2AMLogic/gf180-trng/sim/README.md

# `sim/` — evidence records

Everything in `sim/` exists to answer one question about any number this
project ever claims: **who produced it, under what conditions, and can I
reproduce it?**

A simulation result that is not recorded here in this format is not
evidence, and must not be cited in `spec/`, in an issue, or in a summary
document.

This is a **metadata and file-layout convention, not a tool contract**. It
does not assume any particular harness or runner. If the sim harness later
adopts a conflicting convention, reconcile the two with a decision record
(see [`spec/decision-records/TEMPLATE.md`](../spec/decision-records/TEMPLATE.md))
rather than silently editing records or this document's rules.

---

## Characterization reports

One line per `sim/characterization-*.md` report: what it answers and where it
stands. These are ordinary summaries that cite evidence records; none is
evidence itself. Start with the analog summary, which is organized by the rows
of the ratified target specification. `python3 sim/tools/corpus_counts.py
--check` (part of `npm run check:spec`) fails if a report on disk is missing
from this list or a listed file does not exist.

- [`characterization-analog-summary.md`](characterization-analog-summary.md) -- Every analog-partition row of the ratified target specification, one result per row with its claim limit. Status: aggregation for #313; an ordinary summary that runs no new simulation.
- [`characterization-array-fs-sf-capture.md`](characterization-array-fs-sf-capture.md) -- Asymmetric fs/sf corners on the integrated ring-array, XOR and sampler path at the 1 Mbps clock: ring duty, XOR pulses, reset, `raw_valid` and capture, distinct from the isolated-sampler setup/hold coverage. Status: campaign defined and unit-tested; batch submits refused or rejected (retried in -04, refused again), two-unit local pilot only (2 of 18 PVT points, one phase); no coverage-complete verdict (#472).
- [`characterization-array-ring-coupling.md`](characterization-array-ring-coupling.md) -- Why one ring shows ~40x more jitter inside the array deck: ring-to-ring coupling through the XOR combiner input stage. Status: complete (#51).
- [`characterization-array-supply-ripple.md`](characterization-array-supply-ripple.md) -- Susceptibility of the buffered RO array to deterministic supply ripple. Status: campaign defined and unit-tested; simulations not yet run, so no sensitivity numbers (#414).
- [`characterization-digital-supply-ir-drop.md`](characterization-digital-supply-ir-drop.md) -- DC voltage loss from the chip pins through the digital docking path and power grid, `vddd` and `vss`. Status: complete (#464); verdict: not material at the ratified 1 MHz rate, material at the 20 MHz implementation clock (informational).
- [`characterization-digital-sta-area-power.md`](characterization-digital-sta-area-power.md) -- Digital section Fmax, area and power across the corner set (Area and Power rows, digital share). Status: complete (#145), with later amendments in-document.
- [`characterization-digital-activity-power.md`](characterization-digital-activity-power.md) -- Digital power from post-route per-net switching activity, five declared workloads against the uniform-activity baseline (Power row, digital share). Status: complete (#453); characterization only, the rollup baseline is unchanged.
- [`characterization-liveness-sampler-active-power.md`](characterization-liveness-sampler-active-power.md) -- The shipped per-ring liveness samplers (`xsr1`/`xsr2`) in the whole-block active-power ledger: instance inventory, new rate- and topology-matched measurement, like-for-like effect on the total. Status: ledger and tooling complete and unit-tested; 1 of 27 PVT points measured (local probe), the batch submit failed on a runner/client version mismatch, remaining corners are explicit gaps (#463).
- [`characterization-liveness-tap-phase-cost.md`](characterization-liveness-tap-phase-cost.md) -- Phase cost the liveness digitizer imposes on its ring. Status: complete (#76).
- [`characterization-post-layout-extracted.md`](characterization-post-layout-extracted.md) -- Entropy-source verification suite re-run on extracted post-layout netlists, device-level through full-chip inter-region. Status: complete (#17, extended by #217 and #232).
- [`characterization-raw-min-entropy-and-battery.md`](characterization-raw-min-entropy-and-battery.md) -- Raw min-entropy estimation and statistical test battery (Raw min-entropy row). Status: analysis complete (#12); reports no design min-entropy figure.
- [`characterization-ring-buffer-mitigation.md`](characterization-ring-buffer-mitigation.md) -- Whether buffering each ring output removes the combiner coupling, and its power cost. Status: complete (#75).
- [`characterization-ro-delay-cell-jitter.md`](characterization-ro-delay-cell-jitter.md) -- Ring-oscillator delay-cell jitter, thermal and flicker noise (entropy-source architecture grounding). Status: complete (#4); carries amendments in-document.
- [`characterization-sampler-bit-bias.md`](characterization-sampler-bit-bias.md) -- Whether the clock-locked liveness modulation reaches the sampled bit. Status: complete (#86).
- [`characterization-shipped-array-tap-phase.md`](characterization-shipped-array-tap-phase.md) -- Clock-locked digitizer disturbance in the array as shipped. Status: complete (#87).
- [`characterization-startup-and-power-budget.md`](characterization-startup-and-power-budget.md) -- Time-to-first-valid and whole-block Power rows. Status: complete (#14); depth-2 figures supersede depth-8 ones in-document.
- [`characterization-starved-cell-jitter-energy.md`](characterization-starved-cell-jitter-energy.md) -- Jitter-energy law on the shipped starved delay cell. Status: complete (#46); hot-corner (ss/+125 C/3.63 V) addendum (#628).
- [`characterization-supply-current-and-leakage.md`](characterization-supply-current-and-leakage.md) -- Per-ring active supply current and stopped-ring leakage (Power row inputs). Status: complete (#32).
- [`characterization-vss-trunk-ir-drop.md`](characterization-vss-trunk-ir-drop.md) -- IR drop on the shared vss return trunk, per region. Status: complete (#234); verdict: not material.
- [`characterization-worst-corner-and-mc-mismatch.md`](characterization-worst-corner-and-mc-mismatch.md) -- Entropy-binding PVT corner over the full 27-point grid, and Monte Carlo mismatch bias. Status: complete (#13).

### Plans and feasibility assessments (not measured reports)

These are forward-looking documents. They run no simulation, are not evidence
records, and are not part of the report index above.

- [`../docs/out-of-envelope-characterization-plan.md`](../docs/out-of-envelope-characterization-plan.md) -- Model-bound audit and execution plan for health-test behaviour just outside the operating envelope. Status: plan (#467); no supported simulation grid and over the CPU budget as of its writing, so the envelope row's out-of-envelope clause remains unverified.
- [`../docs/higher-rate-source-options-study.md`](../docs/higher-rate-source-options-study.md) -- Design study: what a raw rate of 100 kbps, 1 Mbps or 4 Mbps would cost on gf180, as more XOR-combined starved-cell rings (DR-0007 sizing law at the starved-cell `a`) or as the metastability-hybrid tap, priced from existing records by `sim/tools/higher_rate_options.py`. Status: study (#629); runs no simulation, proposes no row change, makes no entropy claim.

---

## The two rules

1. **Append-only.** A record is written once. Re-running a testbench —
   for any reason, including fixing a mistake — produces a **new** record.
   Records are never edited to change results and never deleted.
2. **No seed, no evidence.** Any stochastic analysis (ngspice transient
   noise, Monte Carlo) must record every seed it used. A transient-noise
   record without its seed(s) is unreproducible and therefore is not
   evidence, regardless of how good the numbers look.

`run_corners.py` checks the whole execution plan before it reserves a
record, creates a scratch directory or launches ngspice, and refuses
(exit 3, naming the repeated value) a plan that repeats a seed, repeats a
PVT point (e.g. `--temps 27 27`), or contains two distinct points whose
output id `<corner>_<temp>c_<supply>v` collides (supply is formatted to
10 mV, so e.g. 3.301 V and 3.304 V alias). A repeated seed would count one
realization twice in a record's mean and spread; a repeated id would put
two points' decks and logs in the same place. Run a repeated diagnostic as
a separate invocation instead.

For a stochastic testbench the harness alone sets the seed. It writes one
`.option seed=<n>` per run from `--seeds`. Before planning, the harness
refuses any input that sets its own seed: a seed entry in the manifest
`options`, an option line containing `seed=` in the fragment, the DUT or a
captured include, or `setseed`, `option seed=`, `set rndseed` or
`unset rndseed` in `analyses`. The error names the source and line. The forms
covered and the reasons are in
[`tool-experiments/2026-10-11-ngspice-seed-control/`](tool-experiments/2026-10-11-ngspice-seed-control/README.md).
In ngspice-46 a later competing option line is ignored, and a control-block
`setseed` overrides the seed. That experiment also found that `trnoise`
waveforms do not repeat under the same seed (#574).

### What a transient-noise seed reproduces (#574, DR-0031)

On the ngspice-46 build measured in
[`tool-experiments/2026-10-11-ngspice-trnoise-seed-replay/`](tool-experiments/2026-10-11-ngspice-trnoise-seed-replay/README.md),
the seed does **not** reproduce `trnoise` waveforms. Two processes with the
same seed shared none of 16 noise samples under the harness start-up policy.
The same held with `setseed` or `set rndseed` in an explicitly supplied
`spinit`, with `setseed` in a user `.spiceinit` (the manual's suggestion)
and with a control-block `setseed`. The noise followed the simulator's
process id instead. The same seed did reproduce the `agauss` parameter and
control-language draws. Other ngspice builds have not been measured.
[DR-0031](../spec/decision-records/DR-0031-transient-noise-reproducibility.md)
sets the contract that follows:

- **Seeds are still required** and still owned by the harness; rule 2 and
  the checks above are unchanged. For a transient-noise run the seeds fix
  the non-`trnoise` random draws and identify the runs.
- **Replay means deck and configuration, not waveform.** Re-running a
  `tran-noise` record's commands at its `repo_commit` with its snapshots
  rebuilds the same decks, PVT point and start-up configuration, but draws
  fresh `trnoise` noise. Its numbers are a new sample and will differ from
  the record's. New `tran-noise` records carry a `reproduction` block and
  say this in "How to reproduce". Deterministic and `mc` records do not:
  no limit was measured for them.
- **Distinct seeds do not make the noise distinct.** Runs get different
  noise because each is a separate ngspice process. Neither the seeds nor
  the experiment establish that runs are statistically independent.
- **Statistical repeatability is a separate claim.** Saying a re-run agrees
  with a record within its spread needs its own tolerance and evidence. It
  is not demonstrated here.

Records written before DR-0031 have no `reproduction` block and are not
edited. Read their "How to reproduce" sections under this contract.

Everything below is mechanics in service of those two rules.

---

## Layout

```
sim/
  README.md                     this document
  tb/                           testbench sources (mutable, reviewed like code)
    <testbench-slug>/           one directory per testbench
  records/                      APPEND-ONLY evidence records
    <YYYY-MM-DD>-<testbench-slug>-<nn>.md
    raw/
      <YYYY-MM-DD>-<testbench-slug>-<nn>/   raw output for records written
                                            before stored evidence (see below)
  tool-experiments/             APPEND-ONLY simulator-behaviour probes
    <YYYY-MM-DD>-<topic>/       decks, logs, SHA256SUMS and a README
```

- `sim/tb/` is ordinary source. Edit it, review it, refactor it.
- `sim/records/` is the evidence area and is append-only. Changes to
  anything already committed under `sim/records/` are a review-blocking
  defect, with one exception: adding a `superseded_by` field to an existing
  record (see [Superseding](#superseding-a-record)).
- `sim/tool-experiments/` holds small, PDK-free experiments on the
  simulator itself (for example how ngspice applies seed controls). The
  harness code relies on these results. They are not testbench records and
  have no PVT grid. Like records, they are append-only.

### Record naming

```
<YYYY-MM-DD>-<testbench-slug>-<nn>.md
```

- `<YYYY-MM-DD>` — UTC date the run **completed**.
- `<testbench-slug>` — matches the directory name under `sim/tb/`.
- `<nn>` — two-digit sequence, `01`-based, unique within that date +
  testbench pair. Never reuse a number, even if a record is superseded.

Example: `2026-08-14-ro-delay-cell-jitter-03.md`, with its raw ngspice
output under `sim/records/raw/2026-08-14-ro-delay-cell-jitter-03/`.

`sim/run_corners.py` claims each `<nn>` by *creating* that raw directory
(an atomic `mkdir`, so exactly one process can win it) before the first
simulation starts, and re-hashes every `raw.files` entry before it reports
success. Two invocations for the same date and testbench — two terminals,
a retried CI step, an agent that re-launches a long background run — are
therefore safe to overlap: they get disjoint numbers, and a run whose raw
output changed underneath it fails loudly instead of writing a record whose
checksums match nothing.

One record covers **one testbench at one corner** (one process/voltage/
temperature point). A PVT sweep produces one record per corner, not one
record with a table of corners. This keeps a corner citable by record ID
and keeps a re-run of a single corner from invalidating the rest.

---

## Record format

A record is a Markdown file with a YAML frontmatter block (machine-readable
metadata) followed by prose (the summary and any caveats). No tooling reads
the frontmatter today; it is structured so tooling *can* later without
re-parsing prose.

The shared parser (`sim/tools/_record_parsing.py`) reads two things from the
frontmatter and holds them to a strict contract: the lifecycle `status` and
the `corner:` fields `process`, `temperature` and `voltage`. The block must
open on the file's first line and be closed by a second `---` line; each of
those four keys must appear exactly once inside it, so a body line such as
`process: ff` can never supply or override metadata. `temperature` and
`voltage` are read as a complete scalar -- a finite decimal number, an
optional `C`/`V` unit and an optional parenthetical remark (for example
`3.300 V (nominal 3.3 V)`); a trailing suffix such as `125junk`, a
non-finite value or `n/a` is rejected. Failures raise the calling tool's
`RecordError` naming the record and the field. Result bullets
(`- `key`: value`) are a separate contract and are unchanged.

### Required frontmatter fields

| Field | Meaning |
|---|---|
| `record` | The record's own filename stem. Self-identifying. |
| `date` | UTC date/time the run completed, ISO 8601 (`2026-08-14T09:12:00Z`). |
| `status` | `valid`, or `superseded` (see [Superseding](#superseding-a-record)). |
| `level` | `transistor`, `behavioral`, `gate` or `gate-simulation` — what produced this. The first two are the two sides of the [DR-0009](../spec/decision-records/DR-0009-behavioral-vs-transistor-verification-split.md) boundary; `gate` is *static* analysis of a synthesized/placed netlist against the PDK's characterised libraries ([DR-0021](../spec/decision-records/DR-0021-gate-level-timing-and-power-records.md)) and `gate-simulation` is *dynamic* simulation of one with back-annotated delays ([DR-0022](../spec/decision-records/DR-0022-post-route-gate-level-simulation-records.md)), neither of which is either of the first two. Absent means `transistor` (records predating DR-0009); new records state it. |
| `testbench.path` | Repo-relative path to the testbench entry point. |
| `testbench.sha` | `git rev-parse HEAD:<path>` — blob SHA of the testbench at run time. |
| `netlist.path` | Repo-relative path to the DUT netlist/schematic-derived netlist. |
| `netlist.sha` | Blob SHA of the netlist at run time. |
| `repo_commit` | `git rev-parse HEAD` at run time; `-dirty` suffix if the tree was dirty. |
| `pdk` | PDK name and version/tag (e.g. `gf180mcuC @ <version>`). |
| `pdk.models` | The corner model file(s) actually included. |
| `tool.ngspice` | Full `ngspice -v` version string. |
| `tool.ngspice_startup` / `tool.ngspice_startup_flags` / `tool.ngspice_startup_spinit` / `tool.ngspice_startup_spinit_sha256` | *Additive; records from `run_corners.py` after #575.* The ngspice start-up-configuration policy in force (`no-user-init+pinned-spinit/1`), its command-line flag (`-n`), and the repo path and SHA-256 of the pinned `spinit` used as the system script. See [ngspice start-up configuration](#ngspice-start-up-configuration-575). Records without these lines predate the field and stay valid unchanged. |
| `tool.ngspice_startup_spinit_snapshot` | *Additive; records from `run_corners.py` after #582.* Name (`spinit`) of the byte-for-byte copy of the start-up script that ngspice actually read, kept in the record's raw directory and listed in `raw.files`. When present, `tool.ngspice_startup_spinit_sha256` is the digest of that copy and `sim/tools/verify_record_checksums.py` cross-checks the two. Records without it (including #575-format records, whose digest was read from the checkout) stay valid unchanged. |
| `tool.platform` | OS/arch the run executed on. |
| `corner.process` | `tt` / `ss` / `ff` / `sf` / `fs` (as named by the PDK). |
| `corner.voltage` | Supply(s) in volts, with the nominal noted. |
| `corner.temperature` | Degrees C. |
| `analysis.type` | `op` (default when a manifest omits `analysis_type`), `tran`, `tran-noise`, `noise`, `ac`, `dc`, `mc`. Any other value is rejected when the testbench manifest is loaded; `tran-noise` and `mc` are stochastic and require a seed. |
| `analysis.tstop` | Run length (simulated time), or the sweep range for `ac`/`dc`/`noise`. |
| `analysis.tstep` / `analysis.tmax` | Timestep controls that materially affect the result. |
| `analysis.noise_params` | For `tran-noise`: `NOISETSTEP` / `NOISEFMAX` / equivalent, verbatim. |
| `analysis.runs` | Number of independent runs aggregated into this record. |
| `seeds` | **Every** seed used, in run order. Required whenever the analysis is stochastic; write `seeds: n/a (deterministic analysis)` otherwise. |
| `reproduction.scope` / `reproduction.trnoise_waveform_replay` / `reproduction.basis` / `reproduction.decision` | *Additive; `tran-noise` records from `run_corners.py` after #574.* What the "How to reproduce" commands replay: `deck-and-configuration`, with `trnoise_waveform_replay: false`, the tool experiment that measured it and the decision record that adopts it. See [What a transient-noise seed reproduces](#what-a-transient-noise-seed-reproduces-574-dr-0031). Records of other analysis types, and records written before #574, have no such block and stay valid unchanged. |
| `raw.path` | Repo-relative path to the raw-output directory for this record. |
| `raw.files` | Raw output filenames with SHA-256 checksums. |
| `manifest.path` / `manifest.sha` / `manifest.snapshot` / `manifest.sha256` | *Additive; records from `run_corners.py` after #510.* The testbench manifest (`tb.json`) the decks were composed from: its repo path, git blob SHA, the snapshot file kept in the raw directory (`tb.manifest.json`), and that snapshot's SHA-256. The snapshot is also listed in `raw.files`. Records without this block predate the field and stay valid unchanged. |
| `inputs.testbench_snapshot` / `inputs.testbench_sha256` / `inputs.netlist_snapshot` / `inputs.netlist_sha256` / `inputs.netlist_dependencies` | *Additive; records from `run_corners.py` after #515.* The SPICE fragment and DUT netlist bytes ngspice actually consumed, as snapshot files in the raw directory (`tb.fragment.spice`, `dut.netlist.spice`; when there is no separate `design_netlist` both names refer to the fragment) with their SHA-256, plus any sibling files the DUT netlist `.include`s. All are listed in `raw.files`. Records without this block predate the field and stay valid unchanged. |
| `pdk_content.manifest_file` / `pdk_content.sha256` / `pdk_content.identity` / `pdk_content.file_count` / `pdk_content.complete` / `pdk_content.problems` | *Additive; records from `run_corners.py` after #562.* Content identity of the PDK model files the decks consumed: the manifest file kept in the raw directory (`pdk-models.json`, also listed in `raw.files`) and its SHA-256, the manifest's own `sha256:<hex>` identity, how many model files it covers, and whether every model reference could be followed (`problems` counts the ones that could not; the manifest lists them). See [PDK model-content identity](#pdk-model-content-identity-562). Records without this block predate the field and stay valid unchanged. |
| `wall_time` | Wall-clock cost of the run. Makes future coverage/cost trade-offs honest. |

If a required field genuinely does not apply, write the field with an
explicit `n/a` and a reason. Do not omit it — a missing field is
indistinguishable from a forgotten one.

### Required prose sections

- **Result** — the numbers, with units and the run-to-run spread when
  `analysis.runs > 1`. Numbers only; no entropy-rate or spec-compliance
  claims.
- **How to reproduce** — the exact command(s), runnable from the repo root,
  including the seed(s). Someone with the repo and ngspice must be able to
  copy-paste this. For a `tran-noise` record the commands replay the deck
  and configuration, not the `trnoise` waveforms, and the section says so
  (see [What a transient-noise seed reproduces](#what-a-transient-noise-seed-reproduces-574-dr-0031)).
- **Caveats** — what this run does *not* show (method limits, truncated
  accumulation time, known weak spots such as flicker-noise handling in
  transient noise). Stating a limit is not a weakness in the record; an
  unstated limit is a defect.

---

## Behavioral-level records

Blocks downstream of the [DR-0001] raw tap — the conditioner, the health
tests, the FIFO/register file, the estimator pipeline — contain no device
models, so a record of one has no process/voltage/temperature point and
never invokes ngspice. [DR-0009] fixes where that boundary sits and what
such a record may be used for. In this format that means:

- `level: behavioral`.
- `pdk`, `pdk.models`, `tool.ngspice`, `corner.process`, `corner.voltage`
  and `corner.temperature` are written as `n/a` **with the reason** — the
  same rule as any other inapplicable field. They are not omitted.
- The record **names its input source**: either *transistor-derived* (a raw
  bitstream captured from a transistor-level sampler run, cited by record
  stem) or *declared synthetic* (a source model, with its parameters and
  seed stated). A run driven by a synthetic source is evidence about the
  **block**, never about the source.
- **A behavioral record may not be cited for any claim that depends on
  process, voltage or temperature** — rate, power, jitter, metastability,
  timing closure, min-entropy. It can establish functional behaviour,
  bit-exactness, block structure and arithmetic, and nothing that moves
  with a corner.

Behavioral testbenches live under `sim/tb/<slug>/` like any other but have
**no `tb.json`**, so `sim/run_corners.py` cannot discover them and cannot
sweep them across a PVT grid they have no meaning on. Each carries a
`README.md` saying how it is run. See `sim/tb/conditioner-crc32/` for the
first one.

This is the one bounded exception to CLAUDE.md's "PVT corners on every
recorded result". The rule is unchanged for every claim that *has* a corner.

---

## Gate-level records

[DR-0021] adds a third `level:` value for a kind of evidence neither of the
other two describes: **static analysis of a synthesized or placed-and-routed
gate-level netlist against the PDK's own characterised standard-cell
libraries** — static timing analysis, liberty-table power, and geometry read
from a placed/routed database. No device model is instantiated and ngspice is
never invoked, but a liberty deck *is* a process/voltage/temperature point, so
unlike a behavioral record a gate record **has a corner and states it**. In
this format:

- `level: gate`.
- `corner.process`, `corner.voltage` and `corner.temperature` are filled in
  from the liberty deck's own operating conditions — never `n/a` — alongside
  two fields only this level has: `corner.liberty` (the deck, since P/V/T
  alone does not say which library or which characterisation) and
  `corner.interconnect` (the parasitic corner, which moves independently of
  the device corner for a routed block).
- `pdk.models` lists the liberty deck, both LEFs and the extraction rule deck,
  each content-hashed — the gate-level equivalent of a transistor record
  naming its model sections.
- `tool.ngspice` is `n/a` **with the reason**, and the tool that did produce
  the numbers is named with its version.
- A gate record may be cited for timing closure, Fmax, standard-cell area and
  liberty-model power at the corner it names — as a property of *that*
  implementation. It may **not** be cited as a measured supply current, for
  anything the library itself is the source of truth for, for any raw-tap
  claim (entropy, jitter, metastability), or as signoff. [DR-0021] §3 is the
  full rule; each record restates it in its own Caveats.

[DR-0005]'s one-record-per-corner rule is unchanged: a 5-liberty × 3-interconnect
sweep is fifteen records. Like behavioral testbenches, a gate-level testbench
carries **no `tb.json`** — `sim/run_corners.py` must not sweep it across the
analog P/V/T grid, because a liberty deck is a characterised bundle rather
than a free choice of the three axes. See `sim/tb/digital-sta-power/` for the
first one.

[DR-0001]: ../spec/decision-records/DR-0001-raw-and-conditioned-output-paths.md
[DR-0005]: ../spec/decision-records/DR-0005-sim-harness-record-granularity.md
[DR-0009]: ../spec/decision-records/DR-0009-behavioral-vs-transistor-verification-split.md
[DR-0021]: ../spec/decision-records/DR-0021-gate-level-timing-and-power-records.md

---

## Post-route gate-level *simulation* records

`level: gate-simulation` is the fourth `level:` value, added by [DR-0022] for
#147's post-layout re-run of the digital functional suite
(`sim/tb/trng-top-post-route/`). It is a **sibling of `level: gate`, not a
replacement**: both read a gate-level netlist against the PDK's characterised
libraries and neither instantiates a device model, so everything [DR-0021]
fixes about a gate record's frontmatter holds here too —

- `corner.process` / `corner.voltage` / `corner.temperature` from the liberty
  deck's own operating conditions, never `n/a`, plus `corner.liberty` naming
  the deck;
- `pdk.models` listing the decks and cell-model files actually read, and
  `tool.ngspice` written `n/a` **with the reason**, alongside the tools that
  did produce the numbers, each with its version;
- no `tb.json`, for the same reason: `sim/run_corners.py` must not sweep it
  across the analog P/V/T grid.

— and one thing differs, which is why the value is distinct rather than shared:

| | `level: gate` (DR-0021) | `level: gate-simulation` (DR-0022) |
|---|---|---|
| What runs | **static** analysis: STA, liberty-table power, placed geometry | **dynamic** simulation: stimulus in, cycle-by-cycle outputs out, delays back-annotated |
| May be cited for | timing closure, Fmax, cell area, liberty-model power at its corner | functional equivalence of the netlist to its RTL/model on the stimulus run |
| May **not** be cited for | measured supply current, raw-tap claims, signoff | **timing closure of any kind** — which annotation classes actually applied is simulator-dependent, so a run that reported no violation may not have been checking |

That last cell is the whole reason for a separate value. A reader filtering
`level: gate` is entitled to timing numbers; a dynamic simulation may have had
its timing checks silently dropped by the simulator and must not be mistaken
for one. So a `gate-simulation` record additionally **requires** a
`timing_annotation` block stating what the annotation models **and what it
omits** — cell versus interconnect delay, which annotation classes the
simulator applied, how many corners — with both the netlist and the annotation
file content-hashed. An omission stated is a coverage limit; an omission
unstated is a defect, the same rule `Caveats` already carries.

Adding this level **re-labels nothing**. The five `level: behavioral` records
the digital re-run compares against keep their level and their citation limits
exactly as before, and [DR-0021]'s `level: gate` records are untouched.

[DR-0022]: ../spec/decision-records/DR-0022-post-route-gate-level-simulation-records.md

---

## Extracted-netlist records

`level: extracted` is the fifth `level:` value, added by [DR-0024] for #17's
post-layout re-run of the analog verification suite
(`sim/tb/*-extracted/`). It is a **sibling of `level: transistor`, not a
replacement**: both are ordinary ngspice transient/noise/DC runs at a real
P/V/T point, driven through the same `tb.json`/`sim/run_corners.py`
machinery, so everything [DR-0009] fixes about a transistor record's
frontmatter holds here too — `pdk`, `pdk.models`, `tool.ngspice`,
`corner.process`/`voltage`/`temperature` filled in (never `n/a`), one P/V/T
point per record ([DR-0005]), seeds recorded for every stochastic run.

The one thing that differs, and the reason the value is distinct rather than
shared:

| | `level: transistor` (DR-0009) | `level: extracted` (DR-0024) |
|---|---|---|
| DUT provenance | `design/*.spice`, schematic-derived (`design/netlist.py`) | `layout/pex/*.extracted.spice` or equivalent — read from real drawn layout via `klt extract --parasitics` |
| May be cited for | rate, power, jitter, metastability, min-entropy-adjacent measurements, at its corner | the same, at its corner, **for the netlist and coverage its own Caveats state** |
| Requires | the standard frontmatter | the standard frontmatter, plus a Caveats statement of what the extraction does and does not capture (inter-cell/inter-region routing parasitics, in particular) |

A `level: extracted` record may not be cited as evidence about the fully
assembled, routed layout unless its Caveats affirmatively say routing
parasitics are included — the first generation of these records (#17) is
device-level only (leaf-cell parasitics, schematic-topology composition), not
a full-chip parasitic re-run, and says so in every record. See
`layout/pex/build.py`'s module docstring and
[`sim/characterization-post-layout-extracted.md`](characterization-post-layout-extracted.md)
for the full accounting of what this generation of records does and does not
show.

A second generation (issue #217, `sim/tb/*-extracted-routed/`) adds
*intra*-region routing parasitics — the assembled rings' own real
hand-routed inter-stage wiring, and (for `sampler_core.routed.
extracted.spice`'s own consumers) the fully assembled `combiner_sampler`
block's own real block-level wiring too — on top of the leaf-cell parasitics
the first generation already captured. It is still `level: extracted`, not a
new value: the DUT-provenance/citation rules above apply unchanged, and each
record's own Caveats state exactly which parts of its own DUT are
routing-level versus still leaf-level (`layout/pex/build.py`'s own
docstring, "Two composed drop-ins, different scope") — *inter*-region
routing is not captured by either generation (§0.1 of the characterization
doc above).

A third generation (issue #232, `sim/tb/*-extracted-fullchip/`) carries
*inter*-region (floorplan-level) parasitics, within the scope [DR-0025]
(issue #225) fixed for it: only the inter-region nets with a
transistor-level device at **both** ends are simulated (today `ro1`/`ro2`),
the four `digital`-facing taps are priced as a **driver-side-only** output
load, and the digital section stays at cell-instance granularity. Two things
follow for anyone reading or writing one of those records. **It is still
`level: extracted`** — no sixth value, and [DR-0024] is not amended, because
DR-0024's own Caveats requirement ("whether inter-cell/inter-region routing
parasitics are included") already covers the case; such a record answers it
"yes, for these nets" instead of "no". And its Caveats must additionally say
**(a)** that the digital section is at cell-instance granularity, not
transistor level, so no number in the record is evidence about a standard
cell's own devices, and **(b)** that `clk`/`rst_n` arrival is still driven
from an ideal source, so the record says nothing about clock arrival at the
sampler. Both are present on every record of this generation.

**The citation bar this generation clears, and the one it does not.** A
`*-extracted-fullchip` record may be cited as full-chip post-layout evidence
**only for the two inter-region nets [DR-0025] scopes**, plus the disclosed
driver-side load on the four `digital`-facing taps. Every other inter-region
net (`clk`, `rst_n`, `vss`, the supply and control stubs) is unpriced by it,
and no record in this repository may be cited as evidence about the chip's
*whole* inter-region parasitic picture. §8 of
[`sim/characterization-post-layout-extracted.md`](characterization-post-layout-extracted.md)
is the full accounting.

Each family of this generation also has a **zero-delta control** sibling
(`sim/tb/*-extracted-fullchip-control/`): the identical deck against
`layout/pex/sampler_core.routed.extracted.spice`, i.e. the same composition
with the inter-region delta absent. Its records exist so the
routed-vs-floorplan comparison subtracts two measurements of the same
composition instead of two different ones — a control record is ordinary
`level: extracted` evidence and says in its own Caveats that it carries no
inter-region parasitic at all.

[DR-0024]: ../spec/decision-records/DR-0024-extracted-netlist-record-level.md
[DR-0025]: ../spec/decision-records/DR-0025-full-chip-pex-scope.md

---

## Superseding a record

Mistaken, misconfigured, or invalidated runs are **not** deleted or edited.

1. Write a **new** record for the corrected run, with a
   `supersedes: <old-record-stem>` field and a one-line reason in its prose.
2. In the old record, make the **only** permitted post-hoc edit: change
   `status: valid` to `status: superseded` and add
   `superseded_by: <new-record-stem>`. Change nothing else — not the
   numbers, not the metadata, not the prose.
3. If a run was invalid and there is no corrected re-run yet, still write a
   short record documenting the run and why it is not usable, and set the
   old record's `status: superseded` only once a replacement exists. An
   invalid result that is never recorded is a result that gets re-derived by
   the next person.

The commit that supersedes a record should say so in its message, so
`git log -- sim/records/<stem>.md` tells the whole story.

---

## Scratch directories (`--no-write`)

`--no-write` runs produce no evidence record, but ngspice still needs
somewhere to put its deck and log. Each invocation creates its own
directory `sim/.work/<testbench>/run-XXXXXXXX/` (atomically, via
`tempfile.mkdtemp`) and puts one subdirectory per PVT point inside it, so
overlapping invocations of the same testbench, point and seed never share
or delete each other's files. The path is printed at the start of the run
and again in the summary.

Cleanup policy: the harness never deletes scratch output. The directory is
kept so the deck and log of a failing point can be inspected; it is
git-ignored and is not evidence. Remove a run's directory yourself when you
are done with it (`rm -rf sim/.work/<testbench>/run-XXXXXXXX`).

## ngspice start-up configuration (#575)

ngspice runs initialization scripts before the netlist, and they can change
simulator behaviour. Evidence-producing harness runs therefore launch
ngspice through one command/environment builder
(`runner.ngspice_command` and `harness/startup.py`), shared by the
watchdog and the no-`timeout(1)` fallback paths, with an explicit policy
measured in
[`tool-experiments/2026-10-11-ngspice-startup-config/`](tool-experiments/2026-10-11-ngspice-startup-config/README.md)
(ngspice-42) and
[`tool-experiments/2026-10-11-ngspice46-startup-lookup/`](tool-experiments/2026-10-11-ngspice46-startup-lookup/README.md)
(ngspice-46, the minimum this README requires; see each README for what was
and was not measured):

| Start-up input (batch mode) | Control |
|---|---|
| Deck-directory `.spiceinit` — searched first on ngspice-46; on ngspice-42 this slot was the working-directory file, and the deck's directory was not searched | `-n` |
| Working-directory `.spiceinit` — ngspice-46 falls back to it only when the deck's directory has none; `$HOME/.spiceinit` is the last fallback on both measured builds | `-n` |
| System `spinit` | `-n` does **not** suppress it; `SPICE_SCRIPTS` is set to `sim/harness/ngspice_scripts/`, whose `spinit` is checked in and content-pinned |
| `SPICE_LIB_DIR` | removed from the child environment (and overridden by `SPICE_SCRIPTS`) |

Only one of the three `.spiceinit` locations is read per launch (first match
wins) on both measured builds, and the suppression behaviour (`-n` scope,
`SPICE_SCRIPTS`, `SPICE_LIB_DIR`) is the same on both; the lookup-order
difference is the only measured change between the builds, and neither
measurement is generalized to other versions.

The pinned `spinit` contains no commands: no aliases and no code-model or
OSDI loading, so a testbench that needs an XSPICE code model or an OSDI
device would fail loudly rather than inherit whatever the host loads. Its
SHA-256 is recorded in every new evidence record (`tool.ngspice_startup_*`),
so changing it is visible. Timeout, process-group and `cwd` handling are
unchanged.

**Frozen once per invocation (#582).** The checked-in script is only the
source. `run_corners.py` reads it once, before the first simulator starts,
writes those bytes as `spinit` into every point's raw directory (scratch
directory under `--no-write`) and points `SPICE_SCRIPTS` at that directory.
All points and seeds, serial or `-j`, with or without the `timeout(1)`
watchdog, therefore read the same captured bytes, and the recorded digest is
computed from them rather than from the working tree at publication time. An
edit to `sim/harness/ngspice_scripts/spinit` while a sweep runs does not
affect that sweep. The copy appears in `raw.files`, so
`sim/tools/verify_record_checksums.py` detects a missing or altered snapshot and a
`ngspice_startup_spinit_sha256` that disagrees with it.

To reproduce a run, including one made from a dirty tree, in a scratch
worktree: check out the record's `repo_commit`, then copy the record's
`<raw.path>spinit` over `sim/harness/ngspice_scripts/spinit` before running
(a plain `diff` shows whether the checkout differed), or run ngspice with
`SPICE_SCRIPTS` set to a directory containing that file and `-n -b`.

Remaining ambient inputs, not controlled: other environment variables the
simulator reads, the ngspice build itself (recorded as `tool.ngspice`), and
behaviour on builds other than the one measured. `sim/tools/` scripts that
launch ngspice on their own (for example `run_array_liveness_tap_phase.py`)
do not go through this launcher and are outside this policy. Records minted
before #575 did not state a policy; they are unchanged and make no claim
either way.

## Hung and timed-out runs

Every corner `run_corners.py` simulates is bounded by `--timeout` (default
`runner.DEFAULT_TIMEOUT_S`, currently 300s). The bound is enforced two ways
at once, precisely because a hung ngspice once outlived the harness process
that launched it and burned a worker offline for hours undetected (issue
#83):

- An OS-level watchdog — coreutils `timeout(1)` (`gtimeout` on macOS via
  Homebrew's `coreutils`; `--check-env` reports which, if either, is on
  `PATH`) — wraps the ngspice invocation directly. It runs as ngspice's
  parent, independent of `run_corners.py` staying alive, so it still fires
  and kills the whole process group even if the harness itself is killed
  mid-run.
- An in-process `Popen.communicate(timeout=...)` guard is a secondary
  backstop for the common case (harness alive for the whole run), and the
  sole enforcement when no watchdog binary is available on `PATH` (a
  degraded mode `--check-env` warns about, since it cannot survive the
  harness process itself dying).

A killed corner reports `FAILED-TIMEOUT` in the printed summary (not a
plain `FAIL`, and never silently missing), and — same as any other
completed point — still gets a normal written record under
`sim/records/`, whose "Run failures" line and raw log name the deck and
the elapsed/bound time, so a reviewing Judge sees the hang instead of an
absent result. A record built this way is evidence that the run hung, not
evidence about the device; `sim/README.md`'s "no claim beyond what this
run measured" rule applies as usual.

### Failed runs in the "Result" section

Records minted after issue #506 summarize only status-`ok` runs in the
per-measurement lines. A failed run (nonzero exit, simulator or analysis
error, fatal diagnostic, missing measurements, or timeout) still retains any
measurements it parsed, but they appear only under a separate "Failed-run
diagnostics" heading with the failure reason, never in a mean or spread.
Since issue #527 a requested measurement must also be a finite number: a
value that overflows to infinity (e.g. `1e999`) or a literal `inf`/`nan`
fails the run with `non-finite measurements: <name> (<name> = <raw>)`,
reported separately from absent ones. The non-finite value is never kept as
a diagnostic number; the raw log retains it exactly as ngspice printed it. A
`Runs: N of M successful` line reports attempted vs. successful counts; a
measurement with no successful run reads `no successful-run data (N of M
runs succeeded)` (this replaces the older "no data (all runs failed to
converge)" wording, which was too narrow). The `- `name`: ...` and
`mean X over N seeds` line formats are unchanged, so readers that parse them
keep working; the only new lines are the `Runs:` line and the failure and
diagnostic blocks. Existing records are append-only and keep their original
wording and semantics.

---

## Pre-commit checklist

Mechanical; run through it before committing any record.

- [ ] Filename matches `<YYYY-MM-DD>-<testbench-slug>-<nn>.md` and `<nn>` is unused.
- [ ] Every required frontmatter field is present (`n/a` + reason where inapplicable).
- [ ] Seeds recorded for every stochastic run, in run order.
- [ ] `testbench.sha`, `netlist.sha`, and `repo_commit` captured from the tree that actually ran.
- [ ] `tool.ngspice` is the verbatim version string, not "latest".
- [ ] Corner is a single P/V/T point, and it is stated explicitly — or the
      record is `level: behavioral` and every device-model field carries
      `n/a` plus a reason, and the input source is named. A `level: gate`
      record states its corner like a transistor one, and additionally names
      its liberty deck and its interconnect corner (DR-0021); a
      `level: gate-simulation` record does the same and adds a
      `timing_annotation` block naming what the annotation models and omits
      (DR-0022).
- [ ] Raw output committed under `sim/records/raw/<stem>/` with checksums listed
      (legacy records), **or** stored in the artifact store with its manifest committed
      under `manifests/artifacts/` and a `stored_evidence` table in the record (records
      from `run_corners.py` after #686) —
      `python3 sim/tools/verify_record_checksums.py --changed` and
      `npm run check:artifact-manifests` exit 0 (see below).
- [ ] "How to reproduce" is copy-pasteable from the repo root.
- [ ] No claim in the record goes beyond what this run measured.
- [ ] No existing record was modified, except a permitted `status`/`superseded_by` edit —
      `python3 sim/tools/verify_evidence_history.py --base origin/main` exits 0 (see below).

### Checking the raw-output checksums

The checksum item is the one item on this list a human cannot do by eye, so it
is a command:

```sh
python3 sim/tools/verify_record_checksums.py --changed   # records this branch adds
python3 sim/tools/verify_record_checksums.py             # every record in the repo
python3 sim/tools/verify_record_checksums.py <record.md>...
```

It re-hashes every file listed in `raw.files` and fails on a digest that no
longer matches, a listed file that is missing, a file sitting in the raw
directory that the record never listed, or raw output that was never `git
add`ed (`--no-git` drops that last check). Exit 0 means the item is satisfied.
If git itself cannot answer (not run from a checkout, git not installed), it
exits 2 naming git as the cause rather than reporting every file uncommitted.
CI runs it over every record on every pull request, and `sim/selftest.sh`
runs it as stage 2.

Only the default invocation (no record arguments, no `--changed`, no
`--no-git`) validates the whole evidence inventory. It also runs the reverse
check: every file `git` tracks (or has staged) under `sim/records/raw/` must be
named in some record's validated `raw.files`, otherwise the run fails and lists
the orphan paths, including when no records exist at all. This catches an
abandoned run staged without a record. Untracked local directories are ignored,
so unfinished work does not break the check. The fix is to add the record that
cites the output or unstage it (`git rm --cached`); the tool never deletes or
invents evidence. Record-scoped runs (named records, `--changed`) and `--no-git`
check only what they select and make no claim about the rest of the inventory.

### Manifest snapshot and reproducing a historical run

`testbench.sha` pins the SPICE fragment only. The manifest (`tb.json`) also
defines measurement expressions, options, params, analyses and caveats, so
`run_corners.py` copies the exact bytes it loaded (read once, before decks are
composed; loading fails if the file changes during the load) to
`raw/<stem>/tb.manifest.json` and records its digest in the `manifest:` block
and in `raw.files`. `verify_record_checksums.py` flags a changed snapshot, and
a `manifest.sha256` that disagrees with the `raw.files` entry.

The "How to reproduce" commands read the *current* `tb.json`, not the
snapshot. To reproduce a historical run, check out its `repo_commit`, and if
the tree was `-dirty` or `tb.json` has since changed, compare
`diff sim/records/raw/<stem>/tb.manifest.json sim/tb/<slug>/tb.json` and put
the snapshot's content in place (in a scratch worktree, never in committed
evidence) before running. Legacy records have no snapshot: use `repo_commit`
alone, and treat a `-dirty` one as not exactly reproducible.

### SPICE input snapshots (#515)

`run_corners.py` reads the testbench fragment, the DUT netlist
(`design_netlist`) and any sibling files that netlist `.include`s exactly once,
when the manifest is loaded. Each corner's directory (`raw/<stem>/`, or the
scratch directory for `--no-write`) receives byte-for-byte copies, and the
composed deck `.include`s *those copies* rather than the working-tree files.
Editing the originals while a sweep is running therefore cannot change what
later corners simulate, and `testbench.sha`/`netlist.sha` are the git blob
hashes of the captured bytes (identical to `git rev-parse HEAD:<path>` when the
tree was clean, and still correct for dirty-tree bring-up). The copies are
listed in `raw.files` and covered by `verify_record_checksums.py`; an `inputs:`
digest that disagrees with its `raw.files` entry is also flagged. A snapshot
found modified while the record is being built aborts the record rather than
hashing bytes ngspice did not read.

Include policy:

- The testbench fragment may not contain `.include`/`.inc`/`.lib` (unchanged;
  `.inc` is now rejected too).
- The DUT netlist may `.include`/`.inc` only a **bare file name** next to the
  including file (as the extracted-parasitics netlists do). Those files are
  captured transitively and copied beside the DUT snapshot under the same
  name, so ngspice resolves them exactly as before but from frozen copies.
  Absolute paths, sub-directories, `..`, missing files and include cycles fail
  before any simulation, naming the file and line. `.lib` and the other
  harness-owned directives stay forbidden.
- An included file may not share a name with a file the harness writes into
  the same raw directory: `tb.manifest.json`, `pdk-models.json`,
  `pdk-models.after-run.json`, the fragment/DUT snapshots, or any planned
  `<corner_id>.spice`/`.log` (`<corner_id>-run<N>.spice`/`.log` for seeded
  runs). Such a plan is refused before any record or scratch directory is
  allocated; the diagnostic names the include and suggests a rename.
- External PDK models are not snapshotted; they keep the live-PDK policy,
  with their content identity recorded as described next.

To reproduce a historical run from snapshots, restore `tb.fragment.spice`,
`dut.netlist.spice` and any listed dependencies over the originals named by
`testbench.path`/`netlist.path` (in a scratch worktree, never in committed
evidence), together with the manifest snapshot above. A hand-built `Testbench`
(not produced by `testbench.load`) has no captured bytes and keeps using the
live files. Legacy records have no snapshots.

### PDK model-content identity (#562)

`pdk:` records the variant and the version label read from the installation's
`SOURCES` file. That label cannot tell apart two installations whose model
bytes differ (a locally patched model card, a partial update). Each record from
`run_corners.py` therefore also carries a `pdk_content:` block and a
`pdk-models.json` manifest in its raw directory.

**What the identity covers, exactly.** The manifest starts from the two model
entry points every composed deck names:

- `libs.tech/ngspice/design.ngspice`, loaded whole by `.include`;
- `libs.tech/ngspice/sm141064.ngspice`, loaded by `.lib <file> <section>` once
  per selected section -- the corner's sections, or the testbench's
  `extra_lib_sections` when it sets them. The sections are recorded in order.

From the loaded content it follows every `.include`/`.inc <file>` and
`.lib <file> <section>` reference, transitively. For a `.lib` reference only the
named section (`.lib <name>` ... `.endl`) of the target file is followed. For an
`.include` the whole file is followed except section definitions, which it
defines but does not load. Each file reached is hashed in full (SHA-256) and
listed by its path relative to the PDK variant directory. No host path is
stored, so an identical set of files gives the same identity wherever the PDK is
installed. The identity is the SHA-256 of the canonical JSON of the entry
points, sections, file list and problem list. Files that only unselected
sections reach are not covered. Nothing else in the installation is covered:
other model files, `SOURCES` itself, the xschem and klayout trees, ngspice's
own `spinit`/code models.

**Incomplete identities.** These references make the manifest list a
*problem*. The record then says `complete: false` with the problem count, and
its Caveats list the problems:

- a missing file, or a missing or unterminated section;
- a parameterized or environment-dependent path (`{...}`, `$`, `~`);
- an `.include` or `.lib` with an unexpected number of arguments;
- a path that leaves the PDK variant directory (absolute paths are not echoed);
- a nested section definition;
- another file-loading directive (`.osdi`, `.hdl`, `.incl`, `.includex`,
  `.libx`, `.load`), or a `.control`-block `source`/`osdi`/`pre_osdi`/
  `codemodel`/`load` command.

The scanner assumes a relative path resolves against the including file's
directory, where ngspice looks first. ngspice's fallbacks (working directory,
`sourcepath`) are not modelled.

**Capture and re-check.** The manifest is computed for each distinct section
set *before* any simulator starts, and printed as `models :` in the run header (unless `--quiet`).
It is recomputed for each PVT point before that point's record is written. If
the identity differs, that point's record is **not** written. Its raw
directory keeps the decks, logs, the pre-run `pdk-models.json` and the
re-check's `pdk-models.after-run.json`. The differing files are printed, and the
run ends `status : FAIL (PDK model files changed during the run)` with exit 5.
That raw directory is diagnostics, not evidence: do not commit it. Points
re-checked before the change keep their records. `--no-write` runs perform the
same check.

**Limit.** This is provenance, not a frozen installation. The models are still
read live by ngspice. An edit made and reverted entirely between the pre-run
capture and the re-check is not detected, and neither is a change that ngspice
picks up through a path the scanner does not follow (listed as a problem when
it is visible in the files).

**Verification.** `pdk-models.json` is in `raw.files`, so
`verify_record_checksums.py` flags any change to it. It also flags a
`pdk_content.sha256` that disagrees with the `raw.files` entry, and an
`identity`, `file_count` or `complete` value that disagrees with the
recomputation from the manifest. Legacy records have no `pdk_content:` block
and are not affected.

### Stored evidence for new `run_corners.py` runs (#686, DR-0032)

*Additive; records from `run_corners.py` after #686.* A recorded run no longer
commits its raw output. It stages each point's decks, logs and input snapshots
in the git-ignored `sim/.work/.stage/<stem>/`, stores them with
`klt artifact put`, and commits only:

- `manifests/artifacts/<stem>.manifest.json`, one entry per object (name, size,
  sha256, `uri` starting `artifact:`). It names no bucket, account or broker URL;
- the record `sim/records/<stem>.md`, whose frontmatter has a `stored_evidence`
  block (`manifest:` and a `files:` table of `- <name>  size:<bytes>
  sha256:<hex>`) in place of the `raw:` block. No `sim/records/raw/<stem>/` is
  created. The `manifest:`, `inputs:` and `pdk_content:` digests are
  cross-checked against that table exactly as they are against `raw.files`.

The writer fails closed. With `$KLT_ARTIFACT_BROKER` unset, a `klt` that lacks
`artifact put`, or an unreachable broker, the run exits nonzero (3 before any
simulation for the first two; 6 if a put fails after the grid) and writes
nothing under `manifests/` or `sim/records/`; the staged bytes are kept. There
is no flag that commits bytes instead; `--no-write` is the only run that
records nothing. Other record writers (the behavioral and gate-level
`sim/tb/*/run_*.py` callbacks, `signoff/`) are unchanged and keep committing
their raw output. The store takes 1 byte to 5 GiB per object, so a point with
an empty staged file is refused before any put rather than half-stored.

Checks: `verify_record_checksums.py` compares the table with the manifest and
fails on a mismatch, a raw directory beside a stored record, or (corpus run) a
manifest whose record is missing. `npm run check:artifact-manifests` validates
schema, `artifact:` URIs and the absence of storage names, and fails if a stored
object's bytes are committed. Entries named for a harness input snapshot
(`spinit`, `tb.fragment.spice`, `dut.netlist.spice`, `tb.manifest.json`) are
exempt from that last check: they are byte copies of tracked inputs by
construction. Run output (`.log`, `.raw`, decks) stays guarded. Both run in CI. The stored bytes themselves are
re-hashed by `klt artifact verify manifests/artifacts/<stem>.manifest.json`,
which needs the broker and so runs on a fleet worker, not in CI.

### Checking that evidence stays append-only

The checksum command only proves the *current tree* is self-consistent. A record
edited in place, raw output rewritten together with its recorded hashes, or a
record deleted together with its raw directory would all still pass it. The
history check compares `sim/records/` at HEAD with a base revision:

```sh
python3 sim/tools/verify_evidence_history.py                 # vs origin/main
python3 sim/tools/verify_evidence_history.py --base <rev>    # vs another base
npm run check:evidence-history                               # same, via npm
```

Added files (new records, new raw output) pass. Any modification, deletion,
rename or type change of a previously committed file under `sim/records/` fails,
with one exception: the supersession edit described under "Superseding a
record". For a modified record the tool undoes exactly that edit (`status:
superseded` back to `status: valid`, removing the one `superseded_by:` line)
and requires the result to equal the base bytes, so any extra change to
numbers, metadata or prose fails. It also requires the `superseded_by` target
to exist at HEAD and to declare `supersedes: <old stem>`.

The comparison is between the merge-base of the base and HEAD, and HEAD. The
base must be loadable: an unknown revision, a shallow clone lacking it, or no
shared history exits 2 rather than checking an empty diff. Fetch the base first
(`git fetch origin main`) if `origin/main` is missing locally. CI checks out
full history and uses the pull request's base SHA for `pull_request` events and
the pre-push SHA for `push` events; the all-zero "before" SHA of a first push
therefore fails loudly instead of passing.

`manifests/artifacts/*.manifest.json` are held to the same rule: a new manifest
passes, any change to or removal of a committed one fails.

---

## Worked example (ILLUSTRATIVE ONLY — not evidence)

> **The block below is a format illustration. Every number, SHA, seed, and
> path in it is fabricated.** It is deliberately kept inline in this README
> and is *not* committed as a file under `sim/records/`, so it can never be
> mistaken for real evidence. Copy its shape, never its contents.

````markdown
---
record: 2026-08-14-ro-delay-cell-jitter-03
date: 2026-08-14T09:12:00Z
status: valid
supersedes: 2026-08-13-ro-delay-cell-jitter-01   # optional; omit if none

testbench:
  path: sim/tb/ro-delay-cell-jitter/tb_jitter.sp
  sha: 0000000000000000000000000000000000000000    # illustrative
netlist:
  path: design/ro/ro_core_9stage.spice
  sha: 1111111111111111111111111111111111111111    # illustrative
repo_commit: 2222222222222222222222222222222222222222

pdk: gf180mcuC @ <pdk-version-tag>
pdk.models:
  - <pdk-root>/models/ngspice/design.ngspice (section: <corner-section>)

tool:
  ngspice: "ngspice-<version> : Circuit level simulation program"   # verbatim `ngspice -v`
  platform: macOS 15.x arm64

corner:
  process: ff
  voltage: 3.63 V (nominal 3.3 V, +10%)
  temperature: -40

analysis:
  type: tran-noise
  tstop: 200u
  tstep: 1p
  noise_params: "NOISETSTEP=1p NOISEFMAX=100G"    # verbatim from the deck
  runs: 5
seeds: [1001, 1002, 1003, 1004, 1005]

raw:
  path: sim/records/raw/2026-08-14-ro-delay-cell-jitter-03/
  files:
    - run-1001.raw  sha256:aaaa…    # illustrative
    - run-1002.raw  sha256:bbbb…
    - ngspice.log   sha256:cccc…
wall_time: 41m
---

## Result

Illustrative placeholders — do not cite:

| Quantity | Mean over 5 seeds | Run-to-run spread (min–max) |
|---|---|---|
| Period jitter, 1σ (per stage) | `<value> ps` | `<min>–<max> ps` |
| Accumulated jitter @ 1 µs | `<value> ns` | `<min>–<max> ns` |
| Accumulated jitter @ 4 µs | `<value> ns` | `<min>–<max> ns` |

Numbers only. No entropy-rate claim is made or implied by this record.

## How to reproduce

```sh
# from repo root, one invocation per seed
ngspice -b -r sim/records/raw/2026-08-14-ro-delay-cell-jitter-03/run-1001.raw \
  -D seed=1001 sim/tb/ro-delay-cell-jitter/tb_jitter.sp
```

## Caveats

- Single corner (`ff` / +10% / −40 °C). Says nothing about any other corner.
- 200 µs accumulation bounds the √t check over one decade only; longer-time
  behavior is not covered.
- Transient-noise flicker handling is a known method limit — low-frequency
  jitter accumulation from this run should not be extrapolated past the
  simulated window.
````

---

## What does *not* belong here

- Summary/characterization documents that aggregate many records. Those are
  ordinary documents; they **cite** record stems rather than restating
  metadata, and they live outside `sim/records/`.
- Decisions. A choice that changes the design or the spec goes in
  `spec/decision-records/` (see
  [`spec/decision-records/TEMPLATE.md`](../spec/decision-records/TEMPLATE.md)),
  citing the records that informed it.
- Claims the run did not measure — entropy rates, spec pass/fail,
  architecture recommendations.
