2AMLogic/gf180-trng/layout/floorplan/README.md

# Entropy-source isolation: the floorplan and why it is shaped like this

This is the written isolation rationale for the RO-array entropy source
(issue #16), plus the floorplan abstract that carries it and the area rollup
that prices it.

**The premise, from the issue that asked for it:** deterministic coupling can
masquerade as entropy. A bitstream that is correlated with a neighbour's clock
or with a supply tone can pass every statistical battery and still be a
security failure, because a battery measures whether the stream *looks*
random, not whether an adversary can *predict* it. So the floorplan is
derived from a threat model rather than from a placement convenience, and
every mitigation below names the specific mechanism it addresses — and, more
importantly, the mechanisms it does **not** address.

There are three distinct coupling mechanisms in this block. Two of them are
what the layout literature means by "isolate the oscillator", and the
floorplan addresses them. **The third one is not a layout problem at all**, is
measured at 28.6× in this repository, and survives every mitigation the first
two get. Getting that distinction wrong is how an array that is correlated by
construction ends up documented as independent.

The circuit-level mitigation for that third mechanism — one buffer per ring
ahead of the combiner — has been **measured** ([#75]) and **adopted**
([#78]): it removes 92.8 % of the coupling and *returns* power rather than
costing it, and a 2.87× residual survives.

---

## The one command

```sh
python3 layout/floorplan/floorplan.py            # build, check, print the rollup
python3 layout/floorplan/floorplan.py --write    # ... and refresh the artefacts
python3 layout/floorplan/floorplan.py --list     # print the region table
```

It expands the *committed* netlists into a per-region cell inventory, prices
each region against the PDK's own standard-cell LEF and against measured
device footprints, generates a guard ring per region, composes them into one
stream with a declared isolation channel between neighbours, runs DRC on the
result, and compares everything against the committed artefacts under
[`reports/`](reports/). It prints `PASS` and exits 0 only if the composed
abstract is DRC-clean **and** the committed artefacts still match.

Like `layout/verify.py` it **skips with exit 0** when `klt` or the PDK is
absent, and `--require-tools` turns that skip into a failure. A skip is not a
pass.

Every number quoted below is produced by that script and lands in
[`reports/area.json`](reports/area.json); nothing here is a figure somebody
typed in.

---

## What is being isolated, and from what

The shipped block, per [`design/README.md`](../../design/README.md):

| | |
|---|---|
| Entropy source | `ro_array_core` — two eleven-stage current-starved rings (`ro_ring11`, `wstv` = 0.220 / 0.240 µm) on their own supply pins `vddr1` / `vddr2`, combined by one `xor2` |
| Sampler | `sampler_core` — four `sampler_dff`: `xsb` (raw bit), `xsv` (`raw_valid`), `xsr1`/`xsr2` (the DR-0016 per-ring liveness digitizers), all on the DR-0012-clock **fixed external** sample clock |
| Digital | conditioner (#8), health tests (#11), interface (#26) — 1655 standard cells, 658 flip-flops, all synchronous to that same external clock |

Two facts about that list drive the whole floorplan.

**The rings are the only thing in the block that is supposed to be
unpredictable.** Everything else — the sample clock, the conditioner's LFSR,
the health-test counters, the FIFO pointers — is deterministic by design and
switches in patterns an observer can predict or, in the clock's case,
*choose*.

**The sample clock is an external pin** ([DR-0012-clock]). It is not derived from a
ring and it is not generated on die, which is the right decision for
independence — and it also means the block's largest, most regular switching
aggressor is under the control of whoever drives that pin. A disturbance
injected into a ring at the sample clock's own rate is the worst possible
disturbance, because it is *coherent with the sampling instant*: it does not
average away over many samples the way an incommensurate ring-to-ring beat
does. Keeping `clk` away from the ring nodes is therefore not general good
practice here; it is the specific consequence of DR-0012-clock's choice.

---

## The regions

Four guarded regions, in this order, with a **20 µm isolation channel**
between neighbours. The three analog regions are one left-to-right strip;
since [#803] the `digital` region is stacked **above** the strip, one 20 µm
channel over the tallest analog region, rather than at the strip's east end
(see [the stacked arrangement](#the-stacked-arrangement-and-the-digital-supply-tie--issue-803)):

| region | contents | own supply | role |
|---|---|---|---|
| `ring1` | `ro_ring11` (1 × `ro_nand2` + 10 × `ro_stage`), `wstv` = 0.220 µm | `vddr1` | entropy |
| `ring2` | `ro_ring11`, `wstv` = 0.240 µm | `vddr2` | entropy |
| `combiner_sampler` | `xor2` + 2 × `ro_buf` ([DR-0018][DR-0018]) + 4 × `sampler_dff` | `vdd` | boundary — carries `clk` |
| `digital` | conditioner + health tests + interface | `vddd` | deterministic aggressor |

The ordering is the argument: the **only** region that touches both the
entropy nodes and the sample clock is `combiner_sampler`, and it sits between
the rings and the digital section rather than beside them. In the strip it
is the eastmost region, and the stacked `digital` region's east edge is
derived to sit east of it, so `clk` still reaches the samplers from the
digital side without crossing either ring's guarded area or isolation channel.
Part of `digital` now lies above the rings (a 20 µm vertical channel apart,
the same width as every other channel); no digital conductor enters a
`ring1 | ring2` channel (see the isolation argument below).

Each region is enclosed by a p-substrate tap guard ring, 1.0 µm thick with tap
contacts every 2 µm, tied to that region's own `vss` return. The rings are
generated by `klt gen guard_ring` and are real geometry, not a drawing: they
are in the composed stream and they are what DRC checks.

The 20 µm channel is a **routing-derived floor, not a coupling-derived one**.
It is what each supply domain needs to reach its own region without sharing a
channel with another domain's straps, and it keeps neighbouring tap rings 20 µm
apart. **No substrate-coupling attenuation is claimed for it** — see
[What this floorplan does not establish](#what-this-floorplan-does-not-establish).

---

## Mechanism 1 — mutual injection locking between the rings

**What it is.** Two nominally identical oscillators that share a substrate, a
supply or a magnetic neighbourhood pull each other toward a rational frequency
ratio. When they lock, [DR-0007] §2's sum over independent rings collapses: the
array degenerates toward one ring's worth of jitter while the bitstream still
looks plausible. This is the failure mode [DR-0007] §6 names, and the one the
architecture survey's §A.4 injection-locking argument is about.

**What addresses it here.**

1. **Deliberately non-integer frequency ratios**, already in the schematic:
   the two rings differ only in starve-device width (0.220 vs 0.240 µm) and
   measure a frequency ratio of **1.057** at `ff`/−40 °C/3.63 V and **1.062**
   at `ss`/−40 °C/3.63 V (`sim/records/2026-08-01-ro-array-core-power-*.md`),
   holding at **1.060** with the sampler's load attached
   (`…-sampler-array-digitize-03/04.md`). No small-integer factorisation, at
   any measured corner. This is [DR-0007] §1's requirement, and it is a
   *schematic* property the layout must not undo.
2. **Per-ring supply routing**, also already in the schematic: `vddr1` and
   `vddr2` are separate pins on `ro_array_core`, so the two rings have no
   shared series supply impedance inside the block. The floorplan's job is to
   keep them separate all the way to the star point (below), rather than
   merging them at the first convenient strap.
3. **Physical separation and per-ring guard rings**: each ring sits inside its
   own tap ring, with a 20 µm channel between them.

**The layout decision that is easy to get backwards.** Standard analog layout
practice for a matched pair is common-centroid interdigitation with dummies —
`klt gen`'s own `diff_pair` and `mos_array` generators default to
`topology: "common_centroid"` for exactly that reason. **That practice is
actively wrong here.** The two rings are not a matched pair; they are
deliberately *mismatched*, and the mismatch is load-bearing — it is the entire
mechanism producing the non-integer frequency ratio above. Interdigitating
them would (a) pull their frequencies together, shrinking the very ratio that
mitigation 1 depends on, and (b) put each ring's devices immediately adjacent
to the other's, which is the arrangement injection locking wants. So:

> **The two rings are laid out as two separate, unmatched, individually
> guarded blocks. No common-centroid pairing, no interdigitation, no shared
> dummy row, no shared well.** Any future generator-driven layout of these
> cells must be given `topology: "array"`, not the default.

**Evidence that locking is not already happening at the schematic level.** The
four-ring sanity vehicle holds four distinct periods (3.305 / 3.105 / 2.876 /
2.678 ns) reproduced to within 0.0 % of the mean across three independent noise
seeds (`sim/records/2026-08-01-ro-array-sanity-jitter-01.md`), and in the
two-ring coupling study ring 2 free-runs at an unrelated frequency with ring 1's
mean period moving 0.16 %
([`sim/characterization-array-ring-coupling.md`](../../sim/characterization-array-ring-coupling.md)).
Those are pre-layout, ideal-supply results: they show the *schematic* does not
lock, and they are silent about a built array. Extraction adds coupling paths;
it removes none.

---

## Mechanism 2 — supply and substrate coupling

**What it is.** Every switching gate dumps a current transient into the supply
network and a displacement current into the substrate. Shared series impedance
turns those into voltage steps on a neighbour's rail; substrate injection turns
them into body-bias modulation. A ring's frequency is a direct function of both,
so a deterministic switching pattern anywhere in the block becomes a
deterministic phase modulation on every ring that shares a rail or a substrate
neighbourhood with it. The digital section is the loud one: 658 flops all
clocked by the same external `clk`.

**What addresses it here.**

1. **Star routing from a single point.** Four supply domains — `vddr1`,
   `vddr2`, `vdd` (combiner + samplers), `vddd` (digital) — each a separate
   branch from one star point at the block's supply pad, with **no shared
   series impedance between the entropy branches and the digital branch**. The
   schematic already provides the separate pins for the first three; the
   floorplan's contribution is the requirement that they stay separate to the
   pad, and that the digital domain never shares a strap segment with an
   entropy domain.

   As of [#171](https://github.com/2AMLogic/gf180-trng/issues/171) the
   digital section has a real PDN of its own
   ([`layout/digital/README.md`](../digital/README.md#power)), and it is
   built to this requirement rather than merely alongside it: its grid is on
   nets `vddd`/`vss`, it terminates at the block's own `vddd`/`vss` pins, and
   `layout/digital/build.py`'s `_power_isolation_check` reads the routed
   DEF's own `SPECIALNETS` section on every run and fails if it carries
   anything other than those two — in particular if it carries `vddr1`,
   `vddr2` or `vdd`. That is the layout-side half of this requirement,
   checked and committed (`checks.power_isolation` in
   `layout/digital/reports/place_and_route.json`). The other half — that the
   four branches stay separate *to the pad* — is still this floorplan's, and
   still unbuilt: as of
   [#209](https://github.com/2AMLogic/gf180-trng/issues/209)/
   [#210](https://github.com/2AMLogic/gf180-trng/issues/210) the `digital`
   region below holds the real, placed `layout/digital/trng_top.gds` rather
   than an empty guard ring, but nothing in this repository yet draws the
   star point those four branches would converge on.
2. **Per-domain guard rings**, tied to each region's own `vss` return. In a
   p-substrate process a p+ tap ring is a majority-carrier collector: it is the
   standard structure for keeping injected substrate current from reaching a
   sensitive device, and it is what the abstract draws (`add_well: false` — an
   n-well tie is a different structure for a different job).
3. **The digital section is not adjacent to a ring.** Its boundary is with
   `combiner_sampler`, across a 20 µm channel and two tap rings.
4. **Supply filtering is named as required and not yet designed.** On-die
   decoupling for the entropy domains is the obvious next structure. This
   floorplan reserves the channel it would sit in but does **not** size it —
   sizing needs a supply-network impedance target, and there is no measurement
   in this repository that sets one (see below).

**What is claimed, precisely.** That the *topology* removes shared series
supply impedance between the deterministic and entropy domains, and that each
region has a majority-carrier guard structure. **Not** that substrate coupling
is attenuated by any particular factor, and **not** that 20 µm is sufficient
separation — those are quantitative claims and this repository has no substrate
network model, no extracted parasitics and no supply-network testbench to
support them. The coupling study's own caveat says the same thing from the
other side: every deck in it supplies the rings from an **ideal** `vsup` with
no impedance for one ring's current to develop a voltage across, so its
measured coupling factor is a **lower bound** on a built array's, not an upper
one.

---

## Mechanism 3 — coupling through the XOR combiner, which is not a layout problem

This is the one that matters most, and the one the original acceptance
criteria did not cover.

**What was measured.** At `tt`/27 °C/3.30 V, over a 512-period window opened
256 periods after start-up, four variants that differ from a standalone-ring
control in exactly one thing each
([`sim/characterization-array-ring-coupling.md`](../../sim/characterization-array-ring-coupling.md),
issue #51 / PR #67):

| variant | differs by | `σ₁` | vs control |
|---|---|---|---|
| `ro-array-coupling-xor-static` | `xa1` present, second input on a rail | 0.676 ps | 1.06× |
| `ro-array-coupling-xor-driven` | `xa1` driven by ring 2 | 18.32 ps | **28.6×** |
| `ro-array-coupling-rings-only` | two rings, electrically unconnected | 0.642 ps | 1.00× |

The static combiner load is innocent. Two rings solved on the same adaptive
timestep with no wire between them are innocent to three digits. **Electrical
attachment through the combiner is the mechanism**, and its signature is a
deterministic beat at `|f₁ − f₂|`: `σ_acc` *collapses* 8.6× at the lag that
equals the beat period, which no accumulating jitter process can do.

**Why it is a different mechanism from injection locking, and why every
mitigation above misses it.**

- **The rings are not frequency-locked.** Ring 1's mean period moves 0.16 %
  between the switching-neighbour and quiet-neighbour cases; ring 2 free-runs
  at an unrelated frequency. Nothing is pulled to a rational ratio.
- **It survives arbitrary frequency separation.** The disturbance is a beat at
  `|f₁ − f₂|`, so the beat rate *is* the frequency separation. Skewing the
  rings further apart moves the tone; it does not remove it. Mitigation 1 does
  not apply.
- **It survives arbitrary physical separation.** The coupling path is charge
  injected into node `ro1` through the gate-drain / gate-source capacitance of
  `xa1`'s input stage — a **shared electrical node by construction**, not a
  layout adjacency. Put the two rings on opposite corners of the die and the
  wire from each to the combiner still exists, because the combiner is what
  the architecture is. Mitigations 2 and 3 do not apply.
- **The error is in the unsafe direction.** [DR-0007] §2 sums
  `σ²_acc,i / T₀,i²`. Locking makes that sum *collapse*; this makes it *inflate*
  — by the square of the coupling factor, ~820× at this corner — while every
  recorded number still says the array passes. And the excess carries no
  entropy: it is a fixed function of ring 2's phase, which the XOR already
  carries into the output. Counting it inside ring 1's `σ_acc` double-counts a
  quantity that is, from ring 1's point of view, not random at all.

**Therefore, stated once, plainly:**

> XOR-combiner coupling is a **distinct mechanism** from injection locking. It
> is **not mitigated by floorplan separation, by guard rings, by per-ring
> supply routing, or by frequency-ratio skew** — the combiner input stage is a
> shared electrical node by construction. An independence argument that cites
> only the [DR-0007] §6 mitigations is incomplete, and incomplete in the
> direction that overstates the array.

### The same topology exists a second time — and it was measured ([#76])

The measurement above indicts a specific arrangement: *a ring node driving the
input gate of a cell whose internal nodes something else is driving*. The block
contained that arrangement twice more, and the floorplan work is where it
surfaced:

- `xsr1` / `xsr2`, the DR-0016 per-ring liveness digitizers (#71), put each
  ring node `ro1` / `ro2` on a `sampler_dff` input — a transmission gate whose
  other terminal is the master latch node, and whose gate is driven by **`clk`**.
- `xsb` does the same on `xo` with the same clock.

This section previously said that nothing measured what those digitizers cost
the rings in **phase**, and filed it as [#76]. [#76] measured it, in
[`sim/characterization-liveness-tap-phase-cost.md`](../../sim/characterization-liveness-tap-phase-cost.md),
at `tt`/27 °C/3.30 V through #51's own window geometry. **The concern stated
here was correct, and the effect is larger than the one this document was
written about:**

| | `σ₁` against its own static reference | ring-period swing across the run |
|---|---|---|
| digitizer's `d` on the **ring node**, `clk` running (what shipped up to [#82]) | **541×** | **23.11 %** |
| digitizer's `d` on the **buffer output**, `clk` running (what ships now) | **19.9×** | **0.96 %** |

The mechanism is not the one the coupling section describes, and it is
simpler: the `sampler_dff` master transmission gate conducts while `clk` is
low, so the ring node drives the master latch's input inverter through a full
transition every ring cycle in one clock phase and sees only junction and
overlap capacitance in the other. The ring therefore runs at **two different
frequencies, 25.6 % apart** (2.7472 ns and 3.4507 ns on the 5-stage reference
ring), and a running `clk` switches it between them — block for block, at
exactly those two periods, with a repeat period equal to the clk period. Across
four independent noise seeds the resulting `σ₁` reproduces to 0.01 % where a
genuine estimate scatters 2.69 %, and it accumulates as `L^0.95` rather than a
random walk's `L^0.5`. It is deterministic, and unlike a ring-to-ring beat it is
coherent with the sampling instant by construction.

**The buffer this document proposed and [#78]/[DR-0018] adopted removes 96.5 %
of it** — a fraction close to the 92.8 % it removes on the combiner path, from
decks that share nothing with those but the cell. So the mitigation adopted for
one mechanism turns out to address the other as well. It does not remove it:
19.9× is far outside the 1.00×–1.08× band a quiet ring occupies, and the
residual is as deterministic as the thing it is a residual of. What reaches the
ring through a buffer is the `clk`-dependent load on the buffer's *output*,
changing the buffer's output slew, fed back through the buffer's own gate-drain
capacitance to its input.

**What this adds to the isolation rationale**, stated once and plainly:

> A `clk`-driven cell tapping a ring node is a **third** coupling mechanism,
> distinct from injection locking and from XOR-combiner coupling. Like combiner
> coupling it is **not mitigated by floorplan separation, guard rings, per-ring
> supply routing, or frequency-ratio skew** — the digitizer's input stage is a
> shared electrical node by construction. Unlike combiner coupling, its
> aggressor is an **external pin** ([DR-0012-clock]), so its rate is not a design
> constant, and its disturbance is phase-locked to the sampling instant rather
> than incommensurate with it. The per-ring buffer attenuates it by ~30×; no
> floorplan measure attenuates it at all.

Nothing here proposes a further design change: what should be done about the
remaining 19.9×, if anything, is not decided by that document or this one.

### Adopted mitigation: one buffer per ring, ahead of everything

**The mitigation, adopted ([#78]).** One minimum-width inverter on each ring
output, between the ring node and *every* consumer — the combiner input and
that ring's liveness digitizer both drive off the buffer's output, not off
the ring node. [`DR-0018`](../../spec/decision-records/DR-0018-adopt-per-ring-output-buffer.md)
records the decision; `design/xschem/ro_array_core.sch` and the new
`design/xschem/ro_buf.sch`/`.sym` are where it lands.

Inverting one or both XOR inputs does not change the entropy at the combined
node (`a ⊕ b` and `¬a ⊕ b` differ by a constant inversion), so a single
inverter is sufficient; no non-inverting pair is needed.

**Why it should help, structurally.** The coupling path is charge injected
*backwards* through the consumer's input-stage capacitance into whatever node
drives it. With a buffer, that node is the buffer's output — a low-impedance,
actively-driven node — instead of the ring's own high-impedance oscillating
node. What reaches the ring is then attenuated by the buffer's reverse
isolation rather than landing on the ring directly.

A second, purely structural effect is visible in the netlist and needs no
simulation to state: `xa1`'s `a` input presents **1.98 µm of total gate width**
to `ro1` (`XMpiA` 0.44 + `XMniA` 0.22 + `XMp1` 0.88 + `XMn1` 0.44), while an
inverter buffer's input presents **0.66 µm**. Buffering therefore takes load
*off* the ring node as well as isolating it.

**What it costs — MEASURED, [#75].** This section previously carried an
estimate and a refusal to adopt on the grounds that nothing measured it.
[#75] measured it, in
[`sim/characterization-ring-buffer-mitigation.md`](../../sim/characterization-ring-buffer-mitigation.md).
The estimate is kept below because being wrong in an interesting way is worth
recording, not because it is still the number:

| | What was **estimated** here | What was **measured** ([#75]) |
|---|---|---|
| Area | 2 × `inv_1` = **17.6 µm²** cell, ~29 µm² placed at 60 % — **0.06 % of the < 0.05 mm² row** | not re-measured; this is a LEF area, not a simulation |
| Buffer power | **≈ 24.4 µW** at `ff`/−40 °C/3.63 V, from `P = C_eff · V² · f` with `c_eff_node_r1` = 3.865 fF | **61.8 µW** — 2.5× the estimate. `c_eff_node_r1` averages a ring stage driving the *next* ring stage's 0.66 µm; the buffer drives `xa1`'s full 1.98 µm |
| Ring power | offset from the 3× load reduction deliberately **not** priced | per-cycle energy −5.0 %, average power **+1.4 %** — the ring spends the saving on running 6.7 % faster |
| Combiner power | not considered | **−85.6 µW (−58.8 %)**. The buffer's un-starved output gives `xa1` fast edges where the starved ring gave it slow ones |
| **Block active rollup** | 454.2 µW (90.8 %) → **≈ 478.6 µW, 95.7 %** of the `< 500 µW` row | 454.2 µW (90.8 %) → **435.1 µW, 87.0 %** |

The estimate had the **sign** wrong, not just the magnitude: the mitigation
does not spend half the remaining headroom, it *returns* 19.1 µW of it. The
term the estimate omitted — what happens inside the combiner once it is driven
by fast edges — is larger than the two terms it included.

**What it buys, measured at `tt`/27 °C/3.30 V.** With a matched
quiet-neighbour control at the *same* buffered operating point
(`sim/tb/ro-array-coupling-xor-static-buffered/`, so the comparison spans one
change and not two), the coupling factor falls from **27.10× to 2.87×** —
**92.8 % of the excess removed**. It is **not** removed entirely, and the
residual is still deterministic (1.1 % seed spread against the ~2.7 % a real
jitter estimate scatters, accumulation exponent 0.141 against the control's
0.421, and a still-non-monotonic `σ_acc`). Squared, 2.87× is an **8.24×**
over-statement of one ring's contribution to `Q_array`, still in the unsafe
direction.

**The decision this document now records:**

> **The measurement rule below is unchanged and remains adopted** — an 8.24×
> residual is not a licence to measure per-ring `σ_acc,i` with the neighbours
> switching, and the buffer does not relax it. **The buffer is adopted**
> ([#78], [`DR-0018`](../../spec/decision-records/DR-0018-adopt-per-ring-output-buffer.md)):
> it removes 92.8 % of the coupling, costs 0.06 % of the area row, and
> *returns* headroom to the power row. Adoption was not a floorplan edit — it
> edited `design/xschem/ro_array_core.sch`, added `design/xschem/ro_buf.sch`,
> and obsoleted every shipped-array record's operating point (+6.7 %
> frequency, −4.9 % power), so it went through a decision record and a re-run
> of the `ro-array-core-power`, `ro-array-core-pvt-q` and
> `ro-array-core-startup` families. Against those re-run records the block's
> active rollup at the binding corner (`ff`/−40 °C/3.63 V) is **433.2 µW,
> 86.6 % of the `< 500 µW` row**, down from the pre-adoption 454.2 µW
> (90.8 %) — close to, and slightly better than, the 435.1 µW the
> testbench-only measurement projected.

The edge case the issue asks about is worth stating explicitly: **the buffers
must be per-ring, never shared.** A single buffer stage feeding both combiner
inputs would create exactly the shared node the mitigation exists to remove.

---

## The measurement rule (adopted)

> **Per-ring `σ_acc,i` offered as evidence for [DR-0007] §2 must be measured
> with that ring's combiner neighbours quiet** — the `ro-array-coupling-xor-static`
> arrangement, gate load present and neighbour held on a rail — **or with the
> deterministic component separated out and reported alongside.** A per-ring
> `σ` taken from a deck in which the neighbours switch is not admissible for
> §2.

**`sim/records/2026-08-01-ro-array-sanity-jitter-01.md`'s `σ_r1_*` figures do
not meet this bar.** They were taken with the combiner neighbours switching,
they are 28.6× inflated by a deterministic beat at the corner where that factor
is measured, and they must not be cited for independence or for sizing. That
record keeps `status: valid` and gets no `superseded_by` — per
[`sim/README.md`](../../sim/README.md), superseding it means re-running the
testbench, which is #46's work and not this issue's. This is a statement about
**admissibility**, not about the record's honesty.

**Nothing in the repository's current §2 path violates the rule**, and that is
checkable rather than asserted: `sim/tools/array_sizing.py` evaluates
`Q_array` from the *deterministic* per-ring period and supply-current records
(`ro-array-core-power`, `ro-array-core-pvt-q`) through the jitter-energy law,
and prints the sanity-jitter record's `κ²` only as a **reported, not enforced**
comparison. The rule therefore binds future evidence, and #12 inherits it: the
empirical independence check DR-0007 §6 assigns to #12 must target this path
specifically — cross-correlation of per-ring crossing residuals against the
neighbour's phase, not a frequency-ratio or locking check, which this mechanism
passes.

---

## Area against the `< 0.05 mm²` row

From `python3 layout/floorplan/floorplan.py` — full breakdown in
[`reports/area.json`](reports/area.json):

| region | cells | cell area | placed @ 60 % | guarded footprint |
|---|---:|---:|---:|---:|
| Entropy ring 1 | 11 | 225.1 µm² | 375.1 µm² | 546.1 µm² |
| Entropy ring 2 | 11 | 225.1 µm² | 375.1 µm² | 546.1 µm² |
| XOR combiner + 2 buffers + 4 samplers | 7 | 342.4 µm² | 570.8 µm² | 5 434.1 µm² |
| Conditioner + health tests + interface | 863 | 33 654.6 µm² | 56 091.0 µm² | 160 744.9 µm² |
| **total** | | **34 447.2 µm²** | **57 412.0 µm²** | **167 271.3 µm²** |

> **Regenerated for issue [#256] (2026-10-10).** The **guarded** column, the
> composed `compose.json`/`floorplan.drc.json`/`ring_fit.json`/`interregion.json`
> reports and `trng_floorplan.gds` were re-run under the klayout-tools `0.6.0`
> release [DR-0026] makes normative, against the depth-2 place-and-route
> ([#255]) as repaired by [#315]. The `digital` guarded footprint is now
> **400.93 × 400.93 µm = 160 744.9 µm²** (was 550.825 µm, 303 408.2 µm²), the
> guarded total **167 271.3 µm²**, the floorplan total (with channels)
> **175 789.9 µm²** = **351.6 %** of the `< 0.05 mm²` row (was 642.9 %), and
> the composed row bbox **934.4 × 416.7 µm**. The estimate columns (863 cells /
> 33 654.6 µm²) are unchanged. The paragraphs below that describe the
> depth-8 guarded column are kept as the history of why it was stale.
>
> **The digital row halved in issue [#254], and the guarded column did not
> (until #256, above).**
> [DR-0020]'s `FIFO_DEPTH = 2` is now the shipped RTL/regmap value, so this
> estimate's own inventory (`design/digital_power_estimate.py`, which this
> script reads) prices **863 cells / 33 654.6 µm²** where it used to price
> 1655 / 74 485.3 — the interface alone drops from 63 098.8 µm² to
> 22 268.1 µm², i.e. **40 830.7 µm²**: 40 356.6 µm² of FIFO storage, read mux
> and per-word clock gates (leaving 11 625.8 µm², exactly the 11 626 µm²
> [DR-0019] projected for this depth) plus 474.2 µm² of pointer flops and
> increment logic that narrow with it (`PTR_W` 3 → 1 bits). The **guarded**
> column is
> unmoved on purpose: since issues [#209]/[#210] the `digital` region is sized
> from the composed `layout/digital/trng_top.gds`, which is still the depth-8
> place-and-route, and re-running synthesis and P&R at the new depth is
> explicitly outside #254's scope. So every *composed* figure below —
> including `reports/area.json`'s own `share_of_budget_pct` — is still a
> depth-8 number, while every *estimate* figure is now a depth-2 one. The two
> bases are separated explicitly in the next table rather than averaged.
>
> The one **guarded** figure that did move is not a depth effect either: the
> `digital` region's measured bbox reads 548.825 µm on the `klt 0.5.0` build
> this regeneration ran against, against the 548.815 µm the committed report
> carried, so its guarded area moves by 11.0 µm² (0.004 %) and the channel
> beside it by 0.2 µm². That is the same class of tool-version drift this
> document already records for the starve devices above, not a design change —
> the GDS it is measured from is byte-identical.

> Two of these columns moved for reasons that have nothing to do with the
> inter-region routing this document's [own section](#inter-region-routing--issue-222)
> adds, and both are worth naming rather than leaving as an unexplained
> diff. The **guarded** column had been stale since #135/#209/#210 grew
> `combiner_sampler`'s and `digital`'s guarded footprints (it was last
> transcribed before those landed; `reports/area.json` has been right all
> along). The two rings' **cell area** moved because the starve devices
> under them are priced at a *generated* footprint measured by `klt gen
> mos_array` at run time, and the `klt` build this regeneration ran against
> draws that device differently from the one the previous numbers came from
> (2.39/3.58 µm² then, 5.04/6.44 µm² now, at the same drawn W/L). That is a
> tool-version-dependent *estimate*, not a measurement of drawn geometry:
> every **guarded** figure, and therefore every share-of-row figure below,
> is read from the committed assembled GDS and is unaffected by it.

The two [`DR-0018`][DR-0018] output buffers (`xb1`/`xb2`) joined this table in
issue [#144]. They are inventoried in `combiner_sampler` rather than in the
ring each one buffers, because DR-0018 runs both off the block supply `vdd` —
deliberately, so that neither ring's own `vddr1`/`vddr2` branch carries the
buffer's switching current. Priced at one `inv_1` each they add **17.6 µm²** of
cell area (**29.3 µm²** placed at 60 %, i.e. **0.06 %** of the `< 0.05 mm²`
row — the figure DR-0018 itself projected). No **guarded footprint** moves:
`combiner_sampler`'s is measured from the assembled row's own bbox, not from
this estimate, so every share-of-row figure below is unchanged. That is also
the caveat: the assembled row does not contain the buffers, so this region is
budgeted for them and not yet drawn with them ([#151]) — `reports/area.json`
records it per region under
`footprint_source.inventoried_but_not_in_assembly`.

`ring1`/`ring2`/`combiner_sampler`'s own `cell area`/`placed @ 60 %` columns
above are still the area/utilisation estimate (unchanged in method by this
section); only their **guarded footprint** is sized differently, and only for
those three rows (`ring1`/`ring2` since issue #119, `combiner_sampler` since
issue #135) — see [What the area model is](#what-the-area-model-is) below.

Isolation channels (20 µm × the taller neighbour): 135.0 + 352.8 + 7 086.8 =
**7 574.6 µm²** — the `ring2`|`combiner_sampler` channel *shrank* from
505.4 to 352.8 µm² even though `combiner_sampler`'s own region grew hugely,
because the channel is charged at 20 µm × the taller neighbour's height and
the real assembled row (15.64 µm tall, 17.64 µm guarded) is *shorter* than
the area-estimate square it replaced (23.27 µm tall, 25.27 µm guarded) —
`combiner_sampler`'s footprint got much wider and somewhat shorter, not
uniformly bigger.

| | area | share of the `< 0.05 mm²` row |
|---|---:|---:|
| **Entropy source + samplers + all isolation structures** | **6 535.2 µm²** | **13.07 %** |
| Digital section | 125 556.8 µm² | 251.1 % |
| **Floorplan total** | **139 178.8 µm²** = 0.13918 mm² | **278.4 %** |

> **Update — re-derived at [DR-0020]'s `FIFO_DEPTH = 2` (issue [#254]):
> 278.4 % → 137.7 %.** The table above is the depth-8 estimate and is left as
> written, for the same reason the [synthesis
> comparison](#the-digital-region-has-since-been-synthesized-placed-and-measured)
> below is: it is what this script produced when the number was quoted into
> [DR-0019]. On the **same basis** — every region sized by the
> area/utilisation estimate, which is how this table's 278.4 % was produced —
> the depth-2 re-run gives:
>
> | | area | share of the `< 0.05 mm²` row |
> |---|---:|---:|
> | Entropy source + samplers + every isolation structure but the one to `digital` | 7 026.4 µm² | 14.05 % |
> | Digital section, guard ring included | 57 044.6 µm² | 114.09 % |
> | `combiner_sampler` \| `digital` isolation channel | 4 776.8 µm² | 9.55 % |
> | **Floorplan total** | **68 847.8 µm²** = 0.06885 mm² | **137.7 %** |
>
> Every input is in [`reports/area.json`](reports/area.json) and the
> arithmetic is [DR-0019]'s own stated method (cell area / utilisation,
> squared up, plus a 1 µm guard ring per side, plus the isolation channels):
> the digital region's estimate square is `sqrt(33 654.61 / 0.6) = 236.84 µm`
> (the report states it, under `footprint_source.note`), its guard ring adds
> 1 µm per side → `238.84² = 57 044.6 µm²`, and the channel to it is
> `20 µm × 238.84 µm`. The first row is the three analog regions' committed
> guarded footprints plus the two channels between them — no depth change
> touches it, and the script prints it directly (`entropy source + isolation:
> 7 026.4 µm² = 14.05 %`).
>
> **Recomputed the same way today, the depth-8 row is 279.3 %, not 278.4 %** —
> and the 0.9-point gap is not a depth effect. The identical arithmetic on the
> committed depth-8 cell area reproduces this table's **Digital section row
> exactly** (125 556.8 µm², 251.1 %) and its channel exactly (7 086.8 µm²);
> what it does not reproduce is the first row, which the table still carries
> at 6 535.2 µm² — transcribed before #135/[#209]/[#210] grew
> `combiner_sampler`'s guarded footprint, where `reports/area.json` now gives
> 7 026.4 µm². So like-for-like the re-run is **279.3 % → 137.7 %** (×2.03);
> against the published 278.4 % it is 137.7 % (×2.02). Neither framing changes
> the verdict.
>
> **137.7 %, not [DR-0019]'s 129.4 %.** That record's depth-2 row was computed
> against the older 269.4 % baseline, before issues #119/#135 resized the
> analog regions; re-derived against the 278.4 % baseline above it lands
> higher. It is also computed against a marginally *smaller* digital cell area
> than DR-0019 projected (33 654.6 µm² vs 34 129 µm²), because this run also
> narrows the FIFO pointers (`PTR_W` 3 → 1 bits) that DR-0019 deliberately
> held at their depth-8 widths — worth 474.2 µm², which is the whole of that
> difference. **The row is still missed, now by 1.4× rather than 2.8×.**
>
> **What did *not* move: the composed total.** `reports/area.json`'s own
> `share_of_budget_pct` stayed at **642.9 %** at #254 time (now **351.6 %**, see the #256 note above), because since [#209]/[#210] the
> `digital` region's guarded footprint is measured from the composed
> `layout/digital/trng_top.gds` — the depth-8 place-and-route — and #254 does
> not re-synthesize it. The 137.7 % above is therefore a re-derivation of
> *this estimate*, not a claim about the composed floorplan; closing that gap
> needs a depth-2 synthesis and P&R, which is separate work.

Two findings, and they point in opposite directions.

**Isolation is cheap, but no longer negligible.** The entire isolated entropy
source — both rings, the combiner, all four samplers, four guard rings and
every isolation channel between them — is **13.1 % of the area row**. The
guard rings and channels cost ≈**5 445.7 µm²** of that, i.e. **≈10.9 % of the
row for the whole isolation structure** — both figures are up sharply from
the pre-#135 estimate (4.74 %, 2.56 %) because `combiner_sampler`'s guarded
footprint is now sized from its real assembled row (278.90 × 15.64 µm)
instead of the compact area/utilisation-estimate square it previously used
(23.27 × 23.27 µm), the same kind of resize issue #119 already did for
`ring1`/`ring2` — see [What the area model is](#what-the-area-model-is) and
issue #135. Nothing in `combiner_sampler`'s own cell content changed; only
how its region is sized did. This is a much bigger proportional jump than
issue #119's own ring resize (~+1 percentage point) because
`combiner_sampler`'s row is long and thin (278.9 µm) rather than a shorter
elongated ring geometry. In absolute terms it remains small next to the
budget miss below: the digital section alone is already 125 556.8 µm²
(251.1 % of the row, tracked separately by DR-0019), and this resize's own
+4 163.9 µm² floorplan-total increase is only ~5.5 % of the digital
section's own overage (125 556.8 − 50 000 µm² = 75 556.8 µm² over the
row). Nothing in this document's mitigations is
area-constrained, and the buffer mitigation this document proposed and
[DR-0018][DR-0018] adopted costs the 0.06 % it was projected to — now
counted in the table above rather than pending (issue [#144]).
*The isolation argument does not have to trade against the area budget, and
it should not be allowed to — but it is no longer a rounding error either.*

**The digital section misses the area row on standard-cell area alone** —
74 485 µm², i.e. **1.49× the whole row before any placement at all**, and
2.5× once placed at 60 % utilisation. (Real synthesis and placement have since
put that figure at **113 088 µm², 2.26× the row on cell area alone** — see
[The digital region has since been synthesized, placed and
measured](#the-digital-region-has-since-been-synthesized-placed-and-measured)
below. The estimate is left as written; the miss is larger, not smaller.) The two 8 × 32-bit output FIFOs are
**69.8 %** of it (512 `dffrnq_1` + 448 `mux2_1` + 16 `icgtp_1` =
51 982 µm²). This is the
same structure, in the same block, that [DR-0017] identifies as the reason the
`< 1 µA` idle row misses by 4.5× — one design decision showing up on two
different rows. **No row is edited here, and no design change is made here**:
this issue owns the entropy source's isolation, not the interface's FIFO depth.
The number is recorded so the conflict is visible rather than discovered later,
exactly as [DR-0010] §Consequences recorded the power collision.

The miss itself is now routed by **[DR-0019]** (`Accepted` 2026-09-07, via the
two-key ratification mechanism, `2AMLogic/2am#372`/#213; originally `Proposed`
from #96), the way
the idle-current miss is routed by [DR-0017]: it states the row's status against
this estimate, prices the available responses (reduce the FIFO depth, raise the
row, hold the row, or split it), and carries the depth sensitivity — 269.4 % at
depth 8, 129.4 % at depth 2, 105.8 % at depth 1 and 88.5 % with both FIFOs gone,
all at this floorplan's own 60 % utilisation *as it stood when DR-0019 was
written*, before issue #119's and issue #135's own region resizes above (the
floorplan total is now **278.4 %**, not 269.4 %, entirely from `ring1`/
`ring2`'s (#119) and `combiner_sampler`'s (#135) guarded-footprint changes —
the digital section DR-0019's own table turns on is untouched by either).
Re-deriving DR-0019's depth-sensitivity table against the new total is
that record's own follow-up, not repeated here. Its finding on the shared root
cause is that the same lever reaches the two rows very differently: [DR-0017]
rejected a depth reduction because it never gets the idle current under 1 µA at
any depth, whereas on area it is most of an answer. **[DR-0019]'s ratified
Decision (option C) holds the `< 0.05 mm²` row as written rather than editing
it**, and the joint `FIFO_DEPTH` decision it deferred to is itself now ratified
as [DR-0020] (`Accepted` 2026-09-07, same mechanism): `FIFO_DEPTH = 2`.

That follow-up has since landed: issue [#254] set `FIFO_DEPTH = 2` in the
regmap, the RTL parameter default and both inventory estimates, and re-ran this
script. **The re-derived depth-2 figure is 137.7 %, not DR-0019's 129.4 %** —
see the update block under the summary table above for the derivation, for why
the two differ, and for the one figure the re-run does *not* move (the composed
642.9 %, which is measured from the still-depth-8 `layout/digital/trng_top.gds`).
The row is still missed — by 1.4× where it was 2.8× — so DR-0019's held-row
Decision is unaffected; what the re-run supplies is the number a successor
record needs.

### The digital region has since been synthesized, placed and measured

**The `digital` row above is superseded as a prediction, and kept as one.**
Issues [#143] and [#111] synthesized and placed-and-routed that region for
real, and [#145] measured what came out (`sim/characterization-digital-sta-area-power.md`,
records `sim/records/2026-08-17-digital-sta-power-*`):

| | cell area | cells | library |
|---|---:|---:|---|
| This table's estimate | 74 485.3 µm² | 1655 inventoried | `mcu7t5v0` (7-track) |
| Measured, placed ([#111]) | **113 087.9 µm²** | 2499 placed instances | `mcu9t5v0` (9-track) |
| | **×1.518** | ×1.510 | |

Pricing the *same as-built netlist* against the 7-track library separates the
two axes that moved at once: **×1.209 from cell count and mix** (real
synthesis needs 51 % more instances, averaging 36.04 µm² rather than the
inventory's assumed 45.01 µm²) and **×1.256 from 9-track rather than 7-track
rows**. The inventory got the block's shape right and its cell count wrong,
which is the error a bottom-up count from RTL `reg` declarations is structurally
exposed to.

Nothing in this document is edited to match. The numbers here remain what this
script produces and what [DR-0019] was written against; the measured figure is
larger, is recorded where it was measured, and is what any future re-derivation
of DR-0019's depth-sensitivity table should use. This section exists so that a
reader of the table above cannot mistake a pre-synthesis estimate for the
current state of knowledge.

> **Update — re-measured at [DR-0020]'s `FIFO_DEPTH = 2` (issue [#255]).**
> The table above is the `FIFO_DEPTH = 8` measurement ([#111], `sim/records/
> 2026-08-17-digital-sta-power-*`) and is left as written, for the same
> reason [DR-0019]'s own estimate table above is. Issue [#255]
> re-synthesized and re-placed-and-routed the digital section at the new,
> ratified depth — `design/trng_top/trng_top.synth.v`,
> `layout/digital/trng_top.gds`/`.def`/`.pnr.v`/`.sdf` are now all
> `FIFO_DEPTH = 2` artefacts, LVS-matched against their own as-built
> netlist (`layout/digital/reports/lvs.json`: `status: match`,
> `mismatch_count: 0`) — and re-ran the fifteen-corner sweep this table's
> figure is drawn from (`sim/records/2026-09-19-digital-sta-power-*`,
> `sim/characterization-digital-sta-area-power.md` §0):
>
> | | cell area | cells | library |
> |---|---:|---:|---|
> | This table's estimate, now at `FIFO_DEPTH = 2` (`reports/area.json`, region `digital`) | 33 654.6 µm² | 863 inventoried | `mcu7t5v0` (7-track) |
> | Measured, placed ([#255]) | **59 465.1 µm²** | 1458 logical + 2978 tapcell/endcap/filler = 4436 DEF `COMPONENTS` | `mcu9t5v0` (9-track) |
> | | **×1.767** | — | |
>
> **This replaces the *measurement* side of the comparison, not the
> `digital` region's own guarded footprint in `reports/area.json`.** Since
> issues [#209]/[#210] that footprint is sized from `layout/digital/
> trng_top.gds`'s own real bbox via `klt stats` — and this issue committed a
> new, smaller `trng_top.gds` without re-running that composition step,
> which is the sibling issue [#256]'s job (additionally gated on
> [DR-0026]'s klt-build question). Before [#256] landed (it has since: 400.93 µm guarded, 351.6 %, 934.4 × 416.7 µm row), every *composed*
> figure elsewhere in this document — the 548.815 µm guarded-footprint
> figure, the 642.9 % `share_of_budget_pct`, the 1070.4 × 550.8 µm composed
> row bbox — still describes the depth-8 `trng_top.gds` that
> `reports/area.json` was actually measured from, now stale relative to
> the depth-2 GDS this update names. The 59 465.1 µm² cell-area figure above
> is real and current; the composed floorplan figures that depend on the
> GDS's own bounding box are not, until [#256] re-runs `klt stats` against
> it.
>
> *Later correction:* the 59 465.1 µm² figure in that table is no longer
> current either. Two later rebuilds of the digital section moved it. #264
> re-tuned `max_transition_ns` and rebuilt, giving 61 692.0 µm² (×1.833).
> #293 re-ran place-and-route on #292's re-baselined netlist, giving
> **62 081.5 µm² (×1.845)** from `sim/records/2026-10-07-digital-sta-power-*`.
> See `sim/characterization-digital-sta-area-power.md` §0a/§0b. The die moved
> too, from 398.895 µm to 398.93 µm square. That is another
> `trng_top.gds` bbox change that [#256]'s composition re-run will pick up.

The other three regions are unaffected: they are analog cells with no
synthesis path, drawn by hand, and `ring1`/`ring2`/`combiner_sampler` already
take their guarded footprints from committed assembled geometry rather than
from this estimate.

### What the area model is

A **bottom-up inventory estimate with a stated method**, not a synthesis result
and not a layout. No synthesiser, placer or router has been run on **the analog
cells** in this block, and none of them has been drawn from this model; the
digital region *has* been synthesized and placed since this model was written
(see the section above), and this model's own digital row is retained as the
pre-synthesis prediction it was.

- Gate-shaped cells (`ro_stage`'s core inverter, `ro_nand2`, `xor2`,
  `sampler_dff`) are priced at their nearest `gf180mcu_fd_sc_mcu7t5v0`
  equivalent's LEF area — the same method, and the same library, that
  [DR-0008]'s conditioner figure uses. That library is 7-track and uses wider
  devices than these hand-drawn minimum-width cells, so it **over-estimates**
  the analog side: the conservative direction.
- The series starve devices (`L` = 2 µm) have no standard-cell analogue and are
  priced at a real generated footprint from `klt gen mos_array`, DRC-checked in
  the same run (2.386 µm² n, 3.580 µm² p — up from 1.193/2.261 µm² in an
  earlier run of this script against an older `klt` build; this generator's
  own output is not pinned to a `klt` version, see
  [klayout-tools#623][kt623]). They are generated at `W` = 0.42 µm rather than
  their drawn 0.220 / 0.240 µm because the generator will not go narrower (see
  [Tool friction](#tool-friction)), which over-estimates them too.
- The digital side reuses the cell inventories
  `design/digital_power_estimate.py` already maintains — one copy of that list
  in the repository, already guarded by `sim/tests/test_power_rollups.py`.
- Placement utilisation is reported at both 60 % and 80 %, per [DR-0008]'s
  convention; the floorplan geometry is built at 60 %.
- **`ring1`/`ring2`/`combiner_sampler`'s guarded footprint is not from this
  model.** Every other region's guarded footprint is sized from this
  section's own sqrt(cell_area / utilisation) square, same as always —
  `ring1`/`ring2` (issue #119) and `combiner_sampler` (issue #135) are the
  exceptions: once each had committed, DRC-clean, LVS-matching assembled
  geometry, its real bounding box (read from the committed GDS via
  `klt stats`) replaced the square estimate for that region only.
    - `ring1`/`ring2`: `layout/rings/ro_ring11/` (#110/#120) and
      `layout/rings/ro_ring11_ring2/` (#118), real bbox **78.9 × 4.75 µm**
      each — the estimate would have given 19.37 × 19.37 µm each, a
      footprint the real row does not remotely fit inside.
    - `combiner_sampler`: `layout/blocks/combiner_sampler/` (#134), real
      bbox **278.90 × 15.64 µm** — the estimate would have given
      23.89 × 23.89 µm, roughly 11× narrower than the real assembled row.
    - `digital`: `layout/digital/trng_top.gds` (#170/#171, placed and
      composed into this floorplan by #209/#210), real bbox
      **548.815 × 548.815 µm** — the estimate would have given
      352.34 × 352.34 µm, the largest size delta of the four (roughly the
      same order of magnitude #119 found for `ring1`/`ring2`, just larger,
      as #209 anticipated).

  (See `region.footprint_source` in [`reports/area.json`](reports/area.json)
  for the exact numbers and which regions use which method.) Each region's
  *guarded* (outer) footprint is still sized from that same real bbox
  (**80.9 × 6.75 µm** guarded for each ring, **280.9 × 17.64 µm** guarded for
  `combiner_sampler`, `GUARD_RING_WIDTH_UM` = 1.0 µm in on every side) —
  issue #110's own placement clearance (below), extended to `combiner_sampler`
  by issue #135, only changes how that 1.0 µm is split between guard-ring
  material and clear silicon, not the region's own outer size, so
  `region.inner_w_um`/`inner_h_um` in `reports/area.json` now read
  **79.71 × 5.55 µm** (each ring) / **279.70 × 16.44 µm**
  (`combiner_sampler`) — real bbox **+ 2 ×** `RING_PLACEMENT_CLEARANCE_UM` —
  while `guarded_w_um`/`guarded_h_um` are unchanged by that split. `digital`
  is sized the same way as of #209/#210: from `layout/digital/
  trng_top.gds`'s own real bbox. As regenerated in #256 (depth-2 P&R,
  klt 0.6.0): inner cavity **399.73 × 399.73 µm**, guarded
  **400.93 × 400.93 µm** (it was 549.615 / 550.815 µm at depth 8).
- `layout/floorplan/floorplan.py` also checks that the real assembled
  geometry actually *fits* inside the region it now sizes: it composes each
  such region's guard ring with the real assembled GDS and runs `klt drc`
  **and** `klt lvs` over the pair, comparing the DRC result against that
  GDS's own standalone DRC so a violation introduced by the fit is
  distinguishable from one already present in the assembled geometry on its
  own. All four regions (`ring1`, `ring2`, `combiner_sampler`, `digital`)
  fit DRC-clean-relative-to-baseline and LVS-match today — see
  [`reports/ring_fit.json`](reports/ring_fit.json),
  [Placement](#placement--issue-110) below for why this is no longer a
  *zero*-clearance fit and what changed,
  [Placement — issue #135](#placement--issue-135-combiner_sampler) for
  `combiner_sampler`'s own placement, and #209/#210 for `digital`'s own
  placement (its LVS step compares an abstracted, cell-instance-
  granularity extraction against `layout/digital/trng_top.lvs_reference.
  spice`, not a flat transistor-level one -- see `layout/floorplan/
  floorplan.py`'s own `RING_LVS_ABSTRACT_CELLS` docstring for why `digital`
  needs that and the other three do not). (This regeneration's own
  standalone DRC for `ring1`/`ring2`/`combiner_sampler` is clean — 0
  violations — not the 49-per-ring pre-existing count issue #110 recorded:
  see [Tool friction](#tool-friction) for why that count is gone.)
- The composed abstract's row bounding box is **934.4 × 416.7 µm** as of #256 (it was 1070.4 × 550.8 µm at depth 8; up
  from 857.1 × 354.3 µm before #209/#210 placed `digital`'s own real,
  much larger row into the composition — both the width, from the new
  `combiner_sampler` | `digital` channel and `digital`'s own 549 µm-wide
  row, and the height, from `digital`'s own 549 µm-tall row exceeding
  every other region's). That is the
  tool's one-dimensional arrangement, not a packing proposal — the composer
  supports row placement only. The area figures above are region footprints
  plus channels, which do not depend on that arrangement.

One term is deliberately **excluded**: the DR-0016 ring-liveness monitor
(85 cells, 2 849.4 µm²) is shipped RTL as of #71, but
`design/digital_power_estimate.BLOCKS` still carries it as `shipped=False`. The
script reports exactly what that inventory declares and prices the monitor
separately rather than silently including or dropping it. Reconciling the flag
belongs with whoever owns that inventory.

## Floorplan levers toward the `< 0.05 mm²` row — issue #710

Child of #700, whose operator ruling keeps the Area row. This section records
what the floorplan's own levers reach at `FIFO_DEPTH = 2`. **No committed
geometry or report was changed**; everything below was measured on scratch
copies (see "How this was run").

### Re-baseline: which utilisation applies

- The `digital` region is **not** sized by the `60 %` / `80 %` estimate any
  more. Its guarded footprint is the routed P&R die from
  `layout/digital/trng_top.gds` plus the 2 µm guard (400.93 µm square), and
  that die is a *consequence* of `FLOORPLAN["utilization_pct"]` in
  `layout/digital/build.py` (40 % requested, 43.4 % achieved). The `60 %` /
  `80 %` rows in `reports/area.json` (`placed_area_um2`) and in DR-0019 are
  the older estimate and no longer size anything.
- A fresh `floorplan.py` run on `main` @ `18d24d1` reports
  `floorplan_area_um2 = 176 223.3 µm²` (352.4 % of the row) against the
  committed `175 789.86 µm²` (351.6 %). The committed `area.json`,
  `compose.json`, `floorplan.drc.json`, `ring_fit.json`, `interregion.json`
  and `trng_floorplan.gds` all fail `floorplan.py`'s regeneration check on
  this host. That drift (0.25 %) is not investigated or fixed here.

### Utilisation sweep (P&R request → composed floorplan)

Area is geometry, so it is independent of PVT corner. Each row is one
serial `klt place-and-route` run at `ss_125C_3v00`, seed and constraints as in
`build.py`, then one `floorplan.py` composition over that run's DEF and GDS.

| Requested util. | Achieved util. | Die µm² | Placed area µm² (util × core) | Digital guarded µm² | Floorplan µm² | % of row | Route DRC / antenna |
|---:|---:|---:|---:|---:|---:|---:|---|
| 40 (committed) | 43.4 | 159 145 | 62 081 | 160 745 | 176 223 (fresh) | 352.4 | 0 / 0 |
| 55 | 59.8 | 117 755 | 62 268 | 119 353 | 133 459 | 266.9 | 0 / 0 |
| 70 | 76.0 | 93 908 | 61 415 | 95 336 | 108 708 | 217.4 | 0 / 0 |
| 85 | 91.4 | 78 369 | 61 020 | 79 674 | **92 516** | **185.0** | 0 / 0 |

Placed area (the cell area OpenROAD reports in the core, including
tapcells and endcaps, excluding fillers) is flat at ≈ 61–62 k µm² across the
sweep. It matches the 62 081.5 µm² recorded above for #293. The composed row
also stayed DRC-clean relative to each region's standalone DRC (0 new
violations) at every point.

### What limits it

1. **Cell area, not the floorplan, is the floor.** Placed area is
   ≈ 61 k µm², above the 50 000 µm² budget before any die margin, guard ring,
   isolation channel or analog region is added. Even 100 % utilisation with no
   margin cannot reach the row. Extrapolating the sweep (derived, not run): a
   100 % point would be a ≈ 271 µm die and ≈ 86 k µm² composed (≈ 172 %).
   With the analog side fixed at 7 026 µm² (14.05 %), the digital region plus
   its channel would have to fit in ≈ 43 k µm², i.e. placed cell area roughly
   35–40 % below today's, before any utilisation headroom. That is #709's
   territory (inventory), not a floorplan lever.
2. **Routing did not limit at 91.4 % achieved.** All three swept points routed
   with 0 route-DRC and 0 antenna violations and met setup/hold at
   `ss_125C_3v00` (`worst_slack_ns` 31.4 / 32.4 / 32.1). Where routing congestion
   starts was not found; no point above 85 % requested was run.
3. **Isolation channel.** The 20 µm channel against the digital neighbour
   falls from 8 018 µm² (committed) to 5 645 µm² at the 85 % point. It is
   ≈ 6 % of the row, so shrinking the channel itself is worth little and was
   not changed (`ISOLATION_CHANNEL_UM` stays 20 µm; no isolation analysis
   supports a change).
4. **Latch-up tap spacing (#449, #487) is the open constraint on the high
   utilisation points.** `layout/digital/reports/tap-distance.json` (committed
   40 % layout, 265 tapcells at `-distance 100`) fails LU.3 and LU.4 against the
   15 µm MV column: max 49.7 µm, with 18 598 µm of NCOMP boundary uncovered
   at 15 µm. The sweep points above use the same tap pitch and so inherit that
   failure. `tap_distance.py` was **not** run on the swept layouts, and a
   tighter pitch (more tapcells) was not measured, so the area cost of
   meeting the rule is unknown. Whether the rule applies is #449; the pitch
   default is #487.
5. **Timing-repair noise is unrelated to utilisation.** `max_transition`
   violation counts (668 / 702 / 688 against 660 committed, all at the
   `ss_*_1v62` corners) do not trend with utilisation.

### Outcome

The floorplan levers alone reach **185 %** of the row at best (85 % requested,
91.4 % achieved), and no floorplan lever can reach 100 % because the placed
cell area already exceeds the budget. The combined measurement with #709's
inventory options was not run because none has landed. Whether to keep the row
unchanged and rely on #709 or to bring the row back for a decision is
#700's call; this issue does not edit the row.

### Re-run on the #709 inventory (issue #710, follow-up)

#709 has landed (`main` @ `dcd219c`), so the sweep above was repeated on the
committed post-#709 inventory. Same method as "How this was run"; nothing
committed was changed. Area is geometry and does not vary with PVT corner;
the P&R run is at `ss_125C_3v00`. The committed `area.json` records
173 157.92 µm² (346.3 %); a fresh `floorplan.py` composition of the committed
inputs gives 173 589.3 µm² (347.2 %), the same ≈ 0.25 % regeneration drift
noted above (not investigated here).

| Requested util. | Achieved util. | Die µm² | Placed area µm² (util × core) | Digital guarded µm² | Floorplan µm² | % of row | Route DRC / antenna | Setup / hold viol. | Digital LVS mismatches |
|---:|---:|---:|---:|---:|---:|---:|---|---|---:|
| 40 (committed) | 43.4 | 156 590 | 60 744 | 158 432 | 173 589 (fresh) | 347.2 | 0 / 0 | 0 / 0 | 0 |
| 70 | 75.1 | 92 425 | 60 191 | 93 841 | 107 165 | 214.3 | 0 / 0 | 0 / 0 | 6 |
| 85 | 90.4 | 77 140 | 59 863 | 78 434 | **91 232** | **182.5** | 0 / 0 | 0 / 0 | 7 |

Wall-clock per P&R point was 488 s, 690 s and 897 s. The 55 % point was
skipped: the 40/70/85 points already bracket the trend of the previous sweep.

What changed against the `FIFO_DEPTH = 2` sweep (`main` @ `18d24d1`, 185.0 %
best): placed area fell only from ≈ 61–62 k to ≈ 60–61 k µm² (about 2 %), and
the best floorplan point from 92 516 to 91 232 µm² (185.0 % → 182.5 %). The
inventory change moves the cell-area floor by far less than the roughly half
that the row needs.

**Limits, with evidence**

1. **Cell area is still the floor.** Placed area is ≈ 59.9 k µm² at the best
   point, above the 50 000 µm² budget before die margin, guard ring,
   isolation channel or the 7 196.8 µm² analog side are added. With the
   analog side fixed, the digital region plus its 20 µm channel would have to
   fit in ≈ 42.8 k µm², i.e. a guarded side of ≈ 197 µm against 280 µm at the
   85 % point. Derived, not run: that is a placed area near 31 k µm² at 100 %
   utilisation, about half of today's.
2. **Routing did not limit at 90.4 % achieved.** All three points routed with
   0 route-DRC and 0 antenna violations and met setup and hold
   (`worst_slack_ns` 32.9 / 33.2 / 33.1). Where congestion starts was not
   found; no point above 85 % requested was run.
3. **Composed digital LVS is clean at 40 % and reports mismatches at 70 % and
   85 %.** `floorplan.py` prints `lvs match (0 mismatches)` for the digital
   region at 40 % and `lvs mismatch (6 mismatches, unexpected categories:
   none)` / `(7 mismatches, ...)` at 70 % / 85 %. The mismatches were not
   diagnosed, so a high-utilisation layout is not shown to be LVS-clean in the
   composed floorplan. Composed digital DRC introduced 0 new violations at all
   three points (ring alone: 2 769 / 2 728 / 2 628 pre-existing).
4. **Latch-up tap spacing (#449, #487) is unchanged and unresolved.**
   `tap_distance.py` was run on the 70 % and 85 % layouts this time: both
   fail LU.3 (max 49.691 µm) and LU.4 (max 49.727 µm) against the 15 µm MV
   limit, the same maxima as the committed 40 % layout, because the tapcell
   pitch (`-distance 100`) does not change with utilisation. The area cost of
   meeting the rule is still unmeasured (a tighter pitch was not run). The
   rule's applicability is #449 and the pitch default is #487.
5. **Isolation channel** stays ≈ 5.6 k µm² of the 85 % point (≈ 11 % of the
   row); `ISOLATION_CHANNEL_UM` was not changed, as no isolation analysis
   supports it.

**Outcome.** Floorplan levers on the post-#709 inventory reach **182.5 %** of
the row at best, and no floorplan lever can reach 100 %. The combined
measurement is the one reported here; the result is input to #700, which
decides whether to keep the row or bring it back. This issue does not edit
the row.

### How this was run

`FLOORPLAN["utilization_pct"]` was overridden in memory and
`build.place_and_route()` called into a scratch directory, so `build.py`'s
committed outputs were never written. For each point the run's `trng_top.gds`
and `trng_top.def` were copied over the committed ones, `floorplan.py` run in
its default (non-`--write`) mode, and the committed files restored with
`git checkout`. `floorplan.py` needs the DEF as well as the GDS because
`interregion.py` reads the digital pin positions from the DEF's `PINS`
section; the checked-in tree has no supported way to compose against a
non-committed P&R result. Wall-clock per P&R point was 494 s (55 %), 705 s
(70 %) and 971 s (85 %) on a shared host.

---

## Placement — issue #110

`layout/rings/` ([#120][gf120], [#118][gf118]) assembled `ro_ring11` at both
sizings; issue #119 sized `ring1`/`ring2`'s guarded regions to those real,
committed bounding boxes instead of an area estimate. **What #119 explicitly
left open is what this section is about: actually placing the assembled ring
inside the region #119 sized for it.**

**The naive placement is a short, not just a stress test.** `ring1`/`ring2`'s
guarded-region inner cavity is sized to *exactly* each ring's own bbox
(#119), so the tightest — and, before this issue, only — placement puts the
ring's own drawn edge flush against the guard ring's inner wall on every
side, zero clearance. `layout/floorplan/floorplan.py`'s own `check_ring_fit`
already exercised exactly that placement as a DRC-only stress test for #119,
and it passed (0 new DRC violations). Extending the same check to `klt lvs`
— this issue's own test-plan requirement — found that DRC-clean is not the
same claim as connectivity-clean: `klt extract`'s own `merged_net_labels`
diagnostic reports the ring's own metal1 chain-signal wiring (which runs
right up to the row's own bbox edge — `layout/rings/ro_ring11/build.py`'s
`WRAP_TRACK`) shorting to `vss` once the guard ring's own p-substrate tap
diffusion sits flush against it. Two conductors on the same layer with zero
space between them are one net to a polygon-based extractor, guard ring or
not — the curated DRC deck simply has no rule that catches "this spacing is
zero" as a violation in a composed stream the way it would inside a single
generator's own output. `klt gen guard_ring`'s own response already names
the number that would have caught it: `drc_hints.min_spacing_um` is 0.4 µm
for this deck regardless of `ring_width_um` — `gen-compose` does not consult
it, which is filed generically against the tool as
[klayout-tools#692][kt692].

**The fix keeps the region's own committed outer footprint unchanged.**
`RING_PLACEMENT_CLEARANCE_UM` (0.4 µm, cross-checked at run time against
`gen_guard_ring`'s own reported `drc_hints.min_spacing_um` rather than
trusted blind) is carved *out of* the guard ring's own band width, not added
on top of the region's reserved area: the guard ring's inner cavity grows by
`2 × RING_PLACEMENT_CLEARANCE_UM` and its own `ring_width_um` shrinks by
`RING_PLACEMENT_CLEARANCE_UM` on each side, and the two exactly cancel
(`ring_band_width_um + RING_PLACEMENT_CLEARANCE_UM == GUARD_RING_WIDTH_UM`,
always) — `ring1`/`ring2`'s `guarded_w_um`/`guarded_h_um` in
[`reports/area.json`](reports/area.json) are byte-identical to what issue
#119 already committed. Only `inner_w_um`/`inner_h_um` (the cavity) and the
new `ring_band_width_um`/`ring_placement_clearance_um` fields change. At
that clearance, both rings compose DRC-clean-relative-to-baseline (0 new
violations vs. each ring's own standalone DRC) **and** `klt lvs`-match
`RING_LVS_REFERENCE` — the same reference netlist
[`layout/verify.py`](../verify.py) already uses for each ring standalone,
modulo only the same two deck-level disclosures (`device.body_unverified`,
`topology`) every other entry in this repository already carries. Verbatim
results: [`reports/ring_fit.json`](reports/ring_fit.json).

**The composed abstract now places real content, not just guard rings.**
`compose()` uses `placement.strategy: "explicit"` (#330) for every block —
`ring1`/`ring2`/`combiner_sampler`/`digital`'s own guard rings at the same
absolute origins `strategy: "row"` used to compute (so every region and
channel lands exactly where each region's own committed numbers already put
it), plus one more block each for `ring1`/`ring2`: the real assembled
`ro_ring11`/`ro_ring11_ring2` geometry, translated to
`(region's row offset + GUARD_RING_WIDTH_UM − ring bbox x0/y0)` — the same
"flush against the guard ring's own declared inner corner" formula
`check_ring_fit` already verifies clean, since `ring_band_width_um +
RING_PLACEMENT_CLEARANCE_UM == GUARD_RING_WIDTH_UM` makes that absolute
position independent of the clearance/band-width split. Issue #135 gives
`combiner_sampler` the same treatment, its own real assembled
`combiner_sampler.gds` content placed the same way — see
[Placement — issue #135](#placement--issue-135-combiner_sampler) below.
`digital` alone stayed an empty guard ring here — no digital-section
placement was in scope for either issue (that came later, #209/#210, once
the digital section itself existed to place -- see [What the area model
is](#what-the-area-model-is) above).

**No common-centroid pairing, verified, not just avoided by construction.**
`layout/floorplan/README.md`'s own [Mechanism 1](#mechanism-1--mutual-injection-locking-between-the-rings)
requires `ring1`/`ring2` to stay two separate, unmatched, individually
guarded blocks — no shared dummy row, no shared well, no interdigitation.
Nothing in this placement path is capable of doing any of those things:
`klt gen guard_ring` has no `topology` parameter to default away from (that
risk is specific to `klt gen`'s matched-pair generators, `diff_pair`/
`mos_array`, neither of which this placement calls), each ring gets its own
independent `gen_guard_ring` invocation (visible in the composed stream's
own structure names — four distinct `guard_ring`/`guard_ring$1`/
`guard_ring$2`/`guard_ring$3` instances, one per region, never reused across
regions), and each ring's own content is a separate top-level block with its
own row offset, 100.91 µm apart, comfortably outside the 20 µm channel.
Checked, not just argued: `klt extract` over the full composed
`trng_floorplan.gds` reports exactly 92 devices (46 + 46, one ring's own
device count each) and 97 nets, with `merged_net_labels` showing only the
expected within-ring `a,y` chain merges (nine per ring, the same "`y`→`a`"
same-net-label pattern `layout/rings/ro_ring11/build.py`'s own wiring
produces) — no net, and no device, spans both rings' own structures.

---

## Placement — issue #135 (`combiner_sampler`)

`layout/blocks/combiner_sampler/` (issue #134) assembled `xor2` + 4 ×
`sampler_dff` into a single, DRC-clean, LVS-matching row — but, unlike
`ring1`/`ring2`, that row is not two roughly-square rings; it is a single
5-cell row measuring **278.90 × 15.64 µm**, about 11× the width of the
region's prior area/utilisation-estimate square (23.27 × 23.27 µm). The
mismatch is exactly the same shape #119 found for `ring1`/`ring2` — an area
*estimate*, written before any cell existed to place, versus the real
geometry a hand-drawn, row-assembled block actually has once it exists — so
issue #135 resolved it the same way: `combiner_sampler` was added to
`floorplan.py`'s `ASSEMBLED_RING_GDS`/`RING_LVS_REFERENCE` machinery (issue
#110's own generalisation of `check_ring_fit`/`compose` to a non-ring
assembled block, anticipated but not exercised until now), sizing the
region's guarded footprint from `combiner_sampler.gds`'s own real bounding
box instead of the estimate.

**Same clearance mechanism, same result.** `RING_PLACEMENT_CLEARANCE_UM`
(0.4 µm) applies to `combiner_sampler` exactly as it does to `ring1`/`ring2`
— carved out of the guard ring's own band width, not added on top of the
region's reserved outer footprint (**280.90 × 17.64 µm** guarded, real bbox
**+ 2 ×** `GUARD_RING_WIDTH_UM`) — because the same zero-clearance short
issue #110 found for the rings' own metal1 chain wiring is a generic risk of
placing any real geometry flush against a guard ring's p+ tap diffusion, not
something specific to `ro_ring11`'s own layout. At that clearance,
`combiner_sampler` composes DRC-clean-relative-to-baseline (0 new violations
against its own standalone DRC) **and** `klt lvs`-matches
`RING_LVS_REFERENCE`'s `combiner_sampler.spice` reference — the same
reference `layout/verify.py` already uses for this block standalone, modulo
only the same two deck-level disclosures (`device.body_unverified`,
`topology`) every other entry in this repository already carries. Verbatim
result: [`reports/ring_fit.json`](reports/ring_fit.json)'s own
`combiner_sampler` entry (3 mismatches, all in the allowed categories, 100
devices and 54 nets all matched).

**The row reshapes, not just one region's square.** `combiner_sampler` sits
between `ring2` and `digital` in the composed row (see
[The regions](#the-regions) above), so widening it by roughly 255 µm moves
`digital`'s own row offset by the same amount and grows the composed
abstract's own row bounding box from 601.4 × 354.3 µm to
**857.1 × 354.3 µm**. The `ring2`|`combiner_sampler` channel's own area
*shrinks* (505.4 → 352.8 µm²) because the real row is shorter
(15.64 µm) than the estimate square was tall (23.27 µm), even though the
region widened enormously — a channel is priced by height, not width, so a
region that gets wider but shorter can cost *less* channel area even while
its own guarded footprint grows by more than 4 000 µm². See
[Area against the `< 0.05 mm²` row](#area-against-the--005-mm-row) above for
the full before/after area rollup this resize produces.

**What this does not do.** It does not place anything inside the `digital`
region, and it does not change `combiner_sampler`'s own internal
connectivity or cell content (`layout/blocks/combiner_sampler/build.py` is
untouched by this issue) — only where the floorplan reserves space for the
block it already assembled.

---

## Planned inter-region connectivity — issue #221

Every region above is placed, but **nothing is wired between them yet.**
`compose()` draws four guard rings and, for `ring1`/`ring2`/
`combiner_sampler`/`digital`, each one's own real assembled content — and
stops there. The block cannot function without a wire from `ring1.ro` to
`combiner_sampler.rn1`, from the sample clock to `combiner_sampler.clk`, from
each region's own supply pin to a pad, and so on, and none of those wires
exist in the composed GDS today.

This section is the write-up for **phase 1** of issue #219's own two-phase
decomposition (issue #221): a *declared, reviewable* net list — as Python
data, not yet drawn geometry — of every net that has to cross a region
boundary, plus a generated top-level LVS reference netlist built from that
declaration. **Nothing below is drawn, routed, DRC'd or LVS'd.** The
physical routing geometry, the resulting `klt extract --top trng_floorplan`
pin-count change (still ~2588 today, unaffected by this section — see
[#219](https://github.com/2AMLogic/gf180-trng/issues/219)'s own finding),
and running `klt lvs` against the generated reference are **phase 2's
work, a separate follow-up issue**, not done here.

The full declaration, with every net's role, its `(region, pin)` endpoints
(each region's own already-committed reference pin name, never a name
invented here), a target metal-layer *role*, and the rationale tying it to
Mechanism 1/2/3 above, lives in
[`design/floorplan_netlist.py`](../../design/floorplan_netlist.py)'s own
`INTER_REGION_NETS`. `python3 design/floorplan_netlist.py` self-checks that
declaration against the four regions' own committed reference `.spice`
files (`layout/rings/ro_ring11/ro_ring11.spice`, `layout/rings/
ro_ring11_ring2/ro_ring11_ring2.spice`, `layout/blocks/combiner_sampler/
combiner_sampler.spice`, `layout/digital/trng_top.lvs_reference.spice`),
stdlib-only, no `klt`/PDK needed (`npm run check:floorplan-netlist`, run on
every push/PR); `--write` regenerates the composed reference at
[`trng_floorplan.lvs_reference.spice`](trng_floorplan.lvs_reference.spice).

**The declared nets** (`npm run check:floorplan-netlist` prints how many),
condensed from the module's own table (supply/ground first, since they are
the constraint most likely to be gotten wrong):

| net | crosses | layer role | why |
|---|---|---|---|
| `vddr1` | chip pin → `ring1.vddr` | Metal2 | own star branch (Mechanism 2) |
| `vddr2` | chip pin → `ring2.vddr` | Metal2 | own star branch |
| `vdd` | chip pin → `combiner_sampler.vdd` | Metal2 | own star branch, also feeds the two DR-0018 `ro_buf` instances |
| `vddd` | chip pin → `digital.vddd`, a real `.SUBCKT trng_top` pin since [#224](https://github.com/2AMLogic/gf180-trng/issues/224) | Metal5 PDN strap | own star branch; the tie docks onto the east end of the lowest of `digital`'s own Metal5 PDN straps (`digital_pdn_strap_bands`) — see `interregion.py`'s own "The `digital` PDN tie" docstring section |
| `vss` | shared return: `ring1`/`ring2`/`combiner_sampler`/`digital`'s own `vss` pins — all four real `.SUBCKT` pins since #224 | Metal5 PDN strap | the one deliberately shared net (Mechanism 2); its `digital` end docks onto a PDN strap the same way `vddd`'s does |
| `en1` / `en2` | chip pin → `ring1.en` / `ring2.en` | Metal1 | ring enable, no fan-out |
| `ro1` | `ring1.ro` → `combiner_sampler.rn1`, **spans `ring2`'s own region** | Metal2 | entropy tap; the one long-haul route in this table — see below |
| `ro2` | `ring2.ro` → `combiner_sampler.rn2` | Metal1 | entropy tap, single adjacent channel |
| `clk` | chip pin → `digital.clk` → `combiner_sampler.clk` | Metal4 transition | Mechanism 1's worst-disturbance case (DR-0012-clock); routed via `digital` so it never crosses a ring's own channel |
| `rst_n` | chip pin → `digital.rst_n` → `combiner_sampler.rst_n` | Metal4 transition | same topology as `clk` |
| `raw_bit` / `raw_valid` | `combiner_sampler` → `digital` | Metal4 transition | raw sampler tap |
| `ring_bit1` / `ring_bit2` | `combiner_sampler` → `digital` (`ring_bit[0]` / `ring_bit[1]` on the digital side — the two committed references spell this pin differently, resolved here rather than by renaming either) | Metal4 transition | DR-0016 per-ring liveness taps |

**The four supply branches must never merge before a star point.**
`vddr1`, `vddr2`, `vdd` and `vddd` are declared as four separate, disjoint
net entries — `design/floorplan_netlist.py`'s own module docstring carries
an explicit "DO NOT MERGE" comment immediately above them, and
`validate_inter_region_nets()` asserts mechanically, on every run, that no
two of the four reach the same region. This is the same constraint
[Mechanism 1](#mechanism-1--mutual-injection-locking-between-the-rings)
item 2 and [Mechanism 2](#mechanism-2--supply-and-substrate-coupling) item 1
already state in prose; phase 2 must route four textually and
topologically distinct rails all the way to a (not-yet-drawn) star point,
never one merged `vdd_all`-style strap.

**The one long-haul route.** The composed row order is `ring1 | ring2 |
combiner_sampler | digital` (see [The regions](#the-regions) above), so
`ring1.ro → combiner_sampler.rn1` is not a single-channel hop: `ring1` and
`combiner_sampler` are not adjacent, and the route has to cross, or route
around in the channel space, `ring2`'s own guarded region. Every other
inter-region net connects only adjacent regions.
`design/floorplan_netlist.py` records this in the net's own
`spans_regions` field (`["ring2"]`) rather than leaving phase 2 to
re-discover it by re-reading the row order.

**The `digital` region's Metal4 transition.** `digital`'s own real, routed
pins (`clk`, `rst_n`, `raw_bit`, `raw_valid`, `ring_bit[0]`, `ring_bit[1]`)
all land on Metal4 (`layout/digital/trng_top.def`'s `PINS` section, `+
LAYER Metal4`) — several routing-metal levels above where `ring1`/`ring2`/
`combiner_sampler`'s own content lives (Metal1 signal, Metal2+Via1 supply,
the same convention `layout/rings/ro_ring11/build.py` documents for
*intra*-ring wiring, extended here to *inter*-region). Reaching them needs a
hand-drawn Metal4-to-lower-metal via-stack transition. Separately worth
flagging for phase 2: `klt gen-compose`'s own routing-role map for the
`gf180mcu` family (`klayout_tools.gen._PDK_ROLE_LAYERS["gf180mcu"]`, as
installed — `klt 0.4.0+g3fbb4478e301`) only defines roles up to `"metal3"`/
`"via2"`, with no `"metal4"`/`"via3"` role at all, so `gen-compose`'s own
auto-router structurally cannot resolve a route directly onto one of
`digital`'s real pins today — filed generically upstream as
[klayout-tools#1670](https://github.com/2AMLogic/klayout-tools/issues/1670).
Phase 2 will need either that upstream fix or a hand-drawn transition stub;
this declaration does not depend on which, and records only the `layer_
role` each affected net needs once decided.

**What this section did not claim** (and what has since changed — see
[the next section](#inter-region-routing--issue-222), which draws it). At
the time this section was written no pin count changed as a result of it
(`klt extract --top trng_floorplan` was still ~2588 pins, unaffected — the
composed GDS itself had not moved). No routing geometry existed. No DRC or
LVS had run against the generated composed reference — `layout/floorplan/
trng_floorplan.lvs_reference.spice` was written and self-checked for
*declaration* consistency (every endpoint names a real pin on its region),
not yet verified against any drawn wiring, because there was none yet to
verify against. #219's own "~12-pin block" phrase (predating `digital`'s
real ~109-pin interface landing in the floorplan, #209/#210) is stale and
should not be treated as a target — a correctly-wired `trng_floorplan`
composed reference reports on the order of 110-115 top-level pins (the
generated file's own header, at the time of writing, has 112: `digital`'s
own 109 committed pins, minus the six absorbed into inter-region nets
(`clk`, `rst_n`, `raw_bit`, `raw_valid`, `ring_bit[0]`, `ring_bit[1]`),
plus the nine genuinely external nets (`en1`, `en2`, `vddr1`, `vddr2`,
`vdd`, `vddd`, `vss`, `clk`, `rst_n` — the last two counted once each, not
twice, since they are both inter-region *and* chip pins)), not the real
composed GDS's own pin count, which this section does not change.

---

## Inter-region routing — issue #222

Phase 2 of [#219]: the nets the section above *declares* are now **drawn**.
`compose()` places one more block alongside the four guard rings and their
content — `trng_interregion`, real routing geometry generated by
[`interregion.py`](interregion.py) from the same
`design/floorplan_netlist.py` declaration, never from a second copy of the
net list. Fourteen nets are drawn; what was drawn, per net, is in
[`reports/interregion.json`](reports/interregion.json), which also carries
the extraction and LVS verdicts below.

### What crosses, on which layer

Every region in the composed floorplan sits at `y ≥ 0`, so the half-plane
*below* the analog strip is empty at every `x` across the whole block. That is where the
routing goes:

| | layer | runs |
|---|---|---|
| per-net trunk | **Metal4** | east–west, under the row, one lane per net at `y = −1.2 − 0.7·k` |
| per-endpoint riser | **Metal3** | north–south, from the trunk up to its own endpoint |
| endpoint via stack | Via1/Via2/Via3 + a Metal2 landing pad | only at the pin itself |
| top-edge `digital` pin (#315) | **Metal4** stub, **Metal5** track, **Metal3** flank riser | up from the pin, east above the guard ring, down the free east flank |

Two layers, not one, is the load-bearing part: because trunks are Metal4 and
risers are Metal3, a riser reaching a *deep* trunk crosses every shallower
net's trunk on a different layer instead of shorting to it. Neither layer is
used by `ring1`/`ring2` (Metal1 + Metal2 only) or by `combiner_sampler`
(Metal1/Metal2/Metal3, all of it above `y = 0`), and `digital`'s own
Metal3/Metal4 is likewise all at `y ≥ 0`.

### Why it does not defeat the isolation channel

The 20 µm channel is a **routing-derived floor, not a coupling-derived one**
(see [`ISOLATION_CHANNEL_UM`](floorplan.py)'s own note and "What this
floorplan does not establish" below): it is what each supply domain needs to
reach its own region without sharing a channel with another domain's
straps. Routing *through* it is what it is for. What would defeat it is a
route that gave two regions a shared conductor they are not declared to
share, or that broke a guard ring. Neither happens here:

- **Every crossing is on Metal3/Metal4, never on Metal1** — the guard rings'
  own layer. Each tap loop stays geometrically and electrically continuous;
  no guard ring is cut, bridged, or tied to any drawn net. (Tying one to a
  region's `vss` would merge the extraction deck's own synthesized substrate
  handle into `vss`, which is precisely the kind of merge the composed LVS
  exists to catch. Since #705 there is no substrate net declared to route
  either: every cell draws its own tap.)
- **`ro1` never passes over `ring2` at all.** Phase 1 flagged it as the one
  long-haul route (`spans_regions: ["ring2"]`) and asked for Metal2 so it
  would not share Metal1 with `ring2`'s own chain wiring. It is routed under
  the row instead — outside `ring2`'s guarded area entirely, two routing
  levels above its topmost drawn layer. That is a documented deviation from
  the declared `layer_role`, and a strictly more conservative one; the same
  applies to every other net's `layer_role` (see
  [`interregion.py`](interregion.py)'s "Why this is not the layer phase 1
  named").
- **`clk`/`rst_n` still reach the samplers from the `digital` side.** Both
  trunks are pinned east of `combiner_sampler`'s own west edge and never
  enter a ring's isolation channel — DR-0012-clock's own constraint, which
  [`layout/tests/test_interregion.py`](../tests/test_interregion.py)
  asserts mechanically on every push.
- **No two drawn nets come within `metal3.space.1` (0.28 µm) of each other
  on the same layer.** That is arithmetic over the drawn rectangles, checked
  stdlib-only in CI by the same test file, and independently by `klt drc`
  over the composed stream.

### The supply/ground star point lands off-die

`vddr1`, `vddr2`, `vdd` and `vddd` each get their own trunk and their own
top-level pin, and no two of them share a conductor anywhere. Each supply's
chip pin is placed on its own trunk **directly beneath the region it
feeds**, so no supply branch runs under another region on its way in.

**The star point itself is off-die**, at the package/board level. This is a
deferral, stated as one rather than assumed: nothing in this floorplan
draws an on-die star node, and nothing in it prevents one later. What it
does guarantee is the property Mechanism 2 actually depends on — that the
four branches carry no shared series impedance anywhere on this die.
`vss` is the one deliberately shared return (phase 1's own net table), and
it is the one trunk that spans the row.

**Decision record ([#224](https://github.com/2AMLogic/gf180-trng/issues/224),
2026-09):** through issue #222, `vddd` was the one declared supply with **no
drawn wire at all**. Phase 1 declared its connection into `digital` under
`implicit_regions`, not `endpoints`, because
`layout/digital/trng_top.lvs_reference.spice` declared no `vddd` pin to wire
against (it was `SPECIALNETS`-only). The physical tie points were always
real and reachable (`trng_top.def`'s own `PINS` section carries `vddd` and
`vss` as Metal5 PDN straps), but drawing them against that reference would
have made the layout merge two nets the reference kept separate — so the LVS
this phase is held to would have failed on geometry that was *more*
correct, not less. The same reasoning applied to `digital`'s own `vss`
return.

**#224 resolved this on the reference side (chose "promote `vddd`/`vss` to
real `.SUBCKT trng_top` pins," not "leave the tie undrawn permanently"):**
`layout/digital/lvs.py` now reads the two supply net names out of the
committed `place_and_route.json`'s own `power` block and promotes both to
real top-level pins on both sides of `digital`'s own standalone LVS (see
that script's own module docstring's "`vddd`/`vss` are real top-level pins
too" section and [`layout/digital/README.md#lvs`](../digital/README.md#lvs)
for the re-run report). `design/floorplan_netlist.py` declares both as
ordinary `endpoints` of `digital` — the `implicit_regions` field is gone
entirely, because there is no longer a connection this module cannot
mechanically check against a real `.SUBCKT` pin. `layout/floorplan/
interregion.py` draws both ties (as first landed: a Metal3 riser inside the
`combiner_sampler | digital` isolation channel; redesigned for the stacked
arrangement by [#803], see [below](#the-stacked-arrangement-and-the-digital-supply-tie--issue-803)),
docking against the lowest of that net's own PDN-strap bands
(`digital_pdn_strap_bands`) — see that module's own "The `digital` PDN tie"
docstring section for why Metal5 specifically (it is the one layer nothing else this floorplan draws
uses, so the hop cannot collide with any other net's geometry). The
rejected alternative — leaving the tie undrawn and documenting it as
permanent — was judged defensible only for as long as this stays a
floorplan rather than something intended for tape-out, which this
repository's own stated goal (a working, verified TRNG block) already rules
out as the long-term answer.

With both ties now drawn, `vss` no longer promotes twice at the composed
`klt extract` step: `digital`'s own PDN ground is the *same* net as the
analog `vss` return now, not a same-labelled but electrically distinct one
(see `layout/floorplan/floorplan.py`'s own `DUPLICATE_PIN_NAME_PROMOTIONS`,
now empty). All four supply branches (`vddr1`/`vddr2`/`vdd`/`vddd`) stay
electrically separate up to their own not-yet-drawn star point — verified by
the same composed LVS run below finding no `net.merged` between any two of
them.

### The stacked arrangement and the `digital` supply tie — issue #803

`digital` is stacked above the analog strip: its guard ring starts one
`ISOLATION_CHANNEL_UM` above the tallest analog region (`_stack_origins` in
[`floorplan.py`](floorplan.py)), and its east edge is **derived**, not a
constant. `interregion.stack_digital_east_um` takes the least east edge at
which the first top-pin wrap column (`EAST_RISER_CLEAR_UM` east of
`digital`'s content) clears the eastmost `combiner_sampler` riser column
(`CS_CHANNEL_RISER_X`) by `metal3.space.1` plus a margin, so the two column
sets are separated by construction and changing either table re-derives it.
The derivation is unconditional, but the wrap column it reasons about only
exists when the run places signal pins on the top edge; the committed DEF
places all six on the bottom edge, so there is currently no wrap column to
clear and the bound is satisfied with room to spare (see
"**`clk`/`rst_n` and DR-0012-clock**" below).
[`docs/area-floorplan-arrangement-2026-11-09.md`](../../docs/area-floorplan-arrangement-2026-11-09.md)
measured that the same placement with a hand-picked overhang composes; here
the overhang is an output.

**The tie.** The single 0.30 µm Metal3 riser with one Via3 at each end was the
dominant term of the digital supply IR drop and lengthened with the stack. It
is replaced by one **2 µm wide Metal3 riser per net on the stack's east
flank**, east of every top-pin wrap column that exists
(`pdn_riser_x_local`; the committed bottom-edge placement has none, and
`test_pdn_risers_clear_every_wrap_column` ties the two together), landing
through a four-cut Via3 row on the Metal4 trunk and a 16-cut Via3 + 16-cut Via4
array on a Metal4 pad, and docking onto the **east end** of the net's lowest
Metal5 PDN strap with a Metal5 rectangle as tall as the strap. The digital
supply IR-drop bound ([`sim/characterization-digital-supply-ir-drop.md`](../../sim/characterization-digital-supply-ir-drop.md))
falls from 23.18 mV (side-by-side row, single cuts) to 6.38 mV against the
unchanged 33 mV yardstick; the stacked arrangement with the old single-cut
riser measured 69.0 mV.

**Isolation argument.** The risers run on the east flank, outside every
isolation channel: they cross no `ring1 | ring2` or
`ring2 | combiner_sampler` channel and pass no ring. Their nearest neighbours
are `combiner_sampler`'s own `vdd`/`vss` risers (on a different net but the
same side of the entropy rings) and `digital`'s own guard ring. The only
digital conductor above the analog strip is `digital` itself, 20 µm over it
behind its own tap ring; the Metal5 dock crosses only that guard ring, the
same layer-and-crossing the top-pin tracks already use. DRC and LVS do not see
isolation, so this is an argument, not a measurement: **no substrate-coupling
attenuation is claimed** for the vertical channel, any more than for the
horizontal ones.

**`clk`/`rst_n` and DR-0012-clock.** The rationale
`test_clk_and_rst_n_never_run_west_of_the_combiner_sampler_region` encodes is
that the sample clock reaches the samplers from the `digital` side, never
across a ring's isolation channel. It still holds — but the bound that
enforces it is `combiner_sampler`'s own **west** edge, not the strip's east
edge, and there is no wrap column in this picture at all. The committed DEF
places all six inter-region signal pins on `digital`'s **bottom** edge, so
both trunks drop straight into the `combiner_sampler | digital` channel
rather than wrapping the east flank: `reports/interregion.json` reports zero
endpoint `legs`, and the `digital` anchors are six `digital_pin` plus two
`digital_pdn_strap`, with no `digital_pin_top`. Measured on the committed
stream, `clk`'s digital-side riser sits at x = 270.63 µm against a
`combiner_sampler` west edge of 231.24 µm and an east edge of 297.9 µm — east
of the west edge, and west of the east edge.

`test_clk_and_rst_n_stay_clear_of_both_ring_channels` is what asserts this
mechanically, bounding the `digital`-side riser at `combiner_sampler`'s west
edge. **It replaced `test_clk_and_rst_n_stay_east_of_the_strip`, which
asserted the strictly stronger east-edge bound: [#866] loosened the assertion
deliberately** ([DR-0035]). The stronger bound held only because the previous
place-and-route run happened to put these pins on the top edge, where they
wrapped the east flank. [`build.py`](../digital/build.py) sends `place_pins`
no `io.pin_constraints`, so the edge is a property of the run rather than a
design input, and it has flipped before — [#315] was filed because an earlier
re-place-and-route moved these same pins from bottom to top. Against a
bottom-edge placement the east-edge assertion is unsatisfiable (270.63 µm <
297.9 µm), while the constraint this section documents — east of
`combiner_sampler`'s own west edge, out of both ring isolation channels — is
satisfied by either placement. Pinning the edge remains a live option, but it
needs an explicit `io.pin_constraints` and its own rationale rather than
being adopted as a side effect of a regeneration; [DR-0035] argues that
alternative and rejects taking it silently.

Consumers made stale by the new stream: the extracted full-chip PEX inputs
and the `sim/tb/*-extracted-fullchip` testbenches (not re-simulated; see
[`docs/area-floorplan-stacked-pdn-2026-11-09.md`](../../docs/area-floorplan-stacked-pdn-2026-11-09.md)).

### The shared `vss` return's IR-drop cost, measured — issue #234

The paragraph above states the *decision* (star the four supplies, share
`vss`); it did not, until now, cost what sharing `vss` actually does to each
region's own local ground reference. [Issue #234](https://github.com/2AMLogic/gf180-trng/issues/234)
answers that with a segmented resistance model derived from this module's
own drawn geometry (`interregion.wiring_plan()`, the same function
`compose()` calls, walked with the committed `reports/compose.json` and
`reports/area.json`) rather than the single lumped ~129 ohm [DR-0025]
already quotes for the whole trunk — the resistance model instead separates
*where along the trunk* each region taps in:

| Region | Segment to previous node (ohm) | Riser (ohm) |
|---|---:|---:|
| `combiner_sampler` (nearest the chip pin) | 0.900 | 8.310 |
| `ring2` | 97.806 | 3.696 |
| `ring1` (farthest) | 30.273 | 3.696 |

Combined with the two corners this repository already treats as binding for
analog power (`sim/characterization-startup-and-power-budget.md`), the
largest computed local-`vss` offset is **15.64 mV** (`ring1`, active corner
`ff`/−40 °C/3.63 V), and a deliberately conservative bound — all of that
corner's active current forced through `ring1` alone — still only reaches
**21.48 mV**, under 6.5 % of the ±10 % (330 mV) supply-corner spread this
design's own PVT sweep already runs. **Verdict: not material** — full
derivation, current-profile sourcing and the "does this move any ratified
row" question in
[`sim/characterization-vss-trunk-ir-drop.md`](../../sim/characterization-vss-trunk-ir-drop.md),
reproducible with `python3 sim/tools/vss_trunk_ir_drop.py`.

### What `klt extract` reports, and why

| | pins |
|---|---|
| unrouted floorplan, no declared interface (`klt extract --top trng_floorplan`) | **2588** |
| composed reference's own `.SUBCKT trng_floorplan` header | **112** |
| routed floorplan, held to that declared interface | **107** (was 108 before [#224][gf224]) |

The 2588 is not a meaningful interface — it is every labelled net in the
design, and `digital`'s own DEF→GDS merge draws a text for essentially
every routed net it has. The check `floorplan.py` actually applies gives
`klt extract` the composed reference's own pin list (`--pins`) and abstracts
the standard cells (`--abstract-cells`), exactly as `layout/digital/lvs.py`
already does standalone.

The gap between 112 and 107 is a **tool limitation, not missing wiring**,
and it is derived rather than remembered — `floorplan.py` computes the
expected number and fails if the extraction disagrees:

- KLayout joins *every* text label found on one electrical net into a single
  `'|'`-separated net name. Five of the declared pins land on nets that
  already carry a label from a region's own cells (`en1` → `en|en1`,
  `en2`, `vddr1` → `vddr|vddr1`, `vddr2`, `vdd` → `d|vdd`). `klt extract
  --pins` takes a *comma-separated list*, so those names cannot be written
  in it at all, and the five stay internal nets. −5.
- **Since [#224][gf224], nothing else promotes twice.** Before #224, `vss`
  promoted twice (+1): the analog ground return and `digital`'s own PDN
  ground were two separate nets that happened to carry the same label,
  because `digital`'s connection into `vss` was undrawn. #224 draws that
  tie (see "The supply/ground star point lands off-die" above), so there is
  now only one `vss`-labelled net, not two — `layout/floorplan/floorplan.py`'s
  own `DUPLICATE_PIN_NAME_PROMOTIONS` is empty. `vddd` does not gain a
  compound label either: `run_extract_composed`'s own `--def-net-names`
  names `digital`'s contribution to a net from the DEF's own declared net
  name (`vddd`/`vss`, already equal to the net's own name), not from a
  per-cell-instance `VDD`/`VSS` pin label, so neither tie adds anything
  `--pins` would need to express. 112 − 5 + 0 = **107**, verified directly
  against `klt extract`'s own reported count.

#### Under klt 0.6.0 the expectation is 112, not 107 (gf180-trng#309, 2026-10-08)

Everything above this heading is the **historical** account (the 107 was
measured under the producers that predate klayout-tools#1687, and it stays
as written). The normative producer is now klt 0.6.0 (DR-0026, amended in
#281), and `--pins` there matches a declared name against **any one
component** of a `'|'`-joined net label instead of the whole string. The five
joined nets are therefore promoted, under their joined names, and counted:

| declared pin | promoted as |
|---|---|
| `en1` | `en|en1` |
| `en2` | `en|en2` |
| `vdd` | `d|vdd` |
| `vddr1` | `vddr|vddr1` |
| `vddr2` | `vddr|vddr2` |

`floorplan.py` derives the expectation as one promoted net per declared pin
(`expected_interface`), named by its predicted label set, plus one per
`DUPLICATE_PIN_NAME_PROMOTIONS` entry (still empty): 112 declared -> **112**
expected. It compares both the count and the promoted *names*, exactly, so an
unexpected or missing pin fails by name.

**What the check measured on 2026-10-08** (klt `0.6.0+g3a75c3ae705b`,
gf180mcuD at open_pdks `c6d73a35...` from the local volare install -- *not*
the `f6eeac7d...` commit `pdk-nightly.yml` pins, see #310; committed tree at
`main` `1944e2b`): the composed stream promotes **114** pins. The 112
predicted names are all present, including the five joined ones. The other
**two are a second `clk` and a second `rst_n`** (reported by the SPICE writer
as `clk$1`/`rst_n$1`): `digital`'s own clock-tree root and reset-fan-out
nets, each carrying only `digital`'s pin text (at y = 399.67 um, the far end
of the block) and no trunk label. They are not legitimate promotions and are
deliberately *not* added to `DUPLICATE_PIN_NAME_PROMOTIONS`; they are the
"two nets named `clk` / `rst_n`" unjoined-endpoint signature described below.
`raw_bit` and `raw_valid` show the same split (a `digital`-side net next to
`q|raw_bit`/`q|raw_valid`; they are not declared pins, so they are not
promoted, but the connectivity check reports them). Cause: `digital` was
re-placed-and-routed (#266/#277/#293) and its `clk`, `rst_n`, `raw_bit`,
`raw_valid` and `ring_bit[*]` pins moved from the bottom edge (y = 0.26 um in
the DEF) to the top edge (y = 398.67 um); `interregion.py`'s `digital_pin`
stub was drawn at the bottom edge and did not read the pin's y. The
expectation was not loosened to hide this; the wiring was fixed instead
(gf180-trng#315, below).

**Resolution (gf180-trng#315, 2026-10-09).** `interregion.py` now reads each
`digital` pin's edge from the DEF placement (`digital_pin_edge`): a bottom-edge
pin keeps the original short Metal4 stub and Metal3 riser from below the row;
a top-edge pin leaves the pin straight up on a Metal4 stub (positive-area
overlap with the pin rectangle), turns east on its own Metal5 track above the
guard ring (track `y` = block top + 2 um + 0.7 um per endpoint), and comes down
`digital`'s free east flank on its own Metal3 riser (`x` = block east edge +
2 um + 0.7 um per endpoint) to the usual Metal4 trunk. Everything outside the
pin overlap is beyond `digital`'s footprint and guard ring, so the route never
runs through `digital`'s internal routing; `digital` is the last region of the
row, so the flank is otherwise empty. Metal4/Metal5/Metal3 are three distinct
layers, so the six endpoints cross one another without sharing a layer. A pin
on neither edge is rejected with a `WiringError` rather than routed blind.
Re-placing the pins back on the bottom edge needs no change here. Because the
stubs now reach the east flank, `clk` and `rst_n` trunks (and therefore their
chip pins) sit east of `digital`'s east edge instead of at its pin; they still
never run west of `combiner_sampler` (DR-0012-clock).

Measured with the normative producer, klt `0.6.0` (PyPI wheel in a throwaway
venv, `klayout==0.30.10`), gf180mcuD at open_pdks `c6d73a35...` (local volare
install), `python3 layout/floorplan/floorplan.py --require-tools`: extraction
reports **112** pins against the 112 expected (was 114); the extra `clk$1`/
`rst_n$1` and the split `raw_bit`/`raw_valid` nets are gone; composed DRC is
clean (0 violations, 0 new against each region's standalone DRC); composed
LVS is `match` (2 mismatches, no unexpected categories -- unchanged).
`layout/tests/test_interregion.py` additionally checks, with no tool or PDK,
that every one of the six endpoints is joined to its trunk by positive-area
same-layer overlaps and via cuts, at the committed origin and at a translated
one.

**`check_interregion`'s label count was inverted for `ring_bit*`, and is
fixed here.** `run_extract_composed` passes `--def-net-names`, which names a
net that contains `digital`'s DEF-annotated routing by its DEF net name and
drops the text labels. For `clk`/`rst_n`/`raw_bit`/`raw_valid` the DEF name
equals the trunk label, but the joined `ring_bit1`/`ring_bit2` nets come back
as `ring_bit[0]`/`ring_bit[1]`. Counting the trunk label alone therefore
reported the correctly joined `ring_bit1`/`ring_bit2` as carried by **0**
extracted nets (two failures of this flow under klt 0.6.0), and a
disconnected `digital` endpoint as **1** carrier (measured: with
`ring_bit[1]`'s Metal4 stub deleted, the extraction reports `ring_bit[1]` and
`q|ring_bit2` -- one net carrying `ring_bit2`, so the old check passed). The
carriers are now the extracted nets carrying any label in
`interregion.route_net_labels` (the trunk label plus each `digital`
endpoint's DEF net name): one for every drawn net on the routed floorplan,
two for the stub-deleted control. With this fix the same run reports 6
unmet checks, all of them committed-artefact freshness (#256), against 8
before.

**Per-endpoint extracted membership (gf180-trng#315).** The label count
above is not membership evidence on its own, so each endpoint was also
queried directly. A probe script ran `run_extract_composed`'s own `klt
extract` argv in-process under klt 0.6.0 (`klayout` 0.30.10, deck
`gf180mcu` content hash `sha256:95c2eb91...`), on the composed stream
`layout/.work/trng_floorplan.gds` (`sha256:5d20e880...`, the stream this
flow writes at this commit), and asked klt's own `LayoutToNetlist` object
(`probe_net` on its registered Metal4 conductor) which extracted net holds
the conductor (a) at `digital`'s DEF-placed pin, found by the pin text that
`digital`'s own DEF-to-GDS merge wrote inside `trng_top`, probed 0.2 um
below that text where only pin metal sits, and (b) under the trunk label
`interregion.py` draws. `klt extract` has no point-to-net query, which is
why the probe uses klt's in-process object (see [Tool
friction](#tool-friction)):

| endpoint | pin (um) | trunk label (um) | extracted net at pin | at trunk | std-cell pins on net |
|---|---|---|---|---|---|
| `clk` | 786.58, 399.47 | 933.51, -4.0 | `clk` (cluster 119) | same | 1 |
| `rst_n` | 759.70, 399.47 | 934.21, -4.7 | `rst_n` (3879) | same | 17 |
| `raw_bit` | 721.62, 399.47 | 617.71, -5.4 | `raw_bit` (1464) | same | 9 |
| `raw_valid` | 719.38, 399.47 | 648.18, -6.1 | `raw_valid` (1197) | same | 16 |
| `ring_bit[0]` | 758.58, 399.47 | 678.975, -6.8 | `ring_bit[0]` (99) | same | 3 |
| `ring_bit[1]` | 707.06, 399.47 | 709.77, -7.5 | `ring_bit[1]` (107) | same | 2 |

All six pins are on the same extracted net as their trunks, and the six nets
are distinct. The standard-cell pin counts agree with the DEF `NETS` fan-out
(for example `ring_bit[0]`: three cell pins). As a control, deleting
`ring_bit[1]`'s Metal4 stub and re-running the same probe put that pin on a
different net (`ring_bit[1]`, cluster 3365) from its trunk (`q|ring_bit2`,
cluster 107), while the other five stayed joined.

The committed `reports/` and `trng_floorplan.gds` were deliberately **not**
committed `reports/` and `trng_floorplan.gds` were deliberately **not**
regenerated here: they are stale against the current `digital` block
(composed height, pin edge) and #256 owns that refresh, which will pick up
this wiring.

Both remaining gaps are filed generically upstream — see [Tool
friction](#tool-friction).

**The count on its own is a weak check, and this is the evidence for
saying so.** Run the *same* extraction against the **unrouted** floorplan
(the committed stream this issue started from, before any wiring) and it
also reports **112** pins — but they are 112 with *duplicates*: four nets
named `vss`, two named `clk`, two named `rst_n`, because each region's own
copy of those nets is a separate net that happens to carry the same label.
That duplicate signature *is* the "regions not electrically joined"
condition, and a reader looking only at the headline number would read it as
a better result than the routed one. What actually separates the two cases
is the net count and the LVS verdict below: 2702 nets unrouted against 2691
routed (was 2692 before #224 — `vss` now merges **four** region returns into
one, not three, since `digital`'s own ground return joined) — exactly the
eleven joins the fifteen drawn nets make (eight two-endpoint nets, plus
`vss` merging four region returns into one; `vddd`'s own tie is a
single-endpoint join — a wire onto `digital`'s already-singular internal
PDN net, not a merge of two previously-distinct nets — so it does not
itself change this count).

### DRC and LVS over the routed result

- `klt drc` over the composed, routed stream: **clean, 0 violations**, and
  0 beyond each assembled region's own standalone baseline
  ([`reports/floorplan.drc.json`](reports/floorplan.drc.json)).
- `klt lvs` of the extracted netlist against phase 1's own
  [`trng_floorplan.lvs_reference.spice`](trng_floorplan.lvs_reference.spice),
  both sides flattened: **match**
  ([`reports/interregion.json`](reports/interregion.json)). Flattening is
  required on both sides, not a convenience: the layout side is flat by
  construction once the standard cells are abstracted, while the reference
  is four `.SUBCKT` instantiations, so neither can pair against the other
  hierarchically.

**And the negative control, because a check that cannot fail is not a
check.** The identical LVS run against the *unrouted* floorplan — same
reference, same extraction flags, same flatten options, only the wiring
block removed — was **`mismatch`, 157 mismatches** (70 `device.unmatched`,
39 `net.merged`, 43 `net.split`, 3 `net.unmatched`) before [#224][gf224];
the exact mismatch breakdown shifts slightly now that the reference itself
declares two more real connections (`vddd`/`vss` into `digital`) for the
unrouted geometry to fail against, but the qualitative result this control
exists to demonstrate is unchanged: removing the wiring block still turns
`match` into a `mismatch` with dozens of entries, not zero. So the `match`
verdict above is load-bearing: it is the difference between four regions
wired as phase 1 declares and four regions sitting next to each other, and
it is what a future regression that silently disconnects a region would
trip.

### Supply connectivity over the whole composed stream (`klt erc`) — issue #447

One `klt erc` run (klt 0.6.0, the repo pin) over
`trng_floorplan.gds`, top cell `trng_floorplan`, with
[`erc-supply-spec.json`](erc-supply-spec.json): Metal1-Metal5 and
Via1-Via4, with the five supplies the inter-region trunks carry declared as
`kind: supply` nets (`vddr1`, `vddr2`, `vdd`, `vddd`, `vss`). The response,
trimmed of its ~10 MB per-gate antenna tables, is
[`reports/erc-supply.json`](reports/erc-supply.json), pinned to the stream
and the spec by `provenance.input.content_hash` / `provenance.spec.content_hash`.

**Baseline result: `erc_status: clean`, zero findings.** Each of the five
supplies is in `erc_coverage.checked` (`erc.net_connectivity`), nothing is
skipped, and 8123 `erc.floating_gate` checks ran. Read that as: every
declared name resolves to exactly one electrical island across Metal1-Metal5
(zero `erc.unconnected_net`) and no two declared supplies touch (zero
`erc.supply_short`), including the shared `vss`, which joins all four
regions. It is a connectivity read of the drawn stream; it is not a tier
input and `signoff/block-manifest.json` does not cite it.

Choices that shape what the pass means:

- **One spelling per supply.** Inside a region the same island also carries
  other spellings (rings: cell-level `vddr`; digital cells: `VDD`/`VSS` on
  34/10; the digital PDN: `vddd`/`vss` on 81/10). Declaring two spellings of
  one island reports a false `erc.supply_short`, so only the trunk spelling
  (Metal4 label, 46/10) is declared. The other spellings are undeclared
  aliases: they are neither asserted nor checked for distinctness.
- **A trunk without a readable label cannot pass by default.** A declared
  name with no label in the stream is reported as `erc.unconnected_net`
  (control below), and the freshness check also requires every declared
  supply in `erc_coverage.checked`.
- **Disclosed, not passed:** well ties (`erc.missing_tie`) are not computed
  and the substrate/guard-ring identity is not asserted. `vsubs` is not
  declared (no label of that name exists, and merging the guard ring into
  `vss` is the `net.merged` failure documented in `interregion.py`); the
  analog regions draw no Nplus/Pplus/LVPWELL; the digital partition's own
  spec covers its tap sites. The report carries the spec's
  `ties_disclosure` of kind `unexpressible`.

**Which stream this read.** The committed `trng_floorplan.gds` was, when this
section was first written, the depth-8 stream. [#256] has since regenerated it
(depth-2 digital, klt 0.6.0) and `--write` re-ran `klt erc` on the new stream:
`erc_status` stays `clean`, zero findings, now over 4 035 gates (was 8 123).
The ERC report is pinned by hash to the committed stream.

**Controls**, in [`../tests/test_floorplan_erc.py`](../tests/test_floorplan_erc.py).
The composed stream takes minutes per `klt erc` run, so the controls run the
same committed spec against a small synthetic stream on the real layer
numbers, mutated in a temp dir (no committed file is touched): a baseline with
a shared two-stack `vss` is clean; removing Via1 under one `vss` stack gives
`erc.unconnected_net`; a Metal4 bar across two trunks (`vddr1`/`vddr2`, and
separately `vdd`/`vddd`) gives `erc.supply_short`; a trunk with no label gives
`erc.unconnected_net`. They need a release klt first on PATH and skip
otherwise (`uvx --from klayout-tools klt`). No control was run on
the full composed stream.

**Freshness.** `python3 layout/floorplan/floorplan.py` fails when the report's
two content hashes no longer match the committed stream and spec, when the klt
version is not the pin, or when the report is not clean with all five supplies
computed (a tool-free check, so it runs even where `klt` is absent).
`--write` re-runs `klt erc` after regenerating the stream and refreshes the
report; findings are written into it before the run fails.

---

## DRC: what actually ran

`klt drc` was run — by this script, not by hand — on every generated device
footprint and on the composed floorplan abstract, with the same `gf180mcu` deck
and the same PDK resolver `layout/verify.py` uses. Verbatim output in
[`reports/floorplan.drc.json`](reports/floorplan.drc.json).

**Since issue #110, `ring1`/`ring2` carry their own real, placed content;
since issue #135, so does `combiner_sampler`; since #209/#210, so does
`digital`** (`layout/digital/trng_top.gds`, the routed digital section).
Every region in this composed abstract now carries its own real,
DRC-clean assembled content. This regeneration's own composed abstract is
fully clean:

```
composed abstract: status "clean", violation_count 0, rule_counts {}
new violations introduced by composing the regions together: 0
```

That is a change from what issue #110's own regeneration recorded here
(`status "violations", violation_count 98`, `rule_counts
{metal1.enclosing.contact.1: 10, via1.width.1: 88}` — exactly twice each
ring's own standalone 49). That 98 was a pre-existing deck-drift gap
([klayout-tools#623][kt623], discussed below) between the `klt` build that
produced `layout/reports/ro_ring11*.drc.json`'s own committed `clean`
verdict and the `klt` build issue #110's own regeneration ran against; this
regeneration's `ring_fit.json` shows `ring1`/`ring2`'s own standalone DRC is
*also* clean now (`reports/ring_fit.json`'s own `ring_standalone` entries),
so whatever `klt` build this run resolved on `PATH` evidently carries the
fix for that drift too — see [Tool friction](#tool-friction) for the detail.
Nothing about `combiner_sampler`'s own placement caused this; it is a
byproduct of re-running the whole flow against a newer `klt` build,
surfaced because this issue's own test plan required a full regeneration.

`floorplan.py`'s own pass/fail signal remains **not** "is the composed
abstract's raw violation count zero", because that is not guaranteed to stay
true as more regions gain real content or as the resolved `klt` build
drifts again — it is "does composing the regions together, and placing each
region's own real content inside its own guard ring, introduce anything
beyond what that region's own committed GDS already reports on its own"
(`reports/floorplan.drc.json`'s own `new_violations_from_composition` key,
and `reports/ring_fit.json`'s own `new_violations_from_fit`, for the same
question asked pairwise per region). Both report 0 — which, this run,
happens to coincide with the raw count also being 0.

**Read the scope off the report, not off this sentence.** The abstract draws
Comp, Contact and Metal1 only, so the deck checked **three layers** and
**skipped sixteen rules** for want of the layers they apply to (all upper
metal, MiM, BJT, poly and n-well). That is in the report's own `coverage`
block.

**What a clean-relative-to-baseline result here does and does not mean:**

- It **does** mean the isolation structures are legal geometry at these
  dimensions: four guard rings with those tap widths and contact pitches, at
  those sizes, with 20 µm between them, violate no rule in the curated deck —
  and that placing `ring1`/`ring2`/`combiner_sampler`/`digital`'s own real
  content inside its own guard ring, at the clearance
  `RING_PLACEMENT_CLEARANCE_UM` establishes (below), introduces no *new*
  rule violation over what that region's own committed GDS already has.
- It does **not** mean the block is DRC-clean, full stop, as a general
  property of this check: a DRC run over a
  floorplan abstract can only check what the floorplan abstract actually
  contains: three layers (below), not the full deck. That this
  particular regeneration's own raw violation count happens to be zero too
  is a fact about this run, not a guarantee `floorplan.py` makes going
  forward.
- It is **not tapeout sign-off**, for all the reasons
  [`layout/README.md`](../README.md) already states: `klt`'s decks are a
  curated subset, not the PDK's own sign-off deck.

The generated streams also cannot be identified to a `klt` build by its own
version string alone (`klt --version` read `0.1.0` for every build through
issue #119 — [klayout-tools#306], closed; this regeneration's own
`klt --version` reads `0.2.0`, and `reports/*.json`'s own
`provenance.klt_version` field confirms it); `layout/reports/
environment.json` records the `klt_origin` commit for the same install this
flow ran on, and every report here carries `klt`'s own `provenance` block
including a content hash of the deck — the content hash, not the version
string, is what this document actually relies on for reproducibility.

---

## What this floorplan does not establish

Stated as a list because an unstated limit is a defect.

1. **No substrate-coupling attenuation figure.** 20 µm and a tap ring are a
   structure, not a number. Quantifying them needs a substrate network model
   and extracted parasitics, neither of which exists here.
2. **No supply-network coupling bound.** Every deck backing the coupling
   measurement uses an *ideal* supply. Real supply-network coupling is a second
   path those decks do not have, and the star topology above addresses it
   structurally without bounding it. `sim/tools/power_rollup.py` prices the
   *current*; nothing prices the *impedance*.
3. **No corner coverage on the coupling factor.** 28.6× is `tt`/27 °C/3.30 V
   only. It is a circuit ratio with no reason to be corner-independent, and the
   sweep belongs to #13/#12.
4. **No removal of the coupling — only 92.8 % of it.** The buffer mitigation
   is measured ([#75]) and adopted ([#78], [`DR-0018`](../../spec/decision-records/DR-0018-adopt-per-ring-output-buffer.md)):
   the schematic now ships buffered. What that does *not* establish is
   independence. A **2.87× residual** survives at `tt`/27 °C/3.30 V — an
   8.24× over-statement squared, still in the unsafe direction — so the
   measurement rule below is unchanged, and per-ring `σ_acc,i` taken with the
   neighbours switching stays inadmissible, buffered or not. The residual's
   own corner coverage is item 3's gap, not a separate one.
5. **No measurement of the `clk`-driven liveness-tap path**, as stated above —
   [#76].
6. **No attribution of the residual 1.21×** between one XOR gate with one
   neighbour (19.20 ps) and the full four-ring tree (23.21 ps). That needs a
   re-run of `sim/tb/ro-array-sanity-jitter/`, not a layout decision.
7. **No empirical independence check.** [DR-0007] §6 assigns that to #12, and
   this document only sharpens what it has to target.
8. **No decoupling capacitor sizing** for the entropy domains — the channel is
   reserved, the structure is not designed.
9. ~~No full layout.~~ **Closed as of #209/#210**: every region in this
   composed abstract now carries real, placed, DRC/LVS-verified content —
   `ring1`/`ring2` since issue #110, `combiner_sampler` since issue #135
   ([#134][gf134]), and `digital` since #209/#210
   (`layout/digital/trng_top.gds`). Each region's own guarded footprint is
   sized from that real content's own bounding box rather than the area/
   utilisation estimate that preceded it — see [What the area model
   is](#what-the-area-model-is) above for the per-region numbers. Kept as
   a struck-through list entry, not deleted, so a reader diffing this
   document against an older revision can see the gap closed rather than
   silently vanish.

None of these is a reason to withhold the floorplan. All of them are reasons
not to read a clean DRC result as an independence argument.

---

## Tool friction

Per [CLAUDE.md](../../CLAUDE.md), friction found while using klayout-tools is
filed generically against the tool — the tool gap, never this repository's
design. This work produced eleven, all filed against
[klayout-tools][klt] and all worked around in
[`floorplan.py`](floorplan.py)/[`interregion.py`](interregion.py) rather than
silently absorbed (some were genuine tool defects with no caller-side
mitigation possible and are recorded here only until fixed upstream):

1. **[klayout-tools#320][kt320]** — generated streams are not byte-reproducible.
   `klt gen`, `klt gen-compose` and `klt draw` stamp wall-clock time into the
   GDSII `BGNLIB` / `BGNSTR` records, so two runs of the same generator on the
   same inputs differ in those bytes. A golden-artefact flow cannot diff that.
   `floorplan.py` zeroes those fields on the way in (`normalise_gds`), which is
   the same thing this repository's own writer `layout/testcells/gdsii.py`
   already does for the same reason.
2. **[klayout-tools#321][kt321]** — `klt gen-compose` supported only
   `placement.strategy: "row"` when this was filed. A floorplan is
   two-dimensional by nature and needs explicit per-block x/y placement with
   declared separations; a single row with one `spacing_um` is what this
   abstract's own four regions are still built as (no 2-D grid/auto-packing
   exists yet). `placement.strategy: "explicit"` (a caller-declared `{x, y}`
   origin per block, #321) has since shipped, and issue #119's own ring-fit
   check (see [What the area model is](#what-the-area-model-is)) uses exactly
   that to place a region's real ring geometry inside its guard ring's inner
   cavity — `layout/rings/ro_ring11/build.py` uses the same strategy to
   assemble the ring itself. (Two smaller things noted there have since been
   fixed upstream by [klayout-tools#328][kt328]: `blocks[].generator_report`
   paths now resolve against the request file's own directory rather than the
   working directory — matching `klt lvs`'s convention all along — and an
   unrecognised `pdk` key is now an application error instead of a silent
   fallback to the family default. `floorplan.py` was updated to the new
   `generator_report` resolution rule (gf180-trng#79); note that
   `options.output` is deliberately *not* covered by it and still resolves
   against the process's working directory, per `gen_compose.compose`'s
   docstring, so this flow's compose request keeps that path repo-root
   relative.)
3. **[klayout-tools#322][kt322]** — `klt gen mos_array` rejects `w_um` below
   0.42 µm, which is above the device minimum the tool's *own* curated
   gf180mcu DRC deck enforces (0.22 µm Comp width — this repository's
   `layout/testcells/build.py` draws against exactly that minimum and the deck
   passes it). A minimum-width digital-style device therefore cannot be
   generated at all, so the starve-device footprints here are measured at the
   floor and are over-estimates.
4. **[klayout-tools#692][kt692]** — `klt gen-compose`'s `strategy: "explicit"`
   does not consult a neighbouring `guard_ring` generator's own reported
   `drc_hints.min_spacing_um` at all, so it will happily compose a block
   flush (zero clearance) against a guard ring even though the generator's
   own response already names the minimum spacing that avoids a short. Found
   placing `ring1`/`ring2`'s real assembled content (issue #110,
   [Placement](#placement--issue-110) above): the zero-clearance placement
   `check_ring_fit` already exercised as a DRC-only stress test for issue
   #119 passes `klt drc` clean against the curated deck, and still shorts
   the ring's own signal wiring to `vss` once `klt lvs` is run over the same
   composed pair — `klt extract`'s own `merged_net_labels` names it
   directly. `floorplan.py` works around this by deriving its own placement
   clearance from the generator's `drc_hints.min_spacing_um` and
   cross-checking it at run time (`RING_PLACEMENT_CLEARANCE_UM`) rather than
   trusting a fixed number, but nothing in `gen-compose`'s own contract
   prompts a caller to do so.
5. **[klayout-tools#1496][kt1496]**, then **[klayout-tools#1514][kt1514]** —
   composing `digital`'s real content (issues #209/#210) hit a database-unit
   (dbu) mismatch `gen-compose` had no override for: `klt gen`'s own output
   wrote at a hardcoded 0.001 dbu regardless of PDK while `klt place-and-
   route`'s DEF/GDS merge (how `layout/digital/trng_top.gds` was produced)
   correctly derived its dbu from the resolved PDK's tech LEF (0.0005 for
   gf180mcu). Fixed upstream by merged klayout-tools#1512, which made `klt
   gen` PDK-aware too — but that fix then regressed the *other* three
   regions, whose own committed assemblies are `klt draw`-descended and
   still hardcoded at 0.001 with no override (#1514), fixed in turn by merged
   klayout-tools#1516 (`gen-compose` now resolves the finest dbu among a
   request's blocks and losslessly rescales coarser ones onto it via an
   exact integer `ICplxTrans` magnification, instead of refusing on any
   mismatch). `.github/workflows/pdk-nightly.yml`'s `klt` pin was bumped past
   both fixes as part of #210; no workaround lives in `floorplan.py` itself
   for either — both were genuine tool defects with no caller-side mitigation
   possible.
6. **[klayout-tools#1533][kt1533]** — once #5's dbu mismatch cleared, `klt
   lvs`'s own ambiguous-net-pairing heuristic turned out to be sensitive to
   the mere *presence* of `digital`'s guard ring in the same top-level
   compare: a single-instance, genuinely-dangling-by-construction cell
   (`clkload13`, already disclosed in `layout/digital/lvs.py`'s own module
   docstring) that LVS-matches cleanly on its own flips to a hard,
   unrecoverable `net.split` once the guard ring's one extra, unrelated net
   joins the same comparison — confirmed the underlying digital geometry
   itself is untouched by re-extracting the same content sub-cell back out
   of the composed GDS and reproducing the clean standalone verdict
   byte-for-byte. `check_ring_fit`'s own LVS step for `digital` works around
   this by extracting and comparing that content sub-cell alone (`run_
   extract_abstract`'s own docstring has the full account) rather than the
   full composed pair every other region's LVS step uses — relying on the
   composed *DRC* check (run unconditionally, unaffected by this) to verify
   the guard ring's adjacency introduces no short.
7. **[klayout-tools#1670][kt1670]** (closed, fixed) — `gen-compose`'s own
   routing-role map for the `gf180mcu` family had no `"metal4"`/`"via3"`
   role, so its auto-router structurally could not resolve a route onto one
   of `digital`'s real Metal4 pins. Filed during phase 1 (#221) and fixed
   upstream before phase 2 ran: the installed build's
   `_PDK_ROLE_LAYERS["gf180mcu"]` now carries both roles. The wiring here is
   still hand-drawn rather than auto-routed, for a separate reason that is
   *not* a tool gap: every one of these routes has to cross its own region's
   guard ring and reach a pin inside a block, which `route_two_pin` rejects
   by design (it treats a guard/collector ring's tap loop and a block's
   interior as barriers), and the four regions' generator reports declare no
   `ports[]` for it to route between. Hand-drawing is the same technique
   `layout/rings/ro_ring11/build.py` already uses one level down.
8. **[klayout-tools#1687][kt1687]** — `klt extract --pins` cannot name a net
   that carries more than one label. KLayout joins every text found on one
   electrical net into a single **comma-separated** `Net.name`, and `--pins`
   is itself a comma-separated list, so a net named `en,en1` cannot be
   written in it at all (`--pins en,en1` parses as two names, neither of
   which matches). `--def-pins` already solved exactly this by matching on
   any one component label; `--pins` has no equivalent, and `--pins` is the
   only option when the pin list comes from a reference netlist's `.SUBCKT`
   header rather than from a DEF. This is what made the routed floorplan
   report 108 pins against the reference's declared 112 (historical:
   klayout-tools#1687 since fixed the matching in klt 0.6.0, which now
   promotes the joined nets -- see "Under klt 0.6.0" above) — see [What `klt
   extract` reports, and why](#what-klt-extract-reports-and-why).
   `floorplan.py` works around it by *deriving* the expected count (declared
   pins, minus the ones whose extracted name is a multi-label join, plus the
   one name that legitimately promotes twice) and failing if the extraction
   disagrees — so the shortfall is asserted, not absorbed.
9. **[klayout-tools#1688][kt1688]** — the curated `gf180mcu` deck has no
   `metal4.width` / `metal4.space` rule, while Metal1/2/3/5/MetalTop all
   have both and Metal4 itself carries both of its via-enclosure rules. A
   Metal4 width or spacing error is therefore not reported at all, and a
   caller drawing Metal4 by hand has no threshold to assert its own
   constants against — the practice every other hand-drawn cell in this
   repository follows. [`interregion.py`](interregion.py) sizes its Metal4
   trunks to the Metal3 thresholds instead and says so in its own docstring,
   which is a documented guess, not a check.
10. **[klayout-tools#1689][kt1689]** — `gen-compose` drops the DEF net-name
   shape property when it copies a block's geometry, so `klt extract
   --def-net-names` silently stops recovering `digital`'s own net names once
   that macro is composed into the floorplan (it works on
   `layout/digital/trng_top.gds` standalone — `trng_top.extracted.spice`'s
   own `clknet_*` names are the evidence). The composed extraction still
   resolves every net correctly; only the *names* of `digital`'s internals
   degrade to `$<id>` placeholders, which is exactly the case where readable
   names are worth most. No caller-side workaround exists; the flag is
   passed anyway so the warning stays visible in the committed report.
11. **[klayout-tools#2986][kt2986]** — `klt extract` has no point-to-net
   query, so "this pin's conductor is on the same extracted net as this
   trunk" can only be inferred from net names. Under klt 0.6.0 with
   `--def-net-names` that inference was inverted for the `ring_bit*` routes
   (see "Resolution (gf180-trng#315)" above). The per-endpoint membership
   evidence for #315 was taken by calling `probe_net` on klt's own
   in-process `LayoutToNetlist` object, which depends on klt internals and
   is not part of this flow.

Not new friction, but worth recording alongside the above: issue #110's own
regeneration found that `layout/rings/ro_ring11/ro_ring11.gds`'s and
`ro_ring11_ring2.gds`'s own standalone `klt drc` result no longer reproduced
the `clean` verdict committed in `layout/reports/ro_ring11*.drc.json` (#120,
#118) — same input content hash, but a different `provenance.deck.content_hash`
than the one that produced the committed report, because a different `klt`
build resolved on `PATH` when that regeneration ran. That was exactly the gap
[klayout-tools#623][kt623] (closed) already describes: no way to pin or
reproduce a specific historical rule-deck revision once a newer `klt` build
shadows it. **Issue #135's own regeneration (this document's current numbers)
no longer reproduces that drift**: `reports/ring_fit.json`'s own
`ring_standalone` entries for `ring1`/`ring2`/`combiner_sampler` are all
`clean` again, matching the originally-committed verdict, which is consistent
with `#623` genuinely being fixed in whatever `klt` build (`0.2.0`, per this
run's own `klt --version` and `provenance.klt_version`) resolved on `PATH`
this time. Nothing here re-verifies `ro_ring11`'s own DRC status as a
standalone-block concern — that is still a `layout/rings/` question, not a
floorplan-region-sizing one — and this script's own ring-fit check already
separates "violations already present in the assembled GDS alone" from
"violations introduced by fitting it into its region" (0 of the latter for
all three regions this run) precisely so a future recurrence of this drift
would not block that separate question.

[klt]: https://github.com/2AMLogic/klayout-tools
[kt320]: https://github.com/2AMLogic/klayout-tools/issues/320
[kt321]: https://github.com/2AMLogic/klayout-tools/issues/321
[kt322]: https://github.com/2AMLogic/klayout-tools/issues/322
[kt328]: https://github.com/2AMLogic/klayout-tools/issues/328
[kt623]: https://github.com/2AMLogic/klayout-tools/issues/623
[kt692]: https://github.com/2AMLogic/klayout-tools/issues/692
[kt1496]: https://github.com/2AMLogic/klayout-tools/issues/1496
[kt1514]: https://github.com/2AMLogic/klayout-tools/issues/1514
[kt1533]: https://github.com/2AMLogic/klayout-tools/issues/1533
[kt1670]: https://github.com/2AMLogic/klayout-tools/issues/1670
[kt1687]: https://github.com/2AMLogic/klayout-tools/issues/1687
[kt1688]: https://github.com/2AMLogic/klayout-tools/issues/1688
[kt1689]: https://github.com/2AMLogic/klayout-tools/issues/1689
[kt2986]: https://github.com/2AMLogic/klayout-tools/issues/2986
[klayout-tools#306]: https://github.com/2AMLogic/klayout-tools/issues/306

[#75]: https://github.com/2AMLogic/gf180-trng/issues/75
[#803]: https://github.com/2AMLogic/gf180-trng/issues/803
[#76]: https://github.com/2AMLogic/gf180-trng/issues/76
[#78]: https://github.com/2AMLogic/gf180-trng/issues/78
[#82]: https://github.com/2AMLogic/gf180-trng/pull/82
[gf118]: https://github.com/2AMLogic/gf180-trng/issues/118
[gf120]: https://github.com/2AMLogic/gf180-trng/pull/120
[gf134]: https://github.com/2AMLogic/gf180-trng/issues/134
[gf135]: https://github.com/2AMLogic/gf180-trng/issues/135
[gf224]: https://github.com/2AMLogic/gf180-trng/issues/224
[#144]: https://github.com/2AMLogic/gf180-trng/issues/144
[#151]: https://github.com/2AMLogic/gf180-trng/issues/151

[DR-0007]: ../../spec/decision-records/DR-0007-multi-ro-xor-combined-entropy-source.md
[DR-0008]: ../../spec/decision-records/DR-0008-crc32-lfsr-non-vetted-conditioner.md
[DR-0010]: ../../spec/decision-records/DR-0010-raw-rate-moves-to-the-measured-jitter-energy-limit.md
[DR-0012-clock]: ../../spec/decision-records/DR-0012-sampler-fixed-external-clock.md
[DR-0017]: ../../spec/decision-records/DR-0017-idle-current-row-versus-ungated-standard-cell-leakage.md
[DR-0020]: ../../spec/decision-records/DR-0020-fifo-depth-set-to-two-against-power-area-and-streaming.md
[DR-0026]: ../../spec/decision-records/DR-0026-normative-klt-build-for-floorplan-reports.md
[DR-0018]: ../../spec/decision-records/DR-0018-adopt-per-ring-output-buffer.md
[DR-0019]: ../../spec/decision-records/DR-0019-area-row-versus-output-fifo-dominated-digital-section.md
[DR-0025]: ../../spec/decision-records/DR-0025-full-chip-pex-scope.md
[#111]: https://github.com/2AMLogic/gf180-trng/issues/111
[#143]: https://github.com/2AMLogic/gf180-trng/issues/143
[#145]: https://github.com/2AMLogic/gf180-trng/issues/145
[#209]: https://github.com/2AMLogic/gf180-trng/issues/209
[#210]: https://github.com/2AMLogic/gf180-trng/issues/210
[#256]: https://github.com/2AMLogic/gf180-trng/issues/256
[#254]: https://github.com/2AMLogic/gf180-trng/issues/254
[#255]: https://github.com/2AMLogic/gf180-trng/issues/255
[#256]: https://github.com/2AMLogic/gf180-trng/issues/256
[#315]: https://github.com/2AMLogic/gf180-trng/issues/315
[#866]: https://github.com/2AMLogic/gf180-trng/issues/866
[DR-0035]: ../../spec/decision-records/DR-0035-digital-facing-trunk-estimates-follow-the-bottom-edge-pins.md
