2AMLogic/gf180-trng/layout/digital/README.md

# `layout/digital/` — the digital section, placed and routed

`layout/cells/`, `layout/rings/` and `layout/blocks/` draw the entropy
source's analog and mixed-signal cells one at a time, by hand, each one
DRC-clean and LVS-matching on its own. That approach is the right (and
currently only) tool at the scale of a ring stage or a combiner gate, and it
does not extend to the digital section: conditioner + health tests +
interface synthesize to **2500-odd standard-cell instances, 708 of them
flip-flops** ([`design/trng_top/trng_top.synth.json`](../../design/trng_top/trng_top.synth.json),
issue #143). That is a place-and-route problem, and this directory is where
it is solved — [#111][gf111].

> **Update — re-synthesized and re-placed-and-routed at [dr20]'s ratified
> `FIFO_DEPTH = 2` (issue [gf255]).** Everything quoted below this notice —
> instance counts, timing, area and power — describes the `FIFO_DEPTH = 8`
> build this directory shipped before #255, kept as the append-only record
> of that run (the same treatment the "Two defects this bring-up found"
> section already gives the pre-#170/#171 numbers). The committed artefacts
> themselves are **not** that build any more: `trng_top.gds`/`.def`/
> `.pnr.v`/`.sdf` are the depth-2 P&R, LVS-matched against their own
> as-built netlist (`reports/lvs.json`: `status: match`, `mismatch_count:
> 0`, up from the depth-8 build's `mismatch_count: 6`).
>
> | | `FIFO_DEPTH = 8` (below, historical) | `FIFO_DEPTH = 2` (current, [gf255]) |
> |---|---:|---:|
> | Synthesized instances | 2505 | 1459 |
> | Placed logical instances | 2502–2533 (varied by rebuild) | 1458 |
> | DEF `COMPONENTS` (incl. tapcell/endcap/filler) | 8594 | 4436 |
> | Die (40 % utilization target) | 548.8 × 548.8 µm = 301 209 µm² | 398.895 × 398.895 µm = 159 117 µm² |
> | Worst slack, `ss_125C_3v00`, 50 ns period (this directory's own pre-signoff STA) | +28.4 ns | +28.5 ns |
> | Swept worst setup / hold, all 15 shipped `.lib` corners | −22.7 / +0.52 ns | −25.0 / +0.50 ns |
> | `klt drc` | clean, 0 violations | clean, 0 violations |
>
> The corner-swept, extraction-based STA/area/power figures this directory's
> own Timing/Area/Power sections point to
> (`sim/characterization-digital-sta-area-power.md`) are likewise re-run at
> depth 2 — see that document's own §0 for the full comparison, including a
> real regression the smaller design's different net topology introduced
> (`layout/digital/build.py`'s `CONSTRAINTS`, tuned for the depth-8 design,
> no longer clear the library's `max_transition` check at every corner).

> **Update — `max_transition_ns` re-tuned for the depth-2 topology (issue
> [gf264]).** The regression the box above flags was real: reusing
> `CONSTRAINTS.max_transition_ns: 8.0` unchanged from the depth-8 tuning
> ([gf240]) left the depth-2 DEF violating the library's own `max_transition`
> check at 11 of the 15 corners (`sim/characterization-digital-sta-area-power.md`
> §0). This issue re-derived the constraint for the depth-2 topology the same
> way [gf240] derived it at depth 8 —
> `sim/tb/digital-sta-power/max_transition_probe.py`'s per-net decomposition,
> this time over the depth-2 DEF — and rebuilt with `max_transition_ns: 4.0`,
> clearing all fifteen corners (§0a of the same document). The committed
> artefacts are *this* rebuild, so the depth-2 figures the box above quotes
> (from [gf255]'s original depth-2 build) are themselves now superseded:
>
> | | [gf255] depth-2 (superseded) | [gf264] depth-2 (current) |
> |---|---:|---:|
> | DEF `COMPONENTS` (incl. tapcell/endcap/filler) | 4436 | 4483 |
> | Placed logical instances | 1458 | 1488 |
> | Worst slack, `ss_125C_3v00`, 50 ns period (this directory's own pre-signoff STA) | +28.5 ns | +32.6 ns |
> | Swept worst setup / hold, all 15 shipped `.lib` corners | −25.0 / +0.50 ns | −7.4 / +0.50 ns |
> | Library `max_transition` violations (`sim/`-side sweep) | 11 of 15 corners | **0 of 15 corners** |
> | `klt drc` | clean, 0 violations | clean, 0 violations |
>
> The swept worst-setup-slack row's own large negative number, both before
> and after this rebuild, is unrelated to `max_transition`: it comes from the
> two 1.62 V-family `.lib` corners this block does not run at
> (`ss_125C_1v62`/`ss_n40C_1v62`), included in that sweep because it walks
> every `.lib` file the library ships, not the block's own ratified 3.3 V
> corner set — see [Timing](#timing) below.

> **Update — re-placed-and-routed from the re-baselined netlist (issue
> [gf293]).** [gf292] re-synthesized `design/trng_top/trng_top.synth.v` (one
> `nor2_1` → `nor2_2` drive-strength swap, same 1459 instances) without
> re-running this directory, so the [gf264] artefacts above were built from a
> netlist that was no longer in `design/`. `reports/place_and_route.json`'s
> `provenance.input.content_hash` recorded the old netlist's hash, and no
> check compared it with the new one. Every artefact here is now rebuilt
> from the current netlist: `trng_top.def`/`.gds`/`.pnr.v`/`.sdf`,
> `trng_top.lvs_reference.spice`/`.extracted.spice`, and
> `reports/{place_and_route,drc,lvs,erc-supply,sdf_export}.json`.
>
> | | [gf264] (pre-[gf292] netlist, superseded) | [gf293] (current netlist, current) |
> |---|---:|---:|
> | DEF `COMPONENTS` (incl. tapcell/endcap/filler) | 4483 | 4960 |
> | Placed logical instances | 1488 | 1490 |
> | Die (40 % utilization target) | 398.895 × 398.895 µm = 159 117 µm² | 398.93 × 398.93 µm = 159 145 µm² |
> | Worst slack, `ss_125C_3v00`, 50 ns period (this directory's own pre-signoff STA) | +32.6 ns | +32.7 ns |
> | Swept worst setup / hold, all 15 shipped `.lib` corners | −7.4 / +0.50 ns | −7.0 / +0.50 ns |
> | `klt drc` | clean, 0 violations | clean, 0 violations |
> | `klt lvs` against `trng_top.pnr.v` | match, 0 mismatches | match, 0 mismatches |
> | `klt erc` supply spec | `erc_status: clean`, 0 findings | `erc_status: clean`, 0 findings |
>
> This rebuild ran on a different OpenROAD build (26Q3-1510 from the
> digest-pinned `openroad/orfs` Docker image, versus the native 26Q3-2276
> build [gf264] used), so the netlist was not the only input that changed.
> `sim/characterization-digital-sta-area-power.md` §0b separates the two with
> a control run (the old netlist through the same 26Q3-1510 build). Most of
> each move comes from the OpenROAD build. The netlist's own effect is
> +62 µm² placed cell area (+0.10 %) and the 0.035 µm wider die.
>
> `python3 layout/digital/build.py --check-input` (in `npm run check:ci`)
> now re-hashes `trng_top.synth.v` and fails if it differs from the hash
> `reports/place_and_route.json` recorded as its input. It does not claim
> the placement is reproducible. It checks only that the committed
> implementation was built from the committed netlist.

## The one command

```sh
python3 layout/digital/build.py       # run P&R, check the artefacts, write the report
```

It drives the already-committed gate-level netlist
[`design/trng_top/trng_top.synth.v`](../../design/trng_top/trng_top.synth.v)
through `klt place-and-route` (OpenROAD under the hood: floorplan → global
and detailed placement → clock-tree synthesis → global and detailed
routing), then runs its own checks over what came back and commits the
artefacts that pass them. Every number quoted below is produced by that
script and lands in [`reports/place_and_route.json`](reports/place_and_route.json);
nothing here is a figure somebody typed in.

Unlike [`design/synth.py`](../../design/synth.py) there is no `--check`
mode. Yosys's mapped netlist is byte-reproducible for the same RTL and
liberty, so a staleness guard is meaningful there. Placement and routing are
seeded but not byte-reproducible across `openroad` builds, thread counts or
host architectures, so there is no "is the committed result stale" question
to ask here. What is committed is one recorded run, carrying enough
provenance (`openroad` version and pinned image digest, `klt` version,
resolved PDK, liberty corner, seed) that another run can be *compared*
against it rather than assumed identical to it.

## What ran, and what it produced

| | |
|---|---|
| Input | `design/trng_top/trng_top.synth.v` — 2505 instances mapped against `gf180mcu_fd_sc_mcu9t5v0` (#143) |
| Tool | `klt place-and-route` → OpenROAD `26Q3-1510-g6cb3f2b704`, `target_stage: route` |
| Liberty corner | `gf180mcu_fd_sc_mcu9t5v0__ss_125C_3v00` (see [Corners](#corners)) |
| Constraint | `clk`, 50 ns period (20 MHz) — see [Timing](#timing) |
| Floorplan | 40 % target utilization, aspect ratio 1.0, 10 µm core margin, site `GF018hv5v_green_sc9` |
| Routing | signal layers Metal2–Metal5 (Metal1 left to pin access and intra-cell geometry) |
| Power | `vddd`/`vss`, `Metal1` followpins rails + `Metal4`/`Metal5` straps, tapcells/endcaps/fillers — see [Power](#power) ([#171][gf171]) |

Committed artefacts:

| file | what it is |
|---|---|
| [`trng_top.def`](trng_top.def) | the routed DEF — OpenROAD's own output, and the re-entry point for any later STA/extraction run; carries the `SPECIALNETS` power grid as of [#171][gf171] |
| [`trng_top.pnr.v`](trng_top.pnr.v) | the **as-built** gate-level netlist (`write_verilog` after CTS and resizing): the netlist a post-route gate-level simulation (#147) or a golden-reference LVS run must use, *not* `klt synthesize`'s pre-CTS one |
| [`trng_top.gds`](trng_top.gds) | the DEF merged with the standard cells' own GDS views — committed as of #170, once the merge's database-unit defect ([klayout-tools#1090][klt1090]) was fixed upstream; see [GDS, DRC and LVS](#gds-drc-and-lvs) |
| [`reports/place_and_route.json`](reports/place_and_route.json) | the full response, the request that produced it, provenance, and this script's own checks (`checks.gds_geometry.status: "ok"`) |
| [`reports/drc.json`](reports/drc.json) | `klt drc` over `trng_top.gds` — the **full envelope**, `schema_version`/`violations`/`coverage`/`provenance` included ([#273][gf273]) |

`layout/digital/lvs.py` (below) writes three more committed artefacts — the
mechanically-generated LVS reference SPICE, the extracted layout-side SPICE,
and [`reports/lvs.json`](reports/lvs.json) — see
[GDS, DRC and LVS](#gds-drc-and-lvs).

## Timing

Reported by OpenROAD's own pre-signoff STA at the requested corner, over an
ideal (SDC-only) clock with global-routing-estimated parasitics — no
extraction, no SPEF, no back-annotation:

| | |
|---|---|
| Worst slack at `ss_125C_3v00`, 50 ns period | **+28.4 ns** |
| Total negative slack | 0 ns |
| `fmax_mhz` (OpenROAD's own report) | 46.4 MHz |
| Setup / hold violations at that corner | 0 / 0 |
| Clock skew after CTS | 0.11 ns |
| Swept worst **hold** slack, all 15 shipped `.lib` corners | **+0.52 ns** |
| Swept worst **setup** slack, all 15 shipped `.lib` corners | **−22.7 ns** |

The last two rows are the ones that need reading carefully, because a
positive worst slack sitting next to a strongly negative *swept* setup slack
looks like a contradiction and is not one. They are different measurements:

- `worst_slack_ns`, `setup_violation_count` and `hold_violation_count` are
  **single-corner** numbers, at the corner the request names.
- `worst_setup_slack_ns` / `worst_hold_slack_ns` come from a second STA
  session that loads **every `.lib` file the library ships** and reports the
  worst value across all of them. This library ships 15, spanning **three
  different supplies** — roughly 1.8 V, 3.3 V and 5.0 V families, three
  process/temperature points each.

The block's ratified supply is **3.3 V** (`design/README.md`), so only 3 of
those 15 decks (`ss`/`tt`/`ff` at 3.00 / 3.30 / 3.60 V) describe an operating
point this block is specified for. The 1.62 / 1.80 / 1.98 V decks are also
the slowest the library ships — `ss_125C_1v62`'s own `inv_1` `cell_fall`
table starts at 0.154 ns against `ss_125C_3v00`'s 0.073 ns at the same
slew/load index point, 2.1× before the extra interconnect delay a weaker
driver pays — so the −22.7 ns is very probably theirs. "Very probably" is as
far as the recorded evidence goes: `klt` returns one number for the whole
sweep and never names the corner that produced it, filed generically upstream
as [klayout-tools#1092][klt1092]. What the recorded evidence does say
outright is that it is *not* the corner this block is implemented and
specified at, which closes with +28.4 ns.

What the sweep *does* establish outright is the hold result: **+0.52 ns worst
hold slack across all 15 decks**, including the fastest ones — and the fast
corner is exactly where hold binds, so that number is a real, unqualified
multi-corner result.

**What may be cited from this, and what may not.** The 50 ns constraint is
this run's own input, not a spec row: no issue in this repository has set a
digital-section Fmax requirement. The ratified requirement the clock rate
has to satisfy is the raw-rate row (`README.md`, [DR-0003][dr3]): > 1 Mbps
sustained at the sampler output, one raw bit per `clk` edge, so > 1 MHz, with
the stretch row at > 4 MHz. This run closes at 20 MHz with 28.4 ns of slack
at a slow-process/hot/−10 %-supply corner, which is 5–20× the rate the spec
asks for — that is a *margin statement about this implementation*, not an
Fmax claim, and not signoff. Corner-swept Fmax, area and power are #145's
deliverable, and it is #145 that gets to state them.

**It has**: [`sim/characterization-digital-sta-area-power.md`](../../sim/characterization-digital-sta-area-power.md)
re-times this directory's committed DEF at fifteen corners (five 3.3 V liberty
decks × three interconnect decks) with OpenRCX-extracted parasitics and a
*propagated* clock, and reports an Fmax floor of **39.80 MHz** at
`ss_125C_3v00` with `max` interconnect, positive setup and hold slack and zero
TNS at every corner. It also reconciles the +28.4 ns this directory reports
above with its own +25.5 ns at the same liberty corner (`nom` interconnect):
2.899 ns of that is extraction versus the global-routing estimate, 0.031 ns is
the real clock tree.

**This characterization runs against the powered DEF ([#171][gf171]).**
#171 re-ran place-and-route to build the PDN, which changed the placement and
the clock tree from the numbers `sim/records/2026-08-17-digital-sta-power-*.md`
recorded (+27.7 → +27.8 ns worst slack, 0.40 → 0.35 ns skew, 2499 → 2502
logical instances) — those earlier records are still accurate statements
about the pre-[#171] netlist and DEF they name and hash, and this
repository's records are append-only, so they stand, but they no longer
describe *this directory's current* committed artefacts.
`sim/records/2026-08-18-digital-sta-power-*.md` superseded them for that
purpose, and was also the **first** run of this kind that sees a supply
network at all: OpenRCX now extracts real rail and strap geometry rather than
finding none ([#183](https://github.com/2AMLogic/gf180-trng/issues/183)).
`sim/records/2026-09-12-digital-sta-power-*.md` supersedes that family in
turn, adding the six `digital`-facing inter-region trunks as an interface load
and the library's own max-transition check
([#233](https://github.com/2AMLogic/gf180-trng/issues/233)); it reports the
same slack, Fmax and area figures. That interface load is a trunk-only
Metal4 arithmetic, and per full-chip PEX evidence
([#232](https://github.com/2AMLogic/gf180-trng/issues/232),
[#242](https://github.com/2AMLogic/gf180-trng/issues/242)) it is a **floor**
on the real added R/C, not the measured value — see
`sim/characterization-digital-sta-area-power.md` §2a for the disclosure.
#147/#177's post-route functional run against the pre-[#171] netlist is
likewise superseded, for that purpose, by
`sim/records/2026-08-18-trng-top-post-route-01.md` (see "What this
establishes, and what it does not" below).

## Corners

The request names its liberty corner explicitly:
**`ss_125C_3v00`** — slow process, 125 °C, 3.00 V.

That is not `klt`'s default. This library is characterised at three supplies,
and `klt`'s nominal-corner resolution is documented to return the **lowest**
of them (`tt_025C_1v80`). Two reasons to override it here:

1. **The block runs at 3.3 V**, not 1.8 V (`design/README.md`: "the block's
   ratified 3.3 V supply"). Timing a 3.3 V block against a 1.8 V deck is not
   conservatism, it is the wrong operating point.
2. **3.00 V / 125 °C / slow process is the ratified binding corner.**
   [DR-0003][dr3]'s raw-rate row binds at `ss` / −10 % supply / +125 °C;
   3.3 V − 10 % = 2.97 V, and `ss_125C_3v00` is the closest deck this library
   ships. Implementing *at* the binding corner is what makes the slack figure
   above mean something.

**The synthesis/P&R corner mismatch is resolved ([#169][gf169]).**
`design/synth.py` used to take `klt`'s nominal-corner pick (`tt_025C_1v80`)
for the netlist this run consumes, so ABC's delay-driven cell/drive-strength
choices came from a 1.8 V timing model even though this P&R re-times
everything at 3.00 V. `design/synth.py` now pins its own liberty corner
explicitly too — **`tt_025C_3v30`**, not `ss_125C_3v00` — and the two scripts
deliberately land on *different* decks for different reasons:

- This P&R run implements *at* the ratified binding corner
  (`ss_125C_3v00`), because that is what makes its own slack figures mean
  something.
- `design/synth.py`'s ABC mapping is a pre-place step with no timing closure
  of its own (`klt synthesize` "does not perform signoff timing analysis");
  mapping it against the same worst-case corner would only bias cell
  selection toward larger-than-typical drive strengths before this script's
  own placement/CTS resizing gets a chance to size anything. `tt_025C_3v30`
  — typical process, the block's real 3.3 V supply — is the conventional
  synthesis target for exactly that reason, and it replaces the old 1.8 V
  pick with the right voltage family either way.

Re-running both scripts against the re-mapped netlist moved the input this
run consumes: `design/trng_top/trng_top.synth.json`'s reported area grew
~0.9 % (110 892 → 111 857 µm², same 2505-instance count, different
cell/drive-strength mix) and its ABC-estimated critical path fell from
16 967 ps to 6 443 ps (an artefact of timing at 3.3 V instead of 1.8 V, not a
signoff number either way — see that report's own `timing` field caveats).
This run's own figures above and in [Area](#area) are from that re-mapped
netlist.

## Area

| | |
|---|---|
| Die (from the request's own 40 % utilization target) | 548.8 × 548.8 µm = **301 209 µm²** |
| Core | 277 092 µm² |
| Achieved utilization | 42.9 % |
| Standard-cell area inside the core | ≈ 116 000 µm² (logical cells only; the 6061 tapcell/endcap/filler instances [#171][gf171] adds fill the rows' remaining gaps and do not enlarge the die) |
| Routed wirelength | 168 038 µm |

**The die figure is an input, not a result.** It follows arithmetically from
the 40 % utilization this run asked for, chosen to leave routing headroom on
a first attempt whose question was whether this design routes at all. Do not
compare it against the `< 0.05 mm²` README row; the number to compare is the
cell area, and even that comparison has caveats:
[`layout/floorplan/README.md`](../floorplan/README.md)'s bottom-up inventory
estimate prices the digital region at 74 485 µm² of cell area from **1655
cells in the 7-track library**, while this run places **2533 logical
instances of 9-track cells** (`checks.components.logical_placed`, 2505
synthesized plus 28 added by `repair_design`'s buffering during
placement/CTS — `checks.components.delta_vs_synthesized`; the DEF's own
`COMPONENTS` count of 8594 is that plus the 6061 physical-only
tapcell/endcap/filler instances [#171][gf171] inserts, which
`checks.components` subtracts before comparing against the netlist) — taller rows, and a different (post-synthesis,
real) cell count. The two numbers are not like-for-like, and reconciling them against
the ratified area row is #145's job (with [#150][gf150] owning the row
itself). What can be said here: real synthesis and placement land the digital
section's cell area ~1.6× above the inventory estimate, and the estimate was
already 2.5× the whole-block budget.

**#145 has since done that reconciliation**
([`sim/characterization-digital-sta-area-power.md`](../../sim/characterization-digital-sta-area-power.md)
§3): the placed cell area (logical instances plus [#171][gf171]'s
tapcell/endcap/filler population) is **118 975.4 µm²**, ×1.597 the inventory
estimate, splitting into ×1.243 from cell count/mix, ×1.257 from 9-track
rather than 7-track rows, and a further ×1.023 from the power-delivery cells
that logical-instance count above excludes. The area row itself is still
[#150][gf150]'s.

## Power

### The power distribution network ([#171][gf171])

Until #171 this flow built **no power delivery at all** — see [Two defects
this bring-up found](#two-defects-this-bring-up-found) #2, which is where
that gap and its upstream fix are documented. What it builds now, via `klt
place-and-route`'s `request.power` block ([klayout-tools#1120][klt1120],
`build.py`'s own `POWER` constant):

| | |
|---|---|
| Supply / ground net | `vddd` / `vss` — **not** the tool's `VDD`/`VSS` default; see below |
| Rails | `Metal1`, 0.90 µm wide, 5.04 µm pitch, `followpins` (the standard-cell rows' own rails) |
| Straps | `Metal4` 4.48 µm / 44.8 µm pitch / 22.4 µm offset; `Metal5` 4.48 µm / 89.6 µm pitch / 44.8 µm offset |
| Well/substrate ties | 265 × `gf180mcu_fd_sc_mcu9t5v0__filltie` at OpenROAD's `tapcell -distance 100` |
| Row ends | 208 × `gf180mcu_fd_sc_mcu9t5v0__endcap` |
| Fillers | 5588 instances across the library's seven `fill_*` widths |
| `SPECIALNETS` in the DEF | 2 nets (`checks.def.special_nets: true`, was `false`) |
| Top-level supply pins | `vddd`, `vss` — the DEF's `PINS` count goes 109 → 111 |

The strap geometry is not invented here: it is
`The-OpenROAD-Project/OpenROAD-flow-scripts`' own gf180 platform PDN config
(`flow/platforms/gf180/openROAD/pdn/pdn_grid_strategy_9t_6M.cfg`, read
2026-08-17), the `9t`/6-metal strategy matching this run's own
`GF018hv5v_green_sc9` site and `Metal2`–`Metal5` routing range. Two knobs of
that config have no `request.power` field to carry them and are therefore
not reproduced — its `Metal4` stripe's `-spacing 0.56`, and the
`-max_columns`/`-ongrid`/`-split_cuts` tuning on its two `add_pdn_connect`
calls, which are the platform's own answer to a via-array DRC question.
Filed generically upstream as [klayout-tools#1133][klt1133], per this
repository's friction protocol. The resulting geometry is checked rather than
assumed: `klt drc` over the merged GDS is **clean** (see [DRC](#drc)) — but
"DRC-clean on this design" is standing in for "built the way the platform
says", and that substitution is the reason the issue was filed.

**Why `vddd`/`vss` and not `VDD`/`VSS`.** `vddd` is the digital domain's
supply name everywhere else in this repository —
[`layout/floorplan/README.md`](../floorplan/README.md)'s four-domain star and
`layout/floorplan/floorplan.py`'s own region table. A routed DEF whose
`SPECIALNETS` said `VDD` would be a block that cannot be composed onto that
star without a rename. The standard cells' own LEF power/ground *pins* stay
named `VDD`/`VSS` either way; `add_global_connection -pin_pattern` maps from
those fixed pin names onto whichever net this block asks for.

### Isolation from the entropy supplies — checked, not asserted

[`layout/floorplan/README.md`](../floorplan/README.md)'s mitigation 2 requires
four supply domains (`vddr1`, `vddr2`, `vdd`, `vddd`) to be separate branches
from one star point, and states the layout-side half explicitly: *"the digital
domain never shares a strap segment with an entropy domain."* This section is
the aggressor that requirement exists for — 708 flip-flops on one external
`clk` — so a PDN built without it in mind would undo that mitigation while
passing DRC and looking entirely ordinary.

`build.py`'s `_power_isolation_check` reads the **routed DEF's own
`SPECIALNETS` section** (not the request that produced it) and asserts set
equality against `{vddd, vss}`, separately reporting any of
`vddr1`/`vddr2`/`vdd` found. This run:
`checks.power_isolation.status: "ok"`, `found_nets: ["vddd", "vss"]`,
`entropy_supply_nets_present: []`. Independently: the string `vddr1`/`vddr2`
does not occur anywhere in `trng_top.def`, and neither does a bare `vdd`
token.

**What that does and does not establish.** It establishes that *this* block's
power geometry is confined to this block's own two supplies, and that a
regression in `build.py`'s `power_net`/`ground_net` — or an upstream defect
pulling an unexpected net into the grid — fails a committed check rather than
passing silently. It does **not** establish the star topology itself. This is
a standalone place-and-route of the digital section: its input netlist
contains no ring instance, no ring port and no entropy supply net of any
kind, so the composition the floorplan constraint ultimately governs — where
`vddd` meets `vddr1`/`vddr2`/`vdd`, and through how much shared metal —
happens in [`layout/floorplan/`](../floorplan/), which is still an empty
`digital` region. What this block now brings to that composition is a PDN
that terminates at its own `vddd`/`vss` pins and nowhere else.

### Estimated power

`estimated_power_mw: 6.6` — OpenROAD's own `report_power` at
`ss_125C_3v00` with estimated (not extracted) parasitics and no activity
annotation beyond its defaults. It is recorded because the tool reports it;
it is **not** a power result, it does not supersede
`design/digital_power_estimate.py`, and it is not a corner sweep.

**#145 has since done that comparison** —
[`sim/characterization-digital-sta-area-power.md`](../../sim/characterization-digital-sta-area-power.md),
from this directory's own committed, powered DEF re-timed at fifteen corners
with extracted parasitics: 8.56 mW at this corner at 20 MHz and 432 µW at
DR-0003's ratified 1 MHz raw rate, under a declared 0.25 transitions/net/cycle
activity, against the library-based estimate's 16.7 µW. Leakage at this
corner is 3.95 µW, up from 1.39 µW pre-[#171][gf171] — [#171]'s
tapcell/endcap/filler population now contributes its own leakage, on top of
the logic's (that document's §4.1/§4.2). The dynamic-power delta and its
causes are that document's §4; nothing in this directory is edited by it.

## Two defects this bring-up found

The point of this repository is to run a real design through an open flow and
report what breaks. Two things did. Both are filed generically against the
tool, per this repository's friction protocol, and both are visible in the
committed report rather than smoothed over.

### 1. The merged GDS was geometrically wrong — [klayout-tools#1090][klt1090], fixed

`klt place-and-route` also merges the routed DEF with the standard cells' own
GDS views and returns a `gds_path`. That stream **was** 2× too big in every
DEF-derived dimension: placement coordinates, routed wires and via cells all
doubled, while the standard-cell geometry stayed at its true size, so the
cells sat on a stretched grid where abutting rows did not abut, rails did not
join, and the routing did not land on the pins it was routed to.

Root cause, reduced to eight lines: the merge set the LEF/DEF reader's target
database unit from the tech LEF (this PDK declares `DATABASE MICRONS 2000`,
i.e. 0.5 nm), read the DEF correctly at that unit, and then read the
standard-cell GDS — written at 1000 units/µm — into the *same* layout.
KLayout adopted the incoming stream's unit and did not rescale the geometry
already there, so everything from the DEF silently doubled. The DEF was
fine; only the merged GDS was wrong.

**Fixed upstream**, [klayout-tools#1114][klt1114], merged at commit
`a65e2bb4fe199725af49c6bf1ba37bd3d6be4cc7` and closing #1090. This repository
re-pinned `klt` past that fix — to `e501e261c1ac9b96a08e2c3569bf6207123a5b6a`,
which also carries [klayout-tools#1115][klt1115] (a gf180mcu DRC deck
correctness fix that landed on `main` immediately after #1114, with no other
tool gap in between) — in [#170][gf170]:

- `build.py`'s `_gds_geometry_check` compares the merged stream's own extent
  against the DEF's own `DIEAREA` and records the ratio in the committed
  report. `checks.gds_geometry.status` is now `"ok"`
  (`gds_over_def_ratio: [1.0, 1.0]`, previously `[2.0, 2.0]`).
- `trng_top.gds` is now committed, and `klt drc`/`klt lvs` ran over it for
  the first time — see [GDS, DRC and LVS](#gds-drc-and-lvs) below.
- The symptom that led to the original diagnosis is worth keeping on record,
  because it is the kind of evidence that reads like a design problem and is
  not: DRC over the pre-fix merged stream reported ~1000 `metal1`
  spacing/width violations, **100 % of them between a router-inserted via
  cell's landing pad and standard-cell metal1** — two coordinate systems,
  not a routing failure. None of those ~1000 recurred post-fix; what #170
  was left with was 149 violations of a single different rule
  (`nwell.space.1`), attributable to a different cause — defect #2 below —
  and #171 closed those too. `klt drc` over `trng_top.gds` is now clean; see
  [GDS, DRC and LVS](#gds-drc-and-lvs).

### 2. There was no power delivery at all — [klayout-tools#1091][klt1091], fixed

The flow's stages are floorplan → place → CTS → route, and until
[klayout-tools#1120][klt1120] nothing in that sequence connected a supply.
The generated Tcl never called `global_connect` or `pdngen`, and inserted no
tapcells, endcaps or filler cells. It showed up in the committed report as
`checks.def.special_nets: false` — the routed DEF had no `SPECIALNETS`
section, so:

- every standard cell's `VDD`/`VSS` pin belonged to no net,
- there were no rails, straps or rings,
- there were no well/substrate ties, and the rows were discontinuous wherever
  placement left a gap.

`status: "ok"` from this verb therefore meant "the signals routed", not "this
block is implemented" — and the gap was directly measurable rather than only
inferred: every one of the 149 `nwell.space.1` violations `klt drc` reported
over the #170 `trng_top.gds` traced to it, and the `klt lvs` mismatch against
`trng_top.pnr.v` (7694 mismatches) was dominated by the same missing
`VDD`/`VSS` connectivity.

**Fixed upstream**, [klayout-tools#1120][klt1120], merged at commit
`9c71bb6741f20be19bf94b847832803505042ec6` and closing #1091: an optional
`request.power` block (net names plus `straps[]` geometry) driving
`tapcell` + `add_global_connection`/`global_connect` + `pdngen` at the end of
the floorplan stage, and `filler_placement` + a second `global_connect` at
the end of the route stage. This repository re-pinned `klt` to exactly that
commit and sends the block, in [#171][gf171]:

- `checks.def.special_nets` is now `true`; the routed DEF carries a
  `SPECIALNETS` section with 2 nets and real rail/strap geometry, and
  `PINS` grows from 109 to 111 (the block's own `vddd`/`vss` supply pins).
- 265 tapcells, 208 endcaps and 5663 fillers are placed — see
  [Power](#power) for the full grid, and for the isolation check the
  floorplan's own star-routing requirement demands.
- `klt drc` over the merged GDS goes from **149 violations to clean**: all
  149 were the missing fillers, and inserting them closed every one.
- `klt lvs` goes from **7694 mismatches to 9** (later **8**, [#186][gf186]),
  with the `net.split`/`net.merged` cascade gone entirely — see
  [LVS](#lvs) for what the residuals are.

What this does **not** fix is composition: this is still a standalone
place-and-route with no pad/IO ring and no placement inside
`layout/floorplan/`'s own guarded `digital` region.

## GDS, DRC and LVS

```sh
python3 layout/digital/build.py       # (the same command as above) also writes trng_top.gds + reports/drc.json now that the geometry check passes
python3 layout/digital/lvs.py         # generate the LVS reference, extract the layout side, run klt lvs, write reports/lvs.json
```

Both were blocked from the start of this bring-up by the DEF→GDS merge
defect above until it was fixed upstream and this repository re-pinned past
it ([#170][gf170]). `checks.gds_geometry.status` in
[`reports/place_and_route.json`](reports/place_and_route.json) is now
`"ok"`, so `trng_top.gds` is committed and `klt drc`/`klt lvs` ran over a
geometrically valid stream for the first time.

### DRC

`klt drc trng_top.gds --deck gf180mcu`: **clean, 0 violations**
([`reports/drc.json`](reports/drc.json)).

That verdict is [#171][gf171]'s, and it is the interesting part of this
section. #170's run over the same design reported **149 violations, every
one of them `nwell.space.1`** (DRM 7.4 Nwell, `NW.2a` — minimum
equipotential Nwell-to-Nwell spacing, 0.6 µm), and traced them by hand to a
single cause: this flow inserted no filler cells, so every gap detailed
placement left between two cells was a gap in the Nwell too. The
cross-check #170 recorded is worth keeping, because it is what makes the
before/after a measurement rather than a coincidence — its first reported
violation sat at (57980, 367410)–(58500, 372100), inside a two-site gap on
row 34 between `u_interface/_1808_` (`mux2_1`, right edge x=57120) and
`u_interface/_1546_` (`aoi22_1`, left edge x=59360), and all 149 violation
regions were exactly 0.26 µm wide: each cell's own Nwell stops short of the
cell's outer edge, so two non-abutting cells' wells fall short of each other
by a constant.

#171 inserts 5663 filler cells (plus 265 tapcells and 208 endcaps) into
exactly those gaps, and the count goes to zero. Nothing was waived, no rule
was scoped away, and the deck is the same `gf180mcu` deck every other cell
in this repository is checked against — `layout/README.md`'s
["Baseline-relative, not absolute"](../README.md) conventions apply here as
everywhere else.

[`reports/drc.json`](reports/drc.json) commits the **whole `klt drc`
envelope**, per-violation `violations` array included. Until [#273][gf273]
it committed a four-field digest instead (verdict, deck, violation count,
rule counts), on the reasoning that the per-violation dump "runs to megabytes
over a design this size". That reasoning only holds for a *dirty* run: this
one is clean, so `violations` is an empty array and the whole envelope is
5.4 KB. What the digest cost, meanwhile, was real — with no
`schema_version`, no `violations` array and no `provenance` block, `klt
signoff` could not classify the file as DRC evidence at all, so this clean
run graded `unmet`/`no_evidence` on T1 item 3 (see
[`signoff/README.md`](../../signoff/README.md)). Re-emit it at any time with
`python3 layout/digital/build.py --drc-only`, which re-runs `klt drc` over
the *committed* `trng_top.gds` without re-deriving it through a fresh
(stochastic, hours-long) place-and-route.

**What a clean verdict here does not mean.** It is a *deck-relative*
statement: the gf180mcu deck this repository pins does not model every rule
in the DRM (its own `coverage` block names what it checks and what it
skips), and this run's clean result is bounded by that, exactly as
`layout/README.md` says for every other cell here. In particular the
tapcell spacing is OpenROAD's `tapcell -distance 100` — ORFS's own gf180
platform value, not a latch-up rule this deck independently enforces. The
tie *distance* is measured separately, on the committed stream, by
[Tap distance](#tap-distance) below. It also remains true that a
clean DRC over a standalone core with no IO ring is not a signoff DRC over
a chip.

### Tap distance

[`layout/digital/tap_distance.py`](tap_distance.py) measures the well and
substrate tie *distance* on the committed `trng_top.gds` ([#448][gf448]).
This is a different question from the ERC section's `erc.missing_tie`
(a well has a tie at all, `reports/erc-supply.json`, unchanged); a well with
a connected tap can still have a diffusion too far from it. The
configured `tapcell -distance 100` is a placement input and is not treated
as evidence of compliance.

**Rule source.** GF180MCU Design Rule Manual §14.3.1 *Core Latch-up Rules and
Guidelines* ([open-PDK documentation page][gf-lu], retrieved 2026-10-10).
No executable deck carries it: the PDK's KLayout decks (variant `gf180mcuD`)
code no `LU.*` rule, and `klt deck rules --deck gf180mcu` lists no
tie-distance rule, so the limits are transcribed from the DRM text into
[`tap-distance-spec.json`](tap-distance-spec.json), which holds the full
rationale. The table has an `LV` (3.3 V) and an `MV` (5 V/6 V) column and
three sub-cases keyed on a well clearance: LV is 50 / 30 / 15 µm, **MV is
15 µm in every sub-case**. This library (`gf180mcu_fd_sc_mcu9t5v0`) is 5 V:
the tool verifies every gate in the stream lies inside DualGate (55/0)
before applying the MV column, and reports the rule unsupported otherwise.

| Rule | Subject (every boundary point of) | Must be within | of a tap on |
|---|---|---|---|
| `LU.4` | `PCOMP` inside Nwell | 15 µm (MV) | an `NCOMP` in the *same* Nwell island, wired to the VDD side |
| `LU.3` | `NCOMP` outside Nwell | 15 µm (MV) | a `PCOMP` outside Nwell, wired to the VSS side |

**Distance definition.** Euclidean distance from each point on the boundary
of a subject polygon to the nearest point of a qualifying tap diffusion
polygon (edge to edge, not to a contact or centre). Layer algebra is the
PDK's own `main.drc`: `ncomp = Comp & Nplus`, `pcomp = Comp & Pplus`,
`ntap = ncomp & Nwell`, `ptap = pcomp − Nwell`. The measurement
Minkowski-sums the taps with an inscribed 128-gon (so a "covered" point is
truly within range; the error is toward reporting a violation) and bisects
to 0.005 µm; the report states the resulting error bound.

**Tap identity.** A tap counts only if its extracted net carries the
required rail's name (connectivity: tap diffusion → Contact → Metal1 → … →
Metal5, with 34/10 and 81/10 text as names; `VDD`/`vddd` and `VSS`/`vss` are
the two alias pairs the ERC spec already documents). A tap on the other
rail, on neither, or on a net carrying both is excluded and counted in
`tap_identity`; the report also gives the geometry-only worst distance so the
effect of the exclusion is visible.

**Report.** [`reports/tap-distance.json`](reports/tap-distance.json) records
the stream SHA-256 and the spec SHA-256, the limits, the maximum distance with
resolution and error bound, the five worst wells with coordinates, every
Nwell island's extent and result (coverage boundaries), an uncovered-boundary
profile at 0.5/1/2/3/4× the limit, and an explicit status for every rule in
the spec: `pass`, `fail`, `not_applicable` (the triggering geometry — DNWELL
for `LU.1`/`LU.2`, NAT for `LU.5` — is provably absent) or `unsupported`
(`LU.7`–`LU.10` guidelines, DRM §14.3.2 I/O latch-up). The overall verdict is
`pass` only when every rule is decided and none failed; with unsupported
rules it is at best `incomplete`.

```sh
python3 layout/digital/tap_distance.py --check    # fresh run == committed report
python3 layout/digital/tap_distance.py --write    # regenerate (about 20 s)
npm run test:layout                                    # includes the fixtures
```

The fixtures (`layout/tests/test_digital_tap_distance.py`) cover a compliant
arrangement, an over-limit gap, and a nearby tap wired to the wrong supply
(geometry alone would pass, identity makes it fail). It needs the `klayout`
Python module, the engine `klt` runs on; `--check` self-skips without it
unless `--require-tools`.

CI coverage (#458): `npm run check:digital-tap-distance` is part of
`npm run check:ci` and the PR workflow, where it prints that the module is
missing and skips on a hosted runner. The nightly layout job in
`.github/workflows/pdk-nightly.yml` runs the mandatory form,
`python3 layout/digital/tap_distance.py --check --require-tools`, under
`if: always()`, so it reports on its own even when an earlier validation step
failed. Both are read-only and test report freshness (the report follows from
the current measuring program), not physical compliance.

**Result on the committed stream.** Measured against the MV column, the
placement does **not** meet `LU.3`/`LU.4`: the worst boundary-to-tap
distance is 49.73 µm (`LU.4`) and 49.69 µm (`LU.3`) against a 15 µm limit,
with 35 of 36 Nwell islands over the limit. The same distances sit just inside the LV
column's 50 µm sub-case, which is consistent with the platform's
`-distance 100` having been chosen for 3.3 V cells. This is a measurement
result of the as-built geometry, recorded here without a design change; whether to re-place ties is
tracked separately in [#449][gf449]. The §14.3.1 column assignment is read from the published
table and has **not** been confirmed against the controlled DRM (none was
available; a 2026-10-11 follow-up search of public sources, recorded in
[DR-0030](../../spec/decision-records/DR-0030-digital-latch-up-source-confirmation-outcome.md),
found only the unversioned rendered page and a commit-pinned open-PDK
transcription, and the table's `MV` header is not defined in either, so the
MV reading remains an unconfirmed working interpretation, #486):
[DR-0029](../../spec/decision-records/DR-0029-digital-latch-up-tie-distance-column-disposition.md)
records the source reconciliation, the reproduction of this measurement
(`--check --require-tools` exits 0 because the report is current; the physical
verdict is still `fail`), the recommended placement remedy and the artifact
refresh it would require. #449 stays open.

### LVS

[`layout/digital/lvs.py`](lvs.py) bridges `trng_top.pnr.v` (the as-built,
post-CTS netlist — not `design/trng_top/trng_top.synth.v`'s pre-place
mapping) into the black-box SPICE shape `klt extract --abstract-cells`
already resolves for the layout side, then runs `klt lvs` between the two —
see the script's own module docstring for the full pipeline and the
reasoning for a cell-instance-granularity comparison rather than a
transistor-level one. Result ([`reports/lvs.json`](reports/lvs.json) — the
**full `klt lvs` envelope** since [#273][gf273], `schema_version`/
`mismatches`/`power_connectivity`/`body_verification`/`provenance` included,
where it used to be a five-field digest; this script's own record of how the
reference netlist was generated keeps its place in the report under
`reference_generation`, beside rather than shadowing the envelope's own
`reference` field):

| | | #170 |
|---|---|---|
| Verdict | `match` | `mismatch` |
| Mismatch count | 6 (`error_count: 0`) | 7694 |
| `net.merged` / `net.split` | 0 / 0 | 3786 / 411 |
| `net.unmatched` | 0 | 0 |
| `topology` | 6, all severity `warning` | 3497 |
| Nets (layout / reference) | 2547 / 2547, 2996 matched | 4165 / 7519 |
| Pins (layout / reference) | 111 / 111 | 109 / 109 |
| Devices (layout / reference) | 0 / 0 — comparison is cell-instance-granularity (`--abstract-cells`), not transistor-level; see the script's docstring | 0 / 0 |

**Pin count is 111, not 109, since [#224][gf224].** `vddd`/`vss` are now
promoted to real top-level `.SUBCKT trng_top` pins on both sides of this
check, not left as internal-only nets: `_top_pins()` folds in the two
supply net names `_power_pin_names()` reads from the committed
`place_and_route.json`'s own `power` block, alongside the 109 Verilog chip
I/O ports. This closes the gap `design/floorplan_netlist.py`'s composed
inter-region declaration depended on — see
[`layout/floorplan/README.md`](../floorplan/README.md), "The supply/ground
star point lands off-die," for what that unblocks at the composed-floorplan
level. The re-run above is
otherwise identical to the pre-#224 state: `status: match`,
`mismatch_count: 6` (the same six benign `u_interface` warnings), `error_
count: 0`.

**Power connectivity is now inside the comparison.** #170's 7694 mismatches
were one finding wearing 7694 hats: with no PDN, each cell's local Metal1
rail segment was wired to whatever it physically abutted, so the layout had
no continuous supply net for the reference's design intent to match, and
`lvs.py` gave every instance's `VDD`/`VSS` its own dangling per-instance
reference net. #171 removes both halves of that. `lvs.py` now reads the
supply net names from [`reports/place_and_route.json`](reports/place_and_route.json)'s
own `power` block — the record of how the committed GDS was actually built —
and ties every instance's `VDD`/`VSS` to them, and it recovers the 6061
physical-only tapcell/endcap/filler instances out of the committed DEF's
`COMPONENTS` section, because `write_verilog -remove_cells` strips them from
`trng_top.pnr.v` while they remain real drawn geometry in the GDS. Both
sides now carry the same 8594 instances with identical per-master counts
(verified directly), and the `net.split`/`net.merged` cascade is gone.

**What the original 8 residuals were, and what #186 fixed.** Six of the
original seven `topology` entries were severity `warning`, not `error`:
ambiguous net pairings the comparer resolved structurally anyway (six
symmetric `u_interface` nets, each a synthesis-inserted `tiel` tie-cell
driving its own unrouted, single-terminal net — see "Resolved" below for
why these six are still present and are not a defect). The remaining two
errors (one `net.unmatched`, one `topology`) were both one cell.
`clkload13` is a CTS clock-*load* dummy — OpenROAD inserts it purely for
capacitance, so its `ZN` output is unconnected by construction, and
`trng_top.pnr.v` instantiates it as `gf180mcu_fd_sc_mcu9t5v0__inv_8
clkload13 (.I(clknet_leaf_48_clk));` with no other port.

Before #186, `lvs.py` derived each cell type's reference interface from the
ports its instances actually connect, so `inv_8` — whose only instance
connects just `I` — got a three-pin `.SUBCKT ... I VDD VSS` against the
layout's four-pin `I VDD VSS ZN`. That interface mismatch was why one
instance *on each side* reported "subcircuit instance could not be
matched" — two separate `topology` errors, `mismatch_count: 9`. #186 fixed
that: `_library_cell_pins()` now reads each cell type's pin list back out of
`klt extract --abstract-cells`'s own output instead of inferring it from
observed connections, so `inv_8` correctly gets its real four-pin interface
on both sides (`Xclkload13 clknet_leaf_48_clk vddd vss ZN$clkload13
gf180mcu_fd_sc_mcu9t5v0__inv_8` in the regenerated reference). That closed
one of the two `topology` errors — `mismatch_count: 9 → 8`.

**The second `topology` error did not close, and turned out to be the same
defect as the pre-existing `net.unmatched` residual, not a second one.**
With the interface now matching, `klt lvs`'s comparer can structurally pair
`Xclkload13` (reference) against its layout-side counterpart by cell type —
but the pairing still fails, because the two sides disagree about what net
`clkload13`'s `I` pin is on: `trng_top.def` lists nine terminals on
`clknet_leaf_48_clk` (a buffer output, seven flip-flop `CLK` pins and
`clkload13 I`) and nine `Via1_HV` pin-access vias to serve them — all nine
present, verified by direct count — yet `klt extract --abstract-cells`
resolves eight of the nine terminals onto `clknet_leaf_48_clk` and
`clkload13`'s `I` onto its own isolated, unnamed island net instead
(`trng_top.extracted.spice`: `Xgf180mcu_fd_sc_mcu9t5v0__inv_8_0 $2320 vddd
vss $2208`). That single unresolved terminal is *both* the `net.unmatched`
entry (the layout's copy of `clknet_leaf_48_clk` is missing this one
terminal) and the reason the `topology` pairing still fails (the instance's
connectivity, not just its interface, has to match too) — one root cause,
two report entries, and #186's interface fix could only ever close the
entry it actually targeted.

Placement/orientation arithmetic against `gf180mcu_fd_sc_mcu9t5v0__inv_8`'s
LEF puts one of the nine vias squarely inside the cell's `I`-pin geometry
(the LEF declares `I` as two disjoint Metal1 rectangles; the via lands in
the first one) — so the drawn routing is not obviously missing anything a
`klt components` scan can see. That pointed more at an extraction-side
pin/net unification gap for this two-rectangle pin shape than at a
drawn-geometry defect, but a generic (deck-free) connectivity scan could not
rule out a real transistor-level gap either. Filed generically upstream as
[klayout-tools#1181][klt1181] and tracked here as [#187][gf187] — see
"Resolved" immediately below for how that upstream chain played out.

`clkload13` is new to *this* clock tree; #170's run had no `inv_8` instance
at all, which is the module docstring's own point about placement and CTS
not being byte-reproducible run to run.

**Resolved (2026-09-05): klayout-tools v0.4.0 fixes the `clkload13`
defect.** [#187][gf187]'s upstream chain
([klayout-tools#1181][klt1181] → [#1183][klt1183] → [#1296][klt1296] →
[PR #1310][klt1310], merge commit `ff5c8a0f`) landed a fix
(`_polygon_interior_point()`, probing a merged local-net island's interior
rather than its bounding-box centre, which can land outside a concave
island) that PyPI shipped in `klayout-tools` `v0.4.0`
(2026-09-05T18:41:28Z). Re-pinning this repository's `klt` to that release
and re-running `python3 layout/digital/lvs.py` against the same committed
`trng_top.gds`/`trng_top.pnr.v` confirms the fix directly, not just by
citation: `trng_top.extracted.spice`'s `inv_8` instance (`clkload13`) now
reads

```
Xgf180mcu_fd_sc_mcu9t5v0__inv_8_0 clknet_leaf_48_clk vddd vss \$2208
```

— its `I` pin (first position) resolves onto `clknet_leaf_48_clk`, not the
isolated `\$2320` island the pre-fix `klt` produced. `net.unmatched` drops
from 1 to 0 and the `topology` error for this instance is gone, taking
`mismatch_count` from 8 to 6 and `error_count` to 0.

**The remaining `mismatch_count: 6` is the same six `severity: warning`
`u_interface` entries described above, unaffected by this fix** (they
predate #187 and were never part of its diagnosis): six `gf180mcu_fd_sc_
mcu9t5v0__tiel` tie-cell instances, each driving its own single-terminal,
unrouted net (`u_interface/_1249_` through `_1254_` on the reference side).
Because none of the six carries a second terminal to disambiguate it from
its five siblings, `--def-net-names` — which reads DEF net names off a
*routed*-metal shape property (`docs/cli/extract.md`'s own scoping) — has no
routed shape to read a name from on any of them, so all six extract as
anonymous `$<id>`s instead of their real DEF names. `klt lvs`'s comparer
still proves every one of the six layout-side nets structurally equivalent
to some reference-side net (topology matches; `error_count: 0`), it just
cannot tell *which* of the six symmetric candidates pairs with which without
a name to go on, so it reports the ambiguity as a `severity: "warning"`
disclosure rather than silently guessing. Per `klt lvs`'s own documented
`status`/`mismatch_count` relationship: "`mismatch_count` ... [c]an be
nonzero even when `status` is `"match"` — a `severity: "warning"` entry ...
does not change the verdict," and `error_count` is `0` "on a `status:
"match"` report exactly." Both hold here: `status: "match"`,
`mismatch_count: 6`, `error_count: 0`.

Filed generically upstream as a capability request (recovering a name for
an unrouted, single-pin net has no shape for `--def-net-names` to read a
property from today):
[klayout-tools#1488][klt1488] — not a blocker for this issue, since the six
entries are advisory, not a connectivity defect, but worth tracking so a
future `--def-net-names` improvement could resolve the ambiguity outright
rather than requiring a caller to reason about it by hand each time.

Neither this run nor #187's original filing ever found functional weight in
either residual — `clkload13` drives nothing, and the six `tiel` nets are
each a synthesis-inserted constant tap with no fan-out — but the distinction
matters for what "resolved" means here: the `net.unmatched`/`topology`
*error* pair this issue tracked is fixed and independently re-verified
against the committed layout, not waved into a `match` on faith in an
upstream PR's own numbers.

**Attributing those errors cost more than it should have, twice over now.**
`klt lvs`'s mismatch entries for an unmatched subcircuit carry `net: null`,
`device: null` and no circuit or instance name at all, so the report says
how many circuits failed to pair and never which — the original three-error
attribution above came from diffing the two SPICE files' `.SUBCKT` name sets
by hand, and #186's re-diagnosis of the remaining two (after its own fix
closed the third) came from the same kind of by-hand cross-referencing
against `trng_top.def`/the standard-cell LEF. Filed generically upstream as
[klayout-tools#1132][klt1132], along with the smaller observation that
`category_counts` aggregates `error` and `warning` severities into one
number (pre-#186 this run's `"topology": 8` was six warnings and two
errors; post-#186 it was `"topology": 7`, six warnings and one error).
That smaller observation is fixed as of the same `klt` build this section's
"Resolved" note above cites: the response now also carries `error_count`
and `category_error_counts` (a per-category breakdown counting only
`severity: "error"` entries), which is exactly how the current
`"topology": 6, all severity warning` / `error_count: 0` state above is
distinguished from a `"topology": 6` reading that still mixed severities.

## SDF export

```sh
python3 layout/digital/gen_sdf.py            # (re-)generate, write the SDF + report
python3 layout/digital/gen_sdf.py --check    # regenerate to scratch and diff; never writes
```

`--check` runs unattended in the nightly workflow
([`pdk-nightly.yml`](../../.github/workflows/pdk-nightly.yml), `npm run
check:digital-sdf`), using the pinned OpenROAD container when no native
`openroad` is present and failing, not skipping, if OpenROAD, Docker or the
PDK's `gf180mcu_fd_sc_mcu9t5v0` files are unavailable.

`trng_top.pnr.v` on its own says nothing about *time*. What consumes it — the
post-route gate-level re-run of the digital functional suite,
[`sim/tb/trng-top-post-route/`](../../sim/tb/trng-top-post-route/) ([#147][gf147])
— needs delays attached, so this script writes them:

| file | what it is |
|---|---|
| [`trng_top.sdf`](trng_top.sdf) | per-instance **cell** delays for `trng_top.pnr.v`, from OpenSTA over the `ss_125C_3v00` liberty deck |
| [`reports/sdf_export.json`](reports/sdf_export.json) | provenance plus the coverage statement, machine-readable |

**What it models, and what it deliberately does not.** OpenSTA links the
as-built netlist against the resolved liberty and writes the delays it
computes from the library timing arcs at each net's own fan-out: real
per-instance cell delay from the CTS-buffered, resized netlist, with **zero
interconnect (wire) delay** — the same lumped, zero-length-net assumption a
pre-layout SDF makes.

The obvious better answer, real routed parasitics, is *worse* here and that is
why it was not taken. `klt place-and-route`'s own `request.post_route_sdf`
would write an SDF from a session with extracted parasitics — but it extracts
them from the merged DEF→GDS stream, and that merge is geometrically wrong for
this design by a factor of two in every DEF-derived dimension
([klayout-tools#1090][klt1090], defect #1 under
[Two defects this bring-up found](#two-defects-this-bring-up-found)). An SDF
whose interconnect delays are wrong by a data-dependent factor is worse than
one that models none, and — unlike "no wire delay", which is a stated,
one-line limitation — it is not distinguishable from a correct run without
re-deriving the geometry bug's effect on every net's RC.

Two further gaps belong to Icarus Verilog 13.0, the simulator that consumes
this SDF, and are generic to Icarus + `write_sdf` + this cell library rather
than to this design:

1. **`TIMINGCHECK` sections are not applied at all — and neither are the cell
   models' own timing checks.** Icarus implements no SDF `TIMINGCHECK`
   annotation, so all 708 of them (one per flop) are dropped; and it
   implements no `$setup`/`$hold`/`$width` either, so the placeholder checks
   in the library's own `specify` blocks do not run as a fallback (it warns
   `Timing checks are not supported` once per check while elaborating). The
   consequence to state plainly: a gate-level run through this path performs
   **no setup/hold checking whatsoever** and a run that reports no violation
   is not evidence that a constraint was met. Setup/hold **signoff** stays
   with OpenROAD's own STA, above, and with [#145][gf145]. That `klt`'s
   response reports `annotated: true` without distinguishing this case from a
   fully-annotated one is filed generically upstream as
   [klayout-tools#1102][klt1102].
2. **A minority of `IOPATH` arcs cannot be annotated.** Icarus rejects an
   `ifnone`-qualified edge-sensitive `specify` path at compile time — the shape
   `xor`/`xnor`/`mux`/`addf`/`addh` use for their select/toggle inputs — so
   those arcs never exist at simulation time and the SDF entry for them cannot
   apply. `gen_sdf.py` derives the exact `(cell, from, to)` list mechanically
   from the library's own Verilog and drops those entries, rather than letting
   them raise a diagnostic that would (correctly) fail the whole run; the
   count is in `reports/sdf_export.json`'s `coverage` block and in the
   evidence record.

Unlike P&R itself, this artefact **is** byte-reproducible for the same netlist
and liberty (no placement seed is involved), so `--check` is meaningful and
regenerates to scratch to diff against what is committed.

## What this establishes, and what it does not

**Establishes.** A gf180mcu digital place-and-route path exists, runs
cold-start from one committed script, and takes this design's real 2500-cell
gate-level netlist to a fully routed, **power-delivered** DEF: 0 setup
violations, 0 hold violations and 0 antenna violations at the ratified
binding corner, 0 routing DRC violations by the router's own check,
+0.52 ns worst hold slack across all 15 shipped liberty corners, and an
as-built netlist that matches the DEF instance-for-instance once the
physical-only cells are subtracted (`checks.components`). The question #111
was filed to answer — *is there any path at all for the digital section's
physical implementation?* — is answered yes, with numbers.

#170 added a geometrically valid, committed GDS
(`checks.gds_geometry.status: "ok"`), the first `klt drc` verdict over it,
and the first `klt lvs` result against the as-built netlist. [#171][gf171]
added the power delivery both of those were waiting on, and the two verdicts
moved with it:

- a real PDN — `vddd`/`vss` on `Metal1` followpins rails and `Metal4`/
  `Metal5` straps, `checks.def.special_nets: true`, 2 nets in the DEF's
  `SPECIALNETS` section, the block's own `vddd`/`vss` supply pins at the
  boundary;
- 265 well/substrate tapcells, 208 endcaps and 5663 fillers, closing every
  row gap;
- **DRC clean** over the merged GDS — the 149 `nwell.space.1` violations
  #170 recorded were all the missing fillers, and inserting them closed
  every one;
- `klt lvs` down from 7694 mismatches to **9**, with power connectivity now
  *inside* the comparison rather than excluded from it, and the whole
  `net.split`/`net.merged` cascade gone;
- a committed, machine-readable isolation check
  (`checks.power_isolation`) asserting the routed DEF's own `SPECIALNETS`
  section carries exactly `{vddd, vss}` and none of `vddr1`/`vddr2`/`vdd` —
  the layout-side half of `layout/floorplan/README.md`'s mitigation 2.

**Does not establish.** Not signoff timing (no extraction, no SPEF, ideal
clock). Not an LVS-matching layout: 8 residual mismatches remain, two of
them errors, all traced to one CTS clock-load dummy cell — see
[LVS](#lvs) for exactly what they are, which one [#186][gf186] closed, and
[#187][gf187] for the remaining two (tracked separately; not resolved
here). Not an unbounded DRC claim
either: `klt drc`'s clean verdict is relative to the gf180mcu deck this
repository pins, which does not model every DRM rule, and this repository
checks the tapcell spacing against the DRM's own latch-up tie-spacing
rule only through [Tap distance](#tap-distance), which finds the as-built
spacing over the 5 V (MV) limit — `tapcell -distance 100` is ORFS's gf180
platform value, adopted, not derived here. Not an area or power result. Not
a corner characterization: one implementation corner, and the multi-corner
sweep the tool does offer cannot yet be scoped to this block's supply; the
extracted-parasitics characterizations (#145,
`sim/records/2026-08-18-digital-sta-power-*.md`) and the post-route
functional re-run (#147/#177,
`sim/records/2026-08-18-trng-top-post-route-01.md`) have both been re-run
against this powered DEF — see [Timing](#timing) and [Power](#power) above
([#183](https://github.com/2AMLogic/gf180-trng/issues/183)). Not a
**system**-level PDN: the star-routing composition with `vddr1`/`vddr2`/`vdd`
is `layout/floorplan/`'s job, and nothing in this run's netlist even names
those supplies. Not a manufacturable block: no pad/IO integration, and no
placement inside `layout/floorplan/`'s own guarded `digital` region — that
region is still empty, and `layout/floorplan/README.md` remains correct in
saying so.

## OpenROAD

`klt place-and-route` shells out to an `openroad` binary. There is no
Homebrew formula and no common Linux-distro package for it, so
[`../openroad_docker.sh`](../openroad_docker.sh) presents the pinned ORFS
Docker image as if it were a native `openroad`, and `build.py` puts it on
`$PATH` only when no native binary is already there (a real local install
always wins). The pin:

| | |
|---|---|
| Image | `openroad/orfs:26Q3-383-g205191eb2` |
| Digest | `sha256:bb7f31697fb8466ab61852fc796376cc16d9df38f762ccb733218b8a5e55824b` |
| `openroad -version` inside it | `26Q3-1510-g6cb3f2b704` |

The committed `reports/place_and_route.json` and `reports/sdf_export.json`
record this same build. An earlier revision of this pin pointed at
`openroad/orfs:26Q3-296-gda37dce1c` (`sha256:ebc8142d…`), which reports
`26Q3-1260-g06a5a02279`, not 1510; that mismatch made the nightly
`gen_sdf.py --check` fail on `engine_version` ([#507][gf507]).

The wrapper bind-mounts the working directory **and** the resolved PDK root
at their own absolute host paths, because the generated Tcl carries absolute
paths for the netlist, the LEF/liberty deck and every output — source ==
target is what makes those resolve identically on both sides of the container
boundary.

[gf507]: https://github.com/2AMLogic/gf180-trng/issues/507
[gf111]: https://github.com/2AMLogic/gf180-trng/issues/111
[gf145]: https://github.com/2AMLogic/gf180-trng/issues/145
[gf147]: https://github.com/2AMLogic/gf180-trng/issues/147
[gf150]: https://github.com/2AMLogic/gf180-trng/issues/150
[gf169]: https://github.com/2AMLogic/gf180-trng/issues/169
[gf170]: https://github.com/2AMLogic/gf180-trng/issues/170
[gf171]: https://github.com/2AMLogic/gf180-trng/issues/171
[gf186]: https://github.com/2AMLogic/gf180-trng/issues/186
[gf187]: https://github.com/2AMLogic/gf180-trng/issues/187
[gf224]: https://github.com/2AMLogic/gf180-trng/issues/224
[gf240]: https://github.com/2AMLogic/gf180-trng/issues/240
[gf255]: https://github.com/2AMLogic/gf180-trng/issues/255
[gf264]: https://github.com/2AMLogic/gf180-trng/issues/264
[gf292]: https://github.com/2AMLogic/gf180-trng/pull/292
[gf293]: https://github.com/2AMLogic/gf180-trng/issues/293
[gf273]: https://github.com/2AMLogic/gf180-trng/issues/273
[klt1090]: https://github.com/2AMLogic/klayout-tools/issues/1090
[klt1091]: https://github.com/2AMLogic/klayout-tools/issues/1091
[klt1092]: https://github.com/2AMLogic/klayout-tools/issues/1092
[klt1102]: https://github.com/2AMLogic/klayout-tools/issues/1102
[klt1114]: https://github.com/2AMLogic/klayout-tools/pull/1114
[klt1115]: https://github.com/2AMLogic/klayout-tools/pull/1115
[klt1120]: https://github.com/2AMLogic/klayout-tools/pull/1120
[klt1132]: https://github.com/2AMLogic/klayout-tools/issues/1132
[klt1133]: https://github.com/2AMLogic/klayout-tools/issues/1133
[klt1181]: https://github.com/2AMLogic/klayout-tools/issues/1181
[klt1183]: https://github.com/2AMLogic/klayout-tools/issues/1183
[klt1296]: https://github.com/2AMLogic/klayout-tools/issues/1296
[klt1310]: https://github.com/2AMLogic/klayout-tools/pull/1310
[klt1488]: https://github.com/2AMLogic/klayout-tools/issues/1488
[dr3]: ../../spec/decision-records/DR-0003-throughput-defined-at-the-raw-tap.md
[dr20]: ../../spec/decision-records/DR-0020-fifo-depth-set-to-two-against-power-area-and-streaming.md
[gf448]: https://github.com/2AMLogic/gf180-trng/issues/448
[gf-lu]: https://gf180mcu-pdk.readthedocs.io/en/latest/physical_verification/design_manual/drm_14_3_1.html
[gf449]: https://github.com/2AMLogic/gf180-trng/issues/449
