2AMLogic/gf180-trng/sim/tb/digital-sta-power/README.md

# `digital-sta-power` — corner-swept STA and power over the routed digital section

Gate-level testbench ([DR-0021]): it re-opens the **committed** routed DEF
`layout/digital/trng_top.def` (#111) and re-times it, once per corner,
against the PDK's own liberty and extraction decks. No device models, no
ngspice, and no re-placement — one fixed piece of geometry, fifteen corners.

```sh
python3 sim/tb/digital-sta-power/run_sta.py --list      # the corner grid
python3 sim/tb/digital-sta-power/run_sta.py --no-write   # run it, mint nothing
python3 sim/tb/digital-sta-power/run_sta.py              # run it, mint 15 records
python3 sim/tb/digital-sta-power/run_sta.py --liberty ss_125C_3v00 --rc max --no-write
```

Needs `openroad` on `PATH` and a gf180mcu PDK install (`python3
sim/run_corners.py --check-env` resolves the PDK; `layout/digital/README.md`'s
"OpenROAD" section covers the OpenROAD side, including the pinned ORFS Docker
image for machines with no native build). ~9 s per corner, ~2 min for the
grid.

**No `tb.json`, on purpose.** `sim/harness/testbench.py`'s discovery only
picks up directories that have one, so `sim/run_corners.py` cannot sweep this
testbench across the analog PVT grid — which it must not, because a liberty
corner is a characterised *bundle* of process, voltage and temperature and
not a free P/V/T choice. This is the same construction DR-0009 rule 7 uses to
keep behavioral testbenches off the analog grid, for a different reason.

## The grid

Five liberty decks — every one `gf180mcu_fd_sc_mcu9t5v0` characterises in the
block's ratified 3.3 V supply family — crossed with all three OpenRCX
interconnect decks the PDK ships:

| | `min` | `nom` | `max` |
|---|---|---|---|
| `ss_125C_3v00` | ✓ | ✓ | ✓ |
| `ss_n40C_3v00` | ✓ | ✓ | ✓ |
| `tt_025C_3v30` | ✓ | ✓ | ✓ |
| `ff_125C_3v60` | ✓ | ✓ | ✓ |
| `ff_n40C_3v60` | ✓ | ✓ | ✓ |

The library also ships 1.8 V and 5.0 V families. They are excluded for the
same reason `layout/digital/build.py` excludes them: this block runs at 3.3 V
(`design/README.md`), and timing it against a deck for a supply it does not
have is not conservatism.

## What each run does

Per corner, two OpenROAD sessions:

1. **at the P&R run's own 50 ns (20 MHz) constraint** — read liberty + tech
   LEF + cell LEF + the committed DEF, `set_propagated_clock` (the CTS tree
   in the DEF is timed as a real tree, not an ideal clock), OpenRCX
   `extract_parasitics` → SPEF → `read_spef`, then worst setup/hold slack,
   TNS, clock skew, `report_power`, `report_design_area`, `check_setup`, and
   an **Fmax found by bisecting the clock period** rather than extrapolated
   from one slack number;
2. **at 1 MHz** ([DR-0003]'s ratified raw rate, one raw bit per `clk` edge) —
   the same session shape, for the power point that is directly comparable
   with `design/digital_power_estimate.py`'s library-based estimate.

Two sessions rather than one because OpenSTA caches a design's clock-derived
activity densities at the first power query: re-creating the clock at a new
period inside one session updates every slack correctly but leaves
`report_power`'s switching term at the old rate. `run_sta.py`'s `_tcl`
docstring records the live evidence for that.

## The six `digital`-facing inter-region trunks (#233)

Every session also carries the inter-region trunks that terminate on
`trng_top`'s own pins — `clk`, `rst_n`, `raw_bit`, `raw_valid`,
`ring_bit[0]`, `ring_bit[1]` as the DEF names them — as a
`set_input_transition` per port, derived at run time from
`layout/floorplan/reports/interregion.json`'s as-built `trunk_length_um`
(Metal4 coefficients per [DR-0025]) and, since #456, the per-endpoint `legs`
(Metal4 stub, Metal5 track, Metal3 flank riser of the top-edge pins) at each
layer's own coefficients ([DR-0028]). It is **permanent**, not a flag-gated
scenario: re-deriving costs nothing per run, and a pinned constant would go
stale the moment #222's routing moves. Each record's `interface_loads:` block
states the per-port R, C and stated transition, and the convention they are
stated in (the deck's own `slew_*_threshold_pct` / `slew_derate_from_library`).

`set_load` — the construct #233 was filed expecting — is deliberately not
used: all six ports are `DIRECTION INPUT` on `trng_top` with no driver inside
this single-region netlist, so there is no driver arc for a load to attach to,
and OpenSTA reports bit-identical slack, slew and power with no `set_load`,
with the trunks' as-built 15.6–30.7 fF, and with 10 pF.

```sh
# the comparison behind that choice, and the slew-domain check behind
# SlewConvention -- one corner, two minutes, no records minted
python3 sim/tb/digital-sta-power/sdc_treatment_probe.py
python3 sim/tb/digital-sta-power/sdc_treatment_probe.py --check
```

## The design's own `max_transition` violation (#233 → #237)

Asking whether the six trunk ports violate the library's `max_transition`
meant asking OpenSTA for that check at all, for the first time here — and the
answer for the *design* is that **9 of the 15 corners violate it**, on nets
none of the six trunks touches. `run_sta.py` reports it as three metrics per
record (`max_slew_limit_ns`, `max_slew_slack_ns`, `max_slew_violations`);
`max_transition_probe.py` is the decomposition behind them, and the testbench
`sim/characterization-digital-sta-area-power.md` §2a's verdict rests on.

Per corner, in one OpenROAD session over the same committed DEF and the same
constraints the sweep uses: every violating pin resolved to its net, that
net's driver and load count; the worst setup slack of any path *through* a
violating pin (against the design-wide worst, which turns out to be the same
path); the violating cells' share of total power; the library's sibling
`max_capacitance` check; the design's own worst net fanout; and the
`set_max_transition` at the P&R corner that would be needed for every corner
to come out clean, derived from the measured slews rather than assumed.

```sh
# all 15 corners, ~4 min, no records minted
python3 sim/tb/digital-sta-power/max_transition_probe.py
python3 sim/tb/digital-sta-power/max_transition_probe.py --liberty tt_025C_3v30 --rc max

# the gate: fails if the violation spreads to a new net, lands on a trunk
# net, stops closing setup, or grows its power share
python3 sim/tb/digital-sta-power/max_transition_probe.py --check
```

The decision was **not** to rebuild: the constraint that would fix this
cannot be stated through `klt place-and-route`'s request contract today
(klayout-tools#1709), so the residual is accepted, bounded and gated instead.
#240 is the follow-up that constrains and re-mints once it can be stated.
`sim/tools/digital_corner_characterization.py --check` gates the record-side
half with no PDK needed.

The aggregation (and the whole-block power rollup's measured digital term)
accepts only a complete fifteen-corner family whose `netlist.sha` equals the
git blob SHA of the committed `layout/digital/trng_top.def`; a partial re-run
of a new DEF fails with the missing corners rather than borrowing older
records (#341). A valid record that carries no `netlist.sha` at all is
rejected by name, whatever DEF it was run against, because nothing shows it
is older. Records of earlier DEF revisions stay on disk and can be read
with `digital_corner_characterization.py --historical` (record-only, never a
current-layout claim, refused with `--check`). Its text report opens with a
`HISTORICAL` banner and lists each `netlist.sha` present with the corners it
covers; its `--json` output carries `"historical": true` and the same
`dut_revisions` map.

Each record's raw output is the generated Tcl and the full OpenROAD log for
both sessions. The SPEF (3.3 MB per corner) is **not** committed; its sha256,
byte size and summed capacitance are, so a re-run is checkable against the
record.

## Reading the results

The fifteen records are `sim/records/<date>-digital-sta-power-<nn>.md`.
Read them through `sim/characterization-digital-sta-area-power.md`, which
aggregates them into the Fmax / area / power answer, and
`python3 sim/tools/digital_corner_characterization.py`, which re-derives
every figure in that document from the records themselves.

## Observed switching activity (opt-in, #453)

The default flow above prices power at a declared uniform activity. DR-0023
named a per-net activity annotation from post-route gate simulation as its
follow-up; it is available behind a flag and changes nothing by default:

```sh
python3 sim/tb/digital-sta-power/activity.py capture      # seeded traces -> layout/.work/digital-sta-activity/
python3 sim/tb/digital-sta-power/run_sta.py --activity --no-write
python3 sim/tb/digital-sta-power/run_sta.py --activity    # 15 `digital-sta-activity` records
python3 sim/tb/digital-sta-power/activity_power.py negative-controls
python3 sim/tools/activity_power_characterization.py --check
```

Needs `iverilog` 13.0+ as well. The workloads and capture windows are
`sim/tb/trng-top-post-route/activity_workloads.py`; the records use their own
slug, so the fifteen `digital-sta-power` records and the rollup baseline are
not touched. Read the results through
`sim/characterization-digital-activity-power.md`.

## What this is not

- Not signoff. Real extraction, but not a foundry-signed one; and the DEF it
  reads has no power delivery at all (#171, klayout-tools#1091), so nothing
  here sees IR drop.
- Not a supply-current measurement. Power carries a declared uniform
  switching activity (or, with `--activity`, a recorded synthetic-workload one) (0.25 transitions/net/cycle, duty 0.5), chosen to match
  the estimate it is compared against. Leakage is the one column with no
  activity assumption in it.
- Not a re-run of the flow. The placement and routing are #111's, unchanged;
  re-placing per corner would make the corner sweep a sweep of fifteen
  different designs.
- Not an I/O timing result. The design carries no `set_input_delay` /
  `set_output_delay`, so port paths are unconstrained; every record states
  how many endpoints that leaves untimed.

[DR-0003]: ../../../spec/decision-records/DR-0003-throughput-defined-at-the-raw-tap.md
[DR-0021]: ../../../spec/decision-records/DR-0021-gate-level-timing-and-power-records.md
[DR-0025]: ../../../spec/decision-records/DR-0025-full-chip-pex-scope.md
[DR-0028]: ../../../spec/decision-records/DR-0028-top-edge-legs-are-priced-in-the-sta-interface-load.md
