2AMLogic/gf180-trng/docs/spec-row-status.md

# Target specification: row status and evidence history

This document holds the evidence narrative behind each row of the ratified
target specification in [`README.md`](../README.md#target-specification-ratified-2026-07-31).
The README table is the contract — target, stretch and a one-line status tag
per row. This document is the record of how each row's measured figures were
reached and how they moved: which issue measured what, which decision record
accepted or diagnosed it, and where the evidence lives under `sim/`, `layout/`
and `spec/`.

It changes nothing about the specification. No target value is set or moved
here; per `CLAUDE.md`, a row that cannot be met is answered by a superseding
decision record under `spec/decision-records/`, not by an edit to this file or
to the README.

**Append-only in spirit.** One section per row, in the README table's order.
When a figure moves, add a new dated `###` entry at the end of that row's
section — the issue, the new figure, and the record it comes from — and update
the README Status tag to match. Do not rewrite an earlier entry; a superseded
figure stays, marked as superseded by the entry that replaced it.

The 2026-10-10 entries are the row text and the "Ratified, with four rows
explicitly unmeasured" note exactly as they stood in `README.md` on that date,
moved here unchanged in substance by #481 (only relative link paths and
blockquote markers were adjusted for this file's location). Status words in
them — *placeholder*, *measured*, *met*, *missed*, *derived from a target* —
are the claims of record.

## Status tags

| Tag | Meaning |
|---|---|
| `met` | measured, and the measurement satisfies the target |
| `missed` | measured (or measured at gate level, per [DR-0021], or read from the regenerated floorplan rollup for Area), and the figure does not satisfy the target |
| `unmeasured` | no measurement exists; the row is a target or placeholder, not a claim (an estimate, where one exists, is stated as an estimate) |
| `derived from target` | computed from another row's *target*, so it carries that row's status and becomes measured only when that row does |
| `specified` | a design or interface decision with no measured quantity to meet or miss; its decision record is the source |

## Ratification: four rows explicitly unmeasured

### 2026-07-31 — ratification (2026-10-10: relocated from `README.md`, #481)

**Ratified, with four rows explicitly unmeasured.** The table was ratified
on 2026-07-31 by engineering (Robb) — see
[`spec/ratification-2026-07-31-target-spec.md`](../spec/ratification-2026-07-31-target-spec.md)
and issue #1 — together with the amendment package in #29. Every decision
record the rows above cite is `Accepted` except [DR-0017], which is
`Proposed` (its idle-current options are unchosen; see the Power note below);
[DR-0015] was `Accepted` 2026-10-10 via the two-key ratification mechanism,
#480; a row that cannot be met is a **superseding decision record**,
not an edit. What ratification does *not* do is turn placeholders into
claims:

- Raw min-entropy per bit — see [Raw min-entropy per bit](#raw-min-entropy-per-bit).
- Conditioning / delivered rate — see [Conditioning](#conditioning) and
  [Delivered (post-conditioning) rate](#delivered-post-conditioning-rate).
- Power — see [Power](#power).
- Area — see [Area](#area).

Each bullet's full text, as it stood on 2026-10-10, is reproduced under its row.

## Entropy source

### 2026-10-10 — relocated from `README.md` (#481)

The README row carried no evidence narrative beyond its own target text, which stays in the README table unchanged. Row text as it stood on relocation:

**Target cell:** **N-way array of independent free-running ring oscillators, XOR-combined ahead of a single sampler**, N fixed by the jitter-budget sizing law `Q_array ≥ 1.5 × 4.0×10⁻³` at the entropy-binding corner ([DR-0007])

**Stretch cell:** metastability hybrid, scoped as a *secondary tap on the RO core* — not a free-standing source

Sizing context recorded in the [Power](#power) section: [DR-0007]'s first-cut array size projected far more active power than the Power row allows, resolved by [DR-0010] shrinking the array to N = 2.

## Raw rate

### 2026-10-10 — relocated from `README.md` (#481)

The README row carried no evidence narrative beyond its own target text, which stays in the README table unchanged. Row text as it stood on relocation:

**Target cell:** > 1 Mbps sustained at the raw tap (sampler output), binding at the slowest-RO corner: `ss` / −10 % / +125 °C ([DR-0003])

**Stretch cell:** > 4 Mbps, same definition

The row's open question — that the rates [DR-0010] and [DR-0011-rate] re-derive sit far below it — is recorded under [Binding corners and the rate row](#binding-corners-and-the-rate-row). The [Delivered (post-conditioning) rate](#delivered-post-conditioning-rate) row inherits this row's status.

### 2026-10-11 — target moves to `> 2 kbps` (#491)

The edit [DR-0010] and [DR-0011-rate] direct, which their 2026-10-10
ratification deliberately did not make, is made. The `Target` cell now reads
**> 2 kbps** sustained at the raw tap, binding at `ss` / −10 % / +125 °C, with
the value cited to [DR-0011-rate] §1 and the definition (raw tap, *sustained*,
binding corner) still [DR-0003]'s. The superseded entry above stays as the
record of the 1 Mbps row.

What the new figure is, and is not:

- **A derived target, not a measurement.** Status stays `unmeasured`. The
  number is [DR-0011-rate] §2's arithmetic: the shipped array's highest rate
  satisfying DR-0007 §2, at the starved cell's asymptotic jitter-energy
  constant `a = 7.32`, quoted with a 1.30× margin.
- **Re-checked on today's records.** `python3 sim/tools/array_sizing.py
  --check` (stated `a = 7.32`, default rate 2000 bps) re-derives the constant
  from the committed starved-cell records (asymptotic `a` = 7.322 at
  `ss`/−40 °C/3.63 V, `2026-08-01-ro-ring5-starved-jitter-long-01`, the
  smallest of the three measured corners) and finds DR-0007 §2 holding at all
  27 covered corners. Minimum margin 1.39× at the DR-0015 entropy-binding
  corner `ss`/+125 °C/3.63 V, where the highest satisfying rate is 2773 bps.
  The decision record's own 2664 bps was computed at `ss`/−40 °C/3.63 V on
  pre-#78 records; the corner and the records moved, the conclusion did not.
- **Stretch.** Neither rate decision re-derives DR-0003's `> 4 Mbps` stretch,
  so it is left as written and marked as such: it is **unattainable under the
  measured jitter-energy law**, far above the 2.77 kbps edge above — which is
  also the row's maximum sample clock (2773 bps at the entropy-binding corner,
  `array_sizing.py --check`).
- **Entropy caveats unchanged.** The constant carries the fixed-injection
  scaling uncertainty [DR-0011-rate] states (~2–4× on `a`), it is measured on
  a five-stage ring, and `H` remains unmeasured (#12).

## Raw min-entropy per bit

### 2026-10-10 — relocated from `README.md` (#481)

Row text as it stood on relocation (the README keeps the placeholder statement, the binding corner and what is still owed; the measurement history below moved here):

**Target cell:** **placeholder — H₀ = 0.5 bit/sample is a design *target*, not a measurement.** Stated at the entropy-binding corner, which #13 measured over the full covered 27-point grid as **`ss` / +125 °C / 3.63 V** — the hot end of the `ss`/+10 % edge, *not* the cold end [DR-0012-clock] predicted from three points ([DR-0015]; `fs`/`sf` remain uncovered per [DR-0006]). #12 applied the #10 methodology to the real sampler bitstream at the corners [DR-0012-clock] predicted before that grid landed (`tt`/27 °C/3.30 V and `ss`/−40 °C/3.63 V) and found no non-trivial `H` figure is supportable by transistor-level simulation at any rate under consideration — the array's own sizing law predicts `H0 = 0.5` is plausible only near DR-0010's proposed (not yet ratified) 500 bps, and no affordable simulation reaches that rate. See [`sim/characterization-raw-min-entropy-and-battery.md`](../sim/characterization-raw-min-entropy-and-battery.md). The same analysis was then re-run at #13's actual worst corner (`ss`/+125 °C/3.63 V, #406): ten of ten sampled bits were `1` at every seed, a ten-bit stuck-high observation that supports no `H` figure either — the same ceiling, not a number. Still owed: measured silicon ([DR-0004] Tier 3)

From the ratification note ("Ratified, with four rows explicitly unmeasured"):

- **Raw min-entropy per bit** is a design target (H₀ = 0.5). The entropy
  source is *sized* to hit it ([DR-0007]); the corner it has to hold at is
  now measured over the whole covered grid and moved as a result
  ([DR-0015], from #13). #12 attempted the `H` measurement at the corner
  [DR-0012-clock] predicted before that grid landed and found it is not
  supportable by transistor-level simulation at any rate under
  consideration (see
  [`sim/characterization-raw-min-entropy-and-battery.md`](../sim/characterization-raw-min-entropy-and-battery.md));
  confirmation at #13's actual worst corner is still owed.

## Quality

### 2026-10-10 — relocated from `README.md` (#481)

The README row carried no evidence narrative beyond its own target text, which stays in the README table unchanged. Row text as it stood on relocation:

**Target cell:** designed-for-SP 800-90B (raw access + RCT/APT + entropy-source model), plus a **simulation-derived design-stage min-entropy estimate** within the #10 claim limits; 90B validation itself deferred to measured silicon ([DR-0004])

**Stretch cell:** AIS-31 PTG.2 — same three-tier treatment (structure now, conformance deferred)

## Conditioning

### 2026-10-10 — relocated from `README.md` (#481)

The README row carried no evidence narrative beyond its own target text, which stays in the README table unchanged. Row text as it stood on relocation:

**Target cell:** **non-vetted** 32-bit CRC-32 LFSR compression (Galois, poly `0xEDB88320`), state cleared every block, **K = 8** — 256 raw bits in : one 32-bit word out. Creditable output entropy **0.85 bit per output bit** (SP 800-90B's non-vetted cap) for any raw stream at or above **H = 0.107 bit/sample**; a 4.70× margin under the H₀ = 0.5 target. ~0.005–0.008 mm² ([DR-0008])

**Stretch cell:** a 90B-*vetted* conditioning function — **rejected on area**: a compact serialised AES-128 is 88–124 % of the whole block budget ([DR-0008] §4). Live again only if the area budget grows

From the ratification note ("Ratified, with four rows explicitly unmeasured"), shared with the [Delivered (post-conditioning) rate](#delivered-post-conditioning-rate) row:

- **Conditioning / delivered rate** were deferred to #8; [DR-0008] has since
  filled both rows in. The delivered rate is still `R_raw / K` derived from a
  *target* raw rate — filling in K does not turn the raw-rate row into a
  measurement.

### 2026-10-11 — K re-derived at 2 kbps and retained (#491)

[DR-0011-rate] §4 asks for K to be re-derived at the new raw rate. K's
governing inequality (DR-0008 §5: the non-vetted cap binds for any input at or
above the break-even `H`, with margin under `H₀ = 0.5`) contains no rate term,
so **K stays 8** and the row is unchanged. The reasoning and the break-even
table are in
[`design/conditioner/README.md`](../design/conditioner/README.md#k-at-the-2-kbps-raw-rate).

## Delivered (post-conditioning) rate

### 2026-10-10 — relocated from `README.md` (#481)

Row text as it stood on relocation (the README keeps the target; the "derived from a target" status became its Status tag):

**Target cell:** **`R_cond = R_raw / K` > 125 kbps** at the raw-rate row's binding corner (`ss` / −10 % / +125 °C), K = 8; > 500 kbps at the stretch raw rate. **Derived from a target, not measured** — it inherits the raw-rate row's status exactly, and becomes a measured figure only when `R_raw` does ([DR-0003] §6, [DR-0008] §3)

See also the ratification-note bullet under [Conditioning](#conditioning).

### 2026-10-11 — follows the raw-rate row to `> 250 bps` (#491)

`R_cond = R_raw / K` = 2000 / 8 → **> 250 bps** (one 32-bit word per 128 ms)
at the raw-rate row's binding corner, K = 8 retained (see
[Conditioning](#conditioning)). Still `derived from target`: it is arithmetic
on the raw-rate *target*, and becomes measured only when `R_raw` does. The
`> 500 kbps` stretch figure is left tied to DR-0003's original stretch, which
neither rate decision re-derives: it is **unattainable under the measured
jitter-energy law**, since it presupposes the `> 4 Mbps` raw stretch (see
[Raw rate](#raw-rate)). The `> 125 kbps` entry above is the
superseded 1 Mbps figure.

## Health tests

### 2026-10-10 — relocated from `README.md` (#481)

The README row carried no evidence narrative beyond its own target text, which stays in the README table unchanged. Row text as it stood on relocation:

**Target cell:** continuous RCT + APT on the **raw** stream, α = 2⁻⁴⁰, APT window W = 1024, cutoffs as formulas in min-entropy H (at H₀ = 0.5 → `C_RCT` = 81, `C_APT` = 824); failure latches a flag and gates the conditioned path until explicit clear + start-up test. The parameterization has a hard floor: **no valid APT cutoff exists at H ≤ 0.03** ([DR-0002])

## Time-to-first-valid

### 2026-10-10 — relocated from `README.md` (#481)

Row text as it stood on relocation (the README keeps the arithmetic floor; the measurement moved here):

**Target cell:** **≥ ~1.28 ms** at 1 Mbps — an arithmetic floor: 1024 consecutive raw samples for the start-up health test (1.024 ms) plus 256 samples of conditioner latency (0.256 ms), which do **not** overlap because the conditioner is held flushed while gated. Applies at power-on and after every alarm clear; binds at `ss` / −10 % / +125 °C (slowest sampling) ([DR-0002] §Failure behavior, [DR-0008] §7). **Now measured (#14): 1.281 ms**, the floor plus one sampler clock plus a 4.1–12.4 ns oscillator start-up (4.4–13.4 ns before #78's buffer adoption) — the row is met and the floor is confirmed as a floor ([`sim/characterization-startup-and-power-budget.md`](../sim/characterization-startup-and-power-budget.md))

The caveat #14 added about this row's binding corner is under [Binding corners and the rate row](#binding-corners-and-the-rate-row).

### 2026-10-11 — restated at 2 kbps; status `derived from target` (#491)

At the ratified 2 kbps the same non-overlapping sample counts give an
arithmetic floor of **≥ ~0.640 s** (1024 health-test samples, 0.512 s, plus
256 conditioner samples, 0.128 s). `python3 sim/tools/time_to_first_valid.py
--check`, whose default rate is now 2000 bps, reports **640.5 ms** at the
longest corner (`ss`/+125 °C/2.97 V): that floor, plus one sampler clock
(0.5 ms), plus #14's measured oscillator start-up (12.41 ns). It passes —
the floor is still a floor.

The Status tag moves from `met` to `derived from target`. The 640.5 ms is the
measured start-up term plus arithmetic at the raw-rate *target*; no
simulation has run the block at 2 kbps, and 99.999 % of the figure is sample
periods of a rate that is itself unmeasured. #14's **1.281 ms** was reported
at the original 1 Mbps and is historical; `--rate 1e6` reproduces it, and
[`sim/characterization-analog-summary.md`](../sim/characterization-analog-summary.md)
still quotes it at that rate.

## Power

### 2026-10-10 — relocated from `README.md` (#481)

Row text as it stood on relocation (the README keeps the two targets and their binding corners; the measurement history moved here):

**Target cell:** < 500 µW active, binding at `ff` / +10 % supply (fastest RO — max measured `f_osc` 2.30 GHz at −40 °C); < 1 µA idle, binding at `ff` / +10 % / +125 °C (max leakage). **Now evidenced (#14, re-measured after #78's buffer adoption, #174/[DR-0023]'s substitution of #145's measured gate-level digital figure for the pre-synthesis estimate, #255/#266's re-synthesis and re-place-and-route of the digital section at [DR-0020]'s ratified `FIFO_DEPTH = 2`, #264/#277's re-tune of that depth-2 build's `max_transition_ns` (8.0 → 4.0) and rebuild, and #293's re-run of the same place-and-route on #292's re-baselined netlist, with #145's fifteen-corner `level: gate` sweep re-run against each rebuild — the current family is `sim/records/2026-10-07-digital-sta-power-{01..15}.md`): active 749.4 µW — missed by 1.5×, at 149.9 % of the row (#709 and #729 re-measured the whole-block figure). Idle 2.21 µA — missed by ~2.2×**, and the cause on both halves is still the synthesized-and-placed digital section (339.4 µW active / 7.842 µW — 2.178 µA — leakage, MEASURED-at-gate-level, down from 712.4 µW / 4.062 µA at the depth-8 build #174/[DR-0023] first measured), not the analog block (393.2 + 16.9 µW active / 32.8 nA idle, measured, unchanged by the digital section's depth). Neither miss is absorbed: see [`sim/characterization-startup-and-power-budget.md`](../sim/characterization-startup-and-power-budget.md), §0a/§0b of [`sim/characterization-digital-sta-area-power.md`](../sim/characterization-digital-sta-area-power.md), [DR-0023] (`Accepted` 2026-09-07 via the two-key ratification mechanism, #213 — the active miss and the idle figure's revision, both stated there against the depth-8 build; `sim/tools/power_rollup.py` reads the digital term live from the committed record family, so #255/#266's depth-2 re-run, #264/#277's re-tuned rebuild and #293's re-run update the tool's own verdict without a new decision record) and [DR-0017] (`Proposed`, the idle row's own diagnosis and options, unsuperseded — not part of the #213 ratification batch), and the note below

From the ratification note ("Ratified, with four rows explicitly unmeasured"; "the note below" in the row text above is this one):

- **Power** was ratified with no supply-current or leakage measurement
  anywhere in `sim/`. "Idle" means: all ring oscillators stopped and no bits
  being produced, with the block powered and register state retained — i.e.
  leakage plus static bias only. #32 measured the delay cell, #7 the shipped
  array, #14 closed both halves of the row against a pre-synthesis digital
  estimate, **#174/[DR-0023] then substituted #145's measured gate-level
  digital figure for that estimate — both halves were missed** at the
  `FIFO_DEPTH = 8` build #145 measured, and **#255/#266 then re-synthesized
  and re-placed-and-routed the digital section at [DR-0020]'s ratified
  `FIFO_DEPTH = 2`** — the depth actually shipped since #254 — **and re-ran
  #145's same fifteen-corner sweep against it**. That first depth-2 build
  violated the library's own `max_transition` check at 11 of the 15 corners,
  so **#264/#277 re-tuned `max_transition_ns` (8.0 → 4.0) for the depth-2
  topology, rebuilt, and re-ran the same sweep once more**. **#293 then
  re-ran that place-and-route on #292's re-baselined netlist** (one
  drive-strength swap, which #292 committed without rebuilding the layout
  downstream of it) and re-ran the sweep again — the current build is the
  committed `sim/records/2026-10-07-digital-sta-power-{01..15}.md` family
  (the 2026-09-22 family is #264/#277's), and
  `power_rollup.py` picks each of these up automatically because its digital
  term already reads live from that family ([DR-0023], §0a/§0b of
  [`sim/characterization-digital-sta-area-power.md`](../sim/characterization-digital-sta-area-power.md)).
  #293's re-run moved the digital terms by under 1 % active and +4.4 %
  leakage, mostly from the OpenROAD build that re-ran it rather than from
  the netlist; §0b separates the two with a control run.
  **Both halves are still missed, by a materially narrower active margin
  than at depth 8 — and, on the idle half, by a slightly wider one than the
  violating depth-2 build showed**:
  - **Active: missed, by 1.5×** (was 2.2×). 749.4 µW at `ff`/−40 °C/3.63 V —
    entropy source 393 µW (measured), sampler 16.9 µW (measured), digital
    section 339.4 µW (**MEASURED-at-gate-level** at its own worst corner,
    `ff_125C_3v60`/`rc-max`, [DR-0021]; 345.6 µW at #264/#277's build
    before #293's re-run, down from 358.5 µW at #255/#266's
    violating depth-2 build, from 712.4 µW at the depth-8 build, and from a
    [DR-0004] Tier 2 pre-synthesis estimate of 23 µW before any netlist
    existed to synthesize). [DR-0010]'s stated worry,
    that the array leaves only ~85 µW for everything downstream, is still
    realized rather than merely tight, just less severely: the digital
    section alone is now 3.3× everything the array leaves, versus 6.7× at
    depth 8. #14 first measured this row at **454 µW** (entropy source
    415 µW, digital still estimated); #78 then adopted the per-ring output
    buffer ([DR-0018]), which *returns* power rather than spending it,
    moving the row to **433 µW (met, at 86.6 %)**; #174/[DR-0023] then
    replaced the digital estimate with the depth-8 measured gate-level
    figure (1.122 mW, 224.5 %, missed by 2.2×); #255/#266's depth-2
    re-synthesis (768.5 µW, 153.7 %) is the reason the miss narrows,
    #264/#277's re-tuned rebuild gave 755.6 µW (151.1 %), and #293's
    re-run on the re-baselined netlist is the number above. The
    entropy source's own share (393 + 17 µW) is unchanged by any of these
    substitutions — the digital section's own build is the only thing that
    moved.
  - **Idle: missed, by ~2.1×** (2.148 µA after #709's interface
    `raw_shift` / `raw_bit_count` change, measured by `power_rollup.py`
    with digital leakage 2.116 µA / 7.617 µW; 2.211 µA before it; 2.12 µA at #264/#277's build before #293's
    re-run, ~2.0× at the violating depth-2 build, ~4.1× at depth 8, 4.5×
    estimated). 2.21 µA at
    `ff`/+125 °C/3.63 V — analog block 32.8 nA (3.3 % of the row, measured
    across 45 corners, unchanged), digital leakage 2.178 µA / 7.842 µW
    (**MEASURED-at-gate-level**; 2.087 µA at #264/#277's build, and §0b of
    the characterization's control run splits the +0.091 µA since then into
    +0.087 µA from the OpenROAD build #293 re-ran on and +0.004 µA from
    #292's netlist; down from 4.062 µA at the depth-8 build and
    from 4.43 µA estimated before any netlist existed, but *up* from the
    1.974 µA #255/#266's violating depth-2 build measured: #264/#277's
    tighter transition target buys its clean `max_transition` and its lower
    dynamic power with +30 logical instances and +3.7 % placed cell area,
    which is static current the earlier build did not pay). The
    ratification note above guessed the cause exactly — the entire
    remaining miss is standard-cell leakage in the conditioner, health
    tests, interface and #171's power-delivery cells. `gf180mcu_fd_sc_mcu7t5v0`
    ships no retention flop and no power-switch cell, so the obvious fix is
    not a library instantiation; shrinking the FIFOs ([DR-0020]) is the
    lever that produced this narrower miss, and [DR-0017] §B already
    projected that no `FIFO_DEPTH` closes it.

  Per `CLAUDE.md` no row is edited here: the digital-term substitution and
  the active miss it causes are recorded in [DR-0023] (`Accepted` 2026-09-07
  via the two-key ratification mechanism, `2AMLogic/2am#372`/#213); [DR-0017]
  (`Proposed`, not part of the #213 ratification batch) remains the record
  for the idle row's diagnosis and its four priced options, unsuperseded —
  [DR-0023] only narrows its headline figure.
  [DR-0007]'s separate conflict — that its first-cut array size projected far
  more active power than this row allows — was resolved by [DR-0010]
  shrinking the array to N = 2, which is the 415 µW measured above.

### 2026-11-06 — gap accounting after the #700 child issues (#700)

Evidence only; the row, its `missed` tag, [DR-0017] (`Proposed`) and [DR-0023]
are unchanged. Operator ruling on #700 (2026-10-28, option c) keeps both bounds
and asks for power gating plus FIFO and inventory reductions.

- **Switch (#707, PR #713; `sim/characterization-power-switch.md`).** One
  400 µm PMOS header, DRC clean and LVS match, 589 µm². Off leakage at most
  41.91 nA at ff / +10 % / +125 °C. Modelled gated-domain idle there:
  **74.44 nA** (gated digital 41.67 nA + analog 32.77 nA) against 2 212.5 nA
  ungated, 7.4 % of the `< 1 µA` row. The load behind the switch is a
  leakage-equivalent NFET, not the library cells.
- **Caveat that keeps idle `missed`.** That figure is with the domain *off*.
  The ratified idle keeps register state, and no retention exists in the
  library or in this design (power-intent work, #708, PRs #712, #776;
  `design/power-intent.md`). Input-side protection is still an open item there
  and the `t_rail_decay` placeholder is tracked as #782. Until retention or a
  state-save scheme is designed and measured, the gated figure is not a
  measurement of the ratified idle condition.
- **Active power.** Gating does not lower it: active stays 749.4 µW (1.5×).
  The header's I²R loss is 58.6 µW at the informational 20 MHz bound and
  negligible at the ratified rate. FIFO/inventory work (#709) did not close it.
- **Wake (#707).** Peak inrush 104 mA (10 ns edge) or 8.6 mA (1 µs edge) on
  an assumed 200 pF rail.

Idle therefore has a credible path (gating plus a retention answer); active
power has none in evidence. A decision on the active row is requested on #700.

- **Active power by sub-block (#790).** `python3 sim/tools/active_power_breakdown.py`
  splits the whole-block figure from committed records only (rings, buffers +
  XOR, sampler from the array and sampler families at `ff` / −40 °C / 3.63 V;
  digital from `sim/records/2026-11-09-digital-power-by-block-01.md`, OpenSTA
  per-instance power at `ff_125C_3v60` / `rc-max`, MEASURED-at-gate-level).
  `--reconcile` reconciles the rows with `power_rollup.py`.

  | sub-block | 1 MHz clock (the 749.4 µW figure) | 2 kHz (ratified raw rate) |
  |---|---|---|
  | ring 1 / ring 2 | 132.5 / 140.6 µW | same |
  | ring buffers + XOR | 120.0 µW | same |
  | sampler (xsb, xsv) | 16.9 µW | 16.8 µW |
  | digital: interface | 139.8 µW | 3.2 µW |
  | digital: clock tree | 73.5 µW | 0.4 µW |
  | digital: conditioner | 58.5 µW | 1.1 µW |
  | digital: health tests | 43.4 µW | 0.9 µW |
  | digital: ring-liveness logic | 18.5 µW | 0.4 µW |
  | digital: other (buffers, tap/fill) | 5.6 µW | 2.3 µW |
  | **total (liveness samplers excluded)** | **749.4 µW (149.9 %)** | **418.3 µW (83.7 %)** |

  Largest lever by arithmetic: the digital section's power is linear in its
  clock, so the 749.4 µW figure is a 1 MHz-clock figure; at the 2 kHz clock
  `power_rollup.py` already uses by default the same model gives 418.3 µW,
  returning 331 µW. The liveness samplers (xsr1/xsr2) have no record at the
  binding corner and are not in either total; the nearest measured corner adds
  about 25 µW. This is a liberty-power model at a declared activity, not a
  measured supply current, and it changes neither the row nor its `missed` tag;
  which clock rate the row is judged at is a spec question left to #700.
  Ring power (273 µW) is the entropy source itself. Ring buffers and the XOR
  are one row because the records do not separate them.

- **Idle with state retained, measured (#790).** `design/power-intent.md`'s
  always-on set (five plain retained flops, the retention clock gate and 66
  isolation ANDs, real library cells) beside the #707 header was simulated at
  all 45 PVT points (`sim/records/2026-11-09-power-retention-{01..45}.md`,
  `python3 sim/tools/power_retention.py summarize`). The pattern written into
  the five retained flops survives a power cycle at every corner, a
  free-running-clock control loses it at every corner, and the isolation clamp
  holds. At `ff` / +10 % / +125 °C the always-on set draws 15.85 nA, the
  switch with its load 41.67 nA and the analog block 32.77 nA: **90.28 nA**,
  against the modelled 74.44 nA without retention (9.0 % of the `< 1 µA`
  row). That is a pre-layout simulation with the gated logic as ideal sources,
  a forced rail and the leakage-equivalent load, so it is a measurement of
  this scheme's leakage, not of the shipped chip; rail decay and input-side
  protection stay open items. Whether a power-cycled section with discarded
  FIFO and run state meets the row's "register state retained" wording is the
  ruling already requested on #700; the row and its tag are unchanged.

### 2026-11-09 — ranked active-power levers and scoped follow-ups (#809)

Evidence only; the Power row, its `missed` tag, [DR-0017] (`Proposed`) and
[DR-0023] are unchanged. This follows the #790 breakdown above. Every figure is
the output of `python3 sim/tools/active_power_breakdown.py --reconcile` (exit 0
on this tree) or arithmetic on the committed ring records named in the table.
Each is a model figure, none is a silicon measurement. The 1 MHz and 2 kHz
columns are never mixed in one row.

**Open spec question (not resolved here): which digital clock rate is the row
judged at?** The 749.4 µW figure (149.9 %, missed) is the 1 MHz-clock model.
The same model at the 2 kHz ratified raw rate gives 418.3 µW (83.7 %, 81.7 µW
under the bound), before the liveness samplers (below). Which one the row means
is a ruling, already requested on #700, not a lever.

Ranked by power recovered. "Basis" is the 749.4 µW whole-block figure unless
stated. Corner: array and sampler terms at `ff` / −40 °C / 3.63 V, digital at
`ff_125C_3v60` / `rc-max`.

| # | lever | recovered | source record | disposition |
|---|---|---|---|---|
| 1 | Digital clock 1 MHz → 2 kHz (whole digital section 339.4 → 8.3 µW) | **331.1 µW** (749.4 → 418.3) | `2026-11-09-digital-power-by-block-01` via `active_power_breakdown.py` | Open spec question above; not a design change. Sub-block returns in the next table. |
| 2 | Array supply 3.63 → 3.30 V (rings 273.1 → 201.3, buffers + XOR 120.0 → 86.2 µW) | 105.6 µW (71.8 rings + 33.8 buffers/XOR), array only | `2026-08-02-ro-array-core-pvt-q-{39,38}`, `ff` / −40 °C | Touches the entropy source (ring-1 frequency 249.0 → 229.6 MHz, −7.8 %; entropy rate not measured here) and the Operating envelope row. Follow-up #813. |
| 3 | Ring buffers + XOR (120.0 µW, 16.0 % of 749.4) | up to 120.0 µW, an upper bound | same pair as row 2 | The records report only the `vdd`-rail remainder, so buffers and XOR cannot be separated. A split probe would. Follow-up #811. |
| 4 | Clock gating / trimming inside the digital section at the 1 MHz clock | up to the sub-block figure, before any gating | `digital-power-by-block-01` | The model assumes one uniform declared activity, so what gating would return is not quantifiable from the records. Toggle-based activity would. Follow-up #812. At 2 kHz the whole section is 8.3 µW (1.7 % of the row): no lever. |
| 5 | Sampler (xsb, xsv), 16.9 µW | none | `2026-08-02-sampler-dff-active-current-12` | No lever: 2.3 % of the block and set by the ring transition rate. |
| 6 | Rings themselves, 273.1 µW (36.4 %) | none apart from row 2 | `ro-array-core-pvt-q-39` | No lever: the rings are the entropy source; drive or size changes trade against entropy and are outside this record. |
| — | Liveness samplers (xsr1/xsr2) | adds power, recovers none | none at the binding corner | Gap. Nearest measured corner (`tt` / 27 °C / 3.30 V) shows about 25.3 µW, in neither total above. Follow-up #810. |

Digital clock-rate return by sub-block (row 1, 1 MHz → 2 kHz):

| digital sub-block | 1 MHz | 2 kHz | returned |
|---|---|---|---|
| interface | 139.8 µW | 3.2 µW | 136.5 µW |
| clock tree | 73.5 µW | 0.4 µW | 73.1 µW |
| conditioner | 58.5 µW | 1.1 µW | 57.4 µW |
| health tests | 43.4 µW | 0.9 µW | 42.6 µW |
| ring-liveness logic | 18.5 µW | 0.4 µW | 18.1 µW |
| other (buffers, tap/fill) | 5.6 µW | 2.3 µW | 3.3 µW |
| **total** | **339.4 µW** | **8.3 µW** | **331.1 µW** |

Measurement gap: the digital figures are liberty power at a declared activity
(DR-0021 §3), not supply current, and the array and sampler terms are from
different corners than the digital term (`power_rollup.py`'s convention). Row 2
is arithmetic on two records at one process/temperature; the supply sweep is
2.97 / 3.30 / 3.63 V only. Adding the nearest-corner liveness figure to the
2 kHz total would give about 443.6 µW, but that mixes corners and is indicative
only; the real value needs #810.

Follow-ups, each at `loom:triage`: #810 (liveness-sampler record at the binding
corner), #811 (buffer versus XOR split), #812 (toggle-based digital activity),
#813 (entropy cost of a reduced ring supply). Rows 5 and 6 are recorded as "no
lever". No klayout-tools gap was met, so none is filed.

## Area

### 2026-10-10 — relocated from `README.md` (#481)

The README row carried no evidence narrative beyond its own target text, which stays in the README table unchanged. Row text as it stood on relocation:

**Target cell:** < 0.05 mm²

From the ratification note ("Ratified, with four rows explicitly unmeasured"):

- **Area: the regenerated floorplan misses by 3.5×.** The row is
  `< 0.05 mm²`. The current figure is the regenerated depth-2 floorplan
  rollup in `layout/floorplan/reports/area.json` (#256, via #454):
  **174 030.2 µm² including isolation channels, 348.1 % of the row** (173 157.9 µm²,
  346.3 %, before #705 tapped the hand-drawn cells; 175 789.9 µm² before #709's interface change; a
  floorplan-area sum; the row bounding box, 934.4 × 416.7 µm, is reported
  separately). The rest of this bullet is historical context from before
  that regeneration. #16's floorplan work had priced the block bottom-up
  against the PDK's own standard-cell LEF:
  **0.06885 mm², 137.7 % of the row** at the shipped `FIFO_DEPTH = 2`
  (**0.13918 mm², 278.4 %** at the depth-8 default the paragraph below and
  [DR-0019] were written against)
  ([`layout/floorplan/reports/area.json`](../layout/floorplan/reports/area.json),
  breakdown under *Area against the `< 0.05 mm²` row* in
  [`layout/floorplan/README.md`](../layout/floorplan/README.md)).
  The split matters — the isolated entropy source, samplers, guard rings and
  isolation channels together are **15.28 %** of the row (the 4.7 % this line
  used to quote predates #135/#209/#210's analog-region resizes; the figure
  here is what the same re-run prints), and the whole miss is
  the digital section at **251 %**, of which the two 8 × 32-bit output FIFOs
  are 69.8 % (both figures at depth 8; at depth 2 the digital section is
  114.1 % of the row and the FIFOs are 11 626 µm², 34.5 % of its cell area).
  That is the same structure [DR-0017] blames for the idle-current
  miss: one design decision showing up on two rows. It is an inventory
  estimate with a stated method — no synthesiser, placer or router has run on
  this block — so it is not a measurement, and per `CLAUDE.md` the row is not
  edited here: the miss is recorded in [DR-0019] (`Accepted` 2026-09-07 via
  the two-key ratification mechanism, `2AMLogic/2am#372`/#213), which priced
  four available responses and found that the shared FIFO-depth lever
  reaches the two rows very differently — futile on idle current at every
  depth ([DR-0017] §B), but worth 269.4 % → 105.8 % of the area row between
  depth 8 and depth 1. Its ratified Decision (option C) therefore holds the
  row rather than moving it, and sequences the response behind the
  `FIFO_DEPTH` decision jointly owned with [DR-0017] and [DR-0013]. That
  joint decision is itself now [DR-0020] (also `Accepted` 2026-09-07,
  same mechanism): `FIFO_DEPTH = 2`. **That value is now shipped** — issue
  #254 carried it into `design/interface/regmap.py`, the RTL parameter
  default and both inventory estimates — and re-running the floorplan at it
  brings the estimate from **278.4 % to 137.7 %** of the row (0.13918 mm² →
  **0.06885 mm²**; the digital section's own cell area falls 74 485 µm² →
  33 655 µm², and 40 357 µm² of that 40 831 µm² drop is FIFO storage, read
  mux and per-word clock gates). At that
  time it was still a miss, by 1.4×, and it moved the *estimate* only: the
  composed figure in `area.json` was then **642.9 %**, measured from
  `layout/digital/trng_top.gds`, the depth-8 place-and-route, which #254 did
  not re-synthesize (superseded by the #256 regeneration, above). The 129.4 % [DR-0020] itself quotes is superseded by the
  137.7 % above: that figure predated issues #119/#135's analog-region
  resizes and was computed against the older 269.4 % baseline.

### 2026-10-11 — what the 351.6 % figure is, and one superseded sentence (#495)

Appended; the 2026-10-10 entry above is unchanged. This entry corrects its
description of where the figure comes from. Source read:
[`layout/floorplan/reports/area.json`](../layout/floorplan/reports/area.json)
(`rollup.share_of_budget_pct` = 351.6), the footprint table in
[`layout/floorplan/floorplan.py`](../layout/floorplan/floorplan.py)
(`ASSEMBLED_RING_GDS`), and the committed digital place-and-route in
[`layout/digital/`](../layout/digital/) (`trng_top.gds`,
`reports/place_and_route.json`).

**Superseded statement.** The sentence in the 2026-10-10 bullet above reading
"It is an inventory estimate with a stated method — no synthesiser, placer or
router has run on this block — so it is not a measurement" is no longer
accurate for the current figure, and is superseded by this entry. It described
the pre-layout inventory (the 0.06885 mm² / 137.7 % and 0.13918 mm² / 278.4 %
numbers, which really are bottom-up estimates). The digital section has been
synthesised, placed and routed since #170, and the current 351.6 % figure is
not that inventory.

**What the 351.6 % is.** In `area.json` the rollup's `floorplan_area_um2` is
the sum of the guarded-region areas plus the declared 20 µm isolation channels:
174 030.2 µm² = 165 544.1 µm² guarded regions + 8 486.1 µm² channels (after #705; was
173 157.9 µm² = 164 703.6 + 8 454.3 after #709, and 175 789.9 µm² = 167 271.3 + 8 518.6 before it), against
the 50 000 µm² budget. Each of the four regions is sized from the bounding box
of its committed, DRC-checked assembled GDS, not from a cell-area estimate:
the digital region from `layout/digital/trng_top.gds` (398.93 × 398.93 µm, the
`FIFO_DEPTH = 2` place-and-route; 160 744.9 µm² guarded, 91 % of the total),
the analog regions from their ring and `combiner_sampler` assemblies. So the
figure is a footprint read from real committed layout geometry, composed by the
floorplan; it is not an inventory estimate. The per-region `cell_area_um2`
values (the standard-cell inventory, 34 447.2 µm² in total) are still
estimates, but they do not enter the 351.6 %.

**What it is not.** It is not a signoff die area. It is a sum of region areas
(guard rings and channels included), not the area of one placed-and-routed
die: the row bounding box, 934.4 × 416.7 µm, is reported separately; the
digital block's die was sized from a utilisation input rather than minimised
(see [`layout/digital/README.md`](../layout/digital/README.md#area)); and the
reported total excludes the ring liveness monitor
(`area.json` `excluded.ring_liveness_monitor_DR0016`, 2 849.4 µm² of cell
area). No physical validation beyond the committed DRC/LVS reports is claimed.

**Tag.** `missed` stays: the Status-tags table above allows it for Area when
the figure is read from the regenerated floorplan rollup, and the figure does
not satisfy `< 0.05 mm²`. The README Area tag already says "regenerated
floorplan" and is not misleading, so it is unchanged. The target and
[DR-0019] are untouched. The module docstring of `floorplan.py` and the
`_comment` field of `area.json` still carry the older "no synthesiser, placer
or router has been run" wording; they are generated or code-side text outside
this docs-only change and describe the estimate method only, not the footprint
sizing above.
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
