2AMLogic/gf180-trng/design/power-intent.md

# Power intent for a power-gated digital section

Status: **intent and verification only.** Nothing here changes the shipped RTL,
netlist, layout or any spec row. The `Power` row's idle half and DR-0017 stand
as written; whether the row can be met this way is a decision for the operator
(see "Does idle-with-state-retained still hold?" below, routed via #700).

This document says what a power-gated `trng_top` digital section would have to
do, in a form `sim/tools/power_intent_check.py` can hold the rest of the repo to.
[DR-0017](../spec/decision-records/DR-0017-idle-current-row-versus-ungated-standard-cell-leakage.md)
records that gating is the only lever left on the idle row and that the cell
library has no isolation, retention or switch cell; this file is the missing
power-intent description. The switch cell, its sizing and its numbers are #707.

## Domains

| Domain | Contents | Rail |
|---|---|---|
| **gated** | everything in `trng_top` (conditioner, health tests, ring liveness, interface, FIFOs, datapath) except the always-on set | switched (header, #707) |
| **always-on** | the retained flops below; the isolation cells on every output; the retention clock gate; the power sequencer | un-gated |
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
