2AMLogic/gf180-trng/sim/inventory-levers/README.md

# Digital inventory levers (#709)

Evidence for the inventory half of the Power and Area design-change work (#700):
which cell-level reductions in the digital section move the `< 1 uA` idle and
`< 0.05 mm^2` area rows, and by how much.

- [`levers.md`](levers.md) -- the before/after table, generated by
  `python3 sim/tools/inventory_levers.py --write` (`--check` fails when stale).
- The one RTL candidate priced in #716 (`raw_shift` without reset, `raw_bit_count` sized from
  `TRNG_RAW_PACK_BITS`) is **adopted** in `design/interface/trng_interface.v` (see below).

## Result

The one RTL candidate is adopted and measured (next section); neither the idle
nor the area row comes near `met`. The digital leakage floor is the flop and
combinational population that DR-0017 and DR-0019 already identified. Latch
storage is the one remaining lever with visible reach (about a further 200 nA
in the inventory estimate) and it is not adopted, for the reasons in `levers.md`.

## Adopted: measured result (#709)

The patch priced in #716 is applied, and the digital chain was re-run from the
new RTL (`design/synth.py`, `layout/digital/build.py`, `lvs.py`, `gen_sdf.py`,
`sim/tb/digital-sta-power/run_sta.py`, `layout/floorplan/floorplan.py --write`).
Every figure below is tool output, before and after:

| | before (#716's tree) | after |
|---|---|---|
| synthesized instances | 1459 | 1395 |
| synthesized area um^2 | 57 435.84 | 56 464.93 |
| `dffq_1` / `dffrnq_1` (synthesized) | 128 / 190 | 159 / 158 |
| placed logical instances | 1490 | 1423 |
| placed cell area um^2 (`run_sta.py` records) | 62 081.5 | 60 743.7 |
| routed digital die um^2 (`place_and_route.json`) | 159 145 | 156 590 |
| floorplan area um^2 (`area.json`) | 175 789.86 | 174 030.17 |
| worst idle uA (`power_rollup.py`) | 2.211 | 2.148 |
| worst active uW (`power_rollup.py`) | 418.5 | 418.3 |

Against the ratified rows: idle `< 1 uA` and area `< 0.05 mm^2` are both still
missed (215 % and 346 % of the rows); active `< 500 uW` was already met at
the rollup. The measured moves (-63 nA, -2 632 um^2) are close to #716's
projection (2.137 uA, 172 739 um^2). `sim/tests/test_interface.py` (including
the RTL-versus-model equivalence run under iverilog) covers the unchanged
regmap and streaming behaviour. The table in `levers.md` is now priced from
the adopted inventory, so its baseline row is the new tree.

## Candidates not attempted, and why

- **Conditioner (41 flops) and health tests (45 flops) width audit.** Counter widths
  are derived from the ratified parameters (`$clog2(C_RCT + 1)`, `$clog2(W + 1)`,
  `$clog2(BLOCK_BITS)`), so each is already the minimum for its range; 41 = 32 CRC
  state + 8 block counter + 1 valid strobe. No reduction without changing DR-0002 or the
  conditioner definition.
- **Interface pointers and counters (candidate 4).** The occupancy counters are
  `TRNG_LEVEL_BITS = 4` wide against a depth-2 need of 2; narrowing is a regmap
  change (`LEVEL_BITS`, DR-0013/DR-0020), so it needs a decision record and is out of scope.
- **FIFO depth and merging the raw FIFO.** Rejected by the issue (DR-0020).
- **Depth-2 read mux structure.** One `mux2_1` per bit is already the smallest 2:1 cell.

## Drift against the issue text

The issue quotes 758.2 uW active at `18d24d1`. At the tree this was built on,
`python3 sim/tools/power_rollup.py` reports a worst active corner of 418.5 uW
(83.7 % of `< 500 uW`) and a worst idle corner of 2.211 uA (221 %), so the
active row reads `met` at that rollup and only the idle row and the area row remain open.
The inventory also lists 8 control flops where the RTL has 9 (`fail_ring`), a
discrepancy outside this issue.
