2AMLogic/gf180-trng/design/health_test/README.md

# `design/health_test/` — on-die health tests (RCT + APT) and per-ring liveness

The continuous health-test block: the Repetition Count Test (RCT), the
Adaptive Proportion Test (APT), and the start-up test built from the same two
tests, plus the per-ring liveness monitor. Fixed by
[`DR-0002`](../../spec/decision-records/DR-0002-health-test-parameters-and-failure-behavior.md)
(RCT/APT/start-up) and
[`DR-0016`](../../spec/decision-records/DR-0016-per-ring-liveness-monitor.md)
(per-ring liveness); verified at the level fixed by
[`DR-0009`](../../spec/decision-records/DR-0009-behavioral-vs-transistor-verification-split.md);
follows the `design/conditioner/` (#8) structural precedent.

```
                       ┌───────────────────────────────────────────┐
  raw_bit/raw_valid ──►│ RCT: longest run of a repeated value      │──► ht_fail_rct
  (DR-0001 raw tap,    │ APT: reference-value recurrence per window│──► ht_fail_apt
   undecimated)        │ start-up: STARTUP_SAMPLES clean samples   │──► ht_startup_pass
                       └───────────────────────────────────────────┘
                                          ▲
                                    startup_req (from design/interface/, #26)

                       ┌───────────────────────────────────────────┐
  ring_bit[N-1:0]  ───►│ N x RCT, one per ring (DR-0016)            │──► ring_stuck[N-1:0]
  (per-ring, already   │                                            │──► ring_stuck_any
   digitized/synced)   └───────────────────────────────────────────┘
```

**Both RCT/APT observe the raw tap directly, at the full raw sample rate,
undecimated** (DR-0002 "Test inputs and placement") — never the conditioned
stream — and **the liveness monitor observes each ring's own digitized
sample instead** (DR-0016), because RCT/APT's combined-tap view cannot see one
dead ring out of N=2 (design/README.md "Per-ring liveness"). Neither block
gates anything itself. Gating, latching, and the FIFO flush live downstream in
`design/interface/` (#26); see
[Interface contract](#interface-contract-with-designinterface-26) below.
**`ring_stuck_any` reaches that path as `ht_fail_ring`** — the third source of
DR-0002's single latch, wired in `design/trng_top/` by #65 and reported by
`STATUS.HT_FAIL_RING`.

## Files

| File | What it is |
|---|---|
| `rct_apt.py` | **Normative** bit-exact behavioural model: the cutoff formulas (`c_rct`, `c_apt`), the APT tail-probability check, and the cycle-accurate `HealthTest` state machine. DR-0009 makes this the definition of correct behaviour. |
| `rct_apt.v` | Synthesisable RTL. Checked against the model cycle-for-cycle under Icarus Verilog by `sim/tests/test_health_test.py`. |
| `ring_liveness.py` | **Normative** bit-exact behavioural model of the per-ring liveness monitor (DR-0016): N independent instances of `rct_apt.c_rct`'s RCT run-length test, one per ring. |
| `ring_liveness.v` | Synthesisable RTL (`trng_ring_liveness`). Checked against the model cycle-for-cycle under Icarus Verilog by `sim/tests/test_ring_liveness.py`. |

## Cutoffs are parameters, not constants

DR-0002 is explicit: "the implementation should make both cutoffs
**parameters, not hard-coded constants**." `rct_apt.py` implements this as:

- `c_rct(h, alpha=ALPHA)` = `1 + ceil(-log2(alpha) / h)`.
- `c_apt(h, alpha=ALPHA, w=W)` = the smallest `C` with `Pr(X >= C) <= alpha`
  for `X ~ Binomial(w, 2**-h)`, computed by exact `Decimal` binomial-tail
  summation (120 digits of precision — the same budget
  `sim/tb/conditioner-crc32/sp800_90b.py` uses and for the same reason:
  `alpha = 2**-40 ~= 9.09e-13` and the tail terms at `w = 1024` span many
  orders of magnitude below that).
- `HealthTest(c_rct=..., c_apt=..., w=...)` takes the *resulting integer
  cutoffs* as constructor parameters (mirroring `crc32_conditioner.py`
  taking `K` as a parameter rather than baking in 256), or
  `HealthTest.from_h(h)` to go straight from an assumed `H`.
- `rct_apt.v`'s `C_RCT` / `C_APT` / `W` / `STARTUP_SAMPLES` are Verilog
  **parameters**. Their defaults (`81`, `824`, `1024`, `1024`) are the DR-0002
  draft `H0 = 0.5` cutoffs, and `sim/tests/test_health_test.py` mechanically
  checks the RTL's default parameter values against `rct_apt.py`'s formulas
  at `H0` — the same "generated artifact checked against its normative
  source" discipline `design/interface/regmap.py --check` uses, in the form
  this block actually has (no separate generated file, so the check lives in
  the test suite rather than a `--check` CLI flag).

Every one of DR-0002's cutoff-table rows (`H` = 0.1 .. 1.0) reproduces
exactly, along with the amendment A6 independent-verification tail
probabilities (`Pr(X >= 824) = 6.44e-13`, `Pr(X >= 823) = 1.10e-12` at
`H0 = 0.5`) — see `sim/tests/test_health_test.py::CutoffTableTests`.

**The ratified worst-corner `H` is #13's still-open deliverable.** Until it
lands, every construction in this repository uses the draft `H0 = 0.5`
default; recomputing for a ratified `H` is a one-argument change to
`HealthTest.from_h(h)`, not a redesign.

### APT degeneracy floor: refused, not silently accepted

DR-0002's amendment A2 states a hard structural limit: once the assumed `H`
falls low enough (around `H <= 0.03-0.05` at the ratified `alpha`/`W`), no
valid `C_APT <= W` exists and the APT becomes structurally incapable of
firing. `c_apt()` reports this by returning `APT_DEGENERATE` (`W + 1`, a value
outside the valid range) rather than a plausible-looking wrong number, and
`HealthTest`/`HealthTest.from_h` **raise `ValueError`** at construction time
if handed a `C_APT` outside `[1, W]` — a pathologically low `H` cannot
silently produce an unusable cutoff. `rct_apt.v` carries the same guard as a
simulation-time (`synthesis translate_off`) elaboration check, since Verilog
parameters have no exception mechanism.

## The two tests

- **RCT** — tracks the length of the current run of a repeated raw-sample
  value. `ht_fail_rct` pulses for one cycle exactly when that run first
  reaches `C_RCT`; the run counter then **saturates** at `C_RCT` (it does not
  wrap), so a source stuck far longer than `C_RCT` samples produces exactly
  one pulse, not a periodic one every `C_RCT` samples.
- **APT** — non-overlapping windows of `W` raw samples. The first sample of a
  window is its reference; `ht_fail_apt` pulses for one cycle exactly when
  the window completes (its `W`th sample) with `C_APT` or more occurrences of
  the reference value, including the reference sample itself. A new window
  starts immediately after every completed window, whether or not it failed.
- **Start-up test** — a saturating counter of consecutive raw samples with
  neither test failing. `ht_startup_pass` pulses for one cycle exactly when
  it reaches `STARTUP_SAMPLES` (DR-0002 fixes this at exactly 1024, i.e.
  `== W` by default, kept as its own parameter for clarity). Any RCT/APT
  failure resets the counter to 0, and so does `startup_req`.

## The per-ring liveness monitor (DR-0016)

- **Mechanism**: N independent instances of the *same* RCT run-length test
  above, each watching one ring's own already-digitized, already-`clk`-
  synchronized sample (`ring_bit[i]`) instead of the combined raw tap.
  `ring_stuck[i]` pulses for one cycle exactly when ring `i`'s bit has
  repeated `C_LIVE` times in a row; the run counter saturates the same way
  RCT's does. `ring_stuck_any` is the bitwise OR of `ring_stuck`.
- **Why a separate observation point at all**: RCT/APT above observe the
  *combined* raw tap, where (per `design/README.md` "Per-ring liveness") one
  dead ring out of the shipped N=2 array still leaves a live ring driving the
  XOR node, so the combined stream can stay inside both cutoffs indefinitely
  while true min-entropy has halved.
- **`C_LIVE` defaults to `rct_apt.c_rct(H0)` = 81** — DR-0002's own draft
  `C_RCT`, reused unchanged rather than re-derived, because the same
  phase-aliasing argument DR-0002 already rests its `H0` assumption on for
  the combined tap applies identically to an individual ring's own sampled
  bit. A future ratified `H` (#13) updates both cutoffs from one edit.
- **Detection latency**: exactly `C_LIVE` sampler-clock cycles (default 81)
  after a ring's digitized bit starts holding a constant value — 81 us at
  DR-0003's ratified `> 1 Mbps`, 162 ms at DR-0010's proposed `> 500 bps`.
- **Digitizer**: `ring_bit[i]` is assumed already produced by a per-ring
  digitizer structurally identical to the raw tap's own `sampler_dff`
  (DR-0014's cell, unmodified) — this module performs no synchronization of
  its own, the same contract `rct_apt.v` has for `raw_bit`.
- **Flag, not hard stop**: `ring_stuck_any` is OR'd into the *same*
  latch-and-gate mechanism `ht_fail_rct`/`ht_fail_apt` already use — see
  DR-0016 "Failure behavior" for the full argument, and
  [The wiring, end to end](#the-wiring-end-to-end) below for where each hop
  lives.
- **No exposed per-ring tap (DR-0001)**: `ring_bit`/`ring_stuck`/
  `ring_stuck_any` are internal health-test-block signals only, the same
  status `raw_bit`/`ht_fail_rct` already have. `ro_array_core` does now carry
  `ro1`/`ro2` as observation-only *cell* pins so the digitizers can reach the
  ring nodes, but no per-ring signal reaches a die pin: DR-0001 constrains
  what the block publishes, not what it monitors internally.

## The wiring, end to end

Built by #65; before it, the monitor existed but nothing consumed it. Each
hop lives in exactly one file:

| Hop | Where | What it is |
|---|---|---|
| `ro1`/`ro2` leave the array | `design/xschem/ro_array_core.sch`/`.sym` | two observation-only output pins. No device added, no ring changed — a parent that leaves them unconnected gets the identical circuit, which is why the pre-#65 power and jitter records still describe that cell. |
| ring node → `ring_bit` | `design/xschem/sampler_core.sch` | two more `sampler_dff` instances (`xsr1`/`xsr2`), the raw tap's own already-characterized cell (DR-0014), on the same DR-0012 external clock. Their electrical cost is measured, not assumed: `sim/tb/ring-liveness-tap-power/`. |
| `ring_bit` → `ring_stuck_any` | `design/health_test/ring_liveness.v` | this block. Reports; never latches or gates. |
| `ring_stuck_any` → alarm/gate | `design/trng_top/trng_top.v`/`.py` → `design/interface/` | wired to the interface's `ht_fail_ring` input, the third source of the DR-0002 latch. |
| the reader's view | `STATUS.HT_FAIL_RING` (bit 9, W1C) | latched, distinguishable from `HT_FAIL_RCT`/`HT_FAIL_APT`, cleared the same way. |

`STATUS` says *a* ring stopped, not *which* one: a per-ring status bit would
make DR-0013's published register map depend on `N_RINGS`. `ring_stuck[i]`
stays a named net in `trng_top.v`, which is where a future per-ring report
would take it from.

## Interface contract with `design/interface/` (#26)

Port names/directions match `design/interface/regmap.py`'s port table exactly
(from *this* block's point of view — the regmap table is written from the
interface block's side, so the direction there is inverted):

| Port | Dir (this block) | Width | Meaning |
|---|---|---|---|
| `clk` | in | 1 | sampler clock (DR-0012: fixed external) |
| `rst_n` | in | 1 | asynchronous power-on reset, active low |
| `raw_bit` | in | 1 | the DR-0001 raw tap |
| `raw_valid` | in | 1 | `raw_bit` carries a new sample this cycle |
| `startup_req` | in | 1 | restart: discard any in-flight window, re-arm the start-up test |
| `ht_fail_rct` | out | 1 | one-cycle RCT failure pulse |
| `ht_fail_apt` | out | 1 | one-cycle APT failure pulse |
| `ht_startup_pass` | out | 1 | one-cycle pulse: `STARTUP_SAMPLES` consecutive clean raw samples |

`startup_req` **takes priority over absorbing that cycle's raw sample** — the
same priority `crc32_conditioner.v`'s `flush` has over absorption: a sample
presented in the same cycle as a restart belongs to the window being
discarded, not the fresh one.

## What is *not* here

- **Latching, gating, and the FIFO flush.** `design/interface/README.md`'s
  block diagram shows exactly where: `ht_fail_* ───► latch ──► ht_alarm, gate
  ──► startup_req`. This block only ever *reports* — including
  `ring_stuck_any` — and never decides what happens to the conditioned or raw
  output paths. The consuming end is `design/interface/`'s `ht_fail_ring`
  input; the connection between them is `design/trng_top/`'s.
- **The raw tap itself, and the per-ring digitizers.** Those are #9's
  `sampler_core` (`xsb`/`xsv` for the raw tap, `xsr1`/`xsr2` for the ring
  taps since #65); this block only consumes the already-digitized,
  already-synchronized `raw_bit`/`raw_valid` and `ring_bit`.
- **Per-ring reporting.** `STATUS.HT_FAIL_RING` says a ring stopped, not
  which one — see "The wiring, end to end" above for why.
- **A ratified worst-corner `H`.** #13's deliverable; this block ships with
  the DR-0002 draft `H0 = 0.5` default and the parameter hook to take a
  different value once #13 lands (both `C_RCT` and `C_LIVE`).

## Running things

```sh
# Contract tests, the DR-0002 cutoff-table and degeneracy-floor checks,
# fault-injection detection-latency checks, and RTL/model equivalence. The
# equivalence tests skip (they do not silently pass) without iverilog.
python3 -m unittest discover -s sim/tests -t sim/tests

# Demonstration run: fault injection against the real health-test model.
python3 sim/tb/health-test-fault-injection/run_demo.py --no-write

# Demonstration run: fault injection against the per-ring liveness monitor
# (DR-0016) -- freezes one (then both) ring's digitized bit and confirms
# ring_stuck fires within C_LIVE samples, while a healthy ring never does.
python3 sim/tb/ring-liveness-fault-injection/run_demo.py --no-write
```

## Health warning

A clear `ht_alarm` at the interface means no RCT or APT window has tripped
its cutoff **since the last restart** — at cutoffs derived from an
**assumed** `H0 = 0.5` (DR-0002), which no measurement has yet replaced, and
against a false-positive target (`alpha = 2**-40`) that this repository has
never observed directly (see the `false-positive-rate` fault-injection
scenario). It does not mean the bits are good; it means neither test has
detected a problem yet.
