2AMLogic/gf180-trng/sim/characterization-startup-and-power-budget.md

# Start-up, time-to-first-valid, and the whole-block power budget

Status: characterization complete for issue #14. Supplies the first evidence
this repository has ever had behind two ratified README rows —
`Time-to-first-valid` and `Power` — both of which were ratified explicitly
unmeasured.

**This document is an ordinary summary, not evidence.** Every measured number
below cites the `sim/records/` stem family that produced it, and every number
that is an *estimate* rather than a measurement says so on the line it appears
on. Two commands regenerate everything here from committed records:

```sh
python3 sim/tools/time_to_first_valid.py
python3 sim/tools/power_rollup.py
```

**One ratified row is met and one is missed, and neither is edited by this
issue.** Per `CLAUDE.md`, a row the evidence contradicts is **reported, not
relaxed**: the miss is stated below with numbers and routed to
[`DR-0017`](../spec/decision-records/DR-0017-idle-current-row-versus-ungated-standard-cell-leakage.md),
which proposes what to do about it and is `Proposed`, not ratified. Nothing
here decides anything.

> **Update — the array this document measured is no longer the array that
> ships (#78 / [`DR-0018`](../spec/decision-records/DR-0018-adopt-per-ring-output-buffer.md)).**
> Every number below was measured on the *unbuffered* entropy array. #78
> adopted the per-ring output buffer and re-ran the three families this
> document reads (`ro-array-core-power`, `ro-array-core-pvt-q`,
> `ro-array-core-startup`), which moves the active-power row from **454.2 µW
> (90.8 %)** to **433.2 µW (86.6 %)** — the array got *cheaper*, so the
> "met" verdict below is met by a wider margin, not narrower. The idle row
> and the time-to-first-valid row are unchanged in verdict. The two commands
> above regenerate the current numbers from the current records at any time;
> the text below is left in the state issue #14 measured it in, because the
> re-run does not make what it measured untrue. Where a number here matters
> to a decision, prefer the tool output over this document.

> **Update — the digital section's contribution to both power rows is no
> longer an estimate (#174 /
> [`DR-0023`](../spec/decision-records/DR-0023-power-rollup-digital-term-becomes-measured-gate-level-power.md),
> Proposed).** `sim/tools/power_rollup.py`'s digital term now comes from
> #145's measured gate-level power sweep
> (`sim/characterization-digital-sta-area-power.md`) instead of from
> `design/digital_power_estimate.py`. That moves the **active row from met
> (433.2 µW, 86.6 %) to missed (1.122 mW, 224.5 %)** — the digital section
> alone, at its own worst measured corner (`ff_125C_3v60`/`max`), is 712.4 µW,
> more than the whole row on its own — and **narrows the idle row's
> already-`Proposed` [DR-0017] miss from 4.46 µA/4.5× to 3.979 µA/~4.0×**.
> Neither ratified row is edited: the active miss is reported here exactly as
> the idle miss already is, routed to [DR-0023] (Proposed). The numbers below
> are left in the state issue #14 measured them in, for the same reason the
> #78 update above gives; `python3 sim/tools/power_rollup.py` is the current
> source of truth.

> **Update — the interface's output FIFOs are now 2 words deep, not 8, so
> `design/digital_power_estimate.py`'s side of this document is a different
> estimate than the one recorded below (#254 /
> [`DR-0020`](../spec/decision-records/DR-0020-fifo-depth-set-to-two-against-power-area-and-streaming.md),
> `Accepted`).** The estimate's interface inventory now scales with
> `FIFO_DEPTH`, and at the ratified depth of 2 it reports **184 interface
> flops (658 → 270 shipped flops in total)** and a digital idle figure of
> **2.03 µA, 202.7 % of the `< 1 µA` row**, against the **4.43 µA / 442 %**
> recorded below at depth 8 — close to the 2.04 µA [DR-0017] §B projected for
> this depth, the small remainder being that this run also narrows the FIFO
> pointers (`PTR_W` 3 → 1 bits), which that projection deliberately held
> fixed. **The row is still missed by 2.0×**, exactly as [DR-0017] said no
> depth could fix, and no row is edited here. Two things this does *not*
> change: every measured number below (all transistor-level, and none of them
> FIFO-dependent), and the **measured gate-level** digital term
> `power_rollup.py` has read since #174/[DR-0023] — that comes from
> `design/trng_top/trng_top.synth.v` and `layout/digital/trng_top.def`, which
> are still the depth-8 synthesis and placement, since re-synthesising at the
> new depth is explicitly outside #254. So the headline verdicts in this
> document are unchanged; what moved is the pre-synthesis estimate that is now
> quoted as context.
>
> **Every figure this document quotes from that script now carries the
> `FIFO_DEPTH` it was produced at, inline at the point of quotation, with its
> depth-2 counterpart beside it (#257).** The estimate's active-side figure
> moves the same way as its idle one: **23.1 µW → 20.6 µW** at the active row's
> binding corner. The depth-8 numbers are kept beside the depth-2 ones rather
> than overwritten, for the same reason the two updates above keep what they
> superseded — they are what issue #14 computed and what [DR-0017] reasons
> about — but no estimate below can now be read without its depth, which is
> exactly how this document went stale silently the first time.

> **Update — the measured gate-level digital term is no longer depth-8
> synthesis either (#255/#266,
> [`DR-0020`](../spec/decision-records/DR-0020-fifo-depth-set-to-two-against-power-area-and-streaming.md)).**
> The previous update noted that `power_rollup.py`'s **measured**
> (not estimated) digital term still came from the depth-8
> `design/trng_top/trng_top.synth.v` / `layout/digital/trng_top.def` build,
> because re-synthesising at the shipped depth was explicitly outside #254's
> scope. #255 did that re-synthesis and re-place-and-route at
> [DR-0020]'s ratified `FIFO_DEPTH = 2` and reran #145's same fifteen-corner
> `level: gate` sweep ([DR-0021]) against it; #266 carried the result into
> the committed `sim/records/*-digital-sta-power-*.md` family.
> `sim/tools/power_rollup.py`'s digital term already reads that family live
> via `sim/tools/digital_corner_characterization.py` (no code changed by
> #255/#266), so the rollup's own arithmetic reflects the new figures without
> a tool edit — only this document's frozen headline numbers needed a
> pointer. At the digital section's own worst corners:
>
> | | depth-8 (#145, superseded) | depth-2 (#255/#266, current) |
> |---|---:|---:|
> | Digital active, `ff_125C_3v60`/`rc-max` | 712.4 µW | **358.5 µW** |
> | Digital idle leakage, `ff_125C_3v60` | 4.062 µA | **1.974 µA** |
>
> which moves the whole-block headline to **active 768.5 µW, 153.7 % of the
> row** (entropy array 393.2 µW + sampler 16.9 µW + digital 358.5 µW,
> missed by 1.5× instead of 2.2×) and **idle 2.007 µA, 201 % of the row**
> (analog 32.8 nA + digital 1.974 µA, missed by ~2.0× instead of ~4.1×). Both
> rows are still missed — [DR-0017] §B already priced the FIFO-depth lever
> as insufficient on idle current at any depth, and that prediction holds.
> No new decision record supersedes [DR-0023] or [DR-0017]: this is the same
> digital-term substitution those records already ratified, re-run against
> [DR-0020]'s own depth, not a new decision. As with every update above, the
> numbers in the sections below are left in the state they were measured in;
> `python3 sim/tools/power_rollup.py` is the current source of truth.

---

## Headline

| Row | Ratified target | Measured / estimated | Binding corner | Verdict |
|---|---|---|---|---|
| Time-to-first-valid | ≥ ~1.28 ms at 1 Mbps (an arithmetic floor) | **1.281 ms** | `ss`/+125 °C/2.97 V, but see below — the corner barely matters | **Met**, and the floor is confirmed as a floor |
| Power — active | < 500 µW | **454.2 µW** (415.3 measured + 15.8 measured + 23.1 **estimated at `FIFO_DEPTH = 8`**; that estimate term is **20.6 µW** at [DR-0020]'s ratified `FIFO_DEPTH = 2`, for **451.7 µW / 90.3 %** on the same rollup) — pre-#78, see the update above; **433.2 µW (86.6 %)** against the buffered array, digital still **estimated**; **1.122 mW (224.5 %)** since #174/[DR-0023], digital now **measured-at-gate-level** (that measured term was depth-8 synthesis); **768.5 µW (153.7 %)** since #255/#266 re-ran the same measured-at-gate-level sweep at the shipped depth-2 synthesis (see the update above) | `ff`/−40 °C/3.63 V | pre-#174: **Met**, 86.6 % of the row. #174/[DR-0023] (depth-8 measured): **Missed, 2.2×**. #255/#266 (depth-2 measured, current): **Missed, 1.5×** |
| Power — idle | < 1 µA | **4.46 µA** (32.8 nA measured + 4.43 µA **estimated at `FIFO_DEPTH = 8`**; that estimate term is **2.03 µA** at the ratified `FIFO_DEPTH = 2`, for **2.06 µA / 206 %** on the same rollup); **3.979 µA** since #174/[DR-0023], digital now **measured-at-gate-level** (depth-8 synthesis); **2.007 µA (201 %)** since #255/#266 re-ran the same measured-at-gate-level sweep at the shipped depth-2 synthesis (see the update above) | `ff`/+125 °C/3.63 V | **Missed, 4.5×** → [DR-0017]; **2.1×** on the depth-2 estimate; narrowed to **~4.0×** since #174/[DR-0023] (depth-8 measured); **~2.0×** since #255/#266 (depth-2 measured, current) |

---

## What is and is not covered

**Covered, transistor-level, measured:**

- The shipped entropy array's start-up from its real clamped idle state, over
  the 27-point covered grid — `sim/records/2026-08-02-ro-array-core-startup-{01..27}.md`.
- Both `sampler_dff` instances' active energy per switching event, over the
  full 45-point grid — `sim/records/2026-08-02-sampler-dff-active-current-{01..45}.md`.
- The whole of `sampler_core` (two rings + XOR combiner + both flops) in the
  README's ratified idle state, over the full 45-point grid —
  `sim/records/2026-08-02-sampler-core-idle-leakage-{01..45}.md`.
- The array's active power and its `xo` transition rate, at each corner —
  pre-existing, `…-ro-array-core-pvt-q-{01..27}.md` and `…-ro-array-core-power-*.md`.

**Covered, estimated, never measured:** the conditioner (#8), the health tests
(#11) and the interface (#26). These are RTL/behavioural only — no schematic,
no netlist, no synthesis flow in this repository — so there is nothing to hand
ngspice. `design/digital_power_estimate.py` is the substitute: a gate-level
inventory of each block's RTL evaluated against the `gf180mcu_fd_sc_mcu7t5v0`
Liberty library that ships with the PDK. It is a [DR-0004] Tier 2 estimate and
is labelled as one everywhere it appears.

**That inventory scales with the interface's `FIFO_DEPTH`**, which [DR-0020]
ratified at 2 and #254 carried into the RTL, the register map and the script
itself. Every figure below that comes from this script therefore carries the
depth it was computed at — issue #14's `FIFO_DEPTH = 8` numbers and the shipped
`FIFO_DEPTH = 2` numbers side by side — and nothing here quotes a depth-free
estimate. `sim/tests/test_power_rollups.py` holds the script's own
`FIFO_DEPTH` to `design/interface/trng_interface.v`'s, so the two cannot drift
apart again without a test failing; it cannot, however, tell that this prose
has gone stale, which is what the depth labels are for.

That script does **not** mint a `sim/records/` entry, deliberately. It runs no
simulation: `sim/records/` is simulation evidence, and a library lookup dressed
as a record would blur exactly the measured/estimated line this whole document
depends on. It follows the precedent `design/conditioner/area_estimate.py`
already set, whose area figures DR-0008 cites directly from the script.

**Not covered, and not projected:** post-layout parasitics (#15/#17), pads and
I/O, any clock source (the block contains none — [DR-0012-clock]), and the two taps
that exist but are not instantiated by the shipped block (see
[Two taps that are not in the total](#two-taps-that-are-not-in-the-total)).

---

## Time-to-first-valid

### What the row claimed, and what was missing from it

> **≥ ~1.28 ms** at 1 Mbps — an arithmetic floor, not a measurement: 1024
> consecutive raw samples for the start-up health test (1.024 ms) plus 256
> samples of conditioner latency (0.256 ms), which do not overlap.

Two things were missing. The floor starts counting at the first raw sample, as
though the entropy source were already running — the oscillator's own start-up
was assumed away rather than bounded. And it converts sample *counts* into a
time using one rate, without saying that the rate row is itself unsettled.

### The oscillator starts in one period

`sim/tb/ro-array-core-startup/` holds `en` low from t = 0, lets ngspice solve
the clamped operating point, and toggles `en` at 5 ns. It uses **no `.ic`
kick** — the running decks need one because at `en = 1` a noiseless solver can
sit at the ring's unstable symmetric equilibrium, but at `en = 0` the NAND's
output is forced high independently of its ring input, the loop gain is zero,
and there is exactly one stable DC solution. The rising `en` edge, not an
initial condition the testbench invented, is what starts the oscillation.

Across all 27 corners, `sim/tools/time_to_first_valid.py` (1 % period-convergence
band, applied to nine successive period estimates per ring, first-and-thereafter):

| Quantity | Range over the 27-point grid |
|---|---|
| Oscillator start-up, `en` → stable period, both rings | **4.40 ns** (`ff`/−40 °C/3.63 V) … **13.38 ns** (`ss`/+125 °C/2.97 V); **4.08 ns … 12.41 ns** at the same two corners after #78's buffer adoption |
| …as a multiple of that corner's own steady period | 1.02 – 1.03 × `T₀` |
| First rising edge on the XOR node `xo` after `en` | 1.96 – 5.89 ns |
| Ring swing, early window ÷ late window | 0.967 – 1.069 |

The array reaches its steady period in **essentially one ring period**. That
is a property of the topology rather than a lucky result: this is a
NAND-clamped digital ring released from a defined static state, not a resonator
building up amplitude, so there is no envelope to grow. The swing-ratio column
is there to prove the same thing about amplitude independently — a period that
converged while the amplitude was still climbing would show up as a ratio well
below 1, and none does.

Two runner-up mechanisms are also bounded rather than assumed:

- **`xo` before the rings settle.** The XOR node's first edge arrives *earlier*
  than either ring's settled time, so the sampler is never waiting on the
  combiner.
- **Sampler reset release.** `sim/tb/sampler-dff-reset-clocked/` already shows
  `Q` at full rail (within ±3.4 ppm of supply) on the first rising edge after
  `rst_n` releases, at all 45 PVT points. The rollup charges exactly one sample
  period for it.

### The total, and what actually sets it

At DR-0003's ratified 1 Mbps:

| Term | Samples | Time | Share |
|---|---|---|---|
| Oscillator start-up (measured, worst corner) | — | 13.38 ns (12.41 ns since #78) | 0.001 % |
| Sampler, reset release → first raw bit | 1 | 1 µs | 0.08 % |
| DR-0002 start-up health test | 1024 | 1.024 ms | 79.9 % |
| DR-0008 conditioner latency (K = 8) | 256 | 256 µs | 20.0 % |
| **Total** | **1281** | **1.281 ms** | |

**The row is met and the floor is confirmed as a floor** — the measured total
is 1.00079× the README's ~1.28 ms, the excess being the one sampler clock the
floor did not count. The oscillator contributes one part in 10⁵.

### Two things this changes about how the row should be read

1. **Its stated binding corner is very nearly vacuous.** The row says it "binds
   at `ss` / −10 % / +125 °C (slowest sampling)". [DR-0012-clock] made the sample
   clock a *fixed external* clock, so the sample period does not move with PVT
   at all, and 99.999 % of this row is 1281 fixed sample periods. The corner
   spread across the whole grid is **9 ns on 1.281 ms**. The corner label is
   still formally correct — `ss`/+125 °C/2.97 V *is* the slowest — but a reader
   who takes it to mean the row is corner-sensitive is being misled by it.
2. **The row is a rate consequence, and the rate row is unsettled.** At
   [DR-0010]'s proposed 500 bps the same 1281 samples take **2.562 s** — 2000×
   worse, and a materially different product claim. DR-0010 §Consequences
   already names this row as one of the three things that must be re-derived on
   acceptance; this document supplies the arithmetic so that re-derivation is a
   lookup rather than a fresh analysis:

   ```sh
   python3 sim/tools/time_to_first_valid.py --rate 500
   ```

---

## Power

### Active: met, at 90.8 % of the row (90.3 % with the estimate at the shipped FIFO depth)

At the binding corner `ff`/−40 °C/3.63 V, from
`python3 sim/tools/power_rollup.py`:

| Term | Power | Share of the < 500 µW row | Source |
|---|---|---|---|
| Entropy array (2 rings + XOR combiner) | 415.3 µW | 83.1 % | **measured**, `…-ro-array-core-power-04.md` / `…-pvt-q-*` |
| Sampler, data term | 15.7 µW | 3.1 % | **measured**, `…-sampler-dff-active-current-*` × that corner's `xo_trans_per_s` |
| Sampler, clock term | 60.3 nW | 0.01 % | **measured**, same family |
| Conditioner + health tests + interface, 1655 cells at `FIFO_DEPTH = 8` | 23.1 µW | 4.6 % | **ESTIMATE**, `design/digital_power_estimate.py` |
| **Total** | **454.2 µW** | **90.8 %** | |

**At [DR-0020]'s ratified `FIFO_DEPTH = 2`** (#254, the depth the RTL now
ships) the estimate row is **20.6 µW, 4.1 %** of the row — 863 cells instead of
1655 — and the same rollup totals **451.7 µW, 90.3 %**. The row's verdict does
not move: the estimate is 4–5 % of it at either depth, and since
#174/[DR-0023] the digital term that actually feeds `power_rollup.py` is the
measured gate-level one — depth-2 synthesis as of #255/#266 (see the update
above), not this estimate. `python3 sim/tools/power_rollup.py` prints the
depth-2 estimate beside the measured term as context.

DR-0010 §Consequences stated the risk precisely: "the entropy source uses 83 %
of the active budget … leaving ~85 µW for the sampler, health tests,
conditioner and register file — none of which exist or are measured. That is a
tight allocation and it is stated here rather than discovered later." That
allocation now has numbers behind it: **everything downstream of the array
needs 38.9 µW of the 84.7 µW available, i.e. 45.9 % of the headroom** at
`FIFO_DEPTH = 8`, **36.4 µW / 43.0 % at the ratified `FIFO_DEPTH = 2`**. The
allocation holds at either depth, with roughly a factor of two in hand.

#### The sampler burns power at the entropy node's rate, not the clock's

This is the non-obvious part of the sampler number and the reason
`sim/tb/sampler-dff-active-current/` measures energy per *event* instead of an
average current. `sampler_dff` is a transmission-gate master-slave flop: while
`clk` is low its master gate is transparent, so `xo`'s transitions propagate
into the master's internal nodes for **half of every clock period**. The flop
therefore dissipates at `xo`'s rate — 3.1×10⁸ to 9.6×10⁸ transitions/s across
the grid — and not at the 1 MHz sample rate. The measured decomposition, at
`ff`/−40 °C/3.63 V:

| Event | Charge | Rate applied | Contribution |
|---|---|---|---|
| One `D` transition, master **open** (`clk` low) | 9.02 fC | 4.80×10⁸ /s (½ × `xo_trans_per_s`) | 15.7 µW |
| One `D` transition, master **shut** (`clk` high) | ~0 (5×10⁻²⁰ C) | 4.80×10⁸ /s | negligible |
| One clock cycle, both instances | 8.3 fC each | 1×10⁶ /s | 60.3 nW |

The clock term is **260× smaller** than the data term. A deck that had simply
averaged current over one clock period would have reported the sum without
exposing which rate carried it — and would have been wrong by ~4× the moment
anyone quoted it against a different `xo` rate, which is exactly what
[DR-0010]'s rate change does. Only `xsb` (whose D is `xo`) pays the data term;
`xsv`'s D is tied to `vdd` and pays the clock term alone.

### Idle: missed by 4.5× at `FIFO_DEPTH = 8`, 2.1× at the shipped depth of 2 — and the analog side is not the reason either way

At the binding corner `ff`/+125 °C/3.63 V:

| Term | Current | Share of the < 1 µA row | Source |
|---|---|---|---|
| Whole `sampler_core` — 2 rings + XOR + both flops, clamped, reset released, clock parked | **32.8 nA** | 3.3 % | **measured**, `…-sampler-core-idle-leakage-*` |
| Conditioner + health tests + interface, 658 flops / 1655 cells at `FIFO_DEPTH = 8`, no power gating | **4.43 µA** | 442.5 % | **ESTIMATE**, `design/digital_power_estimate.py` |
| **Total** | **4.46 µA** | **446 %** | |

**At [DR-0020]'s ratified `FIFO_DEPTH = 2`** (#254) the same estimate is
**2.03 µA, 202.7 %** of the row — 270 flops / 863 cells — and the same total is
**2.06 µA, 206 %**. The row is still missed, by **2.1×** instead of 4.5×, which
is what [DR-0017] §B already priced: it projected 2.04 µA for this depth and
called no depth sufficient. Everything else in this section is unchanged by the
depth — the analog term is measured, transistor-level and contains no FIFO —
so the finding below survives the change with a smaller number in front of it.

Two separate findings, and they point in opposite directions:

- **The analog block is comfortable.** 32.8 nA at the leakiest corner is 3.3 %
  of the whole row, and the two clock-park states differ by only ~12 % (32.8 nA
  parked low, 29.2 nA parked high). The clamped ring array is a genuinely quiet
  idle state: every node sits at a rail with no crowbar path. This is the first
  measurement of the *shipped* block's idle current — the pre-existing
  `ro-inv-05stage-stopped-leakage` family measured the characterization-cell
  5-stage ring, not the shipped 11-stage starved array, and not the XOR tree or
  the flops.
- **The digital section blows the row on standard-cell leakage alone**, before
  any dynamic activity at all. Even the most favourable input-state assumption
  in the Liberty library gives 1.85 µA, still 1.8× over — at
  `FIFO_DEPTH = 8`. At the ratified `FIFO_DEPTH = 2` the default-state figure
  is 2.03 µA (2.0× over) and that most-favourable-state bound drops to
  **793 nA, 0.79× — under the row**. That bound is not an operating point: it
  is what the section would leak if every cell in it sat simultaneously in its
  own lowest-leakage input state, which no reachable state produces. The
  binding number is still the default-state 2.03 µA, and the row is still
  missed.

The README's own ratification note predicted this in words — "the < 1 µA idle
figure is order-of-magnitude questionable for an ungated few-kGE digital
section at `ff`/+125 °C without power gating" — and this is the measurement
that turns the prediction into a number. The response goes to
[`DR-0017`](../spec/decision-records/DR-0017-idle-current-row-versus-ungated-standard-cell-leakage.md),
which sizes the four available levers (power gating, retention, shrinking the
FIFOs, moving the row) against this evidence. **No row is edited here.**

#### How much of that estimate could be wrong

The idle miss rests on an estimate, so its uncertainty matters more than the
active number's does. The estimate splits almost exactly in half at either
`FIFO_DEPTH` (51 : 49 at depth 8, 45 : 55 at the shipped depth 2), and the two
halves have very different standing:

| Contribution | at `FIFO_DEPTH = 8` (what issue #14 computed) | at `FIFO_DEPTH = 2` ([DR-0020], shipped) | Standing |
|---|---|---|---|
| Flip-flops | 658 flops, 8.06 µW = **2.24 µA** (224 %) | 270 flops, 3.31 µW = **918 nA** (92 %) | **Enumerated.** Not an estimate. |
| Combinational cells | 997 cells, 7.87 µW = **2.19 µA** (219 %) | 593 cells, 3.99 µW = **1.11 µA** (111 %) | Structural estimate. |
| Total | 1655 cells, 15.93 µW = **4.43 µA** (442 %) | 863 cells, 7.30 µW = **2.03 µA** (203 %) | |

Both columns are the same corner (`ff`/+125 °C, the library's `ff_125C_3v60`)
and the same method; only the interface's FIFO-dependent inventory differs.
Reproduce either with `python3 design/digital_power_estimate.py` — it computes
at whatever `FIFO_DEPTH` the RTL currently declares, which is 2.

- **The flop count is not an estimate.** At `FIFO_DEPTH = 8`,
  41 + 45 + 572 = 658; at the ratified `FIFO_DEPTH = 2`,
  **41 + 45 + 184 = 270**. Either way it is read directly off the three
  modules' `reg` declarations at their shipped default parameters, and
  `sim/tests/test_power_rollups.py` fails if any parameter the count depends on
  (`FIFO_DEPTH`, `TRNG_LEVEL_BITS`, `C_RCT`, `W`, K) moves without the
  inventory being revisited — it now also asserts the script's `FIFO_DEPTH`
  against the RTL's. 512 of the 658 were the interface's two 8 × 32-bit output
  FIFOs; **128 of the 270 are the same two FIFOs at 2 × 32 bits**, which is
  where essentially the whole reduction comes from.
- **Per-cell leakage is characterised library data**, not a model — read out of
  the PDK's own `ff_125C_3v60` Liberty file, which is exactly the row's binding
  corner. The library is characterised at 3.60 V against the envelope's
  3.63 V; that 0.8 % gap is far below the estimate's own uncertainty and is not
  corrected for.
- **The combinational half is soft, and at `FIFO_DEPTH = 8` it is not the
  load-bearing half.** Its largest single item is the FIFO read path: 576
  `mux2_1` cells (two 32-bit 8:1 read muxes, the 4:1 `reg_rdata` mux and the
  streaming mux) at **5.60 µW** — default-state leakage read straight out of
  `ff_125C_3v60` (9.724 nW/cell × 576, the same per-cell figure and method as
  the table above), which a synthesiser might implement more cheaply than a
  mux tree. (This bullet previously said 6.28 µW; #262 found that number does
  not reproduce from the Liberty library at any leakage state, from
  `design/digital_power_estimate.py`'s leakage-plus-dynamic total for these
  three items (6.42 µW), or from any FIFO read-path cell count on record in
  this repository's history, and restated it here as a corrected figure
  rather than preserving it under this document's supersession convention.)
  **Delete every combinational cell in all three blocks and
  the flops alone still miss the row by 2.2×**; double every combinational
  count instead and the total goes to 6.6 µA. **At `FIFO_DEPTH = 2` the same
  three items are 192 `mux2_1` cells** — the read muxes go 2 × 32 × 7 = 448 to
  2 × 32 × 1 = 64, the 96-cell `reg_rdata` mux and the 32-cell streaming mux
  are depth-independent — still the largest single combinational item, at about
  a third of its depth-8 size.
- **Which half is load-bearing does change with the depth, and this is the one
  conclusion here that the depth-2 numbers genuinely move.** At
  `FIFO_DEPTH = 2` the enumerated flops alone are 918 nA, **92 % of the row —
  just under it**, not 2.2× over. Deleting every combinational cell would
  therefore no longer miss the row on the enumerated half alone; the miss at
  depth 2 rests on flops *plus* the soft combinational half (2.03 µA together),
  and doubling every combinational count instead gives 3.14 µA rather than
  6.6 µA. The estimate's uncertainty consequently matters more at the shipped
  depth than it did at depth 8.

Getting from 4.46 µA to under 1 µA is therefore not a matter of tightening the
estimate — at `FIFO_DEPTH = 8` the part of it that is not an estimate already
misses by 2.2×. At the ratified `FIFO_DEPTH = 2` the total is 2.06 µA, still
2.1× over, and the enumerated half no longer carries the miss on its own — but
the soft half would have to be all but eliminated rather than merely tightened
for that to matter: halve the 1.11 µA combinational estimate and the total is
still 1.51 µA, and only deleting it outright brings the block to 951 nA
(95 % of the row, with no margin for anything the inventory has not
enumerated). Shrinking the FIFOs was exactly [DR-0017] §B's lever, and this is
what pulling it was worth: a 2.2× improvement that does not reach the row,
which is what §B predicted when it rejected the option. It still needs a design
change, which is what DR-0017 is for.

### Two taps that are not in the total

> **Update (#463): the liveness digitizer is not an optional tap.** The text
> below, written before #65 integrated it, says neither tap is instantiated by
> the shipped `sampler_core`. That is true of the metastability hybrid only:
> `design/sampler_core.spice` instantiates `xsr1`/`xsr2`. The ~81 µW figure was
> measured on the unbuffered array at a 10 ns clock and is not the shipped
> topology's cost. `power_rollup.py` now carries the liveness samplers as a
> required ledger term with its own records and explicit corner gaps; see
> [`characterization-liveness-sampler-active-power.md`](characterization-liveness-sampler-active-power.md).
> `--with-taps` adds only the hybrid.

Both are measured, both exist in the tree, and neither is instantiated by the
shipped `sampler_core`/`trng_top`. They are excluded on the same basis
`design/README.md` already excludes the first, and `power_rollup.py --with-taps`
adds them so the cost of adopting one is a command rather than an argument:

| Tap | Measured cost | Effect on the active row if adopted |
|---|---|---|
| Metastability hybrid ([DR-0011-meta], `ro_array_core_meta`) | ~187 µW | 454 → 641 µW, **1.28× over** |
| Per-ring liveness digitizer ([DR-0016], `sim/tb/ring-liveness-tap-power/`) | ~81 µW | 454 → 536 µW, **1.07× over** |

Adopting either one moves the active row from met to missed. That is a real
constraint on #65 (promoting the liveness tap into shipped RTL/schematic) and
on any future decision to ship the hybrid, and it is stated here so neither is
taken as free.

---

## Method notes worth knowing before re-running anything

Three method choices in this work were arrived at by rejecting a more obvious
one. Each is argued in full in its testbench header; they are listed here
because each was a *wrong answer that ran cleanly*, which is the dangerous kind.

1. **`op` on `sampler_core` reports 193 µA of "leakage".** `sampler_dff`'s two
   storage loops are bistable, so once `rst_n` releases they have an unstable
   mid-rail DC solution alongside the two real ones, and nothing in an
   operating-point analysis prefers a stable one. The solver lands at 1.543 V
   on a 3.63 V rail with every latch inverter at its trip point, and reports
   crowbar current — five orders of magnitude above the 32.8 nA the settled
   transient measures. `sim/tb/sampler-core-idle-leakage/` therefore drives the
   block into idle the way a real one gets there (reset, one clock edge, then
   park) and reads the current 600 ns later, cross-checked against a second
   window.
2. **Instantaneous branch-current reads are unusable in a quiescent
   transient.** With nothing switching, ngspice's timestep grows to a large
   fraction of the measurement window, and `meas ... find i(vsource) at=1u`
   returned a value disagreeing with the integrated one by three orders of
   magnitude — and in sign. Every current in the idle family is a
   charge-integrator average over a stated window, with a second window as the
   record's own self-check.
3. **Averaging the sampler's current over one real clock period cannot be
   run,** and would be the wrong instrument even if it could. At the real
   `xo` rate one 1 µs clock period is ~2000 data periods; a first attempt at
   exactly that deck timed out at every one of 45 PVT points after 300 s each.
   The per-event decomposition is both affordable and more informative, because
   the rate it must be multiplied by is corner-dependent, separately measured,
   and — under DR-0010 — potentially about to change.

## Reproducing everything above

```sh
# The two rollups, from committed records only (no ngspice, no PDK for the
# first; the second degrades to measured-silicon-only without a PDK):
python3 sim/tools/time_to_first_valid.py
python3 sim/tools/power_rollup.py

# Their self-checks, both wired into CI:
python3 sim/tools/time_to_first_valid.py --check
python3 sim/tools/power_rollup.py --check

# The digital estimate on its own, at every characterised corner. It computes
# at whatever FIFO_DEPTH design/interface/trng_interface.v declares -- 2, per
# DR-0020 -- so this reproduces the depth-2 column above, not the depth-8 one:
python3 design/digital_power_estimate.py --all-corners

# The three testbenches (needs ngspice + the gf180mcu PDK):
python3 sim/run_corners.py ro-array-core-startup
python3 sim/run_corners.py sampler-dff-active-current
python3 sim/run_corners.py sampler-core-idle-leakage
```

[DR-0002]: ../spec/decision-records/DR-0002-health-test-parameters-and-failure-behavior.md
[DR-0003]: ../spec/decision-records/DR-0003-throughput-defined-at-the-raw-tap.md
[DR-0004]: ../spec/decision-records/DR-0004-sp-800-90b-path-pre-silicon.md
[DR-0008]: ../spec/decision-records/DR-0008-crc32-lfsr-non-vetted-conditioner.md
[DR-0010]: ../spec/decision-records/DR-0010-raw-rate-moves-to-the-measured-jitter-energy-limit.md
[DR-0011-meta]: ../spec/decision-records/DR-0011-metastability-hybrid-tap-claims-and-scope.md
[DR-0012-clock]: ../spec/decision-records/DR-0012-sampler-fixed-external-clock.md
[DR-0016]: ../spec/decision-records/DR-0016-per-ring-liveness-monitor.md
[DR-0017]: ../spec/decision-records/DR-0017-idle-current-row-versus-ungated-standard-cell-leakage.md
[DR-0020]: ../spec/decision-records/DR-0020-fifo-depth-set-to-two-against-power-area-and-streaming.md
[DR-0023]: ../spec/decision-records/DR-0023-power-rollup-digital-term-becomes-measured-gate-level-power.md
