2AMLogic/gf180-trng/sim/characterization-array-supply-ripple.md

# Deterministic supply-ripple susceptibility of the buffered RO array

Issue [#414](https://github.com/2AMLogic/gf180-trng/issues/414). Status:
**partial.** Four of the six requests have run on the batch fleet and are
recorded (both beat-frequency requests and both convergence re-runs); the two
2 MHz requests (`nominal-lowf`, `binding-lowf`) did not complete, so no 2 MHz
sensitivity exists yet. See "Results" and "Run status".

This is characterization of one named coupling path, not a verdict. It changes
no spec target, no decision record and no signoff verdict, and it makes no
claim about min-entropy, supply-filter sizing or a supply-network impedance
target.

## The gap it addresses

[`characterization-array-ring-coupling.md`](characterization-array-ring-coupling.md)
(Caveats, "Ideal supply") states that every coupling deck connects both ring
supplies through zero-volt ammeters to one *ideal* source, which has no
impedance for one ring's current to develop a voltage across; supply-network
coupling is a second path those decks cannot see. The array deck
`sim/tb/ro-array-core-pvt-q/` has the same structure, and
`layout/floorplan/README.md` records that supply filtering is unsized because no
supply-network impedance target exists. So the isolation argument has no
quantified answer to a *deterministic* supply disturbance at the ring pins.

## What the campaign tests

An ideal series sinusoid on a ring supply pin of the shipped buffered array
(`design/ro_array_core.spice`, blob `fd0aa75500320b36f980126377e3d07c71c0e6b1`),
read out as the edge-time displacement of each ring and of the rings' relative
phase at the injected frequency. Declared before any run (`sim/tb/ro-array-supply-ripple/README.md`,
`python3 sim/tools/supply_ripple.py plan`):

- corners: `tt`/27 C/3.30 V and the entropy-binding `ss`/125 C/3.63 V;
- placement: ring 1 only, and both rings in phase;
- amplitude: 0 (control), 10, 50, 150 mV peak;
- frequency: 2 MHz, and the corner's observed ring-frequency difference
  (10.50 MHz nominal, 7.65 MHz binding);
- numerical checks: the binding-corner beat point re-run at 5 ps and 2.5 ps
  against the 10 ps main grid, and a one-cycle-shorter fit window on every unit;
- 32 simulation units in 6 `klt sim` requests, about 1.1 CPU-hours (a planning
  estimate from one local probe), nothing run by CI or `sim/selftest.sh`.

Because the binding corner already sits at the top of the 2.97-3.63 V envelope,
any positive excursion there leaves it; each perturbed rail is labelled `in` or
`OUT` of the envelope from its measured minimum and maximum rather than assumed.

## Results

Each row is a record under `sim/records/` (raw `report.json`, `request.json` and
`stderr.txt` beside it); the tables are the output of
`python3 sim/tools/supply_ripple.py analyze` and are reproduced in the records.
`x` is the displacement amplitude of the ring's edge times at the injected
frequency; `ffm` is the fractional-frequency modulation per millivolt of
injected ripple. The amplitude-0 row is the control: its tone is the fit and
quantization floor. The simulation is deterministic (no noise, no mismatch, no
seeds). Schematic-level deterministic susceptibility of
`design/ro_array_core.spice` (blob `fd0aa75500320b36f980126377e3d07c71c0e6b1`)
to an ideal series sinusoid on the ring supply pins; PDK `gf180mcuD`,
open_pdks `c6d73a35f524070e85faff4a6a9eef49553ebc2b`, ngspice-46.

Nominal, `tt`/27 C/3.30 V, 10.5 MHz, 10 ps step, 0.7 us
(`2026-10-15-ro-array-supply-ripple-nominal-beat-01`):

| placement | amp (mV) | rails | ring1 x (ps) | ring2 x (ps) | beat-phase x (ps) | ring1 ffm (ppm/mV) |
|---|---|---|---|---|---|---|
| control | 0 | - | 2.19 | 1.13 | 2.92 | n/a |
| ring1 | 10 | in | 48.8 | 1.13 | 49.3 | 322 |
| ring1 | 50 | in | 251 | 1.19 | 252 | 331 |
| ring1 | 150 | in | 756 | 1.16 | 756 | 332 |
| both | 10 | in | 48.9 | 49.4 | 4.26 | 323 |
| both | 50 | in | 251 | 248 | 12 | 331 |
| both | 150 | in | 756 | 747 | 32.7 | 332 |

Entropy-binding, `ss`/125 C/3.63 V, 7.65 MHz, 10 ps step, 0.7 us
(`2026-10-15-ro-array-supply-ripple-binding-beat-01`). The nominal rail already
sits at the top of the envelope, so every perturbed rail leaves it (`OUT`); these
are out-of-envelope excursions, reported as such, not in-envelope claims:

| placement | amp (mV) | rails | ring1 x (ps) | ring2 x (ps) | beat-phase x (ps) | ring1 ffm (ppm/mV) |
|---|---|---|---|---|---|---|
| control | 0 | - | 2.55 | 1.95 | 3.94 | n/a |
| ring1 | 10 | OUT | 64.2 | 1.97 | 64.8 | 309 |
| ring1 | 50 | OUT | 328 | 2.05 | 329 | 315 |
| ring1 | 150 | OUT | 988 | 1.87 | 988 | 317 |
| both | 10 | OUT | 63.9 | 64.5 | 6.01 | 307 |
| both | 50 | OUT | 328 | 325 | 16.8 | 315 |
| both | 150 | OUT | 987 | 976 | 45.6 | 316 |

Observations (synthetic aggressor only):

- The control tone (about 1-4 ps) is two orders of magnitude below the 10 mV
  response (about 49-65 ps), i.e. negligible by comparison, but it is not zero:
  it is a floor of the extraction, and the 10 mV rows are the smallest response
  clearly above it.
- The response is close to linear in amplitude from 10 to 150 mV (ffm 307-332
  ppm/mV across both corners; the 10 mV rows sit 2-3 percent below the 50 and
  150 mV rows at each corner), and the per-millivolt sensitivity is slightly
  lower at the binding corner (about 315 ppm/mV) than at nominal (about 331).
- A ring that does not carry the ripple does not respond (ring 2 stays at the
  control floor when only ring 1 is perturbed), so in this model the ripple does
  not couple between rings except through the injected pins.
- With both rails driven in phase the two rings move together and the relative
  (beat-phase) displacement is about 4-5 percent of a single-ring displacement
  at 50 and 150 mV (about 9 percent at 10 mV, nearer the extraction floor).
  In-phase ripple is therefore largely common-mode to the ring difference; this
  says nothing about unequal-phase or unequal-amplitude ripple (untested).

Numerical sensitivity, binding corner, 7.65 MHz, `both` 50 mV and the control,
re-run at finer steps (`...-conv-binding-beat-5p-01`, `...-conv-binding-beat-2p5-01`):

| step | control ring1 x (ps) | control ring2 x (ps) | both 50 mV ring1 x (ps) | ring2 x (ps) | beat-phase x (ps) | ffm (ppm/mV) |
|---|---|---|---|---|---|---|
| 10 ps | 2.55 | 1.95 | 328 | 325 | 16.8 | 315 |
| 5 ps | 2.58 | 1.98 | 328 | 325 | 16.8 | 315 |
| 2.5 ps | 2.57 | 1.99 | 328 | 325 | 16.8 | 315 |

The three-digit values do not change between 10 ps and 2.5 ps, so the step is
not what limits these numbers. The control floor moves by about 0.03 ps.

Not obtained: the 2 MHz (low-frequency) points at either corner. A one-cycle-shorter
fit-window check was not tabulated separately.

## Run status

The two `klt sim --backend batch` submits made from this issue's worktree did
not run:

1. the first stopped with `batch_no_capacity` (no Spot capacity in any pool);
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
