2AMLogic/gf180-trng/sim/characterization-starved-cell-jitter-energy.md

# Jitter-energy law on the shipped starved delay cell

Status: measurement complete for issue [#46]. Validates — on the cell this
project actually ships — the empirical invariant that
[`DR-0010`](../spec/decision-records/DR-0010-raw-rate-moves-to-the-measured-jitter-energy-limit.md)
calls `(★)` and names as its own largest open risk.

**This document is an ordinary summary, not evidence.** Every number below
cites the `sim/records/` stem that produced it — treat this document as a
reading guide over that evidence, not a substitute for it. Correcting a number
means re-running the testbench and citing the new record, per
[`sim/README.md`](README.md).

**No entropy-rate or spec-compliance claim is made anywhere in this document.**
Everything here is a simulated circuit figure — period, accumulated jitter,
supply power — and an arithmetic combination of them. DR-0004's tiering is
unchanged; measuring `H` is [#12]'s job.
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
