2AMLogic/gf180-trng/WORK_LOG.md

# Work Log

Merged PRs and closed issues recorded from recent 30-day query windows, through 2026-11-13.
Earlier history remains available in GitHub. Entries record repository activity,
not independent verification of the claims in issue or PR titles.

## Archives

- [2026-09](work_log/WORK_LOG_2026-09.md)

### 2026-11-13

- **PR #870**: layout: regenerate 45 reports under the pinned KLayout engine and guard the recorded engine
- **PR #864**: docs(floorplan): drop the hand-maintained net count above the inter-region table
- **PR #862**: docs(floorplan): retire the pre-#224 framing from the vddd and vss net rows
- **PR #860**: refactor(floorplan): split build() into per-stage functions
- **PR #857**: refactor(floorplan): drop the vsubs filter, its vacuous test and its prose
- **PR #856**: refactor(sim): read a record's seeds: from its frontmatter, drop field() and NUMBER_PATTERN
- **Issue #858** (closed): Committed layout and floorplan reports record KLayout 0.30.13, not the pinned 0.30.10: regenerate under the pin and guard the recorded engine
- **Issue #863** (closed): layout/floorplan/README.md calls the inter-region net table sixteen nets; the declaration has fifteen
- **Issue #859** (closed): layout/floorplan/README.md: the vddd row of the net table still describes the pre-#224 SPECIALNETS-only state
- **Issue #854** (closed): Split floorplan.py's 493-line build() into per-stage functions along its own numbered banners
- **Issue #852** (closed): Remove vsubs/guard_ring_tap leftovers: a vacuous test and an always-true filter in the inter-region router
- **Issue #853** (closed): Remove the one-caller field() helper and the unused NUMBER_PATTERN from sim/tools/_record_parsing.py
- **PR #851**: refactor(pex): move the full-chip delta path into layout/pex/fullchip.py
- **PR #849**: chore: drop package.json worktree:return script entry pointing at a deleted file
- **Issue #848** (closed): Split layout/pex/build.py: move the full-chip delta path into a sibling module
- **Issue #846** (closed): Remove broken worktree:return npm script: its target script no longer exists
- **PR #844**: refactor: delete seven unread module-level constants, three with comments describing absent behaviour
- **PR #845**: refactor(sim): build the power tools' klt requests from one shared skeleton
- **PR #843**: sim: hold the study's sizing constant to the shared derivation, not a private copy
- **PR #842**: sim: render the power record front matter from one shared skeleton
- **PR #838**: refactor(sim): move the power tools' argparse front end into _power_cli
- **PR #836**: sim: publish combiner/sampler 27-corner schematic-vs-extracted evidence
- **Issue #366** (closed): Guard telemetry: process substitution misclassified as worktree write
- **Issue #839** (closed): Remove 7 unused module-level constants (dead bindings, two with misleading comments)
- **Issue #840** (closed): Share the power tools' request-builder slice through _power_cli
- **Issue #841** (closed): Simplify higher_rate_options.py: drop its private copy of the sizing-constant check and the stale 'array_sizing still carries 1.79' claim
- **Issue #834** (closed): Consolidate duplicated record renderers in power tools into _power_cli
- **Issue #837** (closed): Consolidate duplicated power-tool main() and cmd_* wrappers into _power_cli
- **Issue #418** (closed): Verify assembled combiner/sampler reset and capture with native post-layout comparison
- **PR #833**: sim: measure starved-ring jitter at 3.30 V and 2.97 V ring supply
- **Issue #831** (closed): Measure starved-ring jitter at reduced ring supply (3.30 V, 2.97 V) against a = 10.932
- **Issue #816** (closed): Operator decision: reduced ring supply against the Operating envelope row

### 2026-11-12

- **PR #829**: Bump Repo Skills 0.25.10 -> 0.26.1

### 2026-11-10

- **Issue #705** (closed): Bump klayout-tools pin 0.6.0 → 0.8.0
- **PR #826**: layout: tap every cell, track klayout-tools 0.9.0, and re-derive the vsubs-free PEX and item 7 citation
- **Issue #823** (closed): Remove 8 unused imports left by the _power_cli refactor (ruff F401)
- **PR #824**: refactor: remove unused imports from power retention/switch tools

### 2026-11-09

- **PR #785**: docs: record Power and Area gap accounting after the power-gating and floorplan work
- **PR #772**: docs(sim): record measured ring2 paired PEX grid under klt 0.9.0, unpublished pending pin decision
- **Issue #808** (closed): Re-run extracted full-chip PEX simulations and the digital STA interface-load sweep on the stacked floorplan
- **PR #819**: pex+sim: refresh full-chip parasitics and post-layout evidence on the stacked floorplan
- **Issue #811** (closed): Power: separate ring-buffer power from XOR-combiner power in the array record
- **PR #818**: sim: split the array's buffer and XOR power with a split-rail probe
- **Issue #821** (closed): Dedupe liveness_sampler_power's adapter layer onto sim/tools/_power_cli.py
- **PR #822**: refactor(sim): route liveness_sampler_power and siblings through _power_cli
- **Issue #812** (closed): Power: replace the uniform-activity digital power model with toggle-based (VCD) activity for the active-power breakdown
- **PR #820**: feat(power): per-sub-block VCD-activity power at 1 MHz and 2 kHz
- **Issue #813** (closed): Power: quantify the entropy-rate cost of a reduced ring supply against the active power it returns
- **PR #817**: docs: quantify ring-supply power returned against modelled entropy cost
- **Issue #805** (closed): Consolidate copy-pasted CLI/record scaffolding across the power_switch, power_switch_decay and power_retention tools
- **PR #815**: refactor(sim): share power-switch tools' adapter layer in _power_cli
- **Issue #809** (closed): Power: rank active-power levers and scope follow-ups (no spec change)
- **PR #814**: docs: rank active-power levers and scope follow-ups
- **Issue #803** (closed): Floorplan: redesign the digital PDN tie so a stacked arrangement can land (reclaims ~39% of the composed bbox)
- **PR #807**: feat(floorplan): stack digital above the analog strip with a wide multi-cut PDN tie
- **Issue #793** (closed): Area recovery: ranked follow-up proposals from the area accounting
- **Issue #798** (closed): Digital P&R: evaluate higher placement density and smaller die-to-core margin
- **PR #806**: docs: record dense-placement and die-margin P&R evidence, composed LVS cause
- **Issue #797** (closed): Floorplan arrangement: reclaim the empty area beside the analog row (up to 211 884 um^2)
- **PR #804**: docs: record stacked-floorplan trial measurements and blockers
- **Issue #790** (closed): Power: design retention for the gated domain so idle is measured, and break active power down by sub-block
- **PR #796**: sim: measure gated-domain idle with the retained set held across 45 PVT points
- **Issue #799** (closed): Digital cell area: quantify candidate RTL reductions toward the 50 000 um^2 budget
- **PR #802**: docs: rank digital cell-area reduction candidates against the area gap
- **Issue #800** (closed): Sampler geometry: isolate why each sampler flip-flop occupies 573 um^2 of bbox
- **PR #801**: docs: record cause of the 573 um^2 sampler flip-flop box (negative finding)
- **Issue #789** (closed): Area: measure each sub-block against a lower bound with klt economy and name the overruns
- **PR #795**: docs: area economy accounting record for the committed layout
- **Issue #656** (closed): T1 item 6: produce a klt yield report over the existing mismatch Monte Carlo campaign
- **PR #791**: feat(signoff): ratify mismatch MC limits and cite klt yield as item 6 analog
- **PR #794**: sim: break whole-block active power down by sub-block at the binding corner

### 2026-11-07

- **PR #787**: Bump Repo Skills 0.25.1 -> 0.25.10

### 2026-11-06

- **PR #783**: sim: measure gated-rail decay after the power switch opens
- **Issue #782** (closed): Power switch: measure gated-rail decay time and replace the t_rail_decay placeholder
- **PR #776**: docs: replace rail-settle placeholder in power intent with evidenced figure
- **Issue #708** (closed): Power gating: define and verify the power-intent flow for a gated digital domain
- **PR #780**: refactor: derive request-generator process sections from the CORNERS registry
- **Issue #778** (closed): Remove duplicated PROCESS_SECTIONS tables in sim/tools request generators

### 2026-11-05

- **PR #775**: refactor: share one SPICE continuation joiner and .SUBCKT pin reader
- **Issue #774** (closed): Consolidate duplicated SPICE continuation-join and .SUBCKT pin-list readers
- **PR #771**: docs(signoff): record working klt yield install route and the missing limit blocking item 6
- **Issue #707** (closed): Power gating: design a custom power-switch cell for the digital section

### 2026-11-04

- **Issue #734** (closed): Refresh extracted/routed ro-array startup records on the 30 um tapcell geometry
- **PR #737**: docs: record measured DR-0029 follow-up for the extracted ro-array startup family
- **PR #732**: evidence: refresh digital STA, activity and post-route records on the 30 um tapcell geometry
- **Issue #710** (closed): Area: rework floorplan utilisation and isolation channels toward < 0.05 mm^2
- **PR #768**: docs(floorplan): re-run the utilisation sweep on the post-709 inventory
- **Issue #730** (closed): Reconcile README/spec-row-status whole-block active figure (758.2 uW) with re-measured 749.4 uW
- **PR #765**: docs: quote post-#729 active power figure and regenerate signoff citations
- **PR #729**: feat(interface): drop raw_shift reset and size raw_bit_count from RAW_PACK_BITS, with measured digital chain
- **Issue #709** (closed): Area and power: FIFO and cell-inventory reductions toward the ratified bounds

### 2026-11-03

- **PR #763**: refactor: share record provenance derivation via harness.report
- **Issue #762** (closed): Consolidate duplicated record-provenance code in sim/tools into sim/harness/report.py

### 2026-11-02

- **Issue #654** (closed): T1 item 5.analog: klayout-tools#2533 is fixed; emit the ratified analog rows as klt sim envelopes

### 2026-11-01

- **Issue #414** (closed): Characterize deterministic supply-ripple sensitivity of the buffered RO array
- **PR #755**: Bump Repo Skills 0.24.7 -> 0.25.1

### 2026-10-30

- **PR #753**: refactor(sim): share pex DUT generator helpers and honour KLT in ring11
- **Issue #751** (closed): Consolidate helpers duplicated between the two pex build_dut.py generators
- **PR #749**: fix(harness): stream sha256_file in 1 MiB chunks
- **Issue #748** (closed): sim.harness.report.sha256_file reads whole file into memory; callers hash large artifacts
- **PR #747**: refactor: use the shared sha256_file in place of local digest helpers
- **Issue #744** (closed): Consolidate ~11 duplicated file-sha256 helpers onto the existing shared one
- **PR #746**: refactor(layout): share the ro_stage generator between ring1 and ring2
- **Issue #733** (closed): Share ro_stage build_shapes between ring1 and ring2 (as ro_nand2 already does)
- **PR #742**: sim: supersede the eight extracted-fullchip records after the PEX netlist refresh
- **Issue #739** (closed): Follow-on from PR #738: re-run extracted-fullchip PVT sims with refreshed cload values
- **PR #743**: fix: exempt pdk-models.json and declared netlist dependencies from the stored-bytes check
- **Issue #741** (closed): check:artifact-manifests rejects stored dependency snapshots and pdk-models.json that equal committed files
- **PR #738**: pex: resolve full-chip nets via DEF net name; refresh PEX evidence
- **Issue #736** (closed): pex: --fullchip-extract fails on main (inter-region label merge) and --check cache is stale
- **PR #728**: refactor: share cmd_run/cmd_record scaffold between power tools
- **PR #712**: sim: add power-intent spec and gate-level isolation/sequencing check for a gated digital section
- **Issue #727** (closed): ci: all jobs fail within 2s with no steps on a docs-only PR (runner startup failure?)
- **Issue #726** (closed): Dedupe cmd_run/cmd_record/_sanitize between power_switch.py and liveness_sampler_power.py

### 2026-10-29

- **PR #716**: evidence: price digital inventory levers against idle and area rows
- **PR #722**: refactor: share one git ls-files wrapper across sim/tools scripts
- **Issue #721** (closed): Consolidate duplicated git ls-files and file-SHA-256 helpers in sim/tools

### 2026-10-28

- **PR #714**: docs: record floorplan utilisation sweep toward the Area row
- **PR #713**: feat: add a 400 um PMOS header cell for the digital supply, with 45-point sizing evidence

### 2026-10-27

- **PR #703**: signoff: cite klt sta and functional envelopes for T1 item 5 digital
- **Issue #699** (closed): T1 item 5 (corner verification, digital): klt functional-verification envelope now, and the 15-point STA sweep as klt sta once klayout-tools#2858/#2739 close

### 2026-10-24

- **PR #696**: sim: record stored-evidence smoke-op run with verified artifact manifests
- **PR #694**: fix: exempt harness input snapshots from the committed-bytes manifest check
- **PR #692**: test: exempt generated WORK_LOG/WORK_PLAN from the DR citation gate
- **PR #688**: feat(sim): store raw output of new recorded runs in the artifact store
- **PR #471**: Disambiguate colliding DR-0011/DR-0012 citations and guard them
- **Issue #689** (closed): Confirm first full stored run_corners.py run: klt artifact verify exits 0 on a fleet worker
- **Issue #693** (closed): check:artifact-manifests fails on any recorded run: stored spinit equals committed harness files
- **Issue #691** (closed): Generated WORK_LOG/WORK_PLAN can reintroduce bare colliding DR citations from issue titles
- **Issue #686** (closed): Adopt the common artifact store for sim evidence (manifests in git, bytes via klt artifact)
- **Issue #468** (closed): Disambiguate the colliding DR-0011/DR-0012 citations (README links the wrong DR-0012) and guard them

### 2026-10-22

- **PR #684**: fix(signoff): re-pin item 9/10 inventories after README and ci.yml edits
- **Issue #683** (closed): main CI red after #433: signoff freshness and citation inventories 9/10 stale
- **PR #433**: Give the strict record-checksum CI step an npm check entry and parity coverage
- **Issue #432** (closed): Give the strict record-checksum CI step an npm check entry and parity coverage

### 2026-10-21

- **PR #679**: chore(digital): trim per-gate antenna tables from the committed ERC report
- **Issue #677** (closed): Trim 10 MB of per-gate tables from the committed digital ERC report
- **PR #675**: Bump Repo Skills 0.24.3 -> 0.24.7

### 2026-10-20

- **Issue #663** (closed): Remove run_array_liveness_tap_phase.py: finished one-experiment launcher (~600 LOC)
- **PR #672**: docs(sim): assess retiring the array tap-phase launcher; keep it pending replacement

### 2026-10-17

- **PR #667**: refactor(signoff): share the klt pex publish pipeline across publishers
- **PR #666**: refactor(sim): share behavioral record frontmatter across six runners
- **PR #646**: ci(nightly): pin yowasp-yosys to 0.69.0.0.post1233
- **Issue #665** (closed): Deduplicate signoff publish scripts: combiner_sampler and ring2 share one pipeline
- **Issue #660** (closed): Consolidate duplicated behavioral-record frontmatter across six sim/tb runners
- **Issue #630** (closed): PDK nightly red: Yosys 0.70 (yowasp-yosys, unpinned) makes trng_top.synth.{v,json} STALE
- **PR #664**: lvs: compare digital layout to trng_top.pnr.v as gate-level Verilog
- **PR #661**: signoff: cite hashed inventories for T1 items 1, 2, 9 and 10 on both partitions
- **PR #659**: docs(signoff): enumerate analog spec rows against klt 0.7.0 expr, declare no citable row
- **PR #658**: signoff: cite item 11 as a compound evidence set so both partitions grade
- **PR #657**: docs(signoff): record that no reproducible klt yield install route exists for item 6
- **Issue #662** (closed): T1 item 11 digital: compute LVS power_connectivity from a gate-level Verilog reference
- **Issue #655** (closed): T1 item 11: cite the ERC, LVS and P&R evidence as one compound set so the row grades for real instead of wrong_kind
- **Issue #653** (closed): T1 items 1, 2, 9 and 10: cite artifact-anchored evidence in both partitions

### 2026-10-16

- **PR #651**: Bump Repo Skills 0.24.1 -> 0.24.3

### 2026-10-15

- **PR #648**: refactor(layout): share ring NAND2 and ring assembly generators across ring1/ring2
- **Issue #346** (closed): Collapse duplicated ring1/ring2 layout generators (ro_nand2, ro_ring11) onto shared code
- **PR #647**: sim: report binding-corner jitter constant beside the stated sizing constant
- **Issue #628** (closed): Measure starved-cell jitter energy at the entropy-binding corner ss/+125C/3.63V (sizing currently applies the -40C value)
- **PR #641**: sim: run 2 MHz supply-ripple points as split fleet requests and record results
- **PR #640**: design: default digital_power_estimate to the ratified 2000 bps raw rate
- **Issue #639** (closed): Follow-on from PR #638: digital_power_estimate.py still cites DR-0010 as proposed and defaults to 1 Mbps
- **PR #638**: sim: carry ratified 2 kbps rate through rollup tools and docs; mark older rates historical
- **PR #637**: sim: supply-ripple susceptibility results, beat + convergence (part of #414)
- **Issue #585** (closed): Carry the 2 kbps Raw rate into the tools and documents #491 left at 1 Mbps / 500 bps
- **PR #586**: feat(spec): move the Raw rate row to 2 kbps and size the array at a = 7.32
- **Issue #491** (closed): Apply the mechanical edit set directed by ratified DR-0010 and DR-0011-rate (Raw rate row, sizing constant, derived figures)
- **PR #634**: Bump Repo Skills 0.19.5 -> 0.24.1

### 2026-10-13

- **PR #633**: sim: starved-cell jitter-energy at ss/+125C/3.63V on the batch fleet (Part A of #628)
- **PR #631**: Design study: price higher raw-rate entropy-source options from existing evidence (#629)
- **Issue #629** (closed): Design study: a higher-rate entropy source (multi-RO / metastability hybrid tap) if Mbps-class rates are needed

### 2026-10-11

- **PR #625**: test: skip changed-record end-to-end case when origin/main is not fetched
- **PR #624**: test: pin RCT/APT cutoff boundaries in RTL equivalence tests
- **PR #622**: test: require simulator-gated unit tests in the nightly
- **Issue #621** (closed): test_report end-to-end case errors when origin/main is not fetched (nightly dispatched on a branch)
- **Issue #620** (closed): RTL equivalence tests for rct_apt.v do not pin the APT cutoff boundary (>= vs > survives)
- **Issue #618** (closed): Make tool-gated RTL/ngspice tests runnable-and-required in at least one CI environment (iverilog tests skip everywhere in CI today)
- **Issue #614** (closed): Add unit tests for the shared layout generator check/main factories in layout/cells/_build_cli.py
- **PR #619**: test: cover signoff publishers (refusals, --backend argv, publication fields)
- **Issue #611** (closed): Add unit tests for the signoff publication scripts (publish_item7_analog, publish_combiner_sampler_pex) and dedupe their shared run_pex
- **PR #616**: Reserve klt output destinations before submission (#610)
- **PR #615**: chore: remove dead clk_at, contract_rows, convergence_text, unused ctrl
- **PR #613**: test: pin the _build_cli.py message contract with direct unit tests
- **PR #612**: Guard tran-noise records against duplicated noise realizations (#605)
- **PR #609**: fix: isolate each hostile-init sanity launch to the startup source it names
- **PR #608**: Share one klt-request emit/run scaffold across the sim evidence tools
- **PR #606**: Record that trnoise waveforms are not seed-reproducible on ngspice-46 (#574)
- **PR #604**: Add shellcheck lint:shell step (#591)
- **PR #600**: Replace hand-copied path-based module loaders with one helper (#553)
- **Issue #610** (closed): Reserve klt simulation output destinations before submission to preserve prior responses
- **Issue #605** (closed): Guard tran-noise records against duplicated noise realizations when runs share a process id
- **Issue #603** (closed): Remove dead functions clk_at, contract_rows, convergence_text (and dead local ctrl)
- **Issue #601** (closed): Add direct unit tests for layout/cells/_build_cli.py message contract
- **Issue #591** (closed): Run shellcheck over tracked shell scripts in lint and CI (bash -n is the only check today)
- **Issue #590** (closed): Share one klt-request emit/run scaffold across the sim tools and enforce the no-full-grid-local rule once
- **Issue #584** (closed): test_hostile_init_fixtures_affect_plain_batch_but_not_the_policy fails on hosts with ngspice-46
- **Issue #574** (closed): ngspice-46 transient-noise (trnoise) draws are not reproduced by the recorded seed
- **Issue #553** (closed): Replace 24 hand-copied path-based module loaders with one helper

- **PR #599**: refactor: dedupe the layout generators' gds_path/check/main tail into _build_cli
- **PR #598**: docs: record the second-pass LU.3/LU.4 source re-check in DR-0030
- **PR #597**: spec: DR-0020 status note, FIFO_DEPTH = 2 holds at the 2 kbps raw rate
- **PR #596**: Reject tracked raw simulation artifacts with no evidence record
- **PR #595**: Migrate sim/tests loaders to load_module_from_path (#553, batch 2)
- **Issue #593** (closed): Reject tracked raw simulation artifacts with no evidence record
- **Issue #589** (closed): Dedup the gds_path/check/main boilerplate repeated in every layout generator
- **Issue #583** (closed): DR-0020 revisit trigger fired: re-examine output FIFO_DEPTH at the 2 kbps raw rate
- **PR #592**: Redact absolute parameterized PDK paths from model manifest diagnostics
- **PR #588**: Freeze ngspice startup-script bytes before sweeps and preserve them in raw evidence
- **PR #587**: Add load_module_from_path helper and migrate production loaders (batch 1 of #553)
- **PR #580**: docs: correct what the Area row's 351.6 % figure is (#495)
- **PR #579**: Control ambient ngspice start-up configuration in harness runs
- **PR #578**: Reject DUT includes that collide with generated simulation artifacts
- **PR #577**: Record the outcome of the LU.3/LU.4 controlled-DRM source search (#486)
- **PR #576**: Add a relative markdown link guard to npm run lint (and fix existing broken links)
- **PR #573**: Enforce harness ownership of stochastic simulation seed controls
- **PR #572**: Reject nonpositive simulation timeout bounds before launching ngspice
- **PR #567**: Deduplicate git blob SHA-1 helper onto sim/harness/report.py (#557)
- **Issue #582** (closed): Freeze ngspice startup-script bytes before sweeps and preserve them in raw evidence
- **Issue #575** (closed): Control ambient ngspice startup configuration in evidence-producing harness runs
- **Issue #570** (closed): Add a relative markdown link guard to npm run lint (and fix existing broken links)
- **Issue #569** (closed): Redact absolute parameterized PDK paths from model manifest diagnostics
- **Issue #566** (closed): Enforce harness ownership of stochastic simulation seed controls
- **Issue #565** (closed): Reject DUT include filenames that collide with generated simulation artifacts
- **Issue #563** (closed): Reject nonpositive simulation timeout bounds before launching ngspice
- **Issue #557** (closed): Deduplicate git blob SHA-1 helper: 4 copies across sim/harness and sim/tools
- **Issue #495** (closed): Area row status text predates the composed layout
- **PR #568**: Record PDK model-content identity in new simulation evidence
- **PR #564**: Bound the default concurrency of sim/characterize.py
- **PR #560**: ci: pin GitHub Actions to verified commit SHAs and guard against mutable refs
- **PR #559**: Publish SPICE evidence records with exclusive creation
- **PR #555**: Centralise the superseded-record filter and latest-record selection (#554)
- **Issue #562** (closed): Record PDK model-content fingerprints in new simulation evidence
- **Issue #561** (closed): Auditor Capability Request: Python interpreter unavailable for repository checks
- **Issue #558** (closed): Bound the default concurrency of sim/characterize.py instead of using every core
- **Issue #554** (closed): Centralise the superseded-record filter and latest-record selection in one shared reader
- **Issue #544** (closed): Pin GitHub Actions to commit SHAs and guard against mutable refs
- **Issue #539** (closed): Use exclusive publication for SPICE evidence Markdown
- **PR #552**: Scope whole-record measurement readers to the primary Result section
- **PR #551**: Validate multi-seed summary bullets in the shared record parser
- **PR #550**: Freeze SPICE inputs per invocation and hash the captured bytes
- **PR #549**: Pin the OpenROAD image that produced the committed artefacts (#507)
- **PR #545**: Validate raw-artifact path containment before verifying evidence
- **PR #543**: Require final-tree CI-gate validation in verification guidance
- **PR #535**: Validate numeric exponent tokens and finiteness in evidence bullets (#529)
- **Issue #548** (closed): Scope whole-record measurement readers to primary Result sections
- **Issue #547** (closed): Validate finite means, spreads, and seed counts in multi-seed evidence summaries
- **Issue #515** (closed): Freeze SPICE source inputs for consistent multi-corner evidence
- **Issue #507** (closed): Build/runtime failure on main: nightly SDF freshness fails on engine_version
- **Issue #541** (closed): Validate raw-artifact path containment before verifying evidence
- **Issue #508** (closed): Builder validation omits repository CI gates before review
- **Issue #529** (closed): Validate numeric exponent tokens and finiteness when reading evidence Markdown

### 2026-10-10

- **PR #540**: Consolidate duplicated result-bullet regexes onto the shared record parser
- **PR #538**: Reject empty and non-finite PVT execution plans before simulation
- **PR #536**: Reject unknown testbench analysis types at manifest load
- **PR #533**: Include liveness and digital evidence in the Row D reproduction mapping
- **PR #531**: Guard against unused imports and locals in npm run lint (#494)
- **PR #530**: sim: reject non-finite ngspice measurements before declaring a run ok
- **PR #525**: Remove tracked stale .loom/manifest.json.tmp
- **PR #523**: ci: run nightly no-evidence-write assertion after earlier failures
- **PR #521**: ci: bound ci.yml jobs with timeout-minutes (#519)
- **PR #518**: Replace README status changelog with a short summary (#502)
- **PR #517**: sim: reserve behavioral record stems before rendering raw artifacts
- **Issue #537** (closed): Consolidate duplicated result-bullet regexes onto the shared record parser
- **Issue #532** (closed): Reject empty and non-finite PVT execution plans before simulation
- **Issue #534** (closed): Reject unknown testbench analysis types before stochastic seed planning
- **Issue #528** (closed): Include required liveness power evidence in the Row D reproduction mapping
- **Issue #494** (closed): Guard against unused imports and locals in npm run lint (recurring ruff F401/F841 cleanups)
- **Issue #527** (closed): Reject overflowed non-finite ngspice measurements before declaring success
- **Issue #524** (closed): Remove tracked .loom/manifest.json.tmp: stale install artifact matched by .gitignore
- **Issue #526** (closed): Auditor Capability Request: Python 3 unavailable for local harness validation
- **Issue #522** (closed): Run the nightly no-evidence-write assertion after verification failures
- **Issue #519** (closed): Bound CI job runtime with timeout-minutes in ci.yml
- **Issue #502** (closed): Replace the README status changelog paragraph with a short summary and relocate the history
- **Issue #514** (closed): Reserve behavioral evidence stems before rendering raw artifacts

### 2026-10-10

- **PR #513**: sim: reject duplicate seeds and colliding PVT plans before allocation
- **PR #512**: sim: snapshot the loaded testbench manifest with each run record
- **PR #509**: sim: separate failed-run diagnostics from report summaries
- **PR #505**: sim: record blocked ring2 paired PEX batch attempt (Part of #476)
- **PR #504**: docs(signoff): combiner/sampler PVT grid attempt 5, still unrun (part of #418)
- **PR #503**: test(sim): guard that every --check sim tool is wired or allowlisted
- **PR #501**: Isolate per-invocation scratch directories for --no-write sweeps
- **PR #500**: Fail unsuccessful ngspice executions even when all measurements are printed
- **PR #497**: docs: move the spec-row change history out of the README table
- **PR #496**: docs(signoff): combiner/sampler PEX grid attempt 4, all rows errored (partial #418)
- **PR #493**: docs: refresh Chipalooza Row I area from regenerated floorplan report
- **PR #492**: spec: ratify DR-0010, DR-0011-rate, DR-0015, DR-0016 and DR-0018 via the two-key mechanism
- **PR #490**: sim: quantify DC drop through the digital supply docking path and PDN (#464)
- **PR #489**: sim: reconcile shipped liveness samplers with the whole-block active-power ledger (#463)
- **PR #488**: docs: DR-0029 disposition of the LU.3/LU.4 tie-distance column (#449)
- **PR #483**: sim: stop git gc/maintenance racing tempdir cleanup in evidence-history tests (#479)
- **Issue #511** (closed): Reject duplicate seeds and colliding PVT execution plans before allocation
- **Issue #510** (closed): Snapshot simulation manifests alongside checksum-protected run evidence
- **Issue #506** (closed): Separate failed-run diagnostic measurements from simulation evidence statistics
- **Issue #499** (closed): Isolate scratch directories for concurrent no-write simulation sweeps
- **Issue #498** (closed): Fail unsuccessful ngspice executions even when all measurements are printed
- **Issue #484** (closed): Refresh Chipalooza area evidence after floorplan regeneration and derive its guard from the report
- **Issue #481** (closed): Move the README spec-row change history out of the Target specification table
- **Issue #480** (closed): Carry the remaining Proposed decision records (DR-0010/0011/0015/0016/0017/0018) through ratification
- **Issue #479** (closed): Build/runtime failure on main: flaky tempdir cleanup in test_verify_evidence_history (Errno 39)
- **Issue #474** (closed): Guard that every sim tool with a --check mode is wired into check:spec or explicitly allowlisted
- **Issue #464** (closed): Quantify DC voltage loss through the digital supply docking path and parallel PDN
- **Issue #463** (closed): Reconcile shipped liveness samplers with the whole-block active-power ledger

### 2026-10-10

- **PR #482**: sim: remove unused imports and an unused local (#478)
- **PR #477**: docs: out-of-envelope health-test characterization model-bound audit and plan (#467)
- **PR #475**: sim: fs/sf campaign second batch retry, refused again (#472)
- **PR #473**: sim: integrated fs/sf capture campaign on the ring-array + XOR + sampler path (#472)
- **PR #470**: docs(signoff): combiner/sampler PEX grid attempt 3, batch capacity refused (#418)
- **Issue #478** (closed): Remove dead code: 3 unused imports, 1 unused local (ruff F401/F841)
- **Issue #467** (closed): Establish model bounds and a feasible plan for out-of-envelope health-test characterization

### 2026-10-10

- **PR #466**: Price the top-edge digital pin legs in the STA interface load and re-run the sweep (#456)
- **PR #465**: Skip superseded records in the remaining direct-glob record readers
- **Issue #456** (closed): Price the top-edge digital pin legs in the STA interface load and re-run the sweep against the regenerated trunks
- **Issue #427** (closed): Apply the superseded-record lifecycle filter to the remaining direct-glob record readers in sim/tools
- **PR #461**: Enforce activity capture-source freshness and full campaign coverage (#457)
- **PR #460**: Run tap-distance report regeneration in the mandatory nightly verification job
- **Issue #457** (closed): Enforce activity capture-source freshness and full campaign coverage
- **Issue #458** (closed): Run tap-distance report regeneration in the mandatory nightly verification job

### 2026-10-10

- **PR #455**: Characterize workload-dependent digital power with post-route per-net switching activity
- **PR #454**: Regenerate composed floorplan reports and GDS under klt 0.6.0 (depth-2 digital)
- **PR #452**: Record second batch attempt for combiner/sampler PEX grid (partial, #418)
- **PR #451**: layout: whole-block supply ERC over the composed floorplan stream (#447)
- **PR #450**: Measure digital well/substrate tap distances against GF180MCU DRM 14.3.1
- **PR #445**: Reject ambiguous and body-sourced PVT/lifecycle evidence metadata
- **Issue #453** (closed): Characterize workload-dependent digital power with post-route per-net switching activity
- **Issue #448** (closed): Measure digital well and substrate tap distances against applicable PDK rules
- **Issue #447** (closed): Verify supply isolation and connectivity on the composed routed floorplan
- **Issue #443** (closed): Reject ambiguous and body-sourced PVT/lifecycle evidence metadata
- **Issue #256** (closed): Regenerate the remaining floorplan reports and composed GDS from the depth-2 routed geometry

### 2026-10-10

- **PR #444**: Record batch capacity refusals for combiner/sampler PEX grid (partial #418)
- **PR #442**: Refresh Chipalooza current-evidence table and Row C corner coverage (#436)
- **PR #441**: Restate nested P&R DEF path and add host-path guard for tracked JSON
- **PR #440**: Reject partially unsupported characterization row selections
- **Issue #436** (closed): Refresh Chipalooza current-evidence table and reproduction corner coverage
- **Issue #437** (closed): Reject partially unsupported characterization row selections before running campaigns
- **Issue #404** (closed): Committed generated reports embed absolute host paths (home dir, worktree); add a guard

### 2026-10-09

- **PR #439**: Note supply-ripple batch retry; results still pending (#414)

### 2026-10-09

- **PR #435**: Keep current T1 summaries consistent with the graded verdict
- **PR #431**: Test verify_record_checksums.py's committed-to-git check and main() exit paths
- **PR #429**: Index characterization reports in sim/README.md and guard the index
- **PR #426**: Exclude superseded evidence from current analog rollups
- **PR #424**: Extend native ring pex comparison to ring2 (unrun fixture)
- **PR #422**: sim: opt-in supply-ripple susceptibility campaign for the buffered RO array (#414)
- **Issue #434** (closed): Keep current T1 summaries consistent with the graded verdict
- **Issue #430** (closed): Unit-test verify_record_checksums.py's committed-to-git check and main() exit paths
- **Issue #428** (closed): Index the characterization reports under sim/ and guard the index in corpus_counts --check
- **Issue #425** (closed): Exclude superseded evidence from current analog rollups
- **Issue #423** (closed): Extend native ring PEX comparison to the separately sized ring2

- **PR #420**: feat: combiner/sampler schematic-vs-extracted klt pex fixture (grid not yet run)
- **PR #417**: fix(floorplan): route digital's top-edge pins around the east flank (#315)
- **PR #419**: sim: min-entropy re-run at ss/+125C/3.63V (#406)
- **PR #416**: Run check:evidence-history in check:all; add check:ci/check:all parity test
- **PR #415**: fix(lvs): SPICE continuation past comments; LvsFlowError for unnamed bits (#387)
- **PR #409**: test(sim): unit-test build_dut port map refusal branches offline
- **Issue #315** (closed): Inter-region stubs miss digital's top-edge pins after the re-place-and-route (clk, rst_n, raw_bit, raw_valid, ring_bit unjoined)
- **Issue #406** (closed): Resolve the README's untracked 'still owed' min-entropy re-run at ss/+125C/3.63V
- **Issue #408** (closed): check:all omits the append-only evidence-history guard that check:ci runs
- **Issue #387** (closed): lvs.py: fix two latent gaps (SPICE continuation after comment; _bit_names net<id> fallback)
- **Issue #403** (closed): Unit-test build_dut.py's extraction_port_map refusal branches offline

### 2026-10-09

- **PR #407**: test(signoff): unit-test compare_record, _print_item_diff, resolve_artifact
- **PR #405**: ci: wire two missing --check self-checks into check:spec
- **PR #402**: test: unit-test corner_sanity_check's pass/fail logic without ngspice
- **PR #401**: ci: run the SDF regeneration guard in PDK nightly (#374)
- **PR #397**: test: unit-test combiner_sampler and ro_ring11 row/wiring geometry helpers
- **PR #399**: test: unit-test layout/pex/build.py's port-resolution and tap helpers
- **PR #398**: test: unit-test worst_corner_entropy.py's --check gate
- **PR #395**: test: unit-test floorplan.py's SPICE hierarchy-expansion helpers
- **PR #394**: test: unit-test the tap-phase launcher's stale-record cleanup
- **PR #389**: test: unit-test the digital LVS reference-netlist helpers
- **PR #386**: test: unit-test digital place-and-route DEF/GDS checks
- **Issue #391** (closed): Unit-test signoff/check.py's verdict-of-record comparison (compare_record, resolve_artifact)
- **Issue #400** (closed): Wire the DR-0012-noise estimator-calibration and statistical-battery self-checks into check:spec / CI
- **Issue #388** (closed): lvs.py: _bit_names documents a net<id> fallback it does not implement
- **Issue #377** (closed): Unit-test the corner-sanity guardrail's pass/fail logic without ngspice
- **Issue #374** (closed): Run the committed SDF regeneration guard in PDK nightly CI
- **Issue #392** (closed): Unit-test the combiner_sampler and ro_ring11 row/wiring geometry helpers
- **Issue #390** (closed): Unit-test layout/pex/build.py's port-resolution and tap-position helpers
- **Issue #396** (closed): Unit-test sim/tools/worst_corner_entropy.py's --check gate: it is only ever run against the real corpus
- **Issue #384** (closed): Unit-test floorplan.py's SPICE hierarchy-expansion helpers
- **Issue #393** (closed): Unit-test run_array_liveness_tap_phase.py's stale-record cleanup so it cannot delete complete evidence
- **Issue #382** (closed): Unit-test the digital LVS reference-netlist helpers in layout/digital/lvs.py
- **Issue #383** (closed): Unit-test the digital place-and-route DEF/GDS checks in layout/digital/build.py

### 2026-10-09

- **PR #381**: test: add unit tests for the shared layout engine _mos_row
- **Issue #378** (closed): Add unit tests for the shared hand-drawn layout engine layout/cells/_mos_row.py
- **PR #376**: Add unit tests for the hand-rolled GDSII writer
- **PR #375**: Unit-test gen_sdf SDF filter; raise SdfError on malformed input
- **PR #371**: pdk-nightly: provision gf180mcu_fd_sc_mcu7t5v0 for the floorplan step
- **PR #370**: Reject malformed raw provenance in the checksum gate
- **PR #368**: Add fail-path unit tests for the coupling and tap-phase --check gates
- **PR #364**: Fail closed when --changed record discovery cannot run git diff
- **Issue #373** (closed): Unit-test gen_sdf's SDF filter without openroad and raise SdfError on malformed input
- **Issue #372** (closed): Add unit tests for the hand-rolled GDSII writer in layout/testcells/gdsii.py
- **Issue #369** (closed): Reject malformed raw provenance instead of accepting a parsed checksum prefix
- **Issue #367** (closed): Guard telemetry: preserve fail-closed handling for computed path variables
- **Issue #365** (closed): Auditor Capability Request: Python 3 runtime for gf180-trng validation
- **Issue #362** (closed): Fail closed when checksum --changed cannot resolve its Git base
- **Issue #357** (closed): Add fail-path unit tests for the untested sim tool --check spec gates
- **Issue #310** (closed): pdk-nightly.yml does not provision gf180mcu_fd_sc_mcu7t5v0, so the floorplan step fails at the LEF lookup before checking anything
- **PR #361**: Guard the check:spec gate count and name list restated in prose
- **PR #358**: test(sim): fail-path tests for four spec-guarding --check gates
- **Issue #360** (closed): Guard the check:spec gate count and name list restated in README, ci.yml and package.json (11 / 11 / 13 vs 15 actual)
- **PR #356**: test(sim): add direct unit tests for the shared record parser
- **Issue #345** (closed): Unit-test the shared evidence-record parser (sim/tools/_record_parsing.py), which has no direct tests

### 2026-10-08

- **PR #354**: Pin RTL and verification sources in the item-7 digital freshness gate
- **PR #353**: Verify item-7 analog schematic DUT against its design source
- **Issue #351** (closed): Verify analog item-7 generated schematic DUT against its canonical source
- **Issue #350** (closed): Pin RTL and verification sources in the digital item-7 freshness gate
- **PR #349**: Guard every restated klt/klayout pin against signoff/check.py
- **PR #348**: Drop stale test counts from ci.yml self-check header
- **PR #347**: Require a complete current-DEF family for digital STA aggregates
- **PR #343**: Unit-test the signoff freshness gate against its failure branches
- **PR #342**: Consolidate duplicate klt_origin() into layout/_klt.py
- **PR #340**: Cite a native klt pex report over ring1 as T1 item 7 analog (#326)
- **Issue #344** (closed): Single-source the pinned klt/klayout build: guard the six restated pins against signoff/check.py KLT_PIN
- **Issue #341** (closed): Guard digital STA aggregates against mixed and stale routed-DUT revisions
- **Issue #337** (closed): Unit-test the signoff freshness gate (check_envelope_against_its_input) against its failure branches
- **Issue #336** (closed): ci.yml self-check inventory quotes test counts that are ~7x stale (71/43 vs 540/121)
- **Issue #335** (closed): Consolidate duplicate klt_origin(): verify.py fork vs layout/_klt.py
- **Issue #326** (closed): T1 item 7 (analog): emit the post-layout extraction as a native klt pex report and cite it
- **PR #334**: Enforce append-only simulation evidence against the PR base in CI
- **PR #333**: Consolidate duplicated Variant scaffold across sim/tools --check scripts
- **PR #332**: Cite 11.analog supply-ERC reports in the T1 manifest (#327)
- **PR #329**: Record why the digital STA sweep is not cited as a klt sta envelope (#322)
- **PR #324**: Cite 11.digital supply-ERC report in the T1 manifest (#321)
- **PR #323**: Guard the corpus totals quoted in README.md against the tree
- **PR #318**: Cite an aggregated analog characterization summary as T1 item 8 analog
- **PR #317**: feat(signoff): publish post-route functional run as T1 item 7 digital citation (#314)
- **PR #316**: floorplan: derive the composed interface for klt 0.6.0 and compare it by name (#309)
- **PR #311**: Ratify DR-0026 amended to klayout-tools 0.6.0; re-produce layout/reports/ and pin 4.analog
- **Issue #330** (closed): Consolidate duplicated Variant scaffold across sim/tools --check scripts
- **Issue #328** (closed): Enforce append-only simulation evidence against the PR base in CI
- **Issue #327** (closed): T1 item 11 (analog): write and run a klt erc supply spec for the analog regions and cite it
- **Issue #322** (closed): T1 item 5 (digital): emit the fifteen-corner STA sweep as a graded klt envelope and cite it
- **Issue #321** (closed): T1 item 11: cite the committed digital supply-ERC report in signoff/block-manifest.json so the grader sees it
- **Issue #320** (closed): Guard the corpus counts quoted in README.md (decision records, characterization summaries, evidence records) against the tree
- **Issue #314** (closed): Publish native post-route functional evidence for the T1 digital item-7 citation
- **Issue #313** (closed): Aggregate analog characterization into a pinned T1 item-8 evidence artifact
- **Issue #309** (closed): floorplan.py's inter-region pin-count expectation (107) is stale: klt 0.6.0 extracts 114, naming the five pins the formula subtracts as unnameable
- **Issue #308** (closed): Auditor Capability Request: Python 3 unavailable for local validation
- **Issue #281** (closed): Re-run the analog LVS under a settled producer pin, so item 4's analog citation carries a freshness pin and real power_connectivity/body_verification verdicts

### 2026-10-07

- **PR #306**: fix(digital): rebuild place-and-route from the re-baselined netlist, guard the input hash (#293)
- **Issue #293** (closed): Digital P&R evidence records a superseded input netlist: place_and_route.json pins the pre-#292 trng_top.synth.v hash

### 2026-10-01

- **Issue #294** (closed): ci: pdk-nightly's layout DRC/LVS staleness check fails on ro_ring11.extract.json (new step reached after #291)
- **Issue #270** (closed): Main checkout stuck dirty since before 2026-09-20 — blocks resync-installed automation (202 aborted rebase cycles)

### 2026-09-27

- **PR #303**: chore(sim/harness): remove unused EXIT_SIM_ERROR exit code
- **PR #302**: refactor(sim/tb): deduplicate uniform_words/biased_bits into harness.bits
- **Issue #301** (closed): Remove unused EXIT_SIM_ERROR exit code from sim/harness/cli.py
- **PR #300**: docs(signoff): correct three stale T1 claims in README's claimant reading
- **PR #299**: chore(loom): mitigate #124 noop-cooldown re-dispatch storm with 6h cooldownSecs
- **Issue #298** (closed): Deduplicate uniform_words / biased_bits across sim/tb fault-injection source models
- **PR #297**: fix(layout): tolerate architecture-dependent net_id swap in freshness gate
- **Issue #296** (closed): Loom daemon repeatedly re-dispatches #124 despite noop-cooldown (61 sweeps over 36 days, some <2 min apart)
- **Issue #295** (closed): signoff/README.md's T1 reading is stale: item 5/6 evidence is unproducible upstream, and the grader pin's yardstick moved 9 commits
- **Issue #124** (closed): Track the gap to T1 sim-validated / bronze (klayout-tools design-evidence tiers)

### 2026-09-24

- **PR #267**: chore: resync installed Loom surfaces

### 2026-09-23

- **PR #292**: design: re-baseline trng_top.synth.{v,json} on pdk-nightly's pinned toolchain
- **PR #291**: fix(design): accept both klt netlist_path schemas in synth.py
- **Issue #290** (closed): Digital synthesis artefacts are stale: trng_top.synth.{v,json} do not match a fresh run
- **PR #289**: Remove dead --record CLI flag from six testbench entry points
- **Issue #288** (closed): ci: pdk-nightly's synthesis staleness guard aborts — design/synth.py rejects the pinned klt's string netlist_path (#283 regression)
- **Issue #287** (closed): Remove dead --record CLI flag from 6 run_demo.py/run_battery.py scripts
- **PR #286**: docs: carry #277's re-tuned depth-2 digital power figures into README
- **PR #285**: feat(digital): declare ties[] in the ERC supply spec (T1 item 11)
- **Issue #284** (closed): merge-pr.sh: _check_champion_hold_state_staleness aborts every normal merge (set -e + pipefail + grep no-match)
- **PR #283**: fix(design): read klt synthesize's netlist_path {path, scope} envelope
- **PR #282**: feat(signoff): re-emit the digital DRC/LVS as gradeable klt envelopes (3/22 -> 5/22)
- **PR #280**: feat(digital): add klt erc supply spec and report for T1 item 11
- **Issue #279** (closed): Propagate #277's re-tuned depth-2 digital power figures into README's Power row
- **Issue #278** (closed): design/synth.py --check crashes: klt synthesize's netlist_path is now an object, not a path string
- **PR #277**: fix(digital): re-tune max_transition_ns for the FIFO_DEPTH = 2 topology
- **Issue #276** (closed): T1 item 11: declare ties[] in the digital supply spec so erc.missing_tie is computed (klayout-tools#2169 is fixed in 0.6.0)
- **Issue #275** (closed): README: embed the fleet burndown chart (one line)
- **Issue #273** (closed): Re-emit the digital partition's DRC/LVS and the analog LVS as gradeable klt envelopes, so T1 items 3 and 4 grade on both partitions
- **Issue #268** (closed): T1 item 11 (power delivery, structural): no klt erc supply spec or report in this repo
- **Issue #264** (closed): Re-tune digital place-and-route's max_transition/max_capacitance constraints for FIFO_DEPTH = 2

### 2026-09-22

- **PR #274**: feat(signoff): commit a klt signoff block manifest so T1 state is graded, not hand-read
- **PR #272**: docs: propagate #255/#266's depth-2 digital power figures into the Power row
- **Issue #269** (closed): Commit a klt signoff block manifest so this block's T1 state is graded, not hand-read
- **Issue #265** (closed): Propagate the depth-2 gate-level digital power figures into README's Power row

### 2026-09-19

- **PR #266**: feat(digital): re-synthesize and re-place-and-route at DR-0020's FIFO_DEPTH = 2
- **PR #263**: docs(sim): correct the FIFO-read-path mux2_1 leakage figure to 5.60 µW
- **Issue #262** (closed): The 6.28 uW FIFO-read-path mux figure in characterization-startup-and-power-budget.md does not reproduce from the Liberty library
- **PR #261**: docs(sim): label every digital-estimate figure with its FIFO_DEPTH and add the depth-2 figures
- **Issue #257** (closed): Propagate the FIFO_DEPTH = 2 digital estimate figures into sim/characterization-startup-and-power-budget.md
- **Issue #255** (closed): Re-synthesize and place-and-route the digital block at FIFO_DEPTH = 2

### 2026-09-18

- **PR #260**: chore: remove unused `import re` from test_pex_fullchip.py
- **Issue #259** (closed): Remove unused import: re in layout/tests/test_pex_fullchip.py
- **PR #258**: feat: set FIFO_DEPTH to DR-0020's ratified 2 and re-derive area/power
- **Issue #254** (closed): Implement DR-0020's ratified FIFO_DEPTH=2 in RTL/regmap and refresh the digital power/area estimates

### 2026-09-16

- **PR #253**: docs: propagate idle-current figures after #240's digital rebuild
- **Issue #252** (closed): Refresh README.md's Power row idle-leakage figure after #240's digital rebuild

### 2026-09-15

- **PR #251**: docs(digital): refresh README's P&R figures after #240's rebuild
- **Issue #250** (closed): Refresh layout/digital/README.md's P&R figures after #240's max_transition/max_capacitance rebuild
- **PR #249**: fix(digital): constrain max_transition/max_capacitance at P&R and rebuild
- **PR #248**: docs(spec): propose DR-0026, re-pin klayout-tools forward to match floorplan reports
- **Issue #240** (closed): Constrain max_transition at place-and-route time once klt can express it (follow-up to #237)
- **Issue #230** (closed): Decide which klayout-tools build is normative for layout/floorplan/reports/

### 2026-09-14

- **Issue #247** (closed): Point digital_corner_characterization.py at the shared record-parsing helper (#104 follow-up)
