2AMLogic/gf180-trng/work_log/WORK_LOG_2026-09.md

# Work Log Archive — 2026-09

Sections moved byte-for-byte from [WORK_LOG.md](../WORK_LOG.md) by `loom-daemon work-docs archive`.

### 2026-09-07

- **PR #216**: layout: consolidate duplicated _rect/_pad/_narrow geometry helpers
- **Issue #215** (closed): Consolidate duplicated _rect/_pad/_narrow geometry helpers across layout build.py scripts
- **PR #214**: spec: ratify DR-0019, DR-0020, and DR-0023 via the two-key mechanism
- **Issue #213** (closed): File the ratification PR for DR-0019, DR-0020, and DR-0023 via the two-key mechanism
- **PR #212**: sim(post-layout): re-run entropy/worst-corner/startup-power against the extracted netlist
- **Issue #17** (closed): Post-layout extracted re-run of the verification suite
