2AMLogic/gf180-trng/layout/reports/power_switch.extracted.spice

* extracted by klt extract --deck gf180mcu

* cell power_switch
* pin sleep
* pin vdd
* pin vvdd
.SUBCKT power_switch sleep vdd vvdd
* device instance $1 r0 *1 0.84,5 pfet
X$1 vvdd sleep vdd vdd pfet_03v3 L=0.28U W=10U AS=7P AD=3.5P PS=21.4U PD=10.7U
* device instance $2 r0 *1 1.82,5 pfet
X$2 vdd sleep vvdd vdd pfet_03v3 L=0.28U W=10U AS=3.5P AD=3.5P PS=10.7U PD=10.7U
* device instance $3 r0 *1 2.8,5 pfet
X$3 vvdd sleep vdd vdd pfet_03v3 L=0.28U W=10U AS=3.5P AD=3.5P PS=10.7U PD=10.7U
* device instance $4 r0 *1 3.78,5 pfet
X$4 vdd sleep vvdd vdd pfet_03v3 L=0.28U W=10U AS=3.5P AD=3.5P PS=10.7U PD=10.7U
* device instance $5 r0 *1 4.76,5 pfet
X$5 vvdd sleep vdd vdd pfet_03v3 L=0.28U W=10U AS=3.5P AD=3.5P PS=10.7U PD=10.7U
* device instance $6 r0 *1 5.74,5 pfet
X$6 vdd sleep vvdd vdd pfet_03v3 L=0.28U W=10U AS=3.5P AD=3.5P PS=10.7U PD=10.7U
* device instance $7 r0 *1 6.72,5 pfet
X$7 vvdd sleep vdd vdd pfet_03v3 L=0.28U W=10U AS=3.5P AD=3.5P PS=10.7U PD=10.7U
* device instance $8 r0 *1 7.7,5 pfet
X$8 vdd sleep vvdd vdd pfet_03v3 L=0.28U W=10U AS=3.5P AD=3.5P PS=10.7U PD=10.7U
* device instance $9 r0 *1 8.68,5 pfet
X$9 vvdd sleep vdd vdd pfet_03v3 L=0.28U W=10U AS=3.5P AD=3.5P PS=10.7U PD=10.7U
* device instance $10 r0 *1 9.66,5 pfet
X$10 vdd sleep vvdd vdd pfet_03v3 L=0.28U W=10U AS=3.5P AD=3.5P PS=10.7U
+ PD=10.7U
* device instance $11 r0 *1 10.64,5 pfet
X$11 vvdd sleep vdd vdd pfet_03v3 L=0.28U W=10U AS=3.5P AD=3.5P PS=10.7U
+ PD=10.7U
* device instance $12 r0 *1 11.62,5 pfet
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
+ PD=10.7U
* device instance $39 r0 *1 38.08,5 pfet
X$39 vvdd sleep vdd vdd pfet_03v3 L=0.28U W=10U AS=3.5P AD=3.5P PS=10.7U
+ PD=10.7U
* device instance $40 r0 *1 39.06,5 pfet
X$40 vdd sleep vvdd vdd pfet_03v3 L=0.28U W=10U AS=3.5P AD=7P PS=10.7U PD=21.4U
.ENDS power_switch
