2AMLogic/gf180-trng/layout/reports/ro_buf.extracted.spice

* extracted by klt extract --deck gf180mcu

* cell ro_buf
* pin a
* pin vdd
* pin vss
* pin y
.SUBCKT ro_buf a vdd vss y
* device instance $1 r0 *1 0.84,0.22 nfet
X$1 vss a y vss nfet_03v3 L=0.28U W=0.22U AS=0.308P AD=0.308P PS=2.28U PD=2.28U
* device instance $2 r0 *1 0.84,1.86 pfet
X$2 vdd a y vdd pfet_03v3 L=0.28U W=0.44U AS=0.308P AD=0.308P PS=2.28U PD=2.28U
.ENDS ro_buf
