2AMLogic/gf180-trng/layout/reports/ro_nand2_ring2.extracted.spice

* extracted by klt extract --deck gf180mcu

* cell ro_nand2_ring2
* pin a
* pin en
* pin vddr
* pin vss
* pin y
.SUBCKT ro_nand2_ring2 a en vddr vss y
* device instance $1 r0 *1 3.86,0.22 nfet
X$1 vss vddr \$8 vss nfet_03v3 L=2U W=0.24U AS=0.176P AD=0.308P PS=1.24U
+ PD=2.28U
* device instance $2 r0 *1 0.84,0.22 nfet
X$2 \$7 a y vss nfet_03v3 L=0.28U W=0.44U AS=0.308P AD=0.176P PS=2.28U PD=1.24U
* device instance $3 r0 *1 1.92,0.22 nfet
X$3 \$8 en \$7 vss nfet_03v3 L=0.28U W=0.44U AS=0.176P AD=0.176P PS=1.24U
+ PD=1.24U
* device instance $4 r0 *1 -1.1,1.86 pfet
X$4 \$6 vss vddr vddr pfet_03v3 L=2U W=0.24U AS=0.308P AD=0.176P PS=2.28U
+ PD=1.24U
* device instance $5 r0 *1 0.84,1.86 pfet
X$5 y a \$6 vddr pfet_03v3 L=0.28U W=0.44U AS=0.176P AD=0.176P PS=1.24U PD=1.24U
* device instance $6 r0 *1 1.92,1.86 pfet
X$6 \$6 en y vddr pfet_03v3 L=0.28U W=0.44U AS=0.176P AD=0.352P PS=1.24U
+ PD=2.48U
.ENDS ro_nand2_ring2
