2AMLogic/gf180-trng/layout/reports/ro_ring11_ring2.extracted.spice

* extracted by klt extract --deck gf180mcu

* cell ro_ring11_ring2
* pin a,y
* pin a,y
* pin a,y
* pin a,y
* pin a,y
* pin a,y
* pin a,y
* pin a,y
* pin a,y
* pin a,y
* pin a,y
* pin en
* pin vddr
* pin vss
.SUBCKT ro_ring11_ring2 a|y a|y$1 a|y$2 a|y$3 a|y$4 a|y$5 a|y$6 a|y$7 a|y$8
+ a|y$9 a|y$10 en vddr vss
* device instance $1 r0 *1 3.86,0.22 nfet
X$1 vss vddr \$15 vss nfet_03v3 L=2U W=0.24U AS=0.176P AD=0.308P PS=1.24U
+ PD=2.28U
* device instance $2 r0 *1 0.84,0.22 nfet
X$2 \$14 a|y$10 a|y vss nfet_03v3 L=0.28U W=0.44U AS=0.308P AD=0.176P PS=2.28U
+ PD=1.24U
* device instance $3 r0 *1 1.92,0.22 nfet
X$3 \$15 en \$14 vss nfet_03v3 L=0.28U W=0.44U AS=0.176P AD=0.176P PS=1.24U
+ PD=1.24U
* device instance $4 r0 *1 10.14,0.22 nfet
X$4 \$17 a|y a|y$1 vss nfet_03v3 L=0.28U W=0.22U AS=0.308P AD=0.088P PS=2.28U
+ PD=0.84U
* device instance $5 r0 *1 11.68,0.22 nfet
X$5 vss vddr \$17 vss nfet_03v3 L=2U W=0.24U AS=0.088P AD=0.308P PS=0.84U
+ PD=2.28U
* device instance $6 r0 *1 18.21,0.22 nfet
X$6 \$18 a|y$1 a|y$2 vss nfet_03v3 L=0.28U W=0.22U AS=0.308P AD=0.088P PS=2.28U
+ PD=0.84U
* device instance $7 r0 *1 19.75,0.22 nfet
X$7 vss vddr \$18 vss nfet_03v3 L=2U W=0.24U AS=0.088P AD=0.308P PS=0.84U
+ PD=2.28U
* device instance $8 r0 *1 26.28,0.22 nfet
X$8 \$20 a|y$2 a|y$3 vss nfet_03v3 L=0.28U W=0.22U AS=0.308P AD=0.088P PS=2.28U
+ PD=0.84U
* device instance $9 r0 *1 27.82,0.22 nfet
X$9 vss vddr \$20 vss nfet_03v3 L=2U W=0.24U AS=0.088P AD=0.308P PS=0.84U
+ PD=2.28U
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
X$41 vddr vss \$35 vddr pfet_03v3 L=2U W=0.24U AS=0.088P AD=0.308P PS=0.84U
+ PD=2.28U
* device instance $42 r0 *1 66.63,1.86 pfet
X$42 \$35 a|y$7 a|y$8 vddr pfet_03v3 L=0.28U W=0.44U AS=0.308P AD=0.088P
+ PS=2.28U PD=0.84U
* device instance $43 r0 *1 76.24,1.86 pfet
X$43 vddr vss \$36 vddr pfet_03v3 L=2U W=0.24U AS=0.088P AD=0.308P PS=0.84U
+ PD=2.28U
* device instance $44 r0 *1 74.7,1.86 pfet
X$44 \$36 a|y$8 a|y$9 vddr pfet_03v3 L=0.28U W=0.44U AS=0.308P AD=0.088P
+ PS=2.28U PD=0.84U
* device instance $45 r0 *1 84.31,1.86 pfet
X$45 vddr vss \$37 vddr pfet_03v3 L=2U W=0.24U AS=0.088P AD=0.308P PS=0.84U
+ PD=2.28U
* device instance $46 r0 *1 82.77,1.86 pfet
X$46 \$37 a|y$9 a|y$10 vddr pfet_03v3 L=0.28U W=0.44U AS=0.308P AD=0.088P
+ PS=2.28U PD=0.84U
.ENDS ro_ring11_ring2
