2AMLogic/gf180-trng/layout/reports/combiner_sampler.extracted.spice

* extracted by klt extract --deck gf180mcu

* cell combiner_sampler
* pin a
* pin a
* pin a,d,y
* pin b,d,y
* pin clk
* pin d,vdd
* pin d,y
* pin q
* pin q
* pin q
* pin q
* pin rst_n
* pin vss
* pin vsubs
.SUBCKT combiner_sampler a a$1 a|d|y b|d|y clk d|vdd d|y q q$1 q$2 q$3 rst_n
+ vss vsubs
* device instance $1 r0 *1 0.84,0.22 nfet
X$1 vss a a|d|y vsubs nfet_03v3 L=0.28U W=0.22U AS=0.308P AD=0.308P PS=2.28U
+ PD=2.28U
* device instance $2 r0 *1 9.27,0.22 nfet
X$2 vss a$1 b|d|y vsubs nfet_03v3 L=0.28U W=0.22U AS=0.308P AD=0.308P PS=2.28U
+ PD=2.28U
* device instance $3 r0 *1 22.18,1 nfet
X$3 d|y a|d|y \$6 vsubs nfet_03v3 L=0.28U W=0.44U AS=0.3872P AD=0.3872P
+ PS=2.64U PD=2.64U
* device instance $4 r0 *1 24.58,1 nfet
X$4 \$6 b|d|y vss vsubs nfet_03v3 L=0.28U W=0.44U AS=0.3872P AD=0.3872P
+ PS=2.64U PD=2.64U
* device instance $5 r0 *1 26.98,1 nfet
X$5 d|y \$4 \$8 vsubs nfet_03v3 L=0.28U W=0.44U AS=0.3872P AD=0.3872P PS=2.64U
+ PD=2.64U
* device instance $6 r0 *1 29.38,1 nfet
X$6 \$8 \$5 vss vsubs nfet_03v3 L=0.28U W=0.44U AS=0.3872P AD=0.3872P PS=2.64U
+ PD=2.64U
* device instance $7 r0 *1 71.07,1 nfet
X$7 \$46 \$11 \$16 vsubs nfet_03v3 L=0.28U W=0.44U AS=0.3872P AD=0.3872P
+ PS=2.64U PD=2.64U
* device instance $8 r0 *1 73.47,1 nfet
X$8 \$16 rst_n vss vsubs nfet_03v3 L=0.28U W=0.44U AS=0.3872P AD=0.3872P
+ PS=2.64U PD=2.64U
* device instance $9 r0 *1 75.87,1 nfet
X$9 \$15 q \$17 vsubs nfet_03v3 L=0.28U W=0.44U AS=0.3872P AD=0.3872P PS=2.64U
+ PD=2.64U
* device instance $10 r0 *1 78.27,1 nfet
X$10 \$17 rst_n vss vsubs nfet_03v3 L=0.28U W=0.44U AS=0.3872P AD=0.3872P
+ PS=2.64U PD=2.64U
* device instance $11 r0 *1 131.96,1 nfet
X$11 \$48 \$20 \$25 vsubs nfet_03v3 L=0.28U W=0.44U AS=0.3872P AD=0.3872P
+ PS=2.64U PD=2.64U
* device instance $12 r0 *1 134.36,1 nfet
X$12 \$25 rst_n vss vsubs nfet_03v3 L=0.28U W=0.44U AS=0.3872P AD=0.3872P
+ PS=2.64U PD=2.64U
* device instance $13 r0 *1 136.76,1 nfet
X$13 \$24 q$1 \$26 vsubs nfet_03v3 L=0.28U W=0.44U AS=0.3872P AD=0.3872P
+ PS=2.64U PD=2.64U
* device instance $14 r0 *1 139.16,1 nfet
X$14 \$26 rst_n vss vsubs nfet_03v3 L=0.28U W=0.44U AS=0.3872P AD=0.3872P
+ PS=2.64U PD=2.64U
* device instance $15 r0 *1 192.85,1 nfet
X$15 \$49 \$28 \$33 vsubs nfet_03v3 L=0.28U W=0.44U AS=0.3872P AD=0.3872P
+ PS=2.64U PD=2.64U
* device instance $16 r0 *1 195.25,1 nfet
X$16 \$33 rst_n vss vsubs nfet_03v3 L=0.28U W=0.44U AS=0.3872P AD=0.3872P
+ PS=2.64U PD=2.64U
* device instance $17 r0 *1 197.65,1 nfet
X$17 \$32 q$2 \$34 vsubs nfet_03v3 L=0.28U W=0.44U AS=0.3872P AD=0.3872P
+ PS=2.64U PD=2.64U
* device instance $18 r0 *1 200.05,1 nfet
X$18 \$34 rst_n vss vsubs nfet_03v3 L=0.28U W=0.44U AS=0.3872P AD=0.3872P
+ PS=2.64U PD=2.64U
* device instance $19 r0 *1 253.74,1 nfet
X$19 \$50 \$36 \$41 vsubs nfet_03v3 L=0.28U W=0.44U AS=0.3872P AD=0.3872P
+ PS=2.64U PD=2.64U
* device instance $20 r0 *1 256.14,1 nfet
X$20 \$41 rst_n vss vsubs nfet_03v3 L=0.28U W=0.44U AS=0.3872P AD=0.3872P
+ PS=2.64U PD=2.64U
* device instance $21 r0 *1 258.54,1 nfet
X$21 \$40 q$3 \$42 vsubs nfet_03v3 L=0.28U W=0.44U AS=0.3872P AD=0.3872P
+ PS=2.64U PD=2.64U
* device instance $22 r0 *1 260.94,1 nfet
X$22 \$42 rst_n vss vsubs nfet_03v3 L=0.28U W=0.44U AS=0.3872P AD=0.3872P
+ PS=2.64U PD=2.64U
* device instance $23 r0 *1 17.38,1 nfet
X$23 \$4 a|d|y vss vsubs nfet_03v3 L=0.28U W=0.22U AS=0.3872P AD=0.3872P
+ PS=2.64U PD=2.64U
* device instance $24 r0 *1 19.78,1 nfet
X$24 \$5 b|d|y vss vsubs nfet_03v3 L=0.28U W=0.22U AS=0.3872P AD=0.3872P
+ PS=2.64U PD=2.64U
* device instance $25 r0 *1 54.27,1 nfet
X$25 \$10 clk vss vsubs nfet_03v3 L=0.28U W=0.22U AS=0.3872P AD=0.3872P
+ PS=2.64U PD=2.64U
* device instance $26 r0 *1 56.67,1 nfet
X$26 d|y \$10 \$11 vsubs nfet_03v3 L=0.28U W=0.22U AS=0.3872P AD=0.3872P
+ PS=2.64U PD=2.64U
* device instance $27 r0 *1 59.07,1 nfet
X$27 \$12 \$46 vss vsubs nfet_03v3 L=0.28U W=0.22U AS=0.3872P AD=0.3872P
+ PS=2.64U PD=2.64U
* device instance $28 r0 *1 61.47,1 nfet
X$28 \$12 clk \$11 vsubs nfet_03v3 L=0.28U W=0.22U AS=0.3872P AD=0.3872P
+ PS=2.64U PD=2.64U
* device instance $29 r0 *1 63.87,1 nfet
X$29 \$46 clk \$13 vsubs nfet_03v3 L=0.28U W=0.22U AS=0.3872P AD=0.3872P
+ PS=2.64U PD=2.64U
* device instance $30 r0 *1 66.27,1 nfet
X$30 q \$13 vss vsubs nfet_03v3 L=0.28U W=0.22U AS=0.3872P AD=0.3872P PS=2.64U
+ PD=2.64U
* device instance $31 r0 *1 68.67,1 nfet
X$31 \$15 \$10 \$13 vsubs nfet_03v3 L=0.28U W=0.22U AS=0.3872P AD=0.3872P
+ PS=2.64U PD=2.64U
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
* device instance $103 r0 *1 0.84,1.86 pfet
X$103 d|vdd a a|d|y \$51 pfet_03v3 L=0.28U W=0.44U AS=0.308P AD=0.308P PS=2.28U
+ PD=2.28U
* device instance $104 r0 *1 9.27,1.86 pfet
X$104 d|vdd a$1 b|d|y \$52 pfet_03v3 L=0.28U W=0.44U AS=0.308P AD=0.308P
+ PS=2.28U PD=2.28U
.ENDS combiner_sampler
