2AMLogic/gf180-trng/layout/reports/ro_ring11.extracted.spice

* extracted by klt extract --deck gf180mcu

* cell ro_ring11
* pin a,y
* pin a,y
* pin a,y
* pin a,y
* pin a,y
* pin a,y
* pin a,y
* pin a,y
* pin a,y
* pin a,y
* pin a,y
* pin en
* pin vddr
* pin vss
* pin vsubs
.SUBCKT ro_ring11 a|y a|y$1 a|y$2 a|y$3 a|y$4 a|y$5 a|y$6 a|y$7 a|y$8 a|y$9
+ a|y$10 en vddr vss vsubs
* device instance $1 r0 *1 8.9,0.22 nfet
X$1 \$15 a|y a|y$1 vsubs nfet_03v3 L=0.28U W=0.22U AS=0.308P AD=0.044P PS=2.28U
+ PD=0.62U
* device instance $2 r0 *1 10.44,0.22 nfet
X$2 \$15 vddr vss vsubs nfet_03v3 L=2U W=0.22U AS=0.308P AD=0.044P PS=2.28U
+ PD=0.62U
* device instance $3 r0 *1 15.73,0.22 nfet
X$3 \$17 a|y$1 a|y$2 vsubs nfet_03v3 L=0.28U W=0.22U AS=0.308P AD=0.044P
+ PS=2.28U PD=0.62U
* device instance $4 r0 *1 17.27,0.22 nfet
X$4 \$17 vddr vss vsubs nfet_03v3 L=2U W=0.22U AS=0.308P AD=0.044P PS=2.28U
+ PD=0.62U
* device instance $5 r0 *1 22.56,0.22 nfet
X$5 \$18 a|y$2 a|y$3 vsubs nfet_03v3 L=0.28U W=0.22U AS=0.308P AD=0.044P
+ PS=2.28U PD=0.62U
* device instance $6 r0 *1 24.1,0.22 nfet
X$6 \$18 vddr vss vsubs nfet_03v3 L=2U W=0.22U AS=0.308P AD=0.044P PS=2.28U
+ PD=0.62U
* device instance $7 r0 *1 29.39,0.22 nfet
X$7 \$20 a|y$3 a|y$4 vsubs nfet_03v3 L=0.28U W=0.22U AS=0.308P AD=0.044P
+ PS=2.28U PD=0.62U
* device instance $8 r0 *1 30.93,0.22 nfet
X$8 \$20 vddr vss vsubs nfet_03v3 L=2U W=0.22U AS=0.308P AD=0.044P PS=2.28U
+ PD=0.62U
* device instance $9 r0 *1 36.22,0.22 nfet
X$9 \$21 a|y$4 a|y$5 vsubs nfet_03v3 L=0.28U W=0.22U AS=0.308P AD=0.044P
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
X$41 vddr vss \$43 \$44 pfet_03v3 L=2U W=0.22U AS=0.088P AD=0.308P PS=0.84U
+ PD=2.28U
* device instance $42 r0 *1 56.71,1.86 pfet
X$42 \$43 a|y$7 a|y$8 \$44 pfet_03v3 L=0.28U W=0.44U AS=0.308P AD=0.088P
+ PS=2.28U PD=0.84U
* device instance $43 r0 *1 65.08,1.86 pfet
X$43 vddr vss \$45 \$46 pfet_03v3 L=2U W=0.22U AS=0.088P AD=0.308P PS=0.84U
+ PD=2.28U
* device instance $44 r0 *1 63.54,1.86 pfet
X$44 \$45 a|y$8 a|y$9 \$46 pfet_03v3 L=0.28U W=0.44U AS=0.308P AD=0.088P
+ PS=2.28U PD=0.84U
* device instance $45 r0 *1 71.91,1.86 pfet
X$45 vddr vss \$47 \$48 pfet_03v3 L=2U W=0.22U AS=0.088P AD=0.308P PS=0.84U
+ PD=2.28U
* device instance $46 r0 *1 70.37,1.86 pfet
X$46 \$47 a|y$9 a|y$10 \$48 pfet_03v3 L=0.28U W=0.44U AS=0.308P AD=0.088P
+ PS=2.28U PD=0.84U
.ENDS ro_ring11
