2AMLogic/gf180-trng/sim/tb/ro-ring11-ring2-pex/ro_ring11_ring2_schematic.spice

* ro_ring11_ring2 schematic-side DUT for the klt pex run over ring2's layout.
* GENERATED by sim/tb/ro-ring11-pex/build_dut.py --ring ring2 -- do not edit by hand.
*
* The header is klt extract's fifteen-port order for
* layout/rings/ro_ring11_ring2/ro_ring11_ring2.gds, with each position carrying the schematic
* node that sits there in the layout (identified from the extracted
* netlist's own device geometry; see build_dut.py). The body is
* design/ro_array_core.spice's .subckt ro_ring11 and its two leaf
* subcircuits, transcribed unchanged, at ring2's xr2 sizing. vsubs is
* declared and unused: the schematic has no substrate-tap net.

.subckt ro_ring11_ring2 ro n1 n2 n3 n4 n5 n6 n7 n8 n9 n10 en vddr vss vsubs wstv=0.240u lstv=2u cld=0.5f
xg ro en n1 vddr vss ro_nand2 wstv=wstv lstv=lstv cld=cld
x1 n1 n2 vddr vss ro_stage wstv=wstv lstv=lstv cld=cld
x2 n2 n3 vddr vss ro_stage wstv=wstv lstv=lstv cld=cld
x3 n3 n4 vddr vss ro_stage wstv=wstv lstv=lstv cld=cld
x4 n4 n5 vddr vss ro_stage wstv=wstv lstv=lstv cld=cld
x5 n5 n6 vddr vss ro_stage wstv=wstv lstv=lstv cld=cld
x6 n6 n7 vddr vss ro_stage wstv=wstv lstv=lstv cld=cld
x7 n7 n8 vddr vss ro_stage wstv=wstv lstv=lstv cld=cld
x8 n8 n9 vddr vss ro_stage wstv=wstv lstv=lstv cld=cld
x9 n9 n10 vddr vss ro_stage wstv=wstv lstv=lstv cld=cld
x10 n10 ro vddr vss ro_stage wstv=wstv lstv=lstv cld=cld
.ends

.subckt ro_nand2 a en y vddr vss wstv=0.22u lstv=2u cld=0.5f
*.ipin a
*.ipin en
*.opin y
*.iopin vddr
*.iopin vss
XMph py vss vddr vddr pfet_03v3 L=lstv W=wstv nf=1 ad='int((nf+1)/2) * W/nf * 0.18u' as='int((nf+2)/2) * W/nf * 0.18u'
+ pd='2*int((nf+1)/2) * (W/nf + 0.18u)' ps='2*int((nf+2)/2) * (W/nf + 0.18u)' nrd='0.18u / W' nrs='0.18u / W' sa=0 sb=0
+ sd=0 m=1
XMpa y a py vddr pfet_03v3 L=0.28u W=0.44u nf=1 ad='int((nf+1)/2) * W/nf * 0.18u' as='int((nf+2)/2) * W/nf * 0.18u'
+ pd='2*int((nf+1)/2) * (W/nf + 0.18u)' ps='2*int((nf+2)/2) * (W/nf + 0.18u)' nrd='0.18u / W' nrs='0.18u / W' sa=0 sb=0
+ sd=0 m=1
XMpb y en py vddr pfet_03v3 L=0.28u W=0.44u nf=1 ad='int((nf+1)/2) * W/nf * 0.18u' as='int((nf+2)/2) * W/nf * 0.18u'
+ pd='2*int((nf+1)/2) * (W/nf + 0.18u)' ps='2*int((nf+2)/2) * (W/nf + 0.18u)' nrd='0.18u / W' nrs='0.18u / W' sa=0 sb=0
+ sd=0 m=1
XMna y a nm vss nfet_03v3 L=0.28u W=0.44u nf=1 ad='int((nf+1)/2) * W/nf * 0.18u' as='int((nf+2)/2) * W/nf * 0.18u'
+ pd='2*int((nf+1)/2) * (W/nf + 0.18u)' ps='2*int((nf+2)/2) * (W/nf + 0.18u)' nrd='0.18u / W' nrs='0.18u / W' sa=0 sb=0
+ sd=0 m=1
XMnb nm en ny vss nfet_03v3 L=0.28u W=0.44u nf=1 ad='int((nf+1)/2) * W/nf * 0.18u' as='int((nf+2)/2) * W/nf * 0.18u'
+ pd='2*int((nf+1)/2) * (W/nf + 0.18u)' ps='2*int((nf+2)/2) * (W/nf + 0.18u)' nrd='0.18u / W' nrs='0.18u / W' sa=0 sb=0
+ sd=0 m=1
XMnt ny vddr vss vss nfet_03v3 L=lstv W=wstv nf=1 ad='int((nf+1)/2) * W/nf * 0.18u' as='int((nf+2)/2) * W/nf * 0.18u'
+ pd='2*int((nf+1)/2) * (W/nf + 0.18u)' ps='2*int((nf+2)/2) * (W/nf + 0.18u)' nrd='0.18u / W' nrs='0.18u / W' sa=0 sb=0
+ sd=0 m=1
Cld y vss 'cld' m=1
.ends

.subckt ro_stage a y vddr vss wstv=0.22u lstv=2u cld=0.5f
*.ipin a
*.opin y
*.iopin vddr
*.iopin vss
XMph py vss vddr vddr pfet_03v3 L=lstv W=wstv nf=1 ad='int((nf+1)/2) * W/nf * 0.18u' as='int((nf+2)/2) * W/nf * 0.18u'
+ pd='2*int((nf+1)/2) * (W/nf + 0.18u)' ps='2*int((nf+2)/2) * (W/nf + 0.18u)' nrd='0.18u / W' nrs='0.18u / W' sa=0 sb=0
+ sd=0 m=1
XMp y a py vddr pfet_03v3 L=0.28u W=0.44u nf=1 ad='int((nf+1)/2) * W/nf * 0.18u' as='int((nf+2)/2) * W/nf * 0.18u'
+ pd='2*int((nf+1)/2) * (W/nf + 0.18u)' ps='2*int((nf+2)/2) * (W/nf + 0.18u)' nrd='0.18u / W' nrs='0.18u / W' sa=0 sb=0
+ sd=0 m=1
XMn y a ny vss nfet_03v3 L=0.28u W=0.22u nf=1 ad='int((nf+1)/2) * W/nf * 0.18u' as='int((nf+2)/2) * W/nf * 0.18u'
+ pd='2*int((nf+1)/2) * (W/nf + 0.18u)' ps='2*int((nf+2)/2) * (W/nf + 0.18u)' nrd='0.18u / W' nrs='0.18u / W' sa=0 sb=0
+ sd=0 m=1
XMnt ny vddr vss vss nfet_03v3 L=lstv W=wstv nf=1 ad='int((nf+1)/2) * W/nf * 0.18u' as='int((nf+2)/2) * W/nf * 0.18u'
+ pd='2*int((nf+1)/2) * (W/nf + 0.18u)' ps='2*int((nf+2)/2) * (W/nf + 0.18u)' nrd='0.18u / W' nrs='0.18u / W' sa=0 sb=0
+ sd=0 m=1
Cld y vss 'cld' m=1
.ends
