2AMLogic/gf180-trng/sim/tool-experiments/2026-10-11-ngspice-trnoise-seed-replay/decks/seed11.cir

trnoise replay probe: .option seed=11
.param pm = agauss(0, 1, 1)
vn n1 0 dc 0 trnoise(1 1n 0 0)
rn n1 0 1k
bp n2 0 v = pm
rp n2 0 1k
.option seed=11
.control
set numdgt=8
tran 1n 16n
print v(n1)
let p = v(n2)
print p[0]
let g = sgauss(vector(3))
print g
.endc
.end
