2AMLogic/gf180-trng/layout/digital/trng_top.pnr.v

module trng_top (clk,
    ht_alarm,
    raw_bit,
    raw_valid,
    reg_sel,
    reg_write,
    rst_n,
    str_ready,
    str_valid,
    reg_addr,
    reg_rdata,
    reg_wdata,
    ring_bit,
    str_data);
 input clk;
 output ht_alarm;
 input raw_bit;
 input raw_valid;
 input reg_sel;
 input reg_write;
 input rst_n;
 input str_ready;
 output str_valid;
 input [1:0] reg_addr;
 output [31:0] reg_rdata;
 input [31:0] reg_wdata;
 input [1:0] ring_bit;
 output [31:0] str_data;

 wire cond_en;
 wire cond_flush;
 wire cond_valid;
 wire ht_fail_apt;
 wire ht_fail_rct;
 wire ht_startup_pass;
 wire ring_stuck_any;
 wire startup_req;
 wire clknet_leaf_17_clk;
 wire \u_conditioner/_001_ ;
 wire \u_conditioner/_002_ ;
 wire \u_conditioner/_003_ ;
 wire \u_conditioner/_004_ ;
 wire \u_conditioner/_005_ ;
 wire \u_conditioner/_006_ ;
 wire \u_conditioner/_007_ ;
 wire \u_conditioner/_008_ ;
 wire \u_conditioner/_009_ ;
 wire \u_conditioner/_010_ ;
 wire \u_conditioner/_011_ ;
 wire \u_conditioner/_012_ ;
 wire \u_conditioner/_013_ ;
 wire \u_conditioner/_014_ ;
 wire \u_conditioner/_015_ ;
 wire \u_conditioner/_016_ ;
 wire \u_conditioner/_017_ ;
 wire \u_conditioner/_018_ ;
 wire \u_conditioner/_019_ ;
 wire \u_conditioner/_020_ ;
 wire \u_conditioner/_021_ ;
 wire \u_conditioner/_022_ ;
 wire \u_conditioner/_023_ ;
 wire \u_conditioner/_024_ ;
 wire \u_conditioner/_025_ ;
 wire \u_conditioner/_026_ ;
 wire \u_conditioner/_027_ ;
 wire \u_conditioner/_028_ ;
 wire \u_conditioner/_029_ ;
 wire \u_conditioner/_030_ ;
 wire \u_conditioner/_031_ ;
 wire \u_conditioner/_032_ ;
 wire \u_conditioner/_033_ ;
 wire \u_conditioner/_034_ ;
 wire \u_conditioner/_035_ ;
 wire \u_conditioner/_036_ ;
 wire \u_conditioner/_037_ ;
 wire \u_conditioner/_038_ ;
 wire \u_conditioner/_039_ ;
 wire \u_conditioner/_040_ ;
 wire \u_conditioner/_041_ ;
 wire \u_conditioner/_042_ ;
 wire \u_conditioner/_043_ ;
 wire \u_conditioner/_044_ ;
 wire \u_conditioner/_045_ ;
 wire \u_conditioner/_046_ ;
 wire \u_conditioner/_047_ ;
 wire \u_conditioner/_048_ ;
 wire \u_conditioner/_049_ ;
 wire \u_conditioner/_050_ ;
 wire \u_conditioner/_051_ ;
 wire \u_conditioner/_052_ ;
 wire \u_conditioner/_053_ ;
 wire \u_conditioner/_054_ ;
 wire \u_conditioner/_055_ ;
 wire \u_conditioner/_056_ ;
 wire \u_conditioner/_057_ ;
 wire \u_conditioner/_058_ ;
 wire \u_conditioner/_059_ ;
 wire \u_conditioner/_060_ ;
 wire \u_conditioner/_061_ ;
 wire \u_conditioner/_062_ ;
 wire \u_conditioner/_063_ ;
 wire \u_conditioner/_064_ ;
 wire \u_conditioner/_065_ ;
 wire \u_conditioner/_066_ ;
 wire \u_conditioner/_067_ ;
 wire \u_conditioner/_068_ ;
 wire \u_conditioner/_069_ ;
 wire \u_conditioner/_070_ ;
 wire \u_conditioner/_071_ ;
 wire \u_conditioner/_072_ ;
 wire \u_conditioner/_073_ ;
 wire \u_conditioner/_074_ ;
 wire \u_conditioner/_075_ ;
 wire \u_conditioner/_076_ ;
 wire \u_conditioner/_077_ ;
 wire clknet_leaf_2_clk;
 wire \u_conditioner/_079_ ;
 wire \u_conditioner/_080_ ;
 wire \u_conditioner/_081_ ;
 wire \u_conditioner/_082_ ;
 wire \u_conditioner/_083_ ;
 wire \u_conditioner/_084_ ;
 wire \u_conditioner/_085_ ;
 wire \u_conditioner/_086_ ;
 wire \u_interface/net60 ;
 wire \u_conditioner/_088_ ;
 wire \u_conditioner/_089_ ;
 wire \u_health_test/net52 ;
 wire \u_conditioner/_091_ ;
 wire \u_conditioner/_092_ ;
 wire \u_conditioner/_093_ ;
 wire \u_conditioner/net67 ;
 wire \u_conditioner/_095_ ;
 wire \u_conditioner/net74 ;
 wire \u_conditioner/_097_ ;
 wire \u_conditioner/_098_ ;
 wire \u_conditioner/_099_ ;
 wire \u_conditioner/_100_ ;
 wire \u_conditioner/_101_ ;
 wire \u_conditioner/_102_ ;
 wire \u_conditioner/_103_ ;
 wire \u_interface/net63 ;
 wire \u_conditioner/net50 ;
 wire \u_conditioner/_106_ ;
 wire \u_conditioner/_107_ ;
 wire \u_conditioner/_108_ ;
 wire \u_conditioner/_109_ ;
 wire \u_conditioner/_110_ ;
 wire \u_conditioner/_111_ ;
 wire \u_conditioner/_112_ ;
 wire \u_conditioner/_113_ ;
 wire \u_conditioner/_114_ ;
 wire \u_conditioner/_115_ ;
 wire \u_conditioner/_116_ ;
 wire \u_conditioner/_117_ ;
 wire \u_conditioner/_118_ ;
 wire \u_conditioner/_119_ ;
 wire \u_conditioner/_120_ ;
 wire \u_conditioner/_121_ ;
 wire \u_conditioner/_122_ ;
 wire \u_conditioner/_123_ ;
 wire \u_conditioner/_124_ ;
 wire \u_conditioner/_125_ ;
 wire \u_conditioner/_126_ ;
 wire \u_conditioner/_127_ ;
 wire \u_conditioner/_128_ ;
 wire \u_conditioner/_129_ ;
 wire \u_conditioner/_130_ ;
 wire \u_conditioner/_131_ ;
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
 wire \u_ring_liveness/_022_ ;
 wire \u_ring_liveness/_023_ ;
 wire \u_ring_liveness/_024_ ;
 wire \u_ring_liveness/_025_ ;
 wire \u_ring_liveness/_026_ ;
 wire \u_ring_liveness/_027_ ;
 wire \u_ring_liveness/_028_ ;
 wire \u_ring_liveness/_029_ ;
 wire \u_ring_liveness/_030_ ;
 wire \u_ring_liveness/_031_ ;
 wire \u_ring_liveness/_032_ ;
 wire \u_ring_liveness/_033_ ;
 wire \u_ring_liveness/_034_ ;
 wire \u_ring_liveness/_035_ ;
 wire \u_ring_liveness/_036_ ;
 wire \u_ring_liveness/_037_ ;
 wire \u_ring_liveness/_038_ ;
 wire \u_ring_liveness/_039_ ;
 wire \u_ring_liveness/_040_ ;
 wire \u_ring_liveness/_041_ ;
 wire \u_ring_liveness/_042_ ;
 wire \u_ring_liveness/_043_ ;
 wire \u_ring_liveness/_044_ ;
 wire \u_ring_liveness/_045_ ;
 wire \u_ring_liveness/_046_ ;
 wire \u_ring_liveness/_047_ ;
 wire \u_ring_liveness/_048_ ;
 wire \u_ring_liveness/_049_ ;
 wire \u_ring_liveness/_050_ ;
 wire \u_ring_liveness/_051_ ;
 wire \u_ring_liveness/_052_ ;
 wire \u_ring_liveness/_053_ ;
 wire \u_ring_liveness/_054_ ;
 wire \u_ring_liveness/_055_ ;
 wire \u_ring_liveness/_056_ ;
 wire \u_ring_liveness/_057_ ;
 wire \u_ring_liveness/_058_ ;
 wire \u_ring_liveness/_059_ ;
 wire \u_ring_liveness/_060_ ;
 wire \u_ring_liveness/_061_ ;
 wire \u_ring_liveness/_062_ ;
 wire \u_ring_liveness/_063_ ;
 wire \u_ring_liveness/_064_ ;
 wire \u_ring_liveness/_065_ ;
 wire \u_ring_liveness/_066_ ;
 wire \u_ring_liveness/_067_ ;
 wire \u_ring_liveness/_068_ ;
 wire \u_ring_liveness/_069_ ;
 wire \u_ring_liveness/_070_ ;
 wire \u_ring_liveness/_071_ ;
 wire \u_ring_liveness/_072_ ;
 wire \u_ring_liveness/_073_ ;
 wire \u_ring_liveness/_074_ ;
 wire \u_ring_liveness/_075_ ;
 wire \u_ring_liveness/_076_ ;
 wire \u_ring_liveness/_077_ ;
 wire \u_ring_liveness/_078_ ;
 wire \u_health_test/net1 ;
 wire net2;
 wire net3;
 wire \u_conditioner/net4 ;
 wire net5;
 wire net6;
 wire \u_interface/net76 ;
 wire clknet_1_0__leaf_clk;
 wire clknet_1_1__leaf_clk;
 wire [31:0] cond_word;
 wire [1:0] ring_stuck;
 wire [7:0] \u_conditioner/count ;
 wire [31:0] \u_conditioner/state ;
 wire [10:0] \u_health_test/apt_match ;
 wire [10:0] \u_health_test/apt_pos ;
 wire [6:0] \u_health_test/rct_run ;
 wire [10:0] \u_health_test/startup_count ;
 wire [3:0] \u_interface/cond_count ;
 wire [0:0] \u_interface/cond_head ;
 wire [31:0] \u_interface/cond_mem[0] ;
 wire [31:0] \u_interface/cond_mem[1] ;
 wire [5:0] \u_interface/raw_bit_count ;
 wire [3:0] \u_interface/raw_count_w ;
 wire [0:0] \u_interface/raw_head ;
 wire [31:0] \u_interface/raw_mem[0] ;
 wire [31:0] \u_interface/raw_mem[1] ;
 wire [31:0] \u_interface/raw_shift ;
 wire [2:0] \u_interface/state ;
 wire [1:0] \u_ring_liveness/_000_ ;
 wire [1:0] \u_ring_liveness/ring_last_bit ;
 wire [6:0] \u_ring_liveness/ring_run[0] ;
 wire [6:0] \u_ring_liveness/ring_run[1] ;

 gf180mcu_fd_sc_mcu9t5v0__buf_4 clkbuf_0_clk (.I(clk),
    .Z(clknet_0_clk));
 gf180mcu_fd_sc_mcu9t5v0__buf_4 clkbuf_1_0__f_clk (.I(clknet_0_clk),
    .Z(clknet_1_0__leaf_clk));
 gf180mcu_fd_sc_mcu9t5v0__buf_4 clkbuf_1_1__f_clk (.I(clknet_0_clk),
    .Z(clknet_1_1__leaf_clk));
 gf180mcu_fd_sc_mcu9t5v0__buf_4 clkbuf_leaf_0_clk (.I(clknet_1_0__leaf_clk),
    .Z(clknet_leaf_0_clk));
 gf180mcu_fd_sc_mcu9t5v0__buf_4 clkbuf_leaf_10_clk (.I(clknet_1_1__leaf_clk),
    .Z(clknet_leaf_10_clk));
 gf180mcu_fd_sc_mcu9t5v0__buf_4 clkbuf_leaf_11_clk (.I(clknet_1_1__leaf_clk),
    .Z(clknet_leaf_11_clk));
 gf180mcu_fd_sc_mcu9t5v0__buf_4 clkbuf_leaf_12_clk (.I(clknet_1_1__leaf_clk),
    .Z(clknet_leaf_12_clk));
 gf180mcu_fd_sc_mcu9t5v0__buf_4 clkbuf_leaf_13_clk (.I(clknet_1_1__leaf_clk),
    .Z(clknet_leaf_13_clk));
 gf180mcu_fd_sc_mcu9t5v0__buf_4 clkbuf_leaf_14_clk (.I(clknet_1_1__leaf_clk),
    .Z(clknet_leaf_14_clk));
 gf180mcu_fd_sc_mcu9t5v0__buf_4 clkbuf_leaf_15_clk (.I(clknet_1_1__leaf_clk),
    .Z(clknet_leaf_15_clk));
 gf180mcu_fd_sc_mcu9t5v0__buf_4 clkbuf_leaf_16_clk (.I(clknet_1_1__leaf_clk),
    .Z(clknet_leaf_16_clk));
 gf180mcu_fd_sc_mcu9t5v0__buf_4 clkbuf_leaf_17_clk (.I(clknet_1_1__leaf_clk),
    .Z(clknet_leaf_17_clk));
 gf180mcu_fd_sc_mcu9t5v0__buf_4 clkbuf_leaf_18_clk (.I(clknet_1_1__leaf_clk),
    .Z(clknet_leaf_18_clk));
 gf180mcu_fd_sc_mcu9t5v0__buf_4 clkbuf_leaf_19_clk (.I(clknet_1_1__leaf_clk),
    .Z(clknet_leaf_19_clk));
 gf180mcu_fd_sc_mcu9t5v0__buf_4 clkbuf_leaf_1_clk (.I(clknet_1_0__leaf_clk),
    .Z(clknet_leaf_1_clk));
 gf180mcu_fd_sc_mcu9t5v0__buf_4 clkbuf_leaf_20_clk (.I(clknet_1_0__leaf_clk),
    .Z(clknet_leaf_20_clk));
 gf180mcu_fd_sc_mcu9t5v0__buf_4 clkbuf_leaf_21_clk (.I(clknet_1_0__leaf_clk),
    .Z(clknet_leaf_21_clk));
 gf180mcu_fd_sc_mcu9t5v0__buf_4 clkbuf_leaf_22_clk (.I(clknet_1_0__leaf_clk),
    .Z(clknet_leaf_22_clk));
 gf180mcu_fd_sc_mcu9t5v0__buf_4 clkbuf_leaf_2_clk (.I(clknet_1_0__leaf_clk),
    .Z(clknet_leaf_2_clk));
 gf180mcu_fd_sc_mcu9t5v0__buf_4 clkbuf_leaf_3_clk (.I(clknet_1_0__leaf_clk),
    .Z(clknet_leaf_3_clk));
 gf180mcu_fd_sc_mcu9t5v0__buf_4 clkbuf_leaf_4_clk (.I(clknet_1_0__leaf_clk),
    .Z(clknet_leaf_4_clk));
 gf180mcu_fd_sc_mcu9t5v0__buf_4 clkbuf_leaf_5_clk (.I(clknet_1_0__leaf_clk),
    .Z(clknet_leaf_5_clk));
 gf180mcu_fd_sc_mcu9t5v0__buf_4 clkbuf_leaf_6_clk (.I(clknet_1_0__leaf_clk),
    .Z(clknet_leaf_6_clk));
 gf180mcu_fd_sc_mcu9t5v0__buf_4 clkbuf_leaf_7_clk (.I(clknet_1_0__leaf_clk),
    .Z(clknet_leaf_7_clk));
 gf180mcu_fd_sc_mcu9t5v0__buf_4 clkbuf_leaf_8_clk (.I(clknet_1_0__leaf_clk),
    .Z(clknet_leaf_8_clk));
 gf180mcu_fd_sc_mcu9t5v0__buf_4 clkbuf_leaf_9_clk (.I(clknet_1_1__leaf_clk),
    .Z(clknet_leaf_9_clk));
 gf180mcu_fd_sc_mcu9t5v0__buf_4 clkload0 (.I(clknet_1_1__leaf_clk));
 gf180mcu_fd_sc_mcu9t5v0__clkinv_1 clkload1 (.I(clknet_leaf_0_clk));
 gf180mcu_fd_sc_mcu9t5v0__clkinv_3 clkload10 (.I(clknet_leaf_21_clk));
 gf180mcu_fd_sc_mcu9t5v0__inv_4 clkload11 (.I(clknet_leaf_22_clk));
 gf180mcu_fd_sc_mcu9t5v0__inv_3 clkload12 (.I(clknet_leaf_9_clk));
 gf180mcu_fd_sc_mcu9t5v0__clkinv_1 clkload13 (.I(clknet_leaf_10_clk));
 gf180mcu_fd_sc_mcu9t5v0__clkinv_1 clkload14 (.I(clknet_leaf_12_clk));
 gf180mcu_fd_sc_mcu9t5v0__clkinv_1 clkload15 (.I(clknet_leaf_13_clk));
 gf180mcu_fd_sc_mcu9t5v0__clkinv_2 clkload16 (.I(clknet_leaf_14_clk));
 gf180mcu_fd_sc_mcu9t5v0__clkinv_2 clkload17 (.I(clknet_leaf_15_clk));
 gf180mcu_fd_sc_mcu9t5v0__clkinv_3 clkload18 (.I(clknet_leaf_16_clk));
 gf180mcu_fd_sc_mcu9t5v0__inv_3 clkload19 (.I(clknet_leaf_17_clk));
 gf180mcu_fd_sc_mcu9t5v0__inv_3 clkload2 (.I(clknet_leaf_1_clk));
 gf180mcu_fd_sc_mcu9t5v0__clkinv_1 clkload20 (.I(clknet_leaf_18_clk));
 gf180mcu_fd_sc_mcu9t5v0__clkinv_1 clkload21 (.I(clknet_leaf_19_clk));
 gf180mcu_fd_sc_mcu9t5v0__clkinv_2 clkload3 (.I(clknet_leaf_2_clk));
 gf180mcu_fd_sc_mcu9t5v0__clkinv_1 clkload4 (.I(clknet_leaf_3_clk));
 gf180mcu_fd_sc_mcu9t5v0__clkinv_1 clkload5 (.I(clknet_leaf_4_clk));
 gf180mcu_fd_sc_mcu9t5v0__clkinv_1 clkload6 (.I(clknet_leaf_5_clk));
 gf180mcu_fd_sc_mcu9t5v0__clkinv_2 clkload7 (.I(clknet_leaf_7_clk));
 gf180mcu_fd_sc_mcu9t5v0__inv_4 clkload8 (.I(clknet_leaf_8_clk));
 gf180mcu_fd_sc_mcu9t5v0__clkinv_3 clkload9 (.I(clknet_leaf_20_clk));
 gf180mcu_fd_sc_mcu9t5v0__clkbuf_12 max_cap2 (.I(net41),
    .Z(net2));
 gf180mcu_fd_sc_mcu9t5v0__clkbuf_12 max_cap3 (.I(net6),
    .Z(net3));
 gf180mcu_fd_sc_mcu9t5v0__buf_8 max_cap41 (.I(net3),
    .Z(net41));
 gf180mcu_fd_sc_mcu9t5v0__buf_8 max_cap42 (.I(net5),
    .Z(net42));
 gf180mcu_fd_sc_mcu9t5v0__clkbuf_12 max_cap5 (.I(rst_n),
    .Z(net5));
 gf180mcu_fd_sc_mcu9t5v0__clkbuf_12 max_cap6 (.I(rst_n),
    .Z(net6));
 gf180mcu_fd_sc_mcu9t5v0__clkinv_1 \u_conditioner/_181_  (.I(raw_valid),
    .ZN(\u_conditioner/_073_ ));
 gf180mcu_fd_sc_mcu9t5v0__clkinv_1 \u_conditioner/_182_  (.I(\u_conditioner/count [7]),
    .ZN(\u_conditioner/_074_ ));
 gf180mcu_fd_sc_mcu9t5v0__nand3_2 \u_conditioner/_183_  (.A1(\u_conditioner/count [6]),
    .A2(\u_conditioner/count [1]),
    .A3(\u_conditioner/count [0]),
    .ZN(\u_conditioner/_075_ ));
 gf180mcu_fd_sc_mcu9t5v0__nand4_4 \u_conditioner/_184_  (.A1(\u_conditioner/count [2]),
    .A2(\u_conditioner/count [3]),
    .A3(\u_conditioner/count [4]),
    .A4(\u_conditioner/count [5]),
    .ZN(\u_conditioner/_076_ ));
 gf180mcu_fd_sc_mcu9t5v0__or3_4 \u_conditioner/_185_  (.A1(\u_conditioner/_074_ ),
    .A2(\u_conditioner/_075_ ),
    .A3(\u_conditioner/_076_ ),
    .Z(\u_conditioner/_077_ ));
 gf180mcu_fd_sc_mcu9t5v0__clkinv_1 \u_conditioner/_187_  (.I(cond_en),
    .ZN(\u_conditioner/_079_ ));
 gf180mcu_fd_sc_mcu9t5v0__or2_1 \u_conditioner/_188_  (.A1(\u_conditioner/_079_ ),
    .A2(cond_flush),
    .Z(\u_conditioner/_080_ ));
 gf180mcu_fd_sc_mcu9t5v0__nor3_4 \u_conditioner/_189_  (.A1(\u_conditioner/_073_ ),
    .A2(\u_conditioner/_077_ ),
    .A3(\u_conditioner/net50 ),
    .ZN(\u_conditioner/_081_ ));
 gf180mcu_fd_sc_mcu9t5v0__mux2_2 \u_conditioner/_191_  (.I0(cond_word[3]),
    .I1(\u_conditioner/state [4]),
    .S(\u_conditioner/net74 ),
    .Z(\u_conditioner/_001_ ));
 gf180mcu_fd_sc_mcu9t5v0__mux2_2 \u_conditioner/_192_  (.I0(cond_word[2]),
    .I1(\u_conditioner/state [3]),
    .S(\u_conditioner/net74 ),
    .Z(\u_conditioner/_002_ ));
 gf180mcu_fd_sc_mcu9t5v0__mux2_2 \u_conditioner/_193_  (.I0(cond_word[1]),
    .I1(\u_conditioner/state [2]),
    .S(\u_conditioner/net74 ),
    .Z(\u_conditioner/_003_ ));
 gf180mcu_fd_sc_mcu9t5v0__mux2_2 \u_conditioner/_194_  (.I0(cond_word[0]),
    .I1(\u_conditioner/state [1]),
    .S(\u_conditioner/net74 ),
    .Z(\u_conditioner/_004_ ));
 gf180mcu_fd_sc_mcu9t5v0__and4_1 \u_conditioner/_195_  (.A1(\u_conditioner/count [2]),
    .A2(\u_conditioner/count [1]),
    .A3(\u_conditioner/count [0]),
    .A4(raw_valid),
    .Z(\u_conditioner/_082_ ));
 gf180mcu_fd_sc_mcu9t5v0__and3_1 \u_conditioner/_196_  (.A1(\u_conditioner/count [3]),
    .A2(\u_conditioner/count [4]),
    .A3(\u_conditioner/_082_ ),
    .Z(\u_conditioner/_083_ ));
 gf180mcu_fd_sc_mcu9t5v0__aoi21_1 \u_conditioner/_197_  (.A1(\u_conditioner/count [5]),
    .A2(\u_conditioner/_083_ ),
    .B(\u_conditioner/count [6]),
    .ZN(\u_conditioner/_084_ ));
 gf180mcu_fd_sc_mcu9t5v0__or2_1 \u_conditioner/_198_  (.A1(\u_conditioner/_075_ ),
    .A2(\u_conditioner/_076_ ),
    .Z(\u_conditioner/_085_ ));
 gf180mcu_fd_sc_mcu9t5v0__nor2_2 \u_conditioner/_199_  (.A1(\u_conditioner/_079_ ),
    .A2(cond_flush),
    .ZN(\u_conditioner/_086_ ));
 gf180mcu_fd_sc_mcu9t5v0__oai21_1 \u_conditioner/_201_  (.A1(\u_conditioner/_073_ ),
    .A2(\u_conditioner/_085_ ),
    .B(\u_conditioner/net49 ),
    .ZN(\u_conditioner/_088_ ));
 gf180mcu_fd_sc_mcu9t5v0__nor2_1 \u_conditioner/_202_  (.A1(\u_conditioner/_084_ ),
    .A2(\u_conditioner/_088_ ),
    .ZN(\u_conditioner/_005_ ));
 gf180mcu_fd_sc_mcu9t5v0__nor3_1 \u_conditioner/_203_  (.A1(\u_conditioner/_079_ ),
    .A2(cond_flush),
    .A3(raw_valid),
    .ZN(\u_conditioner/_089_ ));
 gf180mcu_fd_sc_mcu9t5v0__nand2_1 \u_conditioner/_205_  (.A1(\u_conditioner/state [30]),
    .A2(\u_conditioner/net48 ),
    .ZN(\u_conditioner/_091_ ));
 gf180mcu_fd_sc_mcu9t5v0__buf_1 \u_conditioner/_206_  (.I(raw_valid),
    .Z(\u_conditioner/_092_ ));
 gf180mcu_fd_sc_mcu9t5v0__clkbuf_1 \u_conditioner/_207_  (.I(\u_conditioner/_092_ ),
    .Z(\u_conditioner/_093_ ));
 gf180mcu_fd_sc_mcu9t5v0__xnor2_1 \u_conditioner/_209_  (.A1(\u_conditioner/state [0]),
    .A2(raw_bit),
    .ZN(\u_conditioner/_095_ ));
 gf180mcu_fd_sc_mcu9t5v0__xnor2_1 \u_conditioner/_211_  (.A1(\u_conditioner/state [31]),
    .A2(\u_conditioner/net67 ),
    .ZN(\u_conditioner/_097_ ));
 gf180mcu_fd_sc_mcu9t5v0__nand4_1 \u_conditioner/_212_  (.A1(\u_conditioner/_093_ ),
    .A2(\u_conditioner/_077_ ),
    .A3(\u_conditioner/net49 ),
    .A4(\u_conditioner/_097_ ),
    .ZN(\u_conditioner/_098_ ));
 gf180mcu_fd_sc_mcu9t5v0__nand2_1 \u_conditioner/_213_  (.A1(\u_conditioner/_091_ ),
    .A2(\u_conditioner/_098_ ),
    .ZN(\u_conditioner/_006_ ));
 gf180mcu_fd_sc_mcu9t5v0__nand2_1 \u_conditioner/_214_  (.A1(\u_conditioner/state [29]),
    .A2(\u_conditioner/net48 ),
    .ZN(\u_conditioner/_099_ ));
 gf180mcu_fd_sc_mcu9t5v0__xnor2_1 \u_conditioner/_215_  (.A1(\u_conditioner/state [30]),
    .A2(\u_conditioner/net67 ),
    .ZN(\u_conditioner/_100_ ));
 gf180mcu_fd_sc_mcu9t5v0__nand4_1 \u_conditioner/_216_  (.A1(\u_conditioner/_093_ ),
    .A2(\u_conditioner/_077_ ),
    .A3(\u_conditioner/net49 ),
    .A4(\u_conditioner/_100_ ),
    .ZN(\u_conditioner/_101_ ));
 gf180mcu_fd_sc_mcu9t5v0__nand2_1 \u_conditioner/_217_  (.A1(\u_conditioner/_099_ ),
    .A2(\u_conditioner/_101_ ),
    .ZN(\u_conditioner/_007_ ));
 gf180mcu_fd_sc_mcu9t5v0__clkinv_1 \u_conditioner/_218_  (.I(\u_conditioner/state [29]),
    .ZN(\u_conditioner/_102_ ));
 gf180mcu_fd_sc_mcu9t5v0__nand3_2 \u_conditioner/_219_  (.A1(raw_valid),
    .A2(\u_conditioner/_077_ ),
    .A3(\u_conditioner/net49 ),
    .ZN(\u_conditioner/_103_ ));
 gf180mcu_fd_sc_mcu9t5v0__nand2_1 \u_conditioner/_222_  (.A1(\u_conditioner/state [28]),
    .A2(\u_conditioner/net48 ),
    .ZN(\u_conditioner/_106_ ));
 gf180mcu_fd_sc_mcu9t5v0__oai21_1 \u_conditioner/_223_  (.A1(\u_conditioner/_102_ ),
    .A2(\u_conditioner/_103_ ),
    .B(\u_conditioner/_106_ ),
    .ZN(\u_conditioner/_008_ ));
 gf180mcu_fd_sc_mcu9t5v0__nand2_1 \u_conditioner/_224_  (.A1(\u_conditioner/state [27]),
    .A2(\u_conditioner/net48 ),
    .ZN(\u_conditioner/_107_ ));
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
 gf180mcu_fd_sc_mcu9t5v0__clkinv_1 \u_conditioner/_304_  (.I(\u_conditioner/state [2]),
    .ZN(\u_conditioner/_162_ ));
 gf180mcu_fd_sc_mcu9t5v0__oai32_1 \u_conditioner/_305_  (.A1(\u_conditioner/_162_ ),
    .A2(\u_conditioner/_092_ ),
    .A3(\u_conditioner/net50 ),
    .B1(\u_conditioner/_103_ ),
    .B2(\u_conditioner/_161_ ),
    .ZN(\u_conditioner/_034_ ));
 gf180mcu_fd_sc_mcu9t5v0__clkinv_1 \u_conditioner/_306_  (.I(\u_conditioner/state [1]),
    .ZN(\u_conditioner/_163_ ));
 gf180mcu_fd_sc_mcu9t5v0__oai32_1 \u_conditioner/_307_  (.A1(\u_conditioner/_163_ ),
    .A2(\u_conditioner/_119_ ),
    .A3(\u_conditioner/net50 ),
    .B1(\u_conditioner/_103_ ),
    .B2(\u_conditioner/_162_ ),
    .ZN(\u_conditioner/_035_ ));
 gf180mcu_fd_sc_mcu9t5v0__nand2_1 \u_conditioner/_308_  (.A1(\u_conditioner/state [0]),
    .A2(\u_conditioner/net48 ),
    .ZN(\u_conditioner/_164_ ));
 gf180mcu_fd_sc_mcu9t5v0__oai21_1 \u_conditioner/_309_  (.A1(\u_conditioner/_163_ ),
    .A2(\u_conditioner/_103_ ),
    .B(\u_conditioner/_164_ ),
    .ZN(\u_conditioner/_036_ ));
 gf180mcu_fd_sc_mcu9t5v0__oai21_1 \u_conditioner/_310_  (.A1(\u_conditioner/count [5]),
    .A2(\u_conditioner/_083_ ),
    .B(\u_conditioner/net49 ),
    .ZN(\u_conditioner/_165_ ));
 gf180mcu_fd_sc_mcu9t5v0__aoi21_1 \u_conditioner/_311_  (.A1(\u_conditioner/count [5]),
    .A2(\u_conditioner/_083_ ),
    .B(\u_conditioner/_165_ ),
    .ZN(\u_conditioner/_037_ ));
 gf180mcu_fd_sc_mcu9t5v0__aoi21_1 \u_conditioner/_312_  (.A1(\u_conditioner/count [3]),
    .A2(\u_conditioner/_082_ ),
    .B(\u_conditioner/count [4]),
    .ZN(\u_conditioner/_166_ ));
 gf180mcu_fd_sc_mcu9t5v0__nor3_1 \u_conditioner/_313_  (.A1(\u_conditioner/net50 ),
    .A2(\u_conditioner/_083_ ),
    .A3(\u_conditioner/_166_ ),
    .ZN(\u_conditioner/_038_ ));
 gf180mcu_fd_sc_mcu9t5v0__nor2_1 \u_conditioner/_314_  (.A1(\u_conditioner/count [3]),
    .A2(\u_conditioner/_082_ ),
    .ZN(\u_conditioner/_167_ ));
 gf180mcu_fd_sc_mcu9t5v0__nand2_1 \u_conditioner/_315_  (.A1(\u_conditioner/count [3]),
    .A2(\u_conditioner/_082_ ),
    .ZN(\u_conditioner/_168_ ));
 gf180mcu_fd_sc_mcu9t5v0__nand2_1 \u_conditioner/_316_  (.A1(\u_conditioner/net49 ),
    .A2(\u_conditioner/_168_ ),
    .ZN(\u_conditioner/_169_ ));
 gf180mcu_fd_sc_mcu9t5v0__nor2_1 \u_conditioner/_317_  (.A1(\u_conditioner/_167_ ),
    .A2(\u_conditioner/_169_ ),
    .ZN(\u_conditioner/_039_ ));
 gf180mcu_fd_sc_mcu9t5v0__and3_1 \u_conditioner/_318_  (.A1(\u_conditioner/count [1]),
    .A2(\u_conditioner/count [0]),
    .A3(\u_conditioner/_092_ ),
    .Z(\u_conditioner/_170_ ));
 gf180mcu_fd_sc_mcu9t5v0__nor2_1 \u_conditioner/_319_  (.A1(\u_conditioner/count [2]),
    .A2(\u_conditioner/_170_ ),
    .ZN(\u_conditioner/_171_ ));
 gf180mcu_fd_sc_mcu9t5v0__nor3_1 \u_conditioner/_320_  (.A1(\u_conditioner/net50 ),
    .A2(\u_conditioner/_082_ ),
    .A3(\u_conditioner/_171_ ),
    .ZN(\u_conditioner/_040_ ));
 gf180mcu_fd_sc_mcu9t5v0__aoi21_1 \u_conditioner/_321_  (.A1(\u_conditioner/count [0]),
    .A2(\u_conditioner/_092_ ),
    .B(\u_conditioner/count [1]),
    .ZN(\u_conditioner/_172_ ));
 gf180mcu_fd_sc_mcu9t5v0__nor3_1 \u_conditioner/_322_  (.A1(\u_conditioner/net50 ),
    .A2(\u_conditioner/_170_ ),
    .A3(\u_conditioner/_172_ ),
    .ZN(\u_conditioner/_041_ ));
 gf180mcu_fd_sc_mcu9t5v0__xnor2_1 \u_conditioner/_323_  (.A1(\u_conditioner/count [0]),
    .A2(\u_conditioner/_092_ ),
    .ZN(\u_conditioner/_173_ ));
 gf180mcu_fd_sc_mcu9t5v0__nor2_1 \u_conditioner/_324_  (.A1(\u_conditioner/net50 ),
    .A2(\u_conditioner/_173_ ),
    .ZN(\u_conditioner/_042_ ));
 gf180mcu_fd_sc_mcu9t5v0__mux2_2 \u_conditioner/_325_  (.I0(cond_word[30]),
    .I1(\u_conditioner/_097_ ),
    .S(\u_conditioner/net74 ),
    .Z(\u_conditioner/_043_ ));
 gf180mcu_fd_sc_mcu9t5v0__mux2_2 \u_conditioner/_326_  (.I0(cond_word[29]),
    .I1(\u_conditioner/_100_ ),
    .S(\u_conditioner/net46 ),
    .Z(\u_conditioner/_044_ ));
 gf180mcu_fd_sc_mcu9t5v0__mux2_2 \u_conditioner/_328_  (.I0(cond_word[28]),
    .I1(\u_conditioner/state [29]),
    .S(\u_conditioner/net46 ),
    .Z(\u_conditioner/_045_ ));
 gf180mcu_fd_sc_mcu9t5v0__mux2_2 \u_conditioner/_329_  (.I0(cond_word[27]),
    .I1(\u_conditioner/_108_ ),
    .S(\u_conditioner/net46 ),
    .Z(\u_conditioner/_046_ ));
 gf180mcu_fd_sc_mcu9t5v0__mux2_2 \u_conditioner/_330_  (.I0(cond_word[26]),
    .I1(\u_conditioner/_111_ ),
    .S(\u_conditioner/net46 ),
    .Z(\u_conditioner/_047_ ));
 gf180mcu_fd_sc_mcu9t5v0__mux2_2 \u_conditioner/_331_  (.I0(cond_word[25]),
    .I1(\u_conditioner/state [26]),
    .S(\u_conditioner/net46 ),
    .Z(\u_conditioner/_048_ ));
 gf180mcu_fd_sc_mcu9t5v0__mux2_2 \u_conditioner/_332_  (.I0(cond_word[24]),
    .I1(\u_conditioner/_116_ ),
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
 gf180mcu_fd_sc_mcu9t5v0__dffrnq_1 \u_conditioner/_429_  (.D(\u_conditioner/_039_ ),
    .RN(\u_conditioner/net40 ),
    .CLK(clknet_leaf_17_clk),
    .Q(\u_conditioner/count [3]));
 gf180mcu_fd_sc_mcu9t5v0__dffrnq_1 \u_conditioner/_430_  (.D(\u_conditioner/_038_ ),
    .RN(\u_conditioner/net40 ),
    .CLK(clknet_leaf_17_clk),
    .Q(\u_conditioner/count [4]));
 gf180mcu_fd_sc_mcu9t5v0__dffrnq_1 \u_conditioner/_431_  (.D(\u_conditioner/_037_ ),
    .RN(\u_conditioner/net4 ),
    .CLK(clknet_leaf_16_clk),
    .Q(\u_conditioner/count [5]));
 gf180mcu_fd_sc_mcu9t5v0__dffrnq_1 \u_conditioner/_432_  (.D(\u_conditioner/_005_ ),
    .RN(\u_conditioner/net4 ),
    .CLK(clknet_leaf_16_clk),
    .Q(\u_conditioner/count [6]));
 gf180mcu_fd_sc_mcu9t5v0__dffrnq_1 \u_conditioner/_433_  (.D(\u_conditioner/_071_ ),
    .RN(\u_conditioner/net4 ),
    .CLK(clknet_leaf_16_clk),
    .Q(\u_conditioner/count [7]));
 gf180mcu_fd_sc_mcu9t5v0__dffrnq_1 \u_conditioner/_434_  (.D(\u_conditioner/net46 ),
    .RN(net42),
    .CLK(clknet_leaf_9_clk),
    .Q(cond_valid));
 gf180mcu_fd_sc_mcu9t5v0__clkbuf_12 \u_conditioner/max_cap4  (.I(net5),
    .Z(\u_conditioner/net4 ));
 gf180mcu_fd_sc_mcu9t5v0__buf_8 \u_conditioner/max_cap40  (.I(\u_conditioner/net4 ),
    .Z(\u_conditioner/net40 ));
 gf180mcu_fd_sc_mcu9t5v0__clkbuf_12 \u_conditioner/max_cap74  (.I(\u_conditioner/net46 ),
    .Z(\u_conditioner/net74 ));
 gf180mcu_fd_sc_mcu9t5v0__buf_8 \u_conditioner/place46  (.I(\u_conditioner/_081_ ),
    .Z(\u_conditioner/net46 ));
 gf180mcu_fd_sc_mcu9t5v0__buf_8 \u_conditioner/place48  (.I(\u_conditioner/_089_ ),
    .Z(\u_conditioner/net48 ));
 gf180mcu_fd_sc_mcu9t5v0__buf_8 \u_conditioner/place49  (.I(\u_conditioner/_086_ ),
    .Z(\u_conditioner/net49 ));
 gf180mcu_fd_sc_mcu9t5v0__buf_8 \u_conditioner/place50  (.I(\u_conditioner/_080_ ),
    .Z(\u_conditioner/net50 ));
 gf180mcu_fd_sc_mcu9t5v0__buf_8 \u_conditioner/place67  (.I(\u_conditioner/_095_ ),
    .Z(\u_conditioner/net67 ));
 gf180mcu_fd_sc_mcu9t5v0__clkinv_1 \u_health_test/_201_  (.I(\u_health_test/rct_run [4]),
    .ZN(\u_health_test/_192_ ));
 gf180mcu_fd_sc_mcu9t5v0__oai21_1 \u_health_test/_202_  (.A1(\u_health_test/rct_run [5]),
    .A2(\u_health_test/rct_run [4]),
    .B(\u_health_test/rct_run [6]),
    .ZN(\u_health_test/_193_ ));
 gf180mcu_fd_sc_mcu9t5v0__and4_1 \u_health_test/_203_  (.A1(\u_health_test/rct_run [3]),
    .A2(\u_health_test/rct_run [2]),
    .A3(\u_health_test/rct_run [0]),
    .A4(\u_health_test/rct_run [1]),
    .Z(\u_health_test/_194_ ));
 gf180mcu_fd_sc_mcu9t5v0__nand2_1 \u_health_test/_204_  (.A1(\u_health_test/_193_ ),
    .A2(\u_health_test/_194_ ),
    .ZN(\u_health_test/_195_ ));
 gf180mcu_fd_sc_mcu9t5v0__nor3_1 \u_health_test/_205_  (.A1(\u_health_test/rct_run [3]),
    .A2(\u_health_test/rct_run [2]),
    .A3(\u_health_test/rct_run [1]),
    .ZN(\u_health_test/_196_ ));
 gf180mcu_fd_sc_mcu9t5v0__nor4_1 \u_health_test/_206_  (.A1(\u_health_test/rct_run [0]),
    .A2(\u_health_test/rct_run [5]),
    .A3(\u_health_test/rct_run [4]),
    .A4(\u_health_test/rct_run [6]),
    .ZN(\u_health_test/_197_ ));
 gf180mcu_fd_sc_mcu9t5v0__xor2_1 \u_health_test/_207_  (.A1(raw_bit),
    .A2(\u_health_test/rct_last_bit ),
    .Z(\u_health_test/_198_ ));
 gf180mcu_fd_sc_mcu9t5v0__aoi21_1 \u_health_test/_208_  (.A1(\u_health_test/_196_ ),
    .A2(\u_health_test/_197_ ),
    .B(\u_health_test/_198_ ),
    .ZN(\u_health_test/_199_ ));
 gf180mcu_fd_sc_mcu9t5v0__nand3_1 \u_health_test/_209_  (.A1(\u_health_test/rct_run [4]),
    .A2(\u_health_test/_193_ ),
    .A3(\u_health_test/_194_ ),
    .ZN(\u_health_test/_200_ ));
 gf180mcu_fd_sc_mcu9t5v0__nand2_1 \u_health_test/_210_  (.A1(\u_health_test/_199_ ),
    .A2(\u_health_test/_200_ ),
    .ZN(\u_health_test/_045_ ));
 gf180mcu_fd_sc_mcu9t5v0__aoi21_1 \u_health_test/_211_  (.A1(\u_health_test/_192_ ),
    .A2(\u_health_test/_195_ ),
    .B(\u_health_test/_045_ ),
    .ZN(\u_health_test/_046_ ));
 gf180mcu_fd_sc_mcu9t5v0__clkinv_1 \u_health_test/_212_  (.I(\u_health_test/rct_run [3]),
    .ZN(\u_health_test/_047_ ));
 gf180mcu_fd_sc_mcu9t5v0__and3_1 \u_health_test/_213_  (.A1(\u_health_test/rct_run [0]),
    .A2(\u_health_test/rct_run [1]),
    .A3(\u_health_test/_193_ ),
    .Z(\u_health_test/_048_ ));
 gf180mcu_fd_sc_mcu9t5v0__nand2_1 \u_health_test/_214_  (.A1(\u_health_test/rct_run [2]),
    .A2(\u_health_test/_048_ ),
    .ZN(\u_health_test/_049_ ));
 gf180mcu_fd_sc_mcu9t5v0__nand2_1 \u_health_test/_215_  (.A1(\u_health_test/_047_ ),
    .A2(\u_health_test/_049_ ),
    .ZN(\u_health_test/_050_ ));
 gf180mcu_fd_sc_mcu9t5v0__nand3_1 \u_health_test/_216_  (.A1(\u_health_test/_195_ ),
    .A2(\u_health_test/_199_ ),
    .A3(\u_health_test/_050_ ),
    .ZN(\u_health_test/_051_ ));
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
    .A3(\u_health_test/startup_count [5]),
    .A4(\u_health_test/startup_count [6]),
    .ZN(\u_health_test/_107_ ));
 gf180mcu_fd_sc_mcu9t5v0__or4_1 \u_health_test/_275_  (.A1(\u_health_test/_101_ ),
    .A2(\u_health_test/_105_ ),
    .A3(\u_health_test/_106_ ),
    .A4(\u_health_test/_107_ ),
    .Z(\u_health_test/_108_ ));
 gf180mcu_fd_sc_mcu9t5v0__and4_1 \u_health_test/_276_  (.A1(\u_health_test/_046_ ),
    .A2(\u_health_test/_051_ ),
    .A3(\u_health_test/_053_ ),
    .A4(\u_health_test/_062_ ),
    .Z(\u_health_test/_109_ ));
 gf180mcu_fd_sc_mcu9t5v0__aoi211_1 \u_health_test/_277_  (.A1(\u_health_test/_095_ ),
    .A2(\u_health_test/_100_ ),
    .B(\u_health_test/_108_ ),
    .C(\u_health_test/_109_ ),
    .ZN(\u_health_test/_002_ ));
 gf180mcu_fd_sc_mcu9t5v0__nand2_1 \u_health_test/_278_  (.A1(\u_health_test/_199_ ),
    .A2(\u_health_test/_104_ ),
    .ZN(\u_health_test/_110_ ));
 gf180mcu_fd_sc_mcu9t5v0__nand2_1 \u_health_test/_279_  (.A1(raw_valid),
    .A2(\u_health_test/_045_ ),
    .ZN(\u_health_test/_111_ ));
 gf180mcu_fd_sc_mcu9t5v0__nand3_1 \u_health_test/_280_  (.A1(\u_health_test/rct_run [5]),
    .A2(\u_health_test/_064_ ),
    .A3(\u_health_test/_111_ ),
    .ZN(\u_health_test/_112_ ));
 gf180mcu_fd_sc_mcu9t5v0__oai31_1 \u_health_test/_281_  (.A1(\u_health_test/rct_run [5]),
    .A2(\u_health_test/_200_ ),
    .A3(\u_health_test/_110_ ),
    .B(\u_health_test/_112_ ),
    .ZN(\u_health_test/_003_ ));
 gf180mcu_fd_sc_mcu9t5v0__nor2_2 \u_health_test/_282_  (.A1(startup_req),
    .A2(raw_valid),
    .ZN(\u_health_test/_113_ ));
 gf180mcu_fd_sc_mcu9t5v0__aoi22_1 \u_health_test/_283_  (.A1(\u_health_test/_046_ ),
    .A2(\u_health_test/_104_ ),
    .B1(\u_health_test/net56 ),
    .B2(\u_health_test/rct_run [4]),
    .ZN(\u_health_test/_114_ ));
 gf180mcu_fd_sc_mcu9t5v0__clkinv_1 \u_health_test/_284_  (.I(\u_health_test/_114_ ),
    .ZN(\u_health_test/_004_ ));
 gf180mcu_fd_sc_mcu9t5v0__nand2_1 \u_health_test/_285_  (.A1(\u_health_test/_064_ ),
    .A2(\u_health_test/_103_ ),
    .ZN(\u_health_test/_115_ ));
 gf180mcu_fd_sc_mcu9t5v0__oai22_1 \u_health_test/_286_  (.A1(\u_health_test/_051_ ),
    .A2(\u_health_test/_065_ ),
    .B1(\u_health_test/net52 ),
    .B2(\u_health_test/_047_ ),
    .ZN(\u_health_test/_005_ ));
 gf180mcu_fd_sc_mcu9t5v0__nand2_1 \u_health_test/_288_  (.A1(\u_health_test/rct_run [2]),
    .A2(\u_health_test/net56 ),
    .ZN(\u_health_test/_117_ ));
 gf180mcu_fd_sc_mcu9t5v0__oai21_1 \u_health_test/_289_  (.A1(\u_health_test/_053_ ),
    .A2(\u_health_test/_065_ ),
    .B(\u_health_test/_117_ ),
    .ZN(\u_health_test/_006_ ));
 gf180mcu_fd_sc_mcu9t5v0__aoi21_1 \u_health_test/_290_  (.A1(\u_health_test/rct_run [0]),
    .A2(\u_health_test/_193_ ),
    .B(\u_health_test/rct_run [1]),
    .ZN(\u_health_test/_118_ ));
 gf180mcu_fd_sc_mcu9t5v0__nand2_1 \u_health_test/_291_  (.A1(\u_health_test/rct_run [1]),
    .A2(\u_health_test/net56 ),
    .ZN(\u_health_test/_119_ ));
 gf180mcu_fd_sc_mcu9t5v0__oai31_1 \u_health_test/_292_  (.A1(\u_health_test/_048_ ),
    .A2(\u_health_test/_118_ ),
    .A3(\u_health_test/_110_ ),
    .B(\u_health_test/_119_ ),
    .ZN(\u_health_test/_007_ ));
 gf180mcu_fd_sc_mcu9t5v0__nand2_1 \u_health_test/_293_  (.A1(\u_health_test/rct_run [0]),
    .A2(\u_health_test/net56 ),
    .ZN(\u_health_test/_120_ ));
 gf180mcu_fd_sc_mcu9t5v0__clkinv_1 \u_health_test/_294_  (.I(\u_health_test/_199_ ),
    .ZN(\u_health_test/_121_ ));
 gf180mcu_fd_sc_mcu9t5v0__oai21_1 \u_health_test/_295_  (.A1(\u_health_test/_121_ ),
    .A2(\u_health_test/_056_ ),
    .B(\u_health_test/_104_ ),
    .ZN(\u_health_test/_122_ ));
 gf180mcu_fd_sc_mcu9t5v0__nand2_1 \u_health_test/_296_  (.A1(\u_health_test/_120_ ),
    .A2(\u_health_test/_122_ ),
    .ZN(\u_health_test/_008_ ));
 gf180mcu_fd_sc_mcu9t5v0__nor2_1 \u_health_test/_297_  (.A1(\u_health_test/apt_pos [10]),
    .A2(\u_health_test/_068_ ),
    .ZN(\u_health_test/_123_ ));
 gf180mcu_fd_sc_mcu9t5v0__nor2_1 \u_health_test/_298_  (.A1(\u_health_test/_065_ ),
    .A2(\u_health_test/_123_ ),
    .ZN(\u_health_test/_124_ ));
 gf180mcu_fd_sc_mcu9t5v0__nand2_1 \u_health_test/_299_  (.A1(\u_health_test/net65 ),
    .A2(\u_health_test/_124_ ),
    .ZN(\u_health_test/_125_ ));
 gf180mcu_fd_sc_mcu9t5v0__nand2_1 \u_health_test/_300_  (.A1(\u_health_test/apt_match [8]),
    .A2(\u_health_test/net56 ),
    .ZN(\u_health_test/_126_ ));
 gf180mcu_fd_sc_mcu9t5v0__oai31_1 \u_health_test/_301_  (.A1(\u_health_test/_088_ ),
    .A2(\u_health_test/_090_ ),
    .A3(\u_health_test/_125_ ),
    .B(\u_health_test/_126_ ),
    .ZN(\u_health_test/_009_ ));
 gf180mcu_fd_sc_mcu9t5v0__clkinv_1 \u_health_test/_302_  (.I(\u_health_test/_082_ ),
    .ZN(\u_health_test/_127_ ));
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
 gf180mcu_fd_sc_mcu9t5v0__xnor2_1 \u_health_test/_363_  (.A1(\u_health_test/startup_count [0]),
    .A2(\u_health_test/_149_ ),
    .ZN(\u_health_test/_169_ ));
 gf180mcu_fd_sc_mcu9t5v0__aoi21_1 \u_health_test/_364_  (.A1(\u_health_test/net52 ),
    .A2(\u_health_test/_146_ ),
    .B(\u_health_test/_169_ ),
    .ZN(\u_health_test/_029_ ));
 gf180mcu_fd_sc_mcu9t5v0__xnor2_1 \u_health_test/_365_  (.A1(\u_health_test/apt_match [9]),
    .A2(\u_health_test/_088_ ),
    .ZN(\u_health_test/_170_ ));
 gf180mcu_fd_sc_mcu9t5v0__nand2_1 \u_health_test/_366_  (.A1(\u_health_test/apt_match [9]),
    .A2(\u_health_test/net56 ),
    .ZN(\u_health_test/_171_ ));
 gf180mcu_fd_sc_mcu9t5v0__oai21_1 \u_health_test/_367_  (.A1(\u_health_test/_125_ ),
    .A2(\u_health_test/_170_ ),
    .B(\u_health_test/_171_ ),
    .ZN(\u_health_test/_030_ ));
 gf180mcu_fd_sc_mcu9t5v0__nor3_1 \u_health_test/_368_  (.A1(\u_health_test/_096_ ),
    .A2(\u_health_test/_103_ ),
    .A3(\u_health_test/_097_ ),
    .ZN(\u_health_test/_172_ ));
 gf180mcu_fd_sc_mcu9t5v0__and2_1 \u_health_test/_369_  (.A1(\u_health_test/apt_pos [8]),
    .A2(\u_health_test/_172_ ),
    .Z(\u_health_test/_173_ ));
 gf180mcu_fd_sc_mcu9t5v0__aoi21_1 \u_health_test/_370_  (.A1(\u_health_test/apt_pos [9]),
    .A2(\u_health_test/_173_ ),
    .B(startup_req),
    .ZN(\u_health_test/_174_ ));
 gf180mcu_fd_sc_mcu9t5v0__oai21_1 \u_health_test/_371_  (.A1(\u_health_test/apt_pos [9]),
    .A2(\u_health_test/_173_ ),
    .B(\u_health_test/_174_ ),
    .ZN(\u_health_test/_175_ ));
 gf180mcu_fd_sc_mcu9t5v0__clkinv_1 \u_health_test/_372_  (.I(\u_health_test/_175_ ),
    .ZN(\u_health_test/_031_ ));
 gf180mcu_fd_sc_mcu9t5v0__oai21_1 \u_health_test/_373_  (.A1(\u_health_test/apt_pos [8]),
    .A2(\u_health_test/_172_ ),
    .B(\u_health_test/_064_ ),
    .ZN(\u_health_test/_176_ ));
 gf180mcu_fd_sc_mcu9t5v0__nor2_1 \u_health_test/_374_  (.A1(\u_health_test/_173_ ),
    .A2(\u_health_test/_176_ ),
    .ZN(\u_health_test/_032_ ));
 gf180mcu_fd_sc_mcu9t5v0__nand2_1 \u_health_test/_375_  (.A1(raw_valid),
    .A2(\u_health_test/_067_ ),
    .ZN(\u_health_test/_177_ ));
 gf180mcu_fd_sc_mcu9t5v0__aoi211_1 \u_health_test/_376_  (.A1(\u_health_test/_096_ ),
    .A2(\u_health_test/_177_ ),
    .B(\u_health_test/_172_ ),
    .C(startup_req),
    .ZN(\u_health_test/_033_ ));
 gf180mcu_fd_sc_mcu9t5v0__and2_1 \u_health_test/_377_  (.A1(raw_valid),
    .A2(\u_health_test/_066_ ),
    .Z(\u_health_test/_178_ ));
 gf180mcu_fd_sc_mcu9t5v0__nand3_1 \u_health_test/_378_  (.A1(\u_health_test/apt_pos [4]),
    .A2(\u_health_test/apt_pos [5]),
    .A3(\u_health_test/_178_ ),
    .ZN(\u_health_test/_179_ ));
 gf180mcu_fd_sc_mcu9t5v0__xor2_1 \u_health_test/_379_  (.A1(\u_health_test/apt_pos [6]),
    .A2(\u_health_test/_179_ ),
    .Z(\u_health_test/_180_ ));
 gf180mcu_fd_sc_mcu9t5v0__nor2_1 \u_health_test/_380_  (.A1(startup_req),
    .A2(\u_health_test/_180_ ),
    .ZN(\u_health_test/_034_ ));
 gf180mcu_fd_sc_mcu9t5v0__aoi21_1 \u_health_test/_381_  (.A1(\u_health_test/apt_pos [4]),
    .A2(\u_health_test/_178_ ),
    .B(\u_health_test/apt_pos [5]),
    .ZN(\u_health_test/_181_ ));
 gf180mcu_fd_sc_mcu9t5v0__nand2_1 \u_health_test/_382_  (.A1(\u_health_test/_064_ ),
    .A2(\u_health_test/_179_ ),
    .ZN(\u_health_test/_182_ ));
 gf180mcu_fd_sc_mcu9t5v0__nor2_1 \u_health_test/_383_  (.A1(\u_health_test/_181_ ),
    .A2(\u_health_test/_182_ ),
    .ZN(\u_health_test/_035_ ));
 gf180mcu_fd_sc_mcu9t5v0__and2_1 \u_health_test/_384_  (.A1(\u_health_test/apt_pos [10]),
    .A2(\u_health_test/_174_ ),
    .Z(\u_health_test/_036_ ));
 gf180mcu_fd_sc_mcu9t5v0__nor2_1 \u_health_test/_385_  (.A1(\u_health_test/_065_ ),
    .A2(\u_health_test/net65 ),
    .ZN(\u_health_test/_183_ ));
 gf180mcu_fd_sc_mcu9t5v0__mux2_1 \u_health_test/_386_  (.I0(\u_health_test/apt_ref_bit ),
    .I1(raw_bit),
    .S(\u_health_test/_183_ ),
    .Z(\u_health_test/_037_ ));
 gf180mcu_fd_sc_mcu9t5v0__mux2_1 \u_health_test/_387_  (.I0(raw_bit),
    .I1(\u_health_test/rct_last_bit ),
    .S(\u_health_test/_065_ ),
    .Z(\u_health_test/_038_ ));
 gf180mcu_fd_sc_mcu9t5v0__nand2_1 \u_health_test/_388_  (.A1(\u_health_test/startup_count [9]),
    .A2(\u_health_test/_154_ ),
    .ZN(\u_health_test/_184_ ));
 gf180mcu_fd_sc_mcu9t5v0__aoi22_2 \u_health_test/_389_  (.A1(\u_health_test/net52 ),
    .A2(\u_health_test/_146_ ),
    .B1(\u_health_test/_184_ ),
    .B2(\u_health_test/_102_ ),
    .ZN(\u_health_test/_039_ ));
 gf180mcu_fd_sc_mcu9t5v0__xnor2_1 \u_health_test/_390_  (.A1(\u_health_test/apt_pos [4]),
    .A2(\u_health_test/_178_ ),
    .ZN(\u_health_test/_185_ ));
 gf180mcu_fd_sc_mcu9t5v0__nor2_1 \u_health_test/_391_  (.A1(startup_req),
    .A2(\u_health_test/_185_ ),
    .ZN(\u_health_test/_040_ ));
 gf180mcu_fd_sc_mcu9t5v0__nand2_1 \u_health_test/_392_  (.A1(\u_health_test/apt_pos [0]),
    .A2(\u_health_test/apt_pos [1]),
    .ZN(\u_health_test/_186_ ));
 gf180mcu_fd_sc_mcu9t5v0__nor2_1 \u_health_test/_393_  (.A1(\u_health_test/_103_ ),
    .A2(\u_health_test/_186_ ),
    .ZN(\u_health_test/_187_ ));
 gf180mcu_fd_sc_mcu9t5v0__and2_1 \u_health_test/_394_  (.A1(\u_health_test/apt_pos [2]),
    .A2(\u_health_test/_187_ ),
    .Z(\u_health_test/_188_ ));
 gf180mcu_fd_sc_mcu9t5v0__nor2_1 \u_health_test/_395_  (.A1(\u_health_test/apt_pos [3]),
    .A2(\u_health_test/_188_ ),
    .ZN(\u_health_test/_189_ ));
 gf180mcu_fd_sc_mcu9t5v0__nor3_1 \u_health_test/_396_  (.A1(startup_req),
    .A2(\u_health_test/_178_ ),
    .A3(\u_health_test/_189_ ),
    .ZN(\u_health_test/_041_ ));
 gf180mcu_fd_sc_mcu9t5v0__nor2_1 \u_health_test/_397_  (.A1(\u_health_test/apt_pos [2]),
    .A2(\u_health_test/_187_ ),
    .ZN(\u_health_test/_190_ ));
 gf180mcu_fd_sc_mcu9t5v0__nor3_1 \u_health_test/_398_  (.A1(startup_req),
    .A2(\u_health_test/_188_ ),
    .A3(\u_health_test/_190_ ),
    .ZN(\u_health_test/_042_ ));
 gf180mcu_fd_sc_mcu9t5v0__aoi22_1 \u_health_test/_399_  (.A1(\u_health_test/_104_ ),
    .A2(\u_health_test/_186_ ),
    .B1(\u_health_test/net56 ),
    .B2(\u_health_test/apt_pos [1]),
    .ZN(\u_health_test/_191_ ));
 gf180mcu_fd_sc_mcu9t5v0__nor2_1 \u_health_test/_400_  (.A1(\u_health_test/_071_ ),
    .A2(\u_health_test/_191_ ),
    .ZN(\u_health_test/_043_ ));
 gf180mcu_fd_sc_mcu9t5v0__mux2_1 \u_health_test/_401_  (.I0(\u_health_test/_104_ ),
    .I1(\u_health_test/net56 ),
    .S(\u_health_test/apt_pos [0]),
    .Z(\u_health_test/_044_ ));
 gf180mcu_fd_sc_mcu9t5v0__dffrnq_1 \u_health_test/_402_  (.D(\u_health_test/_008_ ),
    .RN(net2),
    .CLK(clknet_leaf_20_clk),
    .Q(\u_health_test/rct_run [0]));
 gf180mcu_fd_sc_mcu9t5v0__dffrnq_1 \u_health_test/_403_  (.D(\u_health_test/_007_ ),
    .RN(net2),
    .CLK(clknet_leaf_20_clk),
    .Q(\u_health_test/rct_run [1]));
 gf180mcu_fd_sc_mcu9t5v0__dffrnq_1 \u_health_test/_404_  (.D(\u_health_test/_006_ ),
    .RN(net2),
    .CLK(clknet_leaf_20_clk),
    .Q(\u_health_test/rct_run [2]));
 gf180mcu_fd_sc_mcu9t5v0__dffrnq_1 \u_health_test/_405_  (.D(\u_health_test/_005_ ),
    .RN(net2),
    .CLK(clknet_leaf_20_clk),
    .Q(\u_health_test/rct_run [3]));
 gf180mcu_fd_sc_mcu9t5v0__dffrnq_1 \u_health_test/_406_  (.D(\u_health_test/_004_ ),
    .RN(net2),
    .CLK(clknet_leaf_20_clk),
    .Q(\u_health_test/rct_run [4]));
 gf180mcu_fd_sc_mcu9t5v0__dffrnq_1 \u_health_test/_407_  (.D(\u_health_test/_003_ ),
    .RN(net2),
    .CLK(clknet_leaf_19_clk),
    .Q(\u_health_test/rct_run [5]));
 gf180mcu_fd_sc_mcu9t5v0__dffrnq_1 \u_health_test/_408_  (.D(\u_health_test/_021_ ),
    .RN(net2),
    .CLK(clknet_leaf_20_clk),
    .Q(\u_health_test/rct_run [6]));
 gf180mcu_fd_sc_mcu9t5v0__dffrnq_1 \u_health_test/_409_  (.D(\u_health_test/_044_ ),
    .RN(\u_health_test/net1 ),
    .CLK(clknet_leaf_20_clk),
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
    .RN(\u_health_test/net1 ),
    .CLK(clknet_leaf_22_clk),
    .Q(\u_health_test/apt_match [0]));
 gf180mcu_fd_sc_mcu9t5v0__dffrnq_1 \u_health_test/_434_  (.D(\u_health_test/_016_ ),
    .RN(\u_health_test/net1 ),
    .CLK(clknet_leaf_22_clk),
    .Q(\u_health_test/apt_match [1]));
 gf180mcu_fd_sc_mcu9t5v0__dffrnq_1 \u_health_test/_435_  (.D(\u_health_test/_015_ ),
    .RN(\u_health_test/net1 ),
    .CLK(clknet_leaf_22_clk),
    .Q(\u_health_test/apt_match [2]));
 gf180mcu_fd_sc_mcu9t5v0__dffrnq_1 \u_health_test/_436_  (.D(\u_health_test/_014_ ),
    .RN(\u_health_test/net1 ),
    .CLK(clknet_leaf_21_clk),
    .Q(\u_health_test/apt_match [3]));
 gf180mcu_fd_sc_mcu9t5v0__dffrnq_1 \u_health_test/_437_  (.D(\u_health_test/_013_ ),
    .RN(\u_health_test/net1 ),
    .CLK(clknet_leaf_21_clk),
    .Q(\u_health_test/apt_match [4]));
 gf180mcu_fd_sc_mcu9t5v0__dffrnq_1 \u_health_test/_438_  (.D(\u_health_test/_012_ ),
    .RN(\u_health_test/net1 ),
    .CLK(clknet_leaf_21_clk),
    .Q(\u_health_test/apt_match [5]));
 gf180mcu_fd_sc_mcu9t5v0__dffrnq_1 \u_health_test/_439_  (.D(\u_health_test/_011_ ),
    .RN(\u_health_test/net1 ),
    .CLK(clknet_leaf_21_clk),
    .Q(\u_health_test/apt_match [6]));
 gf180mcu_fd_sc_mcu9t5v0__dffrnq_1 \u_health_test/_440_  (.D(\u_health_test/_010_ ),
    .RN(\u_health_test/net1 ),
    .CLK(clknet_leaf_22_clk),
    .Q(\u_health_test/apt_match [7]));
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
