2AMLogic/gf180-trng/layout/digital/build.py

#!/usr/bin/env python3
"""Drive the digital section's synthesized netlist through `klt
place-and-route` against gf180mcu, check what came back, and commit it.

    python3 layout/digital/build.py            # run P&R, check, write the report
    python3 layout/digital/build.py --drc-only # re-check the COMMITTED GDS only
    python3 layout/digital/build.py --check-input  # recorded input hash vs design/ netlist

This is issue #111's own bring-up: `design/trng_top/trng_top.synth.v`
(`design/synth.py`, #143 -- 2505 standard-cell instances mapped against
`gf180mcu_fd_sc_mcu9t5v0`) driven through `klt place-and-route`
(klayout-tools#629/#631 -- OpenROAD under the hood) as far as the tool gets,
followed by this script's own checks over the artefacts it returns. Per the
issue's own framing, **an explicit, measured failure is a complete outcome of
this script**, not a bug in it: `main()` records whatever `klt
place-and-route` actually reports, including a documented failure, rather
than only handling the success path.

What is committed, and what is gated behind a check
-------------------------------------------------
`klt place-and-route` returns three artefacts. This script commits all three,
the third only when `_gds_geometry_check` below passes:

- **`trng_top.def`** -- the routed DEF, OpenROAD's own output, carrying both
  signal routing and (since #171) a `SPECIALNETS` power grid. Committed.
- **`trng_top.pnr.v`** -- the *as-built* gate-level netlist (`write_verilog`
  after CTS, resizing and antenna-diode insertion), which is what a
  post-route gate-level simulation (#147) or a golden-reference LVS run has
  to use as its reference rather than `klt synthesize`'s pre-CTS netlist.
  The tapcell/endcap/filler instances #171 inserts are deliberately *not* in
  it (`write_verilog -remove_cells`) -- they carry no logical function, and
  `_component_check` below subtracts them from the DEF side before comparing
  the two. Committed.
- **`trng_top.gds`** -- the DEF merged with the standard cells' own GDS
  views. `_gds_geometry_check` below compares the merged stream's own extent
  against the DEF's own `DIEAREA`, and only commits the GDS (plus runs `klt
  drc` over it, gated behind the same check) when the ratio is 1:1. From
  when this script was first written until #170, that check always failed:
  every DEF-derived shape (placement coordinates, routing, vias) came out at
  exactly 2x its true size while the standard-cell geometry stayed at 1x, so
  the cells sat on a stretched grid that no longer abutted its own power
  rails -- a database-unit defect in the DEF->GDS merge, reproduced in eight
  lines and filed generically upstream as klayout-tools#1090 (see
  `layout/digital/README.md`'s "Two defects this bring-up found" section).
  Fixed upstream by klayout-tools#1114; this repository re-pinned `klt` past
  that fix in #170, and the GDS (plus `klt drc`'s report) has been committed
  since.

Why this differs from `design/synth.py`'s shape
-------------------------------------------------
`design/synth.py` doubles as a CI staleness guard (`--check`, wired into
`.github/workflows/pdk-nightly.yml`) because Yosys's mapped netlist is
byte-reproducible for the same RTL + liberty (verified empirically in that
script's own docstring). Place-and-route has no equivalent claim: OpenROAD's
global placement and detailed routing are seeded but not guaranteed
bit-identical run to run, even with `seed` held fixed, across different
`openroad` builds, thread counts or host architectures. So this script has
no `--check` mode -- there is no meaningful "is the committed result stale"
question to ask of a stochastic build step the way there is for a
deterministic synthesis pass. What is committed is the result of one
recorded run, with enough provenance (`openroad` version + pinned Docker
image digest, `klt` version, resolved PDK, liberty corner, `seed`) that a
different run can be compared against it, not assumed identical to it.

What *can* be checked cheaply is the report's recorded **input**: `--check-input`
re-hashes `design/trng_top/trng_top.synth.v` and compares it with
`reports/place_and_route.json`'s `provenance.input.content_hash` (#293 -- PR
#292 re-synthesized the netlist and nothing noticed that the committed
implementation still descended from the old one). It does not claim the
placement is reproducible, only that the netlist it was built from is the one
in `design/`.

OpenROAD provisioning
----------------------
`klt place-and-route` shells out to `openroad` as a subprocess -- it is not
a Python dependency of `klt` the way `klayout`'s own bindings are.
`openroad` has no Homebrew formula and no common Linux-distro package, so
this script falls back to `layout/openroad_docker.sh` (the pinned
`openroad/orfs` Docker image) whenever a native `openroad` is not already on
`$PATH` -- see that script's own header and `layout/digital/README.md`'s
"OpenROAD" section for the pinned version and digest.

What this is not
------------------
Not signoff timing and not a finished physical implementation.
`worst_slack_ns`/`fmax_mhz` are OpenROAD's own pre-signoff STA over an
ideal, SDC-only clock with global-routing-estimated parasitics -- no
extraction, no SPEF. `floorplan.utilization_pct` and `clock_period_ns` below
are this run's own inputs, not ratified spec targets. The flow does now
build a real power distribution network (`POWER` below, #171): `tapcell`,
`add_global_connection`/`global_connect`, `pdngen` and a post-route
`filler_placement` all run, so the standard cells' `VDD`/`VSS` pins are
wired to named `vddd`/`vss` nets, the DEF carries a `SPECIALNETS` section
with real rail and strap geometry, and row gaps are filled. What that is
still not is a *system*-level PDN: this is a standalone place-and-route of
the digital section alone, whose netlist contains no entropy-ring instance,
port or supply net of any kind, so composing this block's own supply pin
onto the chip's star point -- `layout/floorplan/README.md`'s mitigation 2 --
remains that floorplan's job and not this script's. `_power_isolation_check`
below is what this script can check from here, and says so precisely.
Corner characterization (Fmax/area/power across the corner set) is #145's
job, not this script's; a post-route gate-level functional re-run is #147's.
`layout/digital/README.md` states all of this at length, including what a
reader may and may not cite from the committed report.
"""

from __future__ import annotations

import argparse
import json
import os
import re
import shutil
import sys
import tempfile
from pathlib import Path

REPO_ROOT = Path(__file__).resolve().parent.parent.parent
DIGITAL_DIR = REPO_ROOT / "layout" / "digital"
REPORTS_DIR = DIGITAL_DIR / "reports"

#: `klt place-and-route`'s scratch directory. Deliberately **under**
#: `layout/.work/` (the same gitignored scratch root `layout/verify.py`
#: uses) rather than the system tempdir: `layout/openroad_docker.sh` bind-
#: mounts `$(pwd)` (== `REPO_ROOT`, since `_run_klt` runs `klt` with
#: `cwd=REPO_ROOT`, and `openroad` inherits that cwd as its own subprocess
#: of `klt`) into the container at the identical absolute path, so every
#: absolute path OpenROAD's generated Tcl scripts reference (the request's
#: own `.klt/place-and-route/` output directory among them) must resolve
#: *inside* that mount -- the system tempdir (`/tmp/...` on Linux) does not.
WORK_DIR = REPO_ROOT / "layout" / ".work" / "place-and-route"

sys.path.insert(0, str(REPO_ROOT))

from layout._klt import (  # noqa: E402
    FlowError,
    _run_klt,
    klt_origin,
    klt_version,
    normalise_gds,
    resolve_pdk,
)

#: The already-committed, already-synthesized digital-section netlist
#: (design/synth.py, #143) -- read-only input to this script.
NETLIST_PATH = REPO_ROOT / "design" / "trng_top" / "trng_top.synth.v"
HDL_TOPLEVEL = "trng_top"

#: Same standard-cell library `design/synth.py` synthesized against -- NOT
#: sky130 (klayout-tools#629, resolved upstream via klayout-tools#631).
CELL_LIBRARY = "gf180mcu_fd_sc_mcu9t5v0"

#: The liberty corner every stage of this run is timed against, named
#: explicitly rather than left to `klt`'s own nominal-corner resolution.
#:
#: This library is characterised at three separate supplies (1.8 V, 3.3 V
#: and 5.0 V, 15 `.lib` files in all), and `klt`'s nominal pick is
#: documented to return the **lowest** of them -- `tt_025C_1v80`. This block
#: does not run at 1.8 V: `design/README.md` calls 3.3 V "the block's
#: ratified supply", and the raw-rate row's own binding corner
#: ([DR-0003](../../spec/decision-records/DR-0003-throughput-defined-at-the-raw-tap.md))
#: is `ss` / -10 % supply / +125 degC. `ss_125C_3v00` is this library's
#: closest shipped deck to exactly that corner (slow process, 3.00 V =
#: 3.3 V - 10 %, 125 degC), so it is the corner this run implements and
#: reports against. `design/synth.py` (#143, #169) pins its own liberty
#: corner explicitly too -- `tt_025C_3v30`, deliberately *not* this corner;
#: see `layout/digital/README.md`'s "Corners" section for why a pre-place
#: synthesis mapping step and this timing-closing P&R run land on different
#: decks on purpose.
CORNER = "ss_125C_3v00"

#: Floorplan/IO/constraint inputs for this run. None of these is a ratified
#: spec value -- see the module docstring's "What this is not".
#:
#: - `site`/`layer_h`/`layer_v`: ORFS's own `platforms/gf180/config.mk`
#:   reference values for `gf180mcu_fd_sc_mcu9t5v0` (`PLACE_SITE ?=
#:   GF018hv5v_green_sc9` for the `9t` track option, `IO_PLACER_H/V ?=
#:   Metal3/Metal4`), chosen so this request mirrors a real gf180 platform
#:   run rather than carrying sky130's site/layer names under a gf180mcu
#:   label.
#: - `utilization_pct`/`aspect_ratio`/`core_margin_um`: a conservative
#:   starting point at this scale (2505 instances, 708 flip-flops, two
#:   8x32-bit output FIFOs among the wide structures) -- low enough
#:   utilization to leave routing headroom for a first attempt whose
#:   question is whether this design routes at all, not how small the die
#:   can be. The die area that falls out is a consequence of this number and
#:   must not be read as an area result; `layout/digital/README.md`'s "Area"
#:   section says what may be compared against the floorplan estimate.
#: - `clock_period_ns`: 50 ns (20 MHz). No issue in this repository has set
#:   a digital-section Fmax requirement, but the ratified raw-rate row
#:   (README.md, DR-0003) needs > 1 Mbps sustained at the sampler output --
#:   one raw bit per `clk` edge, so > 1 MHz, with the stretch row at
#:   > 4 MHz. 20 MHz is 5-20x that, chosen so the timing-driven placement,
#:   CTS and routing stages have a target with real headroom to optimize
#:   toward; the reported slack is against *this* constraint, not against a
#:   spec row.
FLOORPLAN = {
    "method": "utilization",
    "utilization_pct": 40,
    "aspect_ratio": 1.0,
    "core_margin_um": 10.0,
    "site": "GF018hv5v_green_sc9",
}
IO = {"layer_h": "Metal3", "layer_v": "Metal4"}

#: Power delivery for this run -- `klt place-and-route`'s optional
#: `request.power` block (klayout-tools#1091, shipped as
#: klayout-tools#1120, which this repository's own `klt` pin moves to in
#: #171). Before it existed, this flow's generated Tcl never called
#: `global_connect`/`pdngen` and inserted no tapcells, endcaps or filler
#: cells: the routed DEF carried no `SPECIALNETS` section at all, recorded
#: in the committed report as `checks.def.special_nets: false` (see
#: `layout/digital/README.md`'s "Two defects this bring-up found" #2).
#:
#: - `power_net`/`ground_net`: `vddd`/`vss`, deliberately **not** `klt`'s
#:   own `VDD`/`VSS` defaults. `vddd` is the digital domain's supply name
#:   everywhere else in this repository -- `layout/floorplan/floorplan.py`'s
#:   own region table and `layout/floorplan/README.md`'s four-domain star --
#:   and a routed DEF whose `SPECIALNETS` said `VDD` would be a block that
#:   cannot be composed onto that star without a rename. This does not
#:   rename the *cells'* pins: the standard cells' LEF power/ground pins
#:   stay `VDD`/`VSS`, and `add_global_connection -pin_pattern` maps from
#:   those fixed pin names onto whichever net name this request asks for.
#: - `straps`: this platform's own production PDN grid, copied
#:   layer-for-layer (net names aside) from
#:   `The-OpenROAD-Project/OpenROAD-flow-scripts` @ `master`,
#:   `flow/platforms/gf180/openROAD/pdn/pdn_grid_strategy_9t_6M.cfg`
#:   (read 2026-08-17) -- the `9t`/6-metal strategy matching this run's own
#:   `site: "GF018hv5v_green_sc9"` (9-track) and the `Metal2`-`Metal5`
#:   routing range `klt` resolves for this cell library. Bottom to top:
#:   `Metal1` follows the standard-cell rows (`followpins`) at the site's
#:   own 5.04 um rail pitch; `Metal4`/`Metal5` are the upper-metal strap
#:   grid. Two deviations from that config, both because `klt`'s
#:   `straps[]` does not expose the fields: its `Metal4` stripe also sets
#:   `-spacing 0.56` (a paired-stripe spacing), and its two
#:   `add_pdn_connect` calls carry `-max_columns`/`-ongrid`/`-split_cuts`
#:   via tuning. `klt` emits plain `add_pdn_connect` between each
#:   consecutive strap pair instead. The resulting geometry is checked, not
#:   assumed: `klt drc` over the merged GDS is run below and its verdict
#:   committed to `reports/drc.json`.
POWER = {
    "power_net": "vddd",
    "ground_net": "vss",
    "straps": [
        {"layer": "Metal1", "width_um": 0.9, "pitch_um": 5.04, "followpins": True},
        {"layer": "Metal4", "width_um": 4.48, "pitch_um": 44.8, "offset_um": 22.4},
        {"layer": "Metal5", "width_um": 4.48, "pitch_um": 89.6, "offset_um": 44.8},
    ],
}

#: The timing constraints this run is placed and routed against.
#:
#: **`max_transition_ns`/`max_capacitance_pf` are stated here, and that is a
#: recorded decision (#237, #240, #264), not always the case.** #237 found
#: the `FIFO_DEPTH = 8` routed DEF this script used to commit violating the
#: library's own `max_transition` at nine of the fifteen corners
#: `sim/tb/digital-sta-power/run_sta.py` sweeps -- four high-fanout nets
#: inside `u_interface`/`u_conditioner` -- and #240 landed the
#: `max_transition_ns: 8.0`/`max_capacitance_pf: 0.35` pair below (via two
#: rebuilds: a naive `10.0` ns guess proved insufficient once re-measured,
#: `8.0` ns cleared it) once klayout-tools#1860 (merged 2026-09-15) made
#: `set_max_transition`/`set_max_capacitance` expressible through
#: `repair_design` at all. See `sim/characterization-digital-sta-area-power.md`
#: section 2a and `sim/tb/digital-sta-power/max_transition_probe.py` (the
#: per-net decomposition tool both #240 and #264 below used) for the full
#: depth-8 derivation.
#:
#: **#255's `FIFO_DEPTH = 2` re-synthesis and re-place-and-route reused that
#: same `8.0`/`0.35` pair unchanged, and it did not carry over: the depth-2
#: DEF's different net topology violated `max_transition` at eleven of the
#: fifteen corners** (worse than the nine #237 found), on two nets, not
#: four -- `net4` (42 pins, driven by a `dlyd_1` delay cell) and
#: `u_interface/_0519_` (33 pins, driven by an `and4_1` gate). Neither is the
#: design's own highest-fanout net at that constraint (`net1`, 50 loads, was
#: clean at every corner) -- the same "fanout does not predict the
#: violation" reading #240's derivation reached at depth 8, reached again
#: independently at depth 2.
#:
#: **#264 re-derived the constraint for the depth-2 topology and landed on
#: `max_transition_ns: 4.0`.** `max_transition_probe.py`'s
#: `pnr_corner_target` computed a naive required figure of 10.99 ns
#: (binding at `ff_125C_3v60`/`rc-min`) from the violating DEF's own
#: cross-corner slews -- but that DEF's own P&R corner (`ss_125C_3v00`)
#: already measured a worst slew of 14.1 ns against the *existing* `8.0` ns
#: target, meaning the gap between what `repair_design` is handed and what
#: the fully-extracted DEF measures is wider for these two nets than it was
#: for depth-8's four, and the naive figure could not be trusted without
#: rebuilding against it and re-measuring. Rather than iterate the naive
#: figure down as #240 did (`10.0` -> `8.0` ns), this rebuild went straight
#: to the family's own tightest corner limit (`ff_n40C_3v60`, 4.4 ns) and
#: cleared on the first attempt: the re-minted fifteen-corner sweep reports
#: `max_slew_violations: 0` at every corner, confirmed independently by
#: `sim/tb/digital-sta-power/max_transition_probe.py --check`, at a modest
#: area cost (+3.7 % placed cell area, +30 logical instances; `repair_design`
#: applies the target design-wide, so that buffering is not confined to the
#: two named nets).
#:
#: **`max_capacitance_pf: 0.35`** is stated alongside it, but is not shown to
#: be the lever that clears the `max_capacitance` violations on either
#: topology measured so far: the library's own per-pin `max_capacitance`
#: limit (an attribute of whichever driving cell ends up worst, not a single
#: corner-wide number) measures well under 0.35 pF at every corner of the
#: #264 rebuild (roughly 0.09-0.15 pF, per `max_transition_probe.py`'s own
#: per-corner table) -- so it is the same slew-driven buffering that clears
#: `max_transition` which clears `max_capacitance` too, as a byproduct, not
#: because this value bound anything. It is kept stated rather than dropped:
#: it costs nothing today, and it is the knob `repair_design` would have to
#: use if a future net violated `max_capacitance` without a `max_transition`
#: violation alongside it. The rebuilt DEF's own measured
#: `max_capacitance_violations` (0 at every corner, not this comment) is
#: the actual answer for this run. (`reports/place_and_route.json`'s own
#: per-corner `max_capacitance_violation_count` is a different check: it
#: compares against this 0.35 pF value, not the library limit. It flags 1-3
#: buffers that `repair_design` inserted itself, driving 0.35-0.38 pF. See
#: `sim/characterization-digital-sta-area-power.md` section 0a.)
#:
#: `design/synth.py` cannot state either constraint on this script's behalf:
#: `klt synthesize`'s `request.constraints` still reads exactly one field,
#: `clock_period_ns` (ABC's `-D` delay target, unaffected by #1860, which
#: only touches `place-and-route`), and the `abc -constr` file it writes is
#: two fixed lines from `klt`'s own per-library table. That is the right
#: place for the gap to stay, though -- the violation is a placement and
#: drive-strength outcome, and `repair_design` is where the flow first has
#: the parasitics to repair it.
#:
#: A `set_max_fanout` is *separately* not wanted, on this library's own
#: evidence rather than on availability: `gf180mcu_fd_sc_mcu9t5v0` declares no
#: `default_max_fanout` and no per-pin `max_fanout` at all, and at both
#: depths measured so far the design's highest-fanout net was clean while a
#: lower-fanout net violated (depth 8: `rst_n` at 201 loads clean, a 13-load
#: net violated at seven corners; depth 2, pre-#264: `net1` at 50 loads
#: clean, `net4` at 42 loads violated at every corner). Fanout does not
#: predict the violation; load capacitance against drive strength does,
#: which is what `max_transition`/`max_capacitance` measure directly. (The
#: buffering each rebuild's own `max_transition_ns` triggers touches more
#: than the originally-violating nets alone -- #240's depth-8 rebuild also
#: reshaped `rst_n`; #264's depth-2 rebuild lands on yet another worst-fanout
#: net, `u_interface/net71` at 38 loads -- a topology side effect of each
#: fix, not a change to this reasoning.)
CONSTRAINTS = {
    "clock_port": "clk",
    "clock_period_ns": 50.0,
    "max_transition_ns": 4.0,
    "max_capacitance_pf": 0.35,
}
SEED = 1
TARGET_STAGE = "route"

#: How far the merged GDS's own extent may differ from the DEF's own
#: `DIEAREA` before `_gds_geometry_check` calls it a mismatch. The GDS
#: legitimately overhangs the die by the standard cells' own well/implant
#: margins (0.43 um per side for this library), which is well inside this
#: tolerance at a ~550 um die; the defect it is there to catch is a factor
#: of two.
GDS_EXTENT_TOLERANCE_PCT = 5.0

REPORT_PATH = REPORTS_DIR / "place_and_route.json"
DRC_REPORT_PATH = REPORTS_DIR / "drc.json"
DEF_PATH = DIGITAL_DIR / f"{HDL_TOPLEVEL}.def"
GDS_PATH = DIGITAL_DIR / f"{HDL_TOPLEVEL}.gds"
PNR_NETLIST_PATH = DIGITAL_DIR / f"{HDL_TOPLEVEL}.pnr.v"

DECK = "gf180mcu"

EXIT_OK = 0
EXIT_ENVIRONMENT = 3
EXIT_FLOW_FAILURE = 4


class PrError(RuntimeError):
    """A place-and-route run could not even be attempted."""


def _openroad_on_path() -> bool:
    return shutil.which("openroad") is not None


def _ensure_openroad_reachable() -> list[str]:
    """Return human-readable reasons `openroad` cannot be reached, or `[]`.

    Mutates `os.environ["PATH"]` (this process only, inherited by every
    subprocess it spawns -- including `klt`'s own `openroad` subprocess
    call) to prepend a directory containing an `openroad` shim pointed at
    `layout/openroad_docker.sh`, if and only if no native `openroad` is
    already on `$PATH` and `docker` is available. Never overrides a native
    `openroad` -- a real local install always wins.
    """
    if _openroad_on_path():
        return []
    if shutil.which("docker") is None:
        return [
            "openroad is not on PATH and docker is not on PATH either -- "
            "see layout/digital/README.md's 'OpenROAD' section"
        ]
    shim_dir = Path(tempfile.mkdtemp(prefix="klt-openroad-shim-"))
    shim = shim_dir / "openroad"
    shim.symlink_to(REPO_ROOT / "layout" / "openroad_docker.sh")
    os.environ["PATH"] = f"{shim_dir}{os.pathsep}{os.environ.get('PATH', '')}"
    return []


def _check_environment() -> list[str]:
    missing = []
    if klt_version() is None:
        missing.append("klayout-tools (`klt`) is not on PATH")
    if resolve_pdk() is None:
        missing.append("no gf180mcu PDK install found (see sim/harness/pdk.py)")
    if not NETLIST_PATH.is_file():
        missing.append(
            f"{NETLIST_PATH.relative_to(REPO_ROOT)} is missing -- run "
            "`python3 design/synth.py` first (#143)"
        )
    missing += _ensure_openroad_reachable()
    return missing


def _write_request(request_path: Path) -> None:
    request = {
        "schema": "klt.place_and_route.request/1",
        "engine": "openroad",
        "netlist": str(NETLIST_PATH),
        "hdl_toplevel": HDL_TOPLEVEL,
        "pdk": {"cell_library": CELL_LIBRARY, "corner": CORNER},
        "floorplan": dict(FLOORPLAN),
        "io": dict(IO),
        "power": {
            "power_net": POWER["power_net"],
            "ground_net": POWER["ground_net"],
            "straps": [dict(strap) for strap in POWER["straps"]],
        },
        "constraints": dict(CONSTRAINTS),
        "seed": SEED,
        "target_stage": TARGET_STAGE,
    }
    request_path.write_text(json.dumps(request, indent=2) + "\n")


# --------------------------------------------------------------------------- #
# Checks over what the tool returned
# --------------------------------------------------------------------------- #

_DIEAREA_RE = re.compile(
    r"^DIEAREA\s*\(\s*(-?\d+)\s+(-?\d+)\s*\)\s*\(\s*(-?\d+)\s+(-?\d+)\s*\)\s*;",
    re.M,
)
_UNITS_RE = re.compile(r"^UNITS\s+DISTANCE\s+MICRONS\s+(\d+)\s*;", re.M)
_COMPONENTS_RE = re.compile(r"^COMPONENTS\s+(\d+)\s*;", re.M)
#: A `SPECIALNETS` section is how a DEF carries power/ground geometry. Its
#: *absence* was the recorded evidence, from #111 until #171, that this flow
#: built no power delivery at all (klayout-tools#1091) -- see
#: `layout/digital/README.md`.
_SPECIALNETS_RE = re.compile(r"^SPECIALNETS\s+\d+\s*;", re.M)
#: Each `SPECIALNETS` entry opens with a `- <net-name>` line, and each
#: `COMPONENTS` entry with a `- <instance> <master>` line. `_specialnet_names`
#: and `_def_component_counts_by_master` below read the DEF's own sections
#: through these rather than trusting the request that produced it.
_SPECIALNET_NAME_RE = re.compile(r"^\s*-\s+(\S+)", re.M)
_COMPONENT_ENTRY_RE = re.compile(r"^\s*-\s+\S+\s+(\S+)", re.M)

#: The three supplies `layout/floorplan/README.md`'s mitigation 2 requires
#: the digital domain to stay off: the two ring supplies and the combiner/
#: sampler supply. `_power_isolation_check` asserts none of them appears in
#: this block's own `SPECIALNETS` section.
_ENTROPY_SUPPLY_NETS = ("vddr1", "vddr2", "vdd")


def _def_summary(def_path: Path) -> dict:
    """Die extent (um), database units and component count, read from the
    DEF's own header -- the reference every check below compares against,
    because the DEF is OpenROAD's own direct output and the GDS is a
    downstream merge of it."""
    text = def_path.read_text(errors="replace")
    units = _UNITS_RE.search(text)
    die = _DIEAREA_RE.search(text)
    components = _COMPONENTS_RE.search(text)
    dbu_per_um = int(units.group(1)) if units else None
    summary: dict = {
        "database_units_per_um": dbu_per_um,
        "component_count": int(components.group(1)) if components else None,
        "die_width_um": None,
        "die_height_um": None,
        "special_nets": _SPECIALNETS_RE.search(text) is not None,
    }
    if die is not None and dbu_per_um:
        x0, y0, x1, y1 = (int(v) for v in die.groups())
        summary["die_width_um"] = round((x1 - x0) / dbu_per_um, 4)
        summary["die_height_um"] = round((y1 - y0) / dbu_per_um, 4)
    return summary


def _def_section(def_text: str, name: str) -> str | None:
    """The body of the DEF's `<name> ... END <name>` section, or `None`.

    DEF sections are line-oriented and never nested, so locating the header
    and the matching `END` line is enough -- and is what keeps the two
    section readers below from mistaking a `NETS` entry for a `SPECIALNETS`
    one (both open their entries with the same `- <name>` syntax).
    """
    start = def_text.find(f"\n{name} ")
    if start == -1:
        return None
    end = def_text.find(f"\nEND {name}", start)
    return None if end == -1 else def_text[start:end]


def _specialnet_names(def_text: str) -> list[str]:
    """Every net that actually carries geometry in the DEF's `SPECIALNETS`
    section -- read from the DEF itself, not from the request that asked for
    it."""
    body = _def_section(def_text, "SPECIALNETS")
    return [] if body is None else sorted(set(_SPECIALNET_NAME_RE.findall(body)))


def _power_isolation_check(def_path: Path, def_summary: dict) -> dict:
    """Does this routed DEF's power geometry stay on this block's own
    supplies, and off the entropy source's?

    **What the constraint is.** `layout/floorplan/README.md`'s mitigation 2
    ("Star routing from a single point") requires four supply domains --
    `vddr1`, `vddr2`, `vdd` (combiner + samplers) and `vddd` (digital) --
    to be separate branches from one star point at the block's supply pad,
    with no shared series impedance between the entropy branches and the
    digital branch, and states the layout-side half of it explicitly: *"the
    digital domain never shares a strap segment with an entropy domain."*
    The digital section is the aggressor that requirement exists for (708
    flip-flops on one external `clk`), so a PDN built here without it in
    mind would undo that mitigation while looking entirely ordinary and
    passing DRC.

    **What this check can and cannot establish.** This script runs a
    *standalone* place-and-route of the digital section: its input netlist
    (`design/trng_top/trng_top.synth.v`) has no ring instance, no ring port
    and no entropy supply net anywhere in it, so the composition this
    constraint ultimately governs -- where `vddd` meets `vddr1`/`vddr2`/
    `vdd`, and through how much shared metal -- happens in
    `layout/floorplan/`, not here, and cannot be verified from this DEF. What
    *can* be verified from this DEF, and is the specific way this run could
    silently violate the constraint, is that the geometry `pdngen` built
    belongs to exactly this block's own two supplies: a `power_net`/
    `ground_net` regression here (or an upstream defect pulling an
    unexpected net into the grid) would show up as a `SPECIALNETS` section
    naming something other than `{vddd, vss}`, and a strap on a net named
    `vddr1`/`vddr2`/`vdd` is precisely the shared segment the floorplan
    forbids. So this asserts set equality against the requested pair --
    no more and no less -- and separately reports any entropy-supply name
    found, rather than asserting compliance in prose.

    Recorded verbatim in the committed report as `checks.power_isolation`.
    """
    if not def_summary.get("special_nets"):
        return {"status": "skipped", "reason": "no SPECIALNETS section in the DEF"}
    found = _specialnet_names(def_path.read_text(errors="replace"))
    if not found:
        return {
            "status": "skipped",
            "reason": "SPECIALNETS header present but its section body was not readable",
        }
    expected = sorted({POWER["power_net"], POWER["ground_net"]})
    entropy = [net for net in _ENTROPY_SUPPLY_NETS if net in found]
    return {
        "status": "ok" if found == expected and not entropy else "mismatch",
        "constraint": (
            "layout/floorplan/README.md mitigation 2: the digital domain "
            "(vddd) never shares a strap segment with an entropy domain "
            "(vddr1/vddr2/vdd)"
        ),
        "expected_nets": expected,
        "found_nets": found,
        "entropy_supply_nets_checked": list(_ENTROPY_SUPPLY_NETS),
        "entropy_supply_nets_present": entropy,
    }


def _gds_extent_um(gds_path: Path) -> tuple[float, float]:
    """Top-cell bounding box of `gds_path`, in microns.

    Read through `klt stats`, never `klayout.db` directly -- the same rule
    `layout/floorplan/floorplan.py`'s own `read_gds_bbox` follows, and for
    the same reason: one tool, one resolved PDK, one set of numbers.
    """
    box = _run_klt(
        ["stats", str(gds_path.relative_to(REPO_ROOT))], timeout_s=900
    )["bbox_um"]
    return (box["width"], box["height"])


def _gds_geometry_check(gds_path: Path, def_summary: dict) -> dict:
    """Does the merged GDS describe the same design the DEF does?

    The DEF is OpenROAD's own output and is the reference; the GDS is a
    downstream merge of that DEF with the standard cells' GDS views, and a
    merge that silently rescales one side of that merge relative to the
    other produces a file that opens fine, passes a cell-name check, and is
    geometrically meaningless. Comparing the merged stream's own extent
    against the DEF's own `DIEAREA` is the cheapest check that catches it:
    a correct merge lands within a standard cell's well overhang of the die
    (0.43 um per side for this library), and the defect this exists to catch
    is a factor of two.

    Returns a dict recorded verbatim in the committed report -- `status` is
    `"ok"`, `"mismatch"`, or `"skipped"` (no DEF reference to compare
    against).
    """
    expected_w = def_summary.get("die_width_um")
    expected_h = def_summary.get("die_height_um")
    if expected_w is None or expected_h is None:
        return {
            "status": "skipped",
            "reason": "DEF declares no parseable DIEAREA/UNITS to compare against",
        }
    width_um, height_um = _gds_extent_um(gds_path)
    ratios = (width_um / expected_w, height_um / expected_h)
    worst = max(abs(ratio - 1.0) for ratio in ratios)
    return {
        "status": "ok" if worst * 100.0 <= GDS_EXTENT_TOLERANCE_PCT else "mismatch",
        "def_die_um": [expected_w, expected_h],
        "gds_extent_um": [round(width_um, 4), round(height_um, 4)],
        "gds_over_def_ratio": [round(ratios[0], 4), round(ratios[1], 4)],
        "tolerance_pct": GDS_EXTENT_TOLERANCE_PCT,
    }


def _netlist_instance_count(netlist_path: Path) -> int | None:
    """Count `CELL_LIBRARY` instantiations in a gate-level netlist.

    Every instance in either netlist here is a flat standard-cell
    instantiation of the form `<library>__<cell> <name> (...)`, one per
    statement, so counting the instantiated master names counts the
    instances -- no Verilog parse needed, and nothing else in the file
    mentions a master name at statement start.
    """
    if not netlist_path.is_file():
        return None
    pattern = re.compile(rf"^\s*{re.escape(CELL_LIBRARY)}__\S+\s+\S+", re.M)
    return len(pattern.findall(netlist_path.read_text(errors="replace")))


def _physical_only_masters(power: dict | None) -> tuple[str, ...]:
    """The tapcell/endcap/filler masters this run inserted, named by `klt
    place-and-route`'s own response.

    These are physical-only cells: they carry no logical function, and the
    `"route"` stage's `write_verilog` deliberately strips them from the
    as-built netlist (`-remove_cells`, so `trng_top.pnr.v` stays diffable
    against `klt synthesize`'s own netlist, which never contained them --
    klayout-tools' "Power delivery" docs). They are therefore present in the
    DEF's `COMPONENTS` count and absent from the netlist by design, which
    `_component_check` has to subtract before comparing the two.
    """
    if not power:
        return ()
    named = [power.get("tapcell_master"), power.get("endcap_master")]
    named += list(power.get("filler_masters") or ())
    return tuple(name for name in named if name)


def _def_component_counts_by_master(
    def_text: str, masters: tuple[str, ...]
) -> dict[str, int]:
    """How many `COMPONENTS` entries instantiate each of `masters`."""
    body = _def_section(def_text, "COMPONENTS")
    if body is None or not masters:
        return {}
    counts = dict.fromkeys(masters, 0)
    for master in _COMPONENT_ENTRY_RE.findall(body):
        if master in counts:
            counts[master] += 1
    return counts


def _component_check(
    def_path: Path, def_summary: dict, physical_only_masters: tuple[str, ...]
) -> dict:
    """Do the DEF and the as-built netlist describe the same *logical*
    instance set?

    That is the invariant worth checking, and it is not the same as "the DEF
    has at least as many components as the synthesized netlist had
    instances": OpenROAD's own `repair_design`/`repair_timing` legitimately
    *removes* redundant buffers as well as adding CTS buffers and resizes, so
    the placed count can land either side of the synthesized one. What must
    hold is that `write_def` and `write_verilog` -- the two artefacts this
    script commits, which downstream consumers (#145's STA, #147's
    gate-level re-run) have to be able to use together -- agree with each
    other, once the tapcell/endcap/filler instances `write_verilog` strips by
    design (`_physical_only_masters`, #171) are subtracted from the DEF side
    too. Without that subtraction a PDN doing exactly what it is supposed to
    do would report a `"mismatch"` on every run. The delta against the
    synthesized input is recorded alongside as information, not as a verdict.
    """
    placed = def_summary.get("component_count")
    as_built = _netlist_instance_count(PNR_NETLIST_PATH)
    synth_report = REPO_ROOT / "design" / HDL_TOPLEVEL / f"{HDL_TOPLEVEL}.synth.json"
    synthesized = None
    if synth_report.is_file():
        try:
            synthesized = json.loads(synth_report.read_text()).get("instance_count")
        except (OSError, json.JSONDecodeError):
            synthesized = None
    if placed is None or as_built is None:
        return {
            "status": "skipped",
            "reason": "no COMPONENTS count in the DEF, or no as-built netlist",
            "placed": placed,
            "as_built_netlist": as_built,
            "synthesized": synthesized,
        }
    physical_only = _def_component_counts_by_master(
        def_path.read_text(errors="replace"), physical_only_masters
    )
    physical_only_total = sum(physical_only.values())
    logical_placed = placed - physical_only_total
    return {
        "status": "ok" if logical_placed == as_built else "mismatch",
        "placed": placed,
        "physical_only_instance_count": physical_only_total,
        "physical_only_by_master": physical_only or None,
        "logical_placed": logical_placed,
        "as_built_netlist": as_built,
        "synthesized": synthesized,
        "delta_vs_synthesized": (
            logical_placed - synthesized if synthesized is not None else None
        ),
    }


def run_drc(gds_path: Path) -> dict:
    """`klt drc` over the merged GDS, the same deck and invocation shape
    `layout/verify.py` runs over every other cell in this repository."""
    return _run_klt(
        ["drc", str(gds_path.relative_to(REPO_ROOT)), "--deck", DECK], timeout_s=1800
    )


def _drc_summary(payload: dict) -> dict:
    """The verdict-and-counts digest of a `klt drc` payload.

    This is what `reports/place_and_route.json`'s own nested `drc` field
    carries -- a one-line answer to "did the stream this run committed pass
    DRC?" next to the rest of that run's record. It is **not** what
    `reports/drc.json` carries any more: see `_drc_committed_view`.
    """
    return {
        "status": payload.get("status"),
        "deck": payload.get("deck"),
        "violation_count": payload.get("violation_count"),
        "rule_counts": payload.get("rule_counts"),
    }


def _drc_committed_view(payload: dict) -> dict:
    """The committed view of a `klt drc` payload: the **whole envelope**.

    From #170 until #273 this function did not exist, and `reports/drc.json`
    was `_drc_summary`'s four-field digest instead -- `{"status": "clean",
    "deck": ..., "violation_count": 0, "rule_counts": {}}`, on the stated
    reasoning that the per-violation polygon dump "runs to megabytes over a
    design this size and says nothing a rule count and a re-run do not".

    Two things were wrong with that. The first is arithmetic: the dump is
    only large when the run is *dirty*. This run is clean, so `violations`
    is an empty array and the whole envelope is 5.4 KB.

    The second is the one that actually cost something. A four-field digest
    carries no `schema_version`, no `violations` array and no `provenance`
    block, and those three are exactly what `klt signoff` reads to decide
    what kind of evidence a cited file *is*. So the digital partition's DRC
    run -- which has been clean since #170 and was re-run clean at
    `FIFO_DEPTH = 2` by #255/#266 -- graded `unmet`/`no_evidence` on T1
    item 3 for want of a file shape, while the analog partition's own
    `klt drc` envelope (`layout/reports/combiner_sampler.drc.json`, written
    by `layout/verify.py`, which never reduced anything) graded `met`. The
    digest was also unpinnable: `provenance.input.content_hash` is the field
    `signoff/block-manifest.json` pins a citation to and `signoff/check.py`
    re-hashes against `trng_top.gds` on disk, so a summary could silently go
    stale against the stream it described.

    The envelope is therefore committed verbatim, with nothing dropped --
    including `coverage` (which deck layers and rules this run actually
    checked, and which layers in the stream no rule covers), the disclosure
    a reader needs to know what "clean" did and did not cover.
    """
    return dict(payload)


# --------------------------------------------------------------------------- #
# The run
# --------------------------------------------------------------------------- #


def _committed_view(payload: dict) -> dict:
    """The form of `klt place-and-route`'s response that belongs in the
    committed report -- restates `def_path`/`gds_path`/`verilog_path` (all
    scratch-directory, machine-local absolute paths under `WORK_DIR` in the
    raw payload) to the *committed* `layout/digital/` locations `build()`
    copies them to, the same "restate the one field that names a scratch
    location" discipline `design/synth.py`/`layout/verify.py` apply to
    `netlist_path`/`extract`'s own scratch paths. Also drops
    `provenance.pdk.source` (machine-local, not part of what was verified --
    `design/synth.py`'s own `_committed_view` does the same for the
    identical field) and `layer_map.path` (an absolute host path into the
    local PDK install, not a repository-relative one). Likewise restates the
    nested `power.placed.def_path` -- the same scratch DEF, which otherwise
    names the producing host and worktree -- to the committed DEF, when that
    field is present. Nested dictionaries are copied, never mutated in place.
    """
    restated = dict(payload)
    power = restated.get("power")
    if isinstance(power, dict):
        power = dict(power)
        placed = power.get("placed")
        if isinstance(placed, dict):
            placed = dict(placed)
            if placed.get("def_path") is not None:
                placed["def_path"] = str(DEF_PATH.relative_to(REPO_ROOT))
            power["placed"] = placed
        restated["power"] = power
    layer_map = restated.get("layer_map")
    if isinstance(layer_map, dict):
        restated["layer_map"] = {"resolution": layer_map.get("resolution")}
    provenance = dict(restated.get("provenance") or {})
    pdk = provenance.get("pdk")
    if isinstance(pdk, dict):
        pdk = dict(pdk)
        pdk.pop("source", None)
        provenance["pdk"] = pdk
    restated["provenance"] = provenance
    restated["request"] = {
        "pdk": {"cell_library": CELL_LIBRARY, "corner": CORNER},
        "floorplan": FLOORPLAN,
        "io": IO,
        "power": POWER,
        "constraints": CONSTRAINTS,
        "seed": SEED,
        "target_stage": TARGET_STAGE,
    }
    return restated


def place_and_route(work_dir: Path) -> tuple[dict, Path | None, Path | None, Path | None]:
    """Run `klt place-and-route` with `work_dir` as the request's own
    directory. Returns `(payload, def_path, gds_path, verilog_path)` with the
    three paths pointing into the scratch directory. Raises `PrError` for a
    missing tool/PDK/input; a documented engine failure (the run does not
    reach `TARGET_STAGE`) is *not* a `PrError` -- `klt`'s own `{"error":
    ...}` payload propagates as a `FlowError` from `_run_klt`, which `main()`
    below catches and records as a valid, complete outcome (see the module
    docstring)."""
    missing = _check_environment()
    if missing:
        raise PrError("; ".join(missing))

    request_path = work_dir / "request.json"
    _write_request(request_path)

    args = ["place-and-route", str(request_path)]
    pdk = resolve_pdk()
    if pdk is not None:
        args += ["--pdk", pdk.variant]

    payload = _run_klt(args, timeout_s=7200)

    def _path(key: str) -> Path | None:
        value = payload.get(key)
        return Path(value) if value else None

    return payload, _path("def_path"), _path("gds_path"), _path("verilog_path")


def build() -> int:
    REPORTS_DIR.mkdir(parents=True, exist_ok=True)
    if WORK_DIR.exists():
        shutil.rmtree(WORK_DIR)
    WORK_DIR.mkdir(parents=True)
    try:
        payload, def_path, gds_path, verilog_path = place_and_route(WORK_DIR)
    except PrError as exc:
        print(f"ERROR  {exc}", file=sys.stderr)
        return EXIT_ENVIRONMENT
    except FlowError as exc:
        print(f"FAILED  {exc}", file=sys.stderr)
        print(
            "       an explicit, measured failure is a complete, documented "
            "outcome for this run (issue #111) -- see layout/digital/README.md",
            file=sys.stderr,
        )
        return EXIT_FLOW_FAILURE

    report = _committed_view(payload)
    checks: dict = {}
    written: list[Path] = []
    warnings: list[str] = []

    # The as-built netlist lands first: `_component_check` compares the DEF
    # against it, so it has to be on disk before the DEF's own checks run.
    if verilog_path is not None and verilog_path.is_file():
        shutil.copyfile(verilog_path, PNR_NETLIST_PATH)
        written.append(PNR_NETLIST_PATH)
        report["verilog_path"] = str(PNR_NETLIST_PATH.relative_to(REPO_ROOT))
    else:
        report["verilog_path"] = None

    if def_path is not None and def_path.is_file():
        shutil.copyfile(def_path, DEF_PATH)
        written.append(DEF_PATH)
        def_summary = _def_summary(DEF_PATH)
        checks["def"] = def_summary
        checks["components"] = _component_check(
            DEF_PATH, def_summary, _physical_only_masters(report.get("power"))
        )
        if checks["components"]["status"] == "mismatch":
            warnings.append(
                "the routed DEF and the as-built netlist disagree on logical "
                f"instance count ({checks['components']['logical_placed']} vs "
                f"{checks['components']['as_built_netlist']}, after excluding "
                f"{checks['components']['physical_only_instance_count']} "
                "physical-only tapcell/endcap/filler instances)"
            )
        checks["power_isolation"] = _power_isolation_check(DEF_PATH, def_summary)
        if checks["power_isolation"]["status"] == "mismatch":
            warnings.append(
                "the routed DEF's SPECIALNETS section does not carry exactly "
                f"{checks['power_isolation']['expected_nets']} "
                f"(found {checks['power_isolation']['found_nets']}; "
                "entropy-source supplies present: "
                f"{checks['power_isolation']['entropy_supply_nets_present']}) "
                "-- see layout/floorplan/README.md's mitigation 2"
            )
        if not def_summary.get("special_nets"):
            warnings.append(
                "the routed DEF carries no SPECIALNETS section -- this run "
                "built no power delivery network (#171)"
            )
    else:
        def_summary = {}
        checks["def"] = {"status": "skipped", "reason": "no DEF returned"}
        checks["components"] = {"status": "skipped", "reason": "no DEF returned"}
        checks["power_isolation"] = {"status": "skipped", "reason": "no DEF returned"}

    drc: dict | None = None
    if gds_path is not None and gds_path.is_file():
        geometry = _gds_geometry_check(gds_path, def_summary)
        checks["gds_geometry"] = geometry
        if geometry["status"] == "mismatch":
            warnings.append(
                "the merged GDS does not match the DEF's own DIEAREA "
                f"(ratio {geometry['gds_over_def_ratio']}) -- not committed; "
                "see layout/digital/README.md's 'Two defects this bring-up found'"
            )
        else:
            # Zero the BGNLIB/BGNSTR wall-clock timestamp fields the
            # DEF->GDS merge's KLayout writer stamps in, same as every other
            # stream in this repository (klayout-tools#320, layout/_klt.py's
            # own docstring) -- one axis of run-to-run nondeterminism
            # removed, though (per the module docstring) OpenROAD's own
            # placement/routing is not claimed byte-reproducible beyond that.
            GDS_PATH.write_bytes(normalise_gds(gds_path.read_bytes()))
            written.append(GDS_PATH)
            drc_payload = run_drc(GDS_PATH)
            DRC_REPORT_PATH.write_text(
                json.dumps(_drc_committed_view(drc_payload), indent=2) + "\n"
            )
            written.append(DRC_REPORT_PATH)
            drc = _drc_summary(drc_payload)
            if drc.get("status") != "clean":
                warnings.append(
                    f"klt drc over the merged GDS: {drc.get('status')} "
                    f"({drc.get('violation_count')} violations)"
                )
    else:
        checks["gds_geometry"] = {"status": "skipped", "reason": "no GDS returned"}

    report["gds_path"] = (
        str(GDS_PATH.relative_to(REPO_ROOT)) if GDS_PATH in written else None
    )
    report["def_path"] = (
        str(DEF_PATH.relative_to(REPO_ROOT)) if DEF_PATH in written else None
    )
    report["checks"] = checks
    report["drc"] = drc
    REPORT_PATH.write_text(json.dumps(report, indent=2) + "\n")
    written.append(REPORT_PATH)

    origin = klt_origin()
    commit = (origin or {}).get("commit")
    print(f"klt:  {klt_version()}" + (f" (built from {commit})" if commit else ""))
    print(f"corner:        {CELL_LIBRARY}__{CORNER}")
    print(f"stage_reached: {report.get('stage_reached')}")
    power_isolation = checks.get("power_isolation") or {}
    print(
        f"power:         SPECIALNETS "
        f"{'present' if checks.get('def', {}).get('special_nets') else 'ABSENT'}, "
        f"nets {power_isolation.get('found_nets')}, "
        f"isolation {power_isolation.get('status')}"
    )
    print(f"worst_slack:   {report.get('worst_slack_ns')} ns @ {CORNER}")
    print(
        f"swept setup/hold: {report.get('worst_setup_slack_ns')} / "
        f"{report.get('worst_hold_slack_ns')} ns (all shipped corners)"
    )
    for path in written:
        print(f"wrote  {path.relative_to(REPO_ROOT)}")
    for warning in warnings:
        print(f"WARNING  {warning}")
    return EXIT_OK


def check_input() -> int:
    """Hold `reports/place_and_route.json`'s recorded input to the committed
    netlist (#293).

    `--check` in the `design/synth.py` sense (re-run the tool, diff the
    output) is not available here: place-and-route is stochastic and hours
    long (module docstring). What *is* cheap and deterministic is the one
    edge the report records about its input: `provenance.input.content_hash`,
    the sha256 of the `NETLIST_PATH` file `klt place-and-route` consumed. This
    mode re-hashes that file and fails if it no longer matches, i.e. if
    `design/trng_top/trng_top.synth.v` has been re-synthesized (PR #292
    re-baselined it) without the implementation downstream of it being
    re-run. Stdlib only: no `klt`, no PDK, no OpenROAD -- so it runs on the
    PR-blocking path (`npm run check:digital-input`, part of `check:ci`).
    """
    report_path = REPORTS_DIR / "place_and_route.json"
    try:
        report = json.loads(report_path.read_text())
    except (OSError, ValueError) as exc:
        print(f"ERROR  cannot read {report_path.relative_to(REPO_ROOT)}: {exc}")
        return 1
    recorded = ((report.get("provenance") or {}).get("input") or {}).get(
        "content_hash"
    )
    try:
        netlist_name = NETLIST_PATH.relative_to(REPO_ROOT)
    except ValueError:
        netlist_name = NETLIST_PATH
    if not NETLIST_PATH.is_file():
        print(f"ERROR  {netlist_name} is missing")
        return 1
    import hashlib

    actual = "sha256:" + hashlib.sha256(NETLIST_PATH.read_bytes()).hexdigest()
    if recorded != actual:
        print(
            f"STALE  {report_path.relative_to(REPO_ROOT)} records "
            f"provenance.input.content_hash {recorded}, but "
            f"{netlist_name} hashes to {actual}.\n"
            "       The committed place-and-route (DEF/GDS/pnr.v/reports and the "
            "digital-sta-power record family) descends from a different "
            "netlist than the one in design/. Re-run `python3 "
            "layout/digital/build.py`, `python3 layout/digital/lvs.py` and "
            "`python3 sim/tb/digital-sta-power/run_sta.py`, then propagate "
            "every figure that moves."
        )
        return 1
    print(
        f"OK     {report_path.relative_to(REPO_ROOT)} input hash matches "
        f"{netlist_name} ({actual})"
    )
    return 0


def drc_only() -> int:
    """Re-run `klt drc` over the **already-committed** `trng_top.gds` and
    rewrite `reports/drc.json`, without touching place-and-route.

    Why this mode exists (#273). DRC is a check over a committed stream, and
    is independent of whatever built that stream -- so re-emitting the DRC
    evidence (a newer `klt`, a newer deck, or a report shape that `klt
    signoff` can actually grade) should not require re-deriving the stream.
    Requiring it would, because `build()` runs the whole flow: OpenROAD via
    the pinned Docker image, hours of wall clock, and -- per the module
    docstring -- a *stochastic* placement and routing that is not claimed
    byte-reproducible. Re-running it to refresh a DRC report would throw
    away the committed, already-verified `trng_top.def`/`.gds`/`.pnr.v`
    triple and replace it with a different one, invalidating every
    downstream artefact keyed to it (`reports/lvs.json`,
    `sim/tb/digital-sta-power/`, `layout/floorplan/`) for no verification
    gain at all.

    What this mode may and may not be used for: it re-verifies the
    *committed* stream and says so in the envelope's own
    `provenance.input.content_hash`. It cannot refresh anything derived from
    the P&R run itself (`stage_reached`, slacks, the `checks` block) -- those
    stay as `build()` last recorded them, which is correct, because the
    stream they describe has not moved. `reports/place_and_route.json`'s
    nested `drc` digest is refreshed alongside, so the two committed files
    can never disagree about the same run's verdict.
    """
    if not GDS_PATH.is_file():
        print(
            f"ERROR  {GDS_PATH.relative_to(REPO_ROOT)} is missing -- there is "
            "no committed stream to re-check; run `python3 "
            "layout/digital/build.py` first",
            file=sys.stderr,
        )
        return EXIT_ENVIRONMENT
    if klt_version() is None:
        print("ERROR  klayout-tools (`klt`) is not on PATH", file=sys.stderr)
        return EXIT_ENVIRONMENT

    REPORTS_DIR.mkdir(parents=True, exist_ok=True)
    try:
        payload = run_drc(GDS_PATH)
    except FlowError as exc:
        print(f"FAILED  klt drc: {exc}", file=sys.stderr)
        return EXIT_FLOW_FAILURE

    DRC_REPORT_PATH.write_text(
        json.dumps(_drc_committed_view(payload), indent=2) + "\n"
    )
    summary = _drc_summary(payload)

    # Keep place_and_route.json's nested `drc` digest in step with the
    # envelope, so a reader cannot be handed two committed answers to the
    # same question. Everything else in that report describes the P&R run
    # and is left exactly as it was.
    if REPORT_PATH.is_file():
        report = json.loads(REPORT_PATH.read_text())
        report["drc"] = summary
        REPORT_PATH.write_text(json.dumps(report, indent=2) + "\n")

    origin = klt_origin()
    commit = (origin or {}).get("commit")
    print(f"klt:  {klt_version()}" + (f" (built from {commit})" if commit else ""))
    print(f"input: {GDS_PATH.relative_to(REPO_ROOT)}")
    print(
        f"drc:  status={summary.get('status')}  "
        f"violation_count={summary.get('violation_count')}  "
        f"rule_counts={summary.get('rule_counts')}"
    )
    print(f"wrote  {DRC_REPORT_PATH.relative_to(REPO_ROOT)}")
    if REPORT_PATH.is_file():
        print(f"wrote  {REPORT_PATH.relative_to(REPO_ROOT)} (nested `drc` digest)")
    if summary.get("status") != "clean":
        print(
            f"WARNING  klt drc over the committed GDS: {summary.get('status')} "
            f"({summary.get('violation_count')} violations)",
            file=sys.stderr,
        )
    return EXIT_OK


def main(argv: list[str] | None = None) -> int:
    parser = argparse.ArgumentParser(
        prog="build.py",
        description=(
            "Run the trng_top digital-section place-and-route against "
            "gf180mcu (#111), check the artefacts, and commit the result."
        ),
    )
    parser.add_argument(
        "--drc-only",
        action="store_true",
        help=(
            "skip place-and-route entirely: re-run `klt drc` over the "
            "already-committed trng_top.gds and rewrite reports/drc.json "
            "(see drc_only()'s docstring, #273)"
        ),
    )
    parser.add_argument(
        "--check-input",
        action="store_true",
        help=(
            "stdlib-only staleness guard: fail unless "
            "reports/place_and_route.json's provenance.input.content_hash "
            "equals the sha256 of the committed trng_top.synth.v (#293); "
            "runs no tool and rebuilds nothing"
        ),
    )
    args = parser.parse_args(argv)
    if args.check_input:
        return check_input()
    return drc_only() if args.drc_only else build()


if __name__ == "__main__":
    raise SystemExit(main())
