2AMLogic/gf180-trng/sim/tests/test_runner.py

#!/usr/bin/env python3
"""Unit tests for sim/harness/runner.py deck composition and output parsing.

No PDK and no ngspice required -- deck composition is tested against a fake
PDK layout; actual ngspice execution is exercised by sim/selftest.sh instead.
"""

from __future__ import annotations

import hashlib
import json
import shutil
import subprocess
import os
import sys
import tempfile
import time
import unittest
from pathlib import Path
from unittest import mock

SIM_DIR = Path(__file__).resolve().parents[1]
sys.path.insert(0, str(SIM_DIR))

from harness import corners, runner, startup, testbench  # noqa: E402
from harness.pdk import Pdk  # noqa: E402


def fake_pdk(root: Path) -> Pdk:
    (root / "libs.tech" / "ngspice").mkdir(parents=True, exist_ok=True)
    (root / "libs.tech" / "ngspice" / "sm141064.ngspice").write_text("* fake\n")
    (root / "libs.tech" / "ngspice" / "design.ngspice").write_text("* fake\n")
    (root / "SOURCES").write_text("open_pdks deadbeef\n")
    return Pdk(path=root, variant=root.name, source="test")


class DeckTests(unittest.TestCase):
    def setUp(self):
        self.tmp = tempfile.TemporaryDirectory()
        self.addCleanup(self.tmp.cleanup)
        root = Path(self.tmp.name)
        (root / "tb").mkdir()
        (root / "tb" / "x.spice").write_text("v1 out 0 dc {vdd_val}\n")
        (root / "tb" / "tb.json").write_text(
            json.dumps(
                {
                    "name": "x",
                    "netlist": "x.spice",
                    "measure": {"vout": "v(out)", "iq": "-i(v1)"},
                    "params": {"cload": "1p"},
                    "options": ["reltol=1e-5"],
                }
            )
        )
        self.tb = testbench.load(root / "tb")
        self.pdk = fake_pdk(root / "gf180mcuD")
        self.point = corners.build_grid(corners.resolve_corners(["ss"]), (125,), [3.63])[0]

    def test_deck_sets_the_pvt_point(self):
        deck = runner.compose_deck(self.tb, self.pdk, self.point)
        self.assertIn(".param vdd_val=3.63", deck)
        self.assertIn(".param vdd_nom=3.3", deck)
        self.assertIn(".temp 125", deck)

    def test_deck_includes_design_switches_before_model_sections(self):
        deck = runner.compose_deck(self.tb, self.pdk, self.point)
        design_at = deck.index("design.ngspice")
        lib_at = deck.index("sm141064.ngspice")
        self.assertLess(design_at, lib_at)

    def test_deck_selects_every_section_of_the_corner(self):
        deck = runner.compose_deck(self.tb, self.pdk, self.point)
        for section in self.point.corner.sections:
            self.assertIn(f'sm141064.ngspice" {section}', deck)

    def test_deck_carries_manifest_params_and_options(self):
        deck = runner.compose_deck(self.tb, self.pdk, self.point)
        self.assertIn(".param cload=1p", deck)
        self.assertIn(".options reltol=1e-5", deck)

    def test_deck_emits_one_measurement_vector_per_measure_entry(self):
        deck = runner.compose_deck(self.tb, self.pdk, self.point)
        self.assertIn("let m_vout = v(out)", deck)
        self.assertIn("let m_iq = -i(v1)", deck)
        self.assertIn("print m_vout", deck)
        self.assertTrue(deck.rstrip().endswith(".end"))

    def test_seed_only_emitted_when_given(self):
        deck_no_seed = runner.compose_deck(self.tb, self.pdk, self.point, seed=None)
        self.assertNotIn(".option seed=", deck_no_seed)
        deck_seeded = runner.compose_deck(self.tb, self.pdk, self.point, seed=7)
        self.assertIn(".option seed=7", deck_seeded)


class TransientNoiseSeedControlTests(unittest.TestCase):
    """#574 / DR-0031: no tested control made trnoise replay, so none was
    integrated. A seeded tran-noise deck carries exactly the harness's one
    ``.option seed=<n>`` and no start-up or control-block seed command, and
    decks for different seeds differ only in that line."""

    def setUp(self):
        self.tmp = tempfile.TemporaryDirectory()
        self.addCleanup(self.tmp.cleanup)
        root = Path(self.tmp.name)
        (root / "tb").mkdir()
        (root / "tb" / "x.spice").write_text("vn out 0 dc 0 trnoise(1m 1n 0 0)\nr1 out 0 1k\n")
        (root / "tb" / "tb.json").write_text(json.dumps({
            "name": "x", "netlist": "x.spice", "measure": {"vout": "v(out)"},
            "analysis_type": "tran-noise", "analyses": ["tran 1n 16n"],
        }))
        self.tb = testbench.load(root / "tb")
        self.pdk = fake_pdk(root / "gf180mcuD")
        self.point = corners.build_grid(corners.resolve_corners(["tt"]), (27,), [3.3])[0]

    def test_one_harness_seed_line_and_nothing_else(self):
        for seed in (11, 12):
            deck = runner.compose_deck(self.tb, self.pdk, self.point, seed=seed)
            found = testbench.scan_seed_controls(deck)
            self.assertEqual(len(found), 1, found)
            self.assertIn(f".option seed={seed}", found[0])

    def test_decks_for_two_seeds_differ_only_in_the_seed_line(self):
        a = runner.compose_deck(self.tb, self.pdk, self.point, seed=11).splitlines()
        b = runner.compose_deck(self.tb, self.pdk, self.point, seed=12).splitlines()
        diff = [(x, y) for x, y in zip(a, b) if x != y]
        self.assertEqual(len(a), len(b))
        self.assertEqual(diff, [(".option seed=11", ".option seed=12")])

    def test_pinned_startup_script_sets_no_seed(self):
        self.assertEqual(
            testbench.scan_seed_controls(startup.SPINIT_PATH.read_text()), []
        )


class AnalysisContextSubstitutionTests(unittest.TestCase):
    """``analyses`` entries get {vdd_val}-style fields substituted in Python
    before ngspice ever sees them (see ``runner._analysis_context``): the
    interactive control-block ``dc``/``meas`` commands ``compose_deck``
    inserts these lines as do not evaluate ``.param`` symbols in a numeric
    argument position, so a voltage-swept testbench has no other way to make
    its sweep bounds track the PVT point's own supply."""

    def setUp(self):
        self.tmp = tempfile.TemporaryDirectory()
        self.addCleanup(self.tmp.cleanup)
        root = Path(self.tmp.name)
        (root / "tb").mkdir()
        (root / "tb" / "x.spice").write_text("v1 out 0 dc 0\n")
        (root / "tb" / "tb.json").write_text(
            json.dumps(
                {
                    "name": "x",
                    "netlist": "x.spice",
                    "measure": {"dtrip": "dtrip"},
                    "analyses": [
                        "dc v1 0 {vdd_val} 0.01",
                        "meas dc dtrip when v(out)={vdd_half} fall=1",
                    ],
                }
            )
        )
        self.tb = testbench.load(root / "tb")
        self.pdk = fake_pdk(root / "gf180mcuD")
        self.point = corners.build_grid(corners.resolve_corners(["ss"]), (125,), [3.63])[0]

    def test_vdd_val_and_vdd_half_substituted_from_the_pvt_point(self):
        deck = runner.compose_deck(self.tb, self.pdk, self.point)
        self.assertIn("dc v1 0 3.63 0.01", deck)
        self.assertIn("meas dc dtrip when v(out)=1.815 fall=1", deck)
        # The unsubstituted placeholders must not survive into the deck --
        # ngspice cannot evaluate them (that is the whole reason this
        # substitution exists).
        self.assertNotIn("{vdd_val}", deck)
        self.assertNotIn("{vdd_half}", deck)


class ExtraLibSectionsTests(unittest.TestCase):
    """extra_lib_sections replaces the plain corner sections entirely (a
    section like "statistical" redefines the same subckts)."""

    def setUp(self):
        self.tmp = tempfile.TemporaryDirectory()
        self.addCleanup(self.tmp.cleanup)
        root = Path(self.tmp.name)
        (root / "tb").mkdir()
        (root / "tb" / "x.spice").write_text("v1 out 0 dc {vdd_val}\n")
        (root / "tb" / "tb.json").write_text(
            json.dumps(
                {
                    "name": "x",
                    "netlist": "x.spice",
                    "measure": {"vout": "v(out)"},
                    "analysis_type": "mc",
                    "default_runs": 2,
                    "design_params": {"sw_stat_mismatch": 1},
                    "extra_lib_sections": ["statistical"],
                }
            )
        )
        self.tb = testbench.load(root / "tb")
        self.pdk = fake_pdk(root / "gf180mcuD")
        self.point = corners.build_grid(corners.resolve_corners(["tt"]), (27,), [3.3])[0]

    def test_extra_sections_replace_corner_sections(self):
        deck = runner.compose_deck(self.tb, self.pdk, self.point, seed=1)
        self.assertIn('sm141064.ngspice" statistical', deck)
        self.assertNotIn('sm141064.ngspice" typical', deck)

    def test_design_params_override_after_design_include(self):
        deck = runner.compose_deck(self.tb, self.pdk, self.point, seed=1)
        design_at = deck.index("design.ngspice")
        override_at = deck.index(".param sw_stat_mismatch=1")
        self.assertLess(design_at, override_at)


class ParseTests(unittest.TestCase):
    def test_parses_print_output(self):
        text = "\n".join(
            [
                "Circuit: * x",
                "m_vout = 1.2003456789e+00",
                "m_iq = -4.5e-05",
                "v(other) = 9.9",
                "m_bad = not_a_number",
            ]
        )
        self.assertEqual(
            runner.parse_measurements(text), {"vout": 1.2003456789, "iq": -4.5e-05}
        )

    def test_non_finite_values_are_never_parsed_as_measurements(self):
        # `1e999` matches the numeric syntax but float() overflows it to
        # +/-inf without raising; literal inf/nan are not numbers either.
        text = "\n".join(
            [
                "m_big = 1e999",
                "m_small = -1e999",
                "m_pinf = inf",
                "m_ninf = -Infinity",
                "m_nan = nan",
                "m_ok = 2.5e-3",
            ]
        )
        self.assertEqual(runner.parse_measurements(text), {"ok": 2.5e-3})
        self.assertEqual(
            runner.parse_non_finite_measurements(text),
            {
                "big": "1e999",
                "small": "-1e999",
                "pinf": "inf",
                "ninf": "-Infinity",
                "nan": "nan",
            },
        )


class RunPointContractTests(unittest.TestCase):
    """run_point enforces the 'no seed, no evidence' rule at the API level
    (before ever invoking ngspice)."""

    def setUp(self):
        self.tmp = tempfile.TemporaryDirectory()
        self.addCleanup(self.tmp.cleanup)
        root = Path(self.tmp.name)
        (root / "tb").mkdir()
        (root / "tb" / "x.spice").write_text("v1 out 0 dc {vdd_val}\n")
        (root / "tb" / "tb.json").write_text(
            json.dumps(
                {
                    "name": "x",
                    "netlist": "x.spice",
                    "measure": {"vout": "v(out)"},
                    "analysis_type": "mc",
                    "default_runs": 1,
                }
            )
        )
        self.tb = testbench.load(root / "tb")
        self.point = corners.build_grid(corners.resolve_corners(["tt"]), (27,), [3.3])[0]

    def test_stochastic_testbench_without_seeds_is_rejected(self):
        with self.assertRaises(ValueError) as ctx:
            runner.run_point(self.tb, None, self.point, Path("/nonexistent"), seeds=None)
        self.assertIn("no seed, no evidence", str(ctx.exception))

    def test_duplicate_seed_is_rejected_naming_the_value(self):
        with self.assertRaises(ValueError) as ctx:
            runner.plan_runs(self.tb, [1, 2, 1])
        self.assertIn("duplicate seed(s) 1 ", str(ctx.exception))

    def test_every_repeated_seed_is_named_once(self):
        with self.assertRaises(ValueError) as ctx:
            runner.plan_runs(self.tb, [1001, 7, 1001, 7, 1001, 3])
        self.assertIn("duplicate seed(s) 1001, 7 ", str(ctx.exception))

    def test_run_point_rejects_duplicate_seeds_before_running(self):
        with mock.patch.object(runner, "run_one") as run_one:
            with self.assertRaises(ValueError):
                runner.run_point(self.tb, None, self.point, Path("/nonexistent"), seeds=[5, 5])
        run_one.assert_not_called()

    def test_distinct_seeds_keep_their_order(self):
        self.assertEqual(
            runner.plan_runs(self.tb, [1003, 1001, 1002]),
            [(1003, 0), (1001, 1), (1002, 2)],
        )

    def test_deterministic_testbench_is_unaffected(self):
        tb = testbench.load(self._deterministic_tb())
        self.assertEqual(runner.plan_runs(tb, None), [(None, 0)])

    def _deterministic_tb(self) -> Path:
        root = Path(self.tmp.name) / "det"
        root.mkdir()
        (root / "x.spice").write_text("v1 out 0 dc {vdd_val}\n")
        (root / "tb.json").write_text(
            json.dumps({"name": "det", "netlist": "x.spice", "measure": {"vout": "v(out)"}})
        )
        return root


def _install_fake_ngspice(bin_dir: Path, script: str) -> None:
    """Drop an executable named ``ngspice`` on ``bin_dir``.

    Standing in for a real ngspice invocation lets these tests exercise
    ``run_one()``'s actual subprocess/timeout plumbing (``Popen``,
    ``timeout(1)`` wrapping, process-group kill) without requiring ngspice
    or the PDK -- consistent with this module's "no PDK and no ngspice
    required" promise above; the real thing is exercised by
    ``sim/selftest.sh`` instead.
    """
    path = bin_dir / "ngspice"
    path.write_text(script)
    path.chmod(0o755)


class TimeoutTests(unittest.TestCase):
    """``run_one()`` bounds ngspice's wall clock two ways at once (issue
    #83, filed after a hung ngspice ran ~4.5h undetected because the
    harness process that launched it had itself been killed): an OS-level
    ``timeout(1)``/``gtimeout`` watchdog that survives this harness process
    dying, plus an in-process ``Popen.communicate(timeout=...)`` guard for
    when no watchdog binary is available. Both must actually kill the whole
    process group, not just the direct child -- an orphaned grandchild is
    exactly what the incident's ngspice was.
    """

    def setUp(self):
        self.tmp = tempfile.TemporaryDirectory()
        self.addCleanup(self.tmp.cleanup)
        root = Path(self.tmp.name)
        (root / "tb").mkdir()
        (root / "tb" / "x.spice").write_text("v1 out 0 dc {vdd_val}\n")
        (root / "tb" / "tb.json").write_text(
            json.dumps(
                {
                    "name": "x",
                    "netlist": "x.spice",
                    "measure": {"vout": "v(out)"},
                }
            )
        )
        self.tb = testbench.load(root / "tb")
        self.pdk = fake_pdk(root / "gf180mcuD")
        self.tt_point = corners.build_grid(corners.resolve_corners(["tt"]), (27,), [3.3])[0]
        self.ss_point = corners.build_grid(corners.resolve_corners(["ss"]), (27,), [3.3])[0]
        self.workdir = root / "work"
        self.bin_dir = root / "bin"
        self.bin_dir.mkdir()
        path_patcher = mock.patch.dict(
            os.environ, {"PATH": f"{self.bin_dir}{os.pathsep}{os.environ.get('PATH', '')}"}
        )
        path_patcher.start()
        self.addCleanup(path_patcher.stop)
        # These tests are about *that* the process group dies and is
        # reported correctly, not about timing precision -- keep the
        # kill-after escalation short so a SIGTERM-ignoring fake ngspice
        # doesn't make the suite slow.
        grace_patcher = mock.patch.object(runner, "KILL_GRACE_S", 1)
        grace_patcher.start()
        self.addCleanup(grace_patcher.stop)

    def _assert_process_is_dead(self, pid: int, within_s: float = 5.0) -> None:
        deadline = time.monotonic() + within_s
        while time.monotonic() < deadline:
            try:
                os.kill(pid, 0)
            except ProcessLookupError:
                return
            time.sleep(0.1)
        self.fail(f"pid {pid} is still alive {within_s}s after the timeout should have killed it")

    def test_fast_success_is_not_misclassified_as_a_timeout(self):
        _install_fake_ngspice(self.bin_dir, "#!/usr/bin/env python3\nprint('m_vout = 1.0')\n")
        result = runner.run_one(self.tb, self.pdk, self.tt_point, self.workdir, timeout_s=5)
        self.assertEqual(result.status, "ok")
        self.assertEqual(result.measurements, {"vout": 1.0})

    def test_hung_run_without_a_watchdog_is_killed_by_the_in_process_guard(self):
        pidfile = self.tmp_path_for("child.pid")
        self.workdir.mkdir(parents=True, exist_ok=True)
        _install_fake_ngspice(
            self.bin_dir,
            "#!/usr/bin/env python3\n"
            "import os, signal, time\n"
            "signal.signal(signal.SIGTERM, signal.SIG_IGN)\n"
            f"open({str(pidfile)!r}, 'w').write(str(os.getpid()))\n"
            "time.sleep(120)\n",
        )
        with mock.patch.object(runner, "timeout_bin", return_value=None):
            started = time.monotonic()
            result = runner.run_one(self.tb, self.pdk, self.tt_point, self.workdir, timeout_s=1)
            elapsed = time.monotonic() - started
        self.assertEqual(result.status, "timeout")
        self.assertIn("deck", result.message)
        self.assertLess(elapsed, 15, "in-process guard should not wait past its own bound")
        self.assertIn("TIMEOUT", (self.workdir / result.log_name).read_text())
        # The fake ngspice process itself must actually be dead, not merely
        # unwaited-for -- this is exactly what the incident's ngspice failed
        # to do (it ran ~4.5h with nothing left to enforce a bound).
        self._assert_process_is_dead(int(pidfile.read_text()))

    @unittest.skipUnless(runner.timeout_bin(), "no timeout(1)/gtimeout on PATH")
    def test_watchdog_kills_the_whole_process_group_including_children(self):
        grandchild_pidfile = self.tmp_path_for("grandchild.pid")
        self.workdir.mkdir(parents=True, exist_ok=True)
        _install_fake_ngspice(
            self.bin_dir,
            "#!/usr/bin/env python3\n"
            "import os, signal, time\n"
            "signal.signal(signal.SIGTERM, signal.SIG_IGN)\n"
            "pid = os.fork()\n"
            "if pid == 0:\n"
            "    signal.signal(signal.SIGTERM, signal.SIG_IGN)\n"
            f"    open({str(grandchild_pidfile)!r}, 'w').write(str(os.getpid()))\n"
            "    time.sleep(120)\n"
            "else:\n"
            "    time.sleep(120)\n",
        )
        result = runner.run_one(self.tb, self.pdk, self.tt_point, self.workdir, timeout_s=1)
        self.assertEqual(result.status, "timeout")
        deadline = time.monotonic() + 5.0
        while not grandchild_pidfile.exists() and time.monotonic() < deadline:
            time.sleep(0.05)
        self.assertTrue(grandchild_pidfile.exists(), "grandchild never even started")
        # A kill of only the direct child (ngspice) would leave this
        # grandchild running -- exactly the AC #2 regression this guards.
        self._assert_process_is_dead(int(grandchild_pidfile.read_text()))

    def test_parallel_hung_and_quick_runs_have_independent_timeouts(self):
        """A hung corner must not delay or extend a sibling's own bound
        (the -j/ThreadPoolExecutor edge case from issue #83's test plan).
        Both share the one fake ``ngspice`` on PATH; it tells the two apart
        by which corner's deck it was asked to run (embedded in the deck
        filename by ``compose_deck``)."""
        _install_fake_ngspice(
            self.bin_dir,
            "#!/usr/bin/env python3\n"
            "import sys, time\n"
            "deck = sys.argv[-1]\n"
            "if 'ss_' in deck:\n"
            "    time.sleep(120)\n"
            "else:\n"
            "    print('m_vout = 1.0')\n",
        )
        import concurrent.futures

        with concurrent.futures.ThreadPoolExecutor(max_workers=2) as pool:
            started = time.monotonic()
            slow = pool.submit(
                runner.run_one, self.tb, self.pdk, self.ss_point,
                self.workdir / "ss", timeout_s=2,
            )
            fast = pool.submit(
                runner.run_one, self.tb, self.pdk, self.tt_point,
                self.workdir / "tt", timeout_s=30,
            )
            fast_result = fast.result(timeout=10)
            fast_elapsed = time.monotonic() - started
            slow_result = slow.result(timeout=10)

        self.assertEqual(fast_result.status, "ok")
        self.assertEqual(slow_result.status, "timeout")
        # The fast corner must not have been held up waiting on the slow
        # one's own (much longer) bound.
        self.assertLess(fast_elapsed, 5.0)

    def _run_fake(self, body: str):
        _install_fake_ngspice(self.bin_dir, "#!/usr/bin/env python3\n" + body)
        return runner.run_one(self.tb, self.pdk, self.tt_point, self.workdir, timeout_s=5)

    def test_nonzero_exit_with_all_measurements_fails_and_keeps_evidence(self):
        result = self._run_fake("import sys\nprint('m_vout = 3.3')\nsys.exit(1)\n")
        self.assertEqual(result.status, "failed")
        self.assertEqual(result.measurements, {"vout": 3.3})
        self.assertIn("exit 1", result.message)
        self.assertIn("m_vout = 3.3", (self.workdir / result.log_name).read_text())

    def test_zero_exit_with_fatal_diagnostic_fails(self):
        result = self._run_fake("print('m_vout = 3.3')\nprint('Error: failed analysis')\n")
        self.assertEqual(result.status, "failed")
        self.assertEqual(result.measurements, {"vout": 3.3})
        self.assertIn("Error: failed analysis", result.message)

    def test_nonfatal_meas_errors_with_clean_exit_remain_ok(self):
        result = self._run_fake(
            "print('Error: measure  t1b  when(WHEN) : out of interval')\n"
            "print('Error: RHS \"(t1b-t1a)/nper\" invalid')\n"
            "print('m_vout = 3.3')\n"
        )
        self.assertEqual(result.status, "ok", result.message)
        self.assertEqual(result.measurements, {"vout": 3.3})

    def test_nonzero_exit_message_includes_code_and_diagnostic(self):
        result = self._run_fake(
            "import sys\nprint('m_vout = 3.3')\nprint('doAnalyses: bad')\nsys.exit(3)\n"
        )
        self.assertEqual(result.status, "failed")
        self.assertIn("exit 3", result.message)
        self.assertIn("doAnalyses: bad", result.message)

    def test_benign_warnings_remain_ok(self):
        result = self._run_fake(
            "print('Warning: something minor')\n"
            "print('note: no error found, 0 errors')\n"
            "print('m_vout = 3.3')\n"
        )
        self.assertEqual(result.status, "ok")

    def test_missing_measurement_still_fails(self):
        result = self._run_fake("print('nothing useful')\n")
        self.assertEqual(result.status, "failed")
        self.assertEqual(result.missing, ["vout"])
        self.assertNotIn("non-finite", result.message)

    def test_overflowed_sole_measurement_fails_naming_it(self):
        # Issue #527: zero exit, no fatal diagnostic, the requested name is
        # present -- but the value overflows float() to +/-inf.
        for raw in ("1e999", "-1e999"):
            with self.subTest(raw=raw):
                result = self._run_fake(f"print('m_vout = {raw}')\n")
                self.assertEqual(result.status, "failed")
                self.assertIn("non-finite measurements: vout", result.message)
                self.assertIn(raw, result.message)
                # Absent and invalid stay distinguishable.
                self.assertNotIn("missing measurements", result.message)
                self.assertNotIn("no measurements parsed", result.message)
                self.assertEqual(result.missing, [])
                self.assertEqual(result.non_finite, ["vout"])
                # No inf leaks into the retained diagnostic values ...
                self.assertEqual(result.measurements, {})
                # ... and the raw log keeps the invalid output for diagnosis.
                log = (self.workdir / result.log_name).read_text()
                self.assertIn(f"m_vout = {raw}", log)

    def test_literal_inf_and_nan_cannot_succeed(self):
        for raw in ("inf", "-inf", "Infinity", "nan", "NaN"):
            with self.subTest(raw=raw):
                result = self._run_fake(f"print('m_vout = {raw}')\n")
                self.assertEqual(result.status, "failed")
                self.assertIn("vout", result.message)
                self.assertEqual(result.measurements, {})

    def test_last_printed_value_decides_finiteness(self):
        result = self._run_fake("print('m_vout = 1e999')\nprint('m_vout = 1.5')\n")
        self.assertEqual(result.status, "ok", result.message)
        self.assertEqual(result.measurements, {"vout": 1.5})
        result = self._run_fake("print('m_vout = 1.5')\nprint('m_vout = 1e999')\n")
        self.assertEqual(result.status, "failed")
        self.assertEqual(result.measurements, {})

    def test_non_finite_combines_with_other_failure_reasons(self):
        result = self._run_fake(
            "import sys\nprint('m_vout = 1e999')\nprint('Error: failed analysis')\n"
            "sys.exit(2)\n"
        )
        self.assertEqual(result.status, "failed")
        self.assertIn("exit 2", result.message)
        self.assertIn("Error: failed analysis", result.message)
        self.assertIn("non-finite measurements: vout", result.message)

    def test_finite_scientific_negative_and_zero_remain_ok(self):
        for raw, value in (
            ("1.5e+300", 1.5e300),
            ("-4.5e-05", -4.5e-05),
            ("0", 0.0),
            ("-0.0", 0.0),
            ("2.2250738585072014e-308", 2.2250738585072014e-308),
        ):
            with self.subTest(raw=raw):
                result = self._run_fake(f"print('m_vout = {raw}')\n")
                self.assertEqual(result.status, "ok", result.message)
                self.assertEqual(result.measurements, {"vout": value})

    def tmp_path_for(self, name: str) -> Path:
        return Path(self.tmp.name) / name


if __name__ == "__main__":
    unittest.main()


class TimeoutBoundValidationTests(unittest.TestCase):
    """A zero timeout makes coreutils ``timeout(1)`` disable its bound, so
    nonpositive (and non-integer) bounds are refused by the runner itself
    before any file is created or any child is spawned (#563)."""

    def setUp(self):
        self.tmp = tempfile.TemporaryDirectory()
        self.addCleanup(self.tmp.cleanup)
        root = Path(self.tmp.name)
        (root / "tb").mkdir()
        (root / "tb" / "x.spice").write_text("v1 out 0 dc {vdd_val}\n")
        (root / "tb" / "tb.json").write_text(
            json.dumps({"name": "x", "netlist": "x.spice", "measure": {"vout": "v(out)"}})
        )
        self.tb = testbench.load(root / "tb")
        self.pdk = fake_pdk(root / "gf180mcuD")
        self.point = corners.build_grid(corners.resolve_corners(["tt"]), (27,), [3.3])[0]
        self.workdir = root / "work"

    def test_run_one_rejects_invalid_bounds_before_creating_or_spawning(self):
        for bad in (0, -1, -3600, True, 1.5, "10", None):
            with self.subTest(timeout_s=bad):
                with mock.patch.object(runner.subprocess, "Popen") as popen:
                    with self.assertRaises(ValueError) as ctx:
                        runner.run_one(self.tb, self.pdk, self.point, self.workdir, timeout_s=bad)
                self.assertIn("positive integer", str(ctx.exception))
                popen.assert_not_called()
                self.assertFalse(self.workdir.exists())

    def test_run_point_rejects_invalid_bounds_before_running(self):
        with mock.patch.object(runner, "run_one") as run_one:
            with self.assertRaises(ValueError):
                runner.run_point(self.tb, self.pdk, self.point, self.workdir, None, timeout_s=0)
        run_one.assert_not_called()
        self.assertFalse(self.workdir.exists())

    def test_positive_bound_reaches_the_watchdog_command_unchanged(self):
        proc = mock.Mock(returncode=0)
        proc.communicate.return_value = ("m_vout = 1.65\n", "")
        proc.pid = 1
        for watchdog in ("/usr/bin/timeout", None):
            with self.subTest(watchdog=watchdog):
                with mock.patch.object(runner, "timeout_bin", return_value=watchdog), \
                        mock.patch.object(runner.subprocess, "Popen", return_value=proc) as popen:
                    result = runner.run_one(self.tb, self.pdk, self.point, self.workdir, timeout_s=17)
                self.assertEqual(result.status, "ok")
                cmd = popen.call_args.args[0]
                if watchdog:
                    self.assertIn("17s", cmd)
                    guard = 17 + runner.KILL_GRACE_S + runner._GUARD_PAD_S
                else:
                    guard = 17
                proc.communicate.assert_called_with(timeout=guard)

    def test_default_bound_is_positive(self):
        self.assertEqual(runner.validate_timeout_s(runner.DEFAULT_TIMEOUT_S), runner.DEFAULT_TIMEOUT_S)


class InputCaptureDeckTests(unittest.TestCase):
    """Decks consume the SPICE bytes captured at load, not the live files
    (#515). A stub ngspice keeps this PDK- and simulator-free."""

    def setUp(self):
        self.tmp = tempfile.TemporaryDirectory()
        self.addCleanup(self.tmp.cleanup)
        self.root = Path(self.tmp.name)
        tbd = self.root / "tb"
        tbd.mkdir()
        self.frag = tbd / "x.spice"
        self.dut = self.root / "dut.spice"
        self.frag.write_text("v1 out 0 dc {vdd_val}\n")
        self.dut.write_text("* dut original\n")
        (tbd / "tb.json").write_text(json.dumps({
            "name": "x", "netlist": "x.spice", "design_netlist": str(self.dut),
            "measure": {"vout": "v(out)"},
        }))
        self.tb = testbench.load(tbd)
        self.pdk = fake_pdk(self.root / "gf180mcuD")
        self.points = corners.build_grid(corners.resolve_corners(["tt", "ss"]), (27,), [3.3])

    def _included(self, deck: str, name: str) -> Path:
        for line in deck.splitlines():
            if line.startswith(".include") and name in line:
                return Path(line.split('"')[1])
        self.fail(f"no include of {name} in deck")

    def test_edits_between_corner_launches_do_not_reach_later_decks(self):
        decks = []
        with mock.patch.object(runner, "NGSPICE", "true"), \
                mock.patch.object(runner, "timeout_bin", return_value=None):
            for i, point in enumerate(self.points):
                if i == 1:  # mutate the originals between corner launches
                    self.frag.write_text("v1 out 0 dc 99\n")
                    self.dut.write_text("* dut MUTATED\n")
                wd = self.root / "work" / point.corner_id
                runner.run_one(self.tb, self.pdk, point, wd, timeout_s=5)
                decks.append((wd, (wd / f"{point.corner_id}.spice").read_text()))
        for wd, deck in decks:
            frag = self._included(deck, "tb.fragment.spice")
            dut = self._included(deck, "dut.netlist.spice")
            self.assertEqual(frag.parent, wd)
            self.assertEqual(frag.read_text(), "v1 out 0 dc {vdd_val}\n")
            self.assertEqual(dut.read_text(), "* dut original\n")
            self.assertNotIn(str(self.frag), deck)
            self.assertNotIn(str(self.dut), deck)

    def test_without_snapshot_dir_live_paths_are_used(self):
        deck = runner.compose_deck(self.tb, self.pdk, self.points[0])
        self.assertIn(str(self.frag.resolve()), deck)
        self.assertIn(str(self.dut), deck)

    def test_hand_built_testbench_keeps_live_paths(self):
        tb = testbench.Testbench(directory=self.root, slug="h", netlist=self.frag)
        deck = runner.compose_deck(tb, self.pdk, self.points[0], snapshot_dir=self.root / "w")
        self.assertIn(str(self.frag), deck)
        self.assertNotIn("tb.fragment.spice", deck)


class ArtifactCollisionTests(unittest.TestCase):
    """run_one refuses a colliding DUT include before writing or launching."""

    def test_run_one_refuses_before_any_write_or_launch(self):
        with tempfile.TemporaryDirectory() as t:
            root = Path(t)
            dutdir = root / "dutdir"
            dutdir.mkdir()
            (dutdir / "dut.spice").write_text('.include "tt_27c_3.30v.spice"\n')
            (dutdir / "tt_27c_3.30v.spice").write_text("* dep\n")
            tbd = root / "tb" / "x"
            tbd.mkdir(parents=True)
            (tbd / "x.spice").write_text("v1 out 0 dc {vdd_val}\n")
            (tbd / "tb.json").write_text(json.dumps({
                "name": "x", "netlist": "x.spice", "measure": {"vout": "v(out)"},
                "design_netlist": str(dutdir / "dut.spice"),
            }))
            tb = testbench.load(tbd)
            point = corners.build_grid(corners.resolve_corners(["tt"]), (27,), [3.3])[0]
            workdir = root / "work"
            with mock.patch.object(runner.subprocess, "Popen") as popen:
                with self.assertRaises(ValueError) as ctx:
                    runner.run_one(tb, fake_pdk(root / "pdk"), point, workdir)
            self.assertIn("tt_27c_3.30v.spice", str(ctx.exception))
            popen.assert_not_called()
            self.assertFalse(workdir.exists())


class StartupPolicyTests(unittest.TestCase):
    """Issue #575: both launch paths enforce one explicit ngspice start-up
    policy (``-n`` + pinned ``SPICE_SCRIPTS``), proven against hostile
    initialization fixtures that live only in temporary directories."""

    def _launch(self, watchdog):
        tmp = tempfile.TemporaryDirectory()
        self.addCleanup(tmp.cleanup)
        root = Path(tmp.name)
        (root / "tb").mkdir()
        (root / "tb" / "x.spice").write_text("v1 out 0 dc {vdd_val}\n")
        (root / "tb" / "tb.json").write_text(
            json.dumps({"name": "x", "netlist": "x.spice", "measure": {"vout": "v(out)"}})
        )
        tb = testbench.load(root / "tb")
        point = corners.build_grid(corners.resolve_corners(["tt"]), (27,), [3.3])[0]
        proc = mock.Mock(returncode=0)
        proc.communicate.return_value = ("m_vout = 1.65\n", "")
        proc.pid = 1
        with mock.patch.object(runner, "timeout_bin", return_value=watchdog), \
                mock.patch.object(runner.subprocess, "Popen", return_value=proc) as popen, \
                mock.patch.dict(os.environ, {"SPICE_SCRIPTS": "/hostile", "SPICE_LIB_DIR": "/hostile"}):
            runner.run_one(tb, fake_pdk(root / "gf180mcuD"), point, root / "work", timeout_s=9)
        return popen.call_args

    def test_both_launch_paths_carry_the_same_policy(self):
        for watchdog in ("/usr/bin/timeout", None):
            with self.subTest(watchdog=watchdog):
                call = self._launch(watchdog)
                cmd = call.args[0]
                at = cmd.index(runner.NGSPICE)
                self.assertEqual(cmd[at:at + 3], [runner.NGSPICE, "-n", "-b"])
                self.assertEqual(cmd[0] == "/usr/bin/timeout", watchdog is not None)
                env = call.kwargs["env"]
                # The child reads the run's own captured copy (#582), not the
                # live checkout directory.
                self.assertEqual(env["SPICE_SCRIPTS"], str(call.kwargs["cwd"].resolve()))
                self.assertNotEqual(env["SPICE_SCRIPTS"], str(startup.SCRIPTS_DIR))
                self.assertEqual(
                    (call.kwargs["cwd"] / "spinit").read_bytes(), startup.SPINIT_PATH.read_bytes()
                )
                self.assertNotIn("SPICE_LIB_DIR", env)
                self.assertTrue(call.kwargs["start_new_session"])

    def test_pinned_spinit_is_inert_and_its_hash_is_reported(self):
        lines = [
            ln for ln in startup.SPINIT_PATH.read_text().splitlines()
            if ln.strip() and not ln.lstrip().startswith("*")
        ]
        self.assertEqual(lines, [])
        meta = startup.metadata()
        self.assertEqual(meta["spinit_sha256"], startup.spinit_sha256())
        self.assertEqual(len(meta["spinit_sha256"]), 64)
        self.assertTrue((SIM_DIR.parent / meta["spinit"]).is_file())

    def _tb_and_point(self, root):
        (root / "tb").mkdir()
        (root / "tb" / "x.spice").write_text("v1 out 0 dc {vdd_val}\n")
        (root / "tb" / "tb.json").write_text(
            json.dumps({"name": "x", "netlist": "x.spice", "measure": {"vout": "v(out)"}})
        )
        point = corners.build_grid(corners.resolve_corners(["tt"]), (27,), [3.3])[0]
        return testbench.load(root / "tb"), point

    def test_edit_after_capture_changes_neither_consumed_bytes_nor_digest(self):
        """#582: every launch (both watchdog paths, several points) consumes
        the bytes captured before the first one, and the recorded digest
        identifies those bytes, whatever the live file does afterwards."""
        for watchdog in ("/usr/bin/timeout", None):
            with self.subTest(watchdog=watchdog), tempfile.TemporaryDirectory() as tmp:
                root = Path(tmp)
                live = root / "live-spinit"
                live.write_bytes(b"* original\n")
                tb, point = self._tb_and_point(root)
                proc = mock.Mock(returncode=0)
                proc.communicate.return_value = ("m_vout = 1.65\n", "")
                proc.pid = 1
                with mock.patch.object(startup, "SPINIT_PATH", live):
                    snap = startup.capture()
                live.write_bytes(b"echo EDITED_AFTER_CAPTURE\n")  # mid-sweep edit
                calls = []
                with mock.patch.object(runner, "timeout_bin", return_value=watchdog), \
                        mock.patch.object(runner.subprocess, "Popen", return_value=proc) as popen, \
                        mock.patch.object(startup, "SPINIT_PATH", live):
                    for name in ("pt-a", "pt-b"):
                        runner.run_one(
                            tb, fake_pdk(root / "gf180mcuD"), point, root / name,
                            timeout_s=9, startup_snapshot=snap,
                        )
                        calls.append(popen.call_args)
                    meta = startup.metadata(snap)
                for call, name in zip(calls, ("pt-a", "pt-b")):
                    scripts = Path(call.kwargs["env"]["SPICE_SCRIPTS"])
                    self.assertEqual(scripts, (root / name).resolve())
                    self.assertEqual((scripts / "spinit").read_bytes(), b"* original\n")
                self.assertEqual(meta["spinit_sha256"], hashlib.sha256(b"* original\n").hexdigest())
                self.assertEqual(meta["spinit_snapshot"], "spinit")

    def test_write_snapshot_refuses_a_changed_copy(self):
        with tempfile.TemporaryDirectory() as tmp:
            snap = startup.Snapshot(b"* a\n")
            startup.write_snapshot(snap, Path(tmp))
            startup.write_snapshot(snap, Path(tmp))  # identical: no-op
            (Path(tmp) / "spinit").write_bytes(b"* b\n")
            with self.assertRaisesRegex(RuntimeError, "modified during the run"):
                startup.write_snapshot(snap, Path(tmp))

    def test_dut_include_may_not_take_the_snapshot_name(self):
        self.assertIn(startup.SNAPSHOT_NAME, testbench.fixed_artifact_names())

    @unittest.skipUnless(shutil.which("ngspice"), "ngspice not on PATH; snapshot probe skipped")
    def test_ngspice_reads_the_snapshot_not_the_live_script(self):
        """PDK-free: a sentinel in the captured copy is echoed by ngspice;
        a different sentinel in the live file (edited after capture) is not."""
        with tempfile.TemporaryDirectory() as tmp:
            root = Path(tmp)
            live = root / "live-spinit"
            live.write_text("echo SENTINEL_CAPTURED\n")
            with mock.patch.object(startup, "SPINIT_PATH", live):
                snap = startup.capture()
            live.write_text("echo SENTINEL_LIVE_EDIT\n")
            work = root / "work"
            startup.write_snapshot(snap, work)
            deck = work / "d.cir"
            deck.write_text("* probe\nV1 a 0 1\nR1 a 0 1k\n.op\n.end\n")
            env = startup.environment(
                {k: v for k, v in os.environ.items() if not k.startswith("SPICE_")},
                scripts_dir=work.resolve(),
            )
            out = subprocess.run(
                runner.ngspice_command(deck, None, 60), env=env, cwd=work,
                capture_output=True, text=True, timeout=60,
            ).stdout
            self.assertIn("SENTINEL_CAPTURED", out)
            self.assertNotIn("SENTINEL_LIVE_EDIT", out)

    @unittest.skipUnless(shutil.which("ngspice"), "ngspice not on PATH; hostile-fixture probe skipped")
    def test_hostile_init_fixtures_affect_plain_batch_but_not_the_policy(self):
        with tempfile.TemporaryDirectory() as tmp:
            root = Path(tmp)
            for d in ("home", "work", "scripts", "userdeck"):
                (root / d).mkdir()
            (root / "home" / ".spiceinit").write_text("echo SENTINEL_USER\n")
            (root / "work" / ".spiceinit").write_text("echo SENTINEL_WORK\n")
            (root / "scripts" / "spinit").write_text("echo SENTINEL_SYSTEM\n")
            deck_text = "* probe\nV1 a 0 1\nR1 a 0 1k\n.op\n.end\n"
            deck = root / "work" / "d.cir"
            deck.write_text(deck_text)
            # Deck copy outside every hostile .spiceinit directory. The
            # user-init sanity case must not reuse the work-directory deck:
            # ngspice-46 searches the deck's directory first (measured in
            # sim/tool-experiments/2026-10-11-ngspice46-startup-lookup/),
            # so a deck inside work/ keeps SENTINEL_WORK reachable however
            # the cwd moves.
            userdeck = root / "userdeck" / "d.cir"
            userdeck.write_text(deck_text)
            hostile = {
                **{k: v for k, v in os.environ.items() if not k.startswith("SPICE_")},
                "HOME": str(root / "home"),
                "SPICE_SCRIPTS": str(root / "scripts"),
            }

            def run(cmd, env, cwd):
                return subprocess.run(
                    cmd, env=env, cwd=cwd, capture_output=True, text=True, timeout=60
                ).stdout

            # Sanity: the fixtures are effective under ordinary batch mode.
            # Each plain launch leaves exactly one .spiceinit reachable for
            # the source it names -- whichever of the working directory
            # (ngspice-42) or the deck's directory (ngspice-46) is searched,
            # the work launch runs where the two coincide, and the user
            # launch uses a deck copy with no .spiceinit around it -- plus
            # spinit from SPICE_SCRIPTS. Only one of the two .spiceinit
            # fixtures runs per launch on both measured builds.
            plain = run(["ngspice", "-b", str(deck)], hostile, root / "work")
            self.assertIn("SENTINEL_WORK", plain)
            self.assertIn("SENTINEL_SYSTEM", plain)
            self.assertNotIn("SENTINEL_USER", plain)
            nowork = root / "nowork"
            nowork.mkdir()
            plain_user = run(["ngspice", "-b", str(userdeck)], hostile, root / "userdeck")
            self.assertIn("SENTINEL_USER", plain_user)
            self.assertNotIn("SENTINEL_WORK", plain_user)

            # Controlled launch (command builder + environment builder).
            cmd = runner.ngspice_command(deck, None, 60)
            env = startup.environment(hostile)
            for cwd in (root / "work", nowork):
                out = run(cmd, env, cwd)
                self.assertNotIn("SENTINEL", out)
                self.assertIn("Circuit:", out)
