2AMLogic/gf180-trng/sim/tests/test_active_power_breakdown.py

#!/usr/bin/env python3
"""Unit tests for the per-sub-block active power breakdown (#790).

Pure Python, no OpenROAD, no ngspice: the by-block parser and grouping run on
synthetic ``report_power -instances`` output, and the breakdown tool runs over
the committed records. Properties held:

1. Instances are grouped by hierarchy prefix, CTS clock cells and the rest, and
   every instance lands in exactly one group.
2. Malformed power output is rejected rather than read as zero.
3. The committed breakdown reconciles with ``power_rollup.py``'s own terms at
   both the historical and the ratified rate.
4. The digital rate scaling is exact at the measurement rate and holds leakage
   constant.
"""

from __future__ import annotations

import re
import sys
import unittest
from pathlib import Path

SIM_DIR = Path(__file__).resolve().parents[1]
sys.path.insert(0, str(SIM_DIR))
sys.path.insert(0, str(SIM_DIR / "tools"))
sys.path.insert(0, str(SIM_DIR / "tb" / "digital-sta-power"))
sys.path.insert(0, str(SIM_DIR / "tb" / "digital-power-by-block"))

import activity  # noqa: E402
import active_power_breakdown as apb  # noqa: E402
import power_rollup as pr  # noqa: E402
import run_by_block as rbb  # noqa: E402
import run_sta  # noqa: E402

REPO_ROOT = SIM_DIR.parent
SPLIT_DECK = SIM_DIR / "tb" / "ro-array-core-power-split" / "tb_ro_array_core_power_split.sp"
SHIPPED = REPO_ROOT / "design" / "ro_array_core.spice"

SYNTHETIC = """
junk before
BLOCK_BEGIN
     Internal    Switching      Leakage        Total
        Power        Power        Power        Power (Watts)
----------------------------------------------------
 1.0e-06 2.0e-06 3.0e-07 3.3e-06 u_conditioner/_1_
 1.0e-06 0.0e+00 1.0e-07 1.1e-06 u_health_test/_2_
 4.0e-06 1.0e-06 1.0e-07 5.1e-06 u_interface/_3_
 2.0e-06 1.0e-06 1.0e-07 3.1e-06 clkbuf_leaf_0_clk
 1.0e-07 1.0e-07 1.0e-07 3.0e-07 max_cap62
 1.0e-07 0.0e+00 1.0e-07 2.0e-07 u_unknown/_4_
BLOCK_END
"""


class GroupingTests(unittest.TestCase):
    def test_group_of(self):
        self.assertEqual(rbb.group_of("u_conditioner/_1_"), "u_conditioner")
        self.assertEqual(rbb.group_of("u_ring_liveness/place55"), "u_ring_liveness")
        self.assertEqual(rbb.group_of("clkbuf_leaf_8_clk"), rbb.CLOCK_TREE)
        self.assertEqual(rbb.group_of("clkload3"), rbb.CLOCK_TREE)
        self.assertEqual(rbb.group_of("max_cap62"), rbb.OTHER)
        # An unknown hierarchy prefix is not silently attributed to a sub-block.
        self.assertEqual(rbb.group_of("u_unknown/_4_"), rbb.OTHER)

    def test_every_instance_lands_in_one_group(self):
        rows = rbb.parse_instance_rows(SYNTHETIC)
        self.assertEqual(len(rows), 6)
        groups = rbb.aggregate(rows)
        self.assertEqual(sum(g["n"] for g in groups.values()), 6)
        self.assertAlmostEqual(
            sum(g["total_w"] for g in groups.values()), sum(r[4] for r in rows), places=15
        )
        self.assertEqual(groups["u_conditioner"]["n"], 1)
        self.assertEqual(groups[rbb.OTHER]["n"], 2)

    def test_missing_block_is_an_error(self):
        with self.assertRaises(run_sta.StaError):
            rbb.parse_instance_rows("no markers here")


def _segment(annot: str, rows: str, total: str) -> str:
    return (
        "ACT_BEGIN conditioned-streaming steady\n" + annot
        + "BLOCK_BEGIN\n   hdr\n" + rows + "BLOCK_END\n" + total + "ACT_END\n"
    )


_TOTAL = """\
Group                  Internal  Switching    Leakage      Total
                          Power      Power      Power      Power (Watts)
----------------------------------------------------------------
Sequential           0.000000e+00 0.000000e+00 0.000000e+00 0.000000e+00   0.0%
Combinational        0.000000e+00 0.000000e+00 0.000000e+00 0.000000e+00   0.0%
Clock                0.000000e+00 0.000000e+00 0.000000e+00 0.000000e+00   0.0%
Macro                0.000000e+00 0.000000e+00 0.000000e+00 0.000000e+00   0.0%
Pad                  0.000000e+00 0.000000e+00 0.000000e+00 0.000000e+00   0.0%
----------------------------------------------------------------
Total                {i:.6e} {s:.6e} {l:.6e} {t:.6e} 100.0%
"""
_ROWS = (
    " 1.0e-06 2.0e-06 3.0e-07 3.3e-06 u_conditioner/_1_\n"
    " 4.0e-06 1.0e-06 1.0e-07 5.1e-06 u_interface/_3_\n"
    " 2.0e-06 1.0e-06 1.0e-07 3.1e-06 clkbuf_leaf_0_clk\n"
)
_GOOD_ANN = "Annotated 990 pin activities.\nvcd          990\nunannotated     5\n"
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
