2AMLogic/gf180-trng/(commit log)

2026-07-31 docs: survey entropy-source architectures for gf180mcu TRNG (#19)
    Compare RO-jitter, metastability-cell, and noise-amplification
    candidates against ngspice substantiability, gf180mcu device
    availability/area/power, and injection-locking/PVT sensitivity.
    Recommends multi-RO XOR-combined jitter as primary source with a
    scoped metastability tap as the stretch hook for #7.
2026-07-31 docs: add DR-0001..0004 fixing interface, health tests, rate, 90B path (#20)
    Four Proposed decision records resolving the open questions in the DRAFT
    spec table, plus the corresponding table rows:
    - DR-0001: raw tap at the sampler output, always available and never
    gated; mode-selectable streaming (OUT_MODE) plus DATA/RAW_DATA registers.
    - DR-0002: RCT/APT on the raw stream at alpha = 2^-40, APT window 1024,
    cutoffs as formulas in H (draft H0 = 0.5 -> C_RCT 81, C_APT 824) derived
    from the worst-corner H; failure latches a flag and gates the conditioned
    path until explicit clear plus a start-up test.
    - DR-0003: > 1 Mbps is a sustained raw rate at the raw tap, binding at the
    slowest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
2026-07-31 Stand up sim/ PVT harness, bootstrapped from gf180-bandgap#23 (#21)
    Adds sim/run_corners.py: a stdlib-only PVT corner runner for gf180mcu,
    bootstrapping the harness architecture (no-hardcoded-path PDK resolver,
    tt/mos/full corner sets, a testbench contract that rejects fragments
    overriding .temp/.lib/.include/.control/.endc/.end) from the pattern
    merged in 2AMLogic/gf180-bandgap#23, per CLAUDE.md's harness-bootstrap
    directive.
    The evidence-record writer (sim/harness/report.py) targets this repo's
    own already-ratified sim/README.md format instead of gf180-bandgap's
    aggregate-grid record: one record per (testbench, PVT point), not one
    record per invocation. DR-0005 documents the reconciliatio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
    [test_corners.py]
2026-07-31 feat: characterize gf180mcu RO delay-cell jitter and device noise across PVT (#24)
    Adds transient-noise jitter testbenches for two candidate RO delay-cell
    topologies (plain inverter, current-starved inverter) at 3/5/9 stages,
    plus device .noise cross-check, analytic PSD/Johnson-noise anchors,
    flicker-sensitivity and linearity supplementary checks. Runs a documented,
    cost-bounded PVT/seed grid (DR-0006) instead of a full 5-corner factorial,
    with full PVT-grid diligence on one flagship 5-stage reference config.
    Also fixes two real defects in the sim harness surfaced by running this
    characterization at scale: (1) sim/run_corners.py buffered every evidence
    record until an entire -j-parallel gri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
    [test_report.py]
2026-07-31 ci: run the harness self-checks on GitHub Actions (#31)
    Adds .github/workflows/ci.yml, the repo's first workflow. On every push to
    main and every pull request it runs the checks that need no PDK:
    - a Python/shell syntax check (compileall + bash -n)
    - the harness unit tests (56 cases) on Python 3.10 and 3.13
    - sim/selftest.sh, whose PDK-dependent stages detect the missing PDK and
    skip themselves on a hosted runner -- so CI also covers the acceptance
    script's argument handling, environment probe, and skip path
    The smoke run and corner-sanity check stay off the PR path: both need
    ngspice >= 46 and a ~5 GB gf180mcu PDK fetch. The workflow header carries
    the full self-check inventory, stati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
2026-07-31 ci: add a scheduled workflow that runs the PDK-dependent sim stages (#34)
    sim/selftest.sh stages 3 (end-to-end smoke run) and 4 (the corner-sanity
    guardrail) self-skip on the PR path because they need ngspice >= 46 and the
    gf180mcu PDK, so nothing exercised them unattended.
    Add .github/workflows/pdk-nightly.yml, triggered only by `schedule` and
    `workflow_dispatch`, which builds the pinned ngspice release from source
    (checksum-verified), installs the gf180mcu PDK at a pinned open_pdks commit
    via ciel, caches both, and runs `sim/selftest.sh --require-pdk` -- the form
    that fails instead of skipping. A final step fails the job if anything
    appeared under sim/records/, since evidence records are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
2026-08-01 sim: measure per-ring active supply current and stopped-ring leakage (#38)
    Adds the first supply-current and leakage evidence this repository has
    had. Three new testbenches, all runnable through sim/run_corners.py with
    no manual netlist edits, and 117 append-only evidence records:
    - sim/tb/ro-inv-05stage-power/ -- free-running candidate-A 5-stage ring,
    mean supply current by charge integration over an exact integer number
    of oscillation periods (deterministic .tran, no seeds needed). Full
    {tt,ff,ss} x 3 temperature x 3 supply grid, 27 records. Also reports
    the effective per-node switched capacitance the CV^2f model needs.
    - sim/tb/ro-inv-05stage-stopped-leakage/ -- the same ring mad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
2026-08-01 fix: try ~/.ciel before ~/.volare when resolving the gf180mcu PDK (#40)
    Flips BUILTIN_SEARCH_ROOTS in sim/harness/pdk.py so a current ciel-installed
    PDK is found before a stale volare-installed one, matching the install
    guidance in INSTALL_HINT (updated by #36) and the README. GF180_PDK_PATH,
    PDK_ROOT, and sim/pdk.json's search_roots all resolve before the built-in
    roots and are unaffected.
    Closes #37
    [test_pdk.py]
2026-08-01 feat: report shadowed gf180mcu PDK installs in --check-env (#41)
    Add find_all_variant_dirs() to sim/harness/pdk.py, an all-search-roots
    walk that collects every valid gf180mcuD-shaped directory instead of
    stopping at the first hit like find_pdk() does. cmd_check_env() now
    calls it and prints a `note:` line for each roots-list search root
    that also has a valid variant dir but lost to the one find_pdk()
    picked, so a shadowed or stale install becomes visible instead of
    silent. GF180_PDK_PATH/PDK_ROOT stay out of the scan since they are
    single explicit locations, not search lists.
2026-08-01 Digital conditioner / post-processing (CRC-32 LFSR, non-vetted, K=8) + behavioral/transistor split (#42)
    * feat: add CRC-32 LFSR digital conditioner with a K=8 non-vetted accounting
    Implements the post-processing stage between the raw tap and the conditioned
    output path, and records the two decisions it was delegated.
    - design/conditioner/: a normative bit-exact behavioural model, synthesisable
    RTL checked against it word-for-word under Icarus Verilog, and an area
    inventory that reads its cell areas out of the installed PDK's own
    standard-cell LEF (361 GE, ~0.005-0.008 mm2 placed).
    - DR-0008 fixes the function (32-bit Galois LFSR, CRC-32 reflected poly,
    state cleared per block), it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
    [area_estimate.py, crc32_conditioner.py, crc32_conditioner.v, run_demo.py, source_model.py, sp800_90b.py, tb_rtl_equivalence.v, test_conditioner.py]
2026-08-01 design: RO-array entropy source, deterministic netlist export, and DR-0010 resolving the rate-vs-power collision (#45)
    * design: add the RO-array entropy source, its netlist export, and DR-0008
    The entropy source now exists as xschem schematics under design/, exported
    deterministically to SPICE and measured against DR-0007 §2's sizing law.
    design/
    - ro_stage / ro_nand2: a minimum-width 3.3 V inverter delay cell with
    always-on series starve devices, so ring frequency is set without
    adding switched capacitance to the ring node.
    - ro_ring11: eleven starved stages closed on themselves, on their own
    supply pin. Eleven and not three because the starved cell measures a
    small-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
    [ro_array_core.sch, ro_array_sanity.sch, ro_nand2.sch, ro_ring11.sch, ro_ring5.sch, ro_stage.sch, xor2.sch]
2026-08-01 Add the metastability-hybrid stretch tap to the RO entropy core (#47)
    * design: metastability-hybrid tap cells and an xschem-version-independent netlist export
    Adds the schematic half of the metastability-hybrid stretch tap: a
    self-timed matched-delay strobe off an RO transition into a cross-coupled
    NAND arbiter, layered on the entropy source without touching it.
    meta_inv / meta_nand2 unstarved minimum-width inverter and NAND2; the
    tap wants the sharpest edge the process gives,
    which is the opposite of what ro_stage wants
    meta_arb the metastable element: cross-coupled NAND SR
    latch, symmetric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
    [meta_arb.sch, meta_inv.sch, meta_nand2.sch, ro_array_core_meta.sch, ro_meta_tap.sch]
2026-08-01 spec: fix DR-0012 transient-noise simulation methodology + jitter-estimator calibration (#50)
    Establishes the seed policy, run-length/claim-support ceiling, and
    noise-model limits that bound every transient-noise entropy claim this
    repo makes, per DR-0004's Tier 2 deferral to "issue #10's methodology
    contract." Generalizes DR-0006's per-testbench seed/PVT trade-off into a
    repo-wide default, names the full SP 800-90B non-IID suite and the
    restart dataset as explicitly not supportable in simulation (closing the
    affordability question DR-0004 left open), and cites (rather than
    re-derives) trnoise-calibration's PSD-mapping result for the noise-model
    section.
    Adds sim/tb/jitter-estimator-calibra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
2026-08-01 Sampler/digitizer: raw tap at the flip-flop output, fixed external sample clock (DR-0011) (#49)
    * design: sampler/digitizer (raw tap), fixed external sample clock (DR-0011)
    Adds the stage between the merged RO-array entropy source and the merged
    digital conditioner: the flip-flop that turns the array's internal XOR node
    into the DR-0001 raw tap, the clock that drives it, and the two testbenches
    that characterise it.
    New cells
    - `sampler_dff` -- static transmission-gate master-slave D flip-flop,
    positive-edge, asynchronous active-low reset. Each latch closes its hold
    loop through TWO inversions; the one-inverter form is not bistable and
    settles at a half-rail voltage by construction,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
    [sampler_core.sch, sampler_dff.sch]
2026-08-01 Measure the jitter-energy constant on the shipped starved cell: a = 13.9x the plain cell's, over a 512-period post-start-up window (#52)
    * sim: long-window starved-cell jitter testbench and its jitter-energy derivation
    Adds sim/tb/ro-ring5-starved-jitter-long/, a transient-noise deck for one
    5-stage ring of the shipped starved delay cell whose measurement window opens
    256 periods after start-up and spans 512 periods, so jitter accumulation can
    be fitted over lags 1..128 (2.11 decades). The existing shipped-cell run
    (sim/records/2026-08-01-ro-array-sanity-jitter-01.md) measured 16 periods
    opened at the second edge, and two diagnostics in that record -- a 0.3 % seed
    spread and a lag^0.81 accu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
    [test_report.py]
2026-08-01 Measure sampler_dff's reset-window contention current across the PVT grid (#54)
    Adds sim/tb/sampler-dff-reset-current-xsv/ (D tied to vdd, continuous
    conduction) and sim/tb/sampler-dff-reset-current-xsb/ (D an ideal square
    wave standing in for the oscillating xo node, ~50% duty) to measure the
    static current path #48 identified: while rst_n=0 and clk=0, sampler_dff's
    input transmission gate and its async-reset pulldown are simultaneously
    ON, so whatever drives D has a resistive path to vss.
    Both testbenches run the full 45-point PVT grid and record results under
    sim/records/. The current is material: a single instance alone exceeds
    the block's <500 uW active-power budget at every corner mea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
2026-08-01 Interface/register block: four registers, a mode-selected streaming port, and two flush scopes (DR-0013) (#55)
    * Add the interface/register block: four registers, a mode-selected streaming port, and two flush scopes
    The last block between the datapath and the outside world had no design
    behind it, so the flow would have reached layout with no top-level port
    map. This adds it as a normative behavioural model plus synthesisable RTL,
    with the register map held in one generated-from table.
    DR-0013 records the decisions. It does not change the ratified spec:
    DR-0001 and DR-0002 already fix the externally visible contract. What was
    missing was addresses, bit positions, reset values, the streamin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
    [regmap.py, run_demo.py, tb_rtl_equivalence.v, test_interface.py, trng_interface.py, trng_interface.v]
2026-08-01 Implement on-die health tests: RCT + APT with fault-injection verification (#57)
    Adds design/health_test/ (bit-exact Python model + synthesizable Verilog RTL)
    implementing the Repetition Count Test, Adaptive Proportion Test, and the
    1024-sample start-up test, with cutoffs computed from a min-entropy parameter
    H per DR-0002's formulas (not hard-coded), defaulting to the draft H0 = 0.5
    values (C_RCT=81, C_APT=824) and refusing to construct a degenerate cutoff.
    Adds sim/tb/health-test-fault-injection/ (behavioral testbench, DR-0009) with
    declared-synthetic fault generators (stuck output, heavily biased stream,
    injection-locked oscillator) and evidence records demonstrating detection
    within DR-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
    [fault_injection.py, rct_apt.py, rct_apt.v, run_demo.py, tb_rtl_equivalence.v, test_health_test.py]
2026-08-02 Gate sampler_dff's reset into the storage-loop inverters, not onto the storage nodes (#59)
    sampler_dff reset by brute force: an NMOS on the master's storage node m
    and a PMOS on the slave's node s, both active whenever rst_n = 0. The
    master's input transmission gate is transparent whenever clk = 0, so while
    rst_n and clk were both low there was a DC path from whatever drives D,
    through that gate, into the reset pull-down. #48 measured it across the
    full PVT grid: 967 uW at tt/27 C/3.30 V and 1.71 mW at ff/-40 C/3.63 V for
    the two sampler_core instances together -- 1.9x to 3.4x the whole block's
    ratified < 500 uW active-power row, at every one of the 90 points measured.
    Replace it with reset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
    [sampler_dff.sch]
2026-08-02 Worst-corner entropy over the full PVT grid: the binding corner moves to ss/+125 C/3.63 V (DR-0015), and MC mismatch does not threaten it (#62)
    * Measure the entropy-binding PVT corner over the full 27-point grid: it moves to ss/+125 C/3.63 V (DR-0014), and device mismatch does not threaten it
    DR-0012-sampler-fixed-external-clock named ss/-40 C/3.63 V as the
    minimum-Q corner, inferred from the only three PVT points the shipped
    array had ever been measured at. This measures all 27 covered points and
    finds the minimum at the other end of the temperature axis: ss/+125 C/
    3.63 V, 8.1% lower in Q. Q ~ T/(P*T0^2), and warming that corner
    lengthens T0 by 66%, whose 1/T0^2 term outweighs both the h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
2026-08-02 feat: reject stray braces in a schematic's T {...} text block, PR-blocking (#63)
    xschem's own parser silently miscounts when a T {...} free-text block's
    content contains a literal brace (even a balanced pair) and corrupts the
    exported netlist with no error from xschem or design/netlist.py. Add a
    pure-Python scan (design/netlist.py --lint) that flags any such brace
    directly from the schematic's text -- no xschem, no PDK -- and wire it
    into export() so every invocation refuses before ever shelling out to
    xschem. Run it as a new PR-blocking step in ci.yml's harness job,
    alongside the existing register-map staleness guard, instead of only in
    the nightly PDK job.
    Also fixes two pre-existing stra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
    [ro_ring11.sch]
2026-08-02 feat: assemble trng_top -- the five-block top-level integration (#27) (#66)
    Add design/xschem/trng_top.sch (instantiating a new sampler_core.sym
    unmodified as the analog half, at the DR-0009 raw-tap boundary) plus
    design/trng_top/ -- a behavioural TopLevel model and an RTL wrapper
    that wire the real conditioner, health-test and interface blocks
    together the way DR-0009 assigns top-level integration to be verified.
    sim/tests/test_trng_top.py mechanically cross-checks the raw tap's
    pin names across the analog/digital boundary, and
    sim/tb/smoke-trng-top/ demonstrates bits flowing end to end at one
    nominal corner, using the transistor-derived raw bits
    sim/tb/sampler-array-digitize/ already captu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
    [trng_top.sch]
2026-08-02 sim: XOR-combiner ring-to-ring coupling explains the array deck's 40x per-ring jitter (#67)
    * sim: three testbench variants isolating the array deck's excess per-ring jitter
    sim/records/2026-08-01-ro-array-sanity-jitter-01.md measures ~40x more
    per-ring jitter, on the same starved delay cell at the same injected noise
    density, than sim/tb/ro-ring5-starved-jitter-long/ does. Two explanations
    are on the table and both predict the same three signatures (seed-
    independent, accumulating faster than sqrt(t), absent from a standalone
    ring): ring-to-ring coupling through the XOR combiner's input stage, and a
    numerical artefact of solving several asynchronous rings on one shared
    adaptive timestep.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
2026-08-02 feat: add per-ring liveness monitor and measure its electrical cost (#69)
    * feat: add per-ring liveness monitor reusing DR-0002's RCT test per ring
    Adds design/health_test/ring_liveness.{py,v} (trng_ring_liveness): N
    independent instances of the health-test block's own Repetition Count
    Test, one per entropy-source ring, each watching that ring's own
    already-digitized sample instead of the XOR-combined raw tap. Closes
    the blind spot DR-0007 flags and DR-0010 sharpens (N=2 means one dead
    ring is half the array, invisible to RCT/APT on the combined stream).
    C_LIVE defaults to rct_apt.c_rct(H0) = 81 -- DR-0002's own draft C_RCT,
    reused rather than re-derived, so a future ratified H (#13) updat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
2026-08-02 Measure start-up, time-to-first-valid and whole-block power: two rows met, the idle row missed 4.5x (#72)
    * sim: measure entropy-array start-up, sampler active energy and block idle leakage
    Three new testbenches and 117 evidence records, plus the Liberty-based
    digital estimate the three RTL-only blocks need because they have no
    netlist to simulate.
    - sim/tb/ro-array-core-startup/: the shipped array started from its real
    idle state -- en low from t=0, no .ic kick (with en low the ring has one
    stable DC solution and needs none, and the running decks' kick would
    actively contaminate a start-up measurement). 27-point grid, matching
    ro-array-core-pvt-q so start-up and steady period are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
    [test_power_rollups.py]
2026-08-02 feat: ship the per-ring liveness tap and wire ring_stuck_any into HT_ALARM (#71)
    DR-0016 designed and verified the per-ring liveness monitor but left two
    integrations as follow-up: nothing consumed `ring_stuck_any`, and the
    `ro1`/`ro2` tap existed only as an ngspice hierarchical-node trick inside
    `sim/tb/ring-liveness-tap-power/`. Both are built here.
    The alarm path. `design/interface/` gains a third failure source,
    `ht_fail_ring`, OR'd into the same `fail_event`/`alarm_now` latch as
    `ht_fail_rct`/`ht_fail_apt`: same alarm, same conditioned-path-only gate,
    same ungated raw path, same explicit-clear-plus-start-up-retest recovery.
    It reports through a new `STATUS.HT_FAIL_RING` bit at **bit 9*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
    [ro_array_core.sch, ro_array_core_meta.sch, sampler_core.sch, trng_top.sch]
2026-08-02 feat: stand up the klt-driven gf180mcu DRC/LVS flow with proving fixtures (#58)
    Adds `layout/verify.py`, a one-command driver that runs `klt drc`,
    `klt extract` and `klt lvs` over three fixtures and checks every result
    against a declared expectation. The expectations are the test: a tool
    that stopped reporting `metal1.width.1`, or a comparer that started
    calling the cut-strap cell a match, fails here. A run that merely ran is
    not a pass.
    The fixtures are one trivial CMOS inverter in three variants, generated
    by `layout/testcells/build.py`:
    trng_tc_inv DRC clean, LVS match -- no false positives
    trng_tc_inv_drcbad 2 named rules, (not LVS'd) -- DRC actually fires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
    [build.py, verify.py]
2026-08-02 fix(layout): pin klt's new LVS warning categories and record the build that produced them (#74)
    `python3 layout/verify.py --require-tools` failed 13 expectations against
    its own committed reports on an unchanged `layout/`. The known-good
    inverter reported `device.body_unverified` x2 and `topology` x1 where the
    golden report had `{}`.
    Root cause, from a `--write` and a diff: not an engine bump. The KLayout
    `environment.engine_version` is `0.30.10` in both the committed and the
    freshly generated report, and `klt --version` is `0.1.0` on both sides.
    klayout-tools has reported `0.1.0` for every build to date, and `pipx`/`uv`
    install it from the tip of its main branch, so the version string cann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
    [verify.py]
2026-08-02 feat: entropy-source floorplan, isolation rationale and area rollup (#77)
    Adds layout/floorplan/: the written isolation rationale for the RO-array
    entropy source, a DRC-clean floorplan abstract that carries it, and an area
    rollup that prices it -- all rebuilt and re-checked by one command.
    The rationale separates three coupling mechanisms that the original
    acceptance criteria treated as one:
    - Injection locking between the rings. Addressed by the non-integer
    frequency ratio already measured in the schematic (1.057-1.062 across
    corners), per-ring supply pins, per-ring guard rings and separation --
    and by an explicit instruction NOT to lay the two rings out as a matched
    pair. Common-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
2026-08-02 feat(sim): measure the per-ring output buffer — 92.8% of the coupling removed, 19.1 uW returned (#80)
    * feat(sim): measure the per-ring buffer's power cost, and stop variant records leaking into the shipped rollups
    Two new testbenches for the mitigation layout/floorplan/README.md proposes
    but declines to adopt -- one minimum-width inverter per ring, between the
    ring node and the XOR combiner, per-ring and never shared:
    - sim/tb/ro-array-coupling-xor-driven-buffered/ is issue #51's variant 3
    (the 28.6x case) plus exactly that one change, sigma still measured at the
    raw ring node upstream of the buffer.
    - sim/tb/ro-array-core-power-buffered/ is sim/tb/ro-array-core-power/ plus
    the sa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
    [test_power_rollups.py, test_report.py]
2026-08-02 fix(layout): stop doubling layout/.work/ in the gen-compose request (#81)
    klt now resolves a gen-compose request's blocks[].generator_report paths
    against the request document's own directory (klayout-tools#328), matching
    klt lvs's long-standing convention. floorplan.py still wrote those paths
    repo-root-relative (layout/.work/fp_guard_ring1.json) into a request that
    already lives at layout/.work/compose-request.json, so klt joined the two
    and looked for layout/.work/layout/.work/fp_guard_ring1.json -- failing the
    composition stage on every clean-tree run.
    generator_report is now written relative to the request file's own
    directory (a plain filename, since both live in layout/.work/). option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
2026-08-03 feat(design): buffer each ring output ahead of every consumer, and re-measure the array against it (#82)
    * feat(design): buffer each ring output ahead of every consumer, and re-measure the array against it
    Adopts the per-ring output buffer that sim/characterization-ring-buffer-mitigation.md
    measured (#75) and layout/floorplan/README.md had proposed but declined to
    adopt. Against a matched quiet-neighbour control the coupling factor falls from
    27.10x to 2.87x -- 92.8% of the excess removed -- and the block's active-power
    rollup at its binding corner improves rather than worsens.
    The design change
    - design/xschem/ro_buf.sch/.sym: a new cell, one minimum-width UNSTARVED
    inverter, device-fo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
    [ro_array_core.sch, ro_buf.sch]
2026-08-03 fix(sim): make ngspice's per-run timeout survive the harness process dying (#84)
    Wrap each ngspice invocation with an OS-level watchdog (coreutils
    timeout(1)/gtimeout) running in its own process session, so a corner's
    wall-clock bound is enforced even if run_corners.py itself is killed
    mid-run -- the actual failure mode behind an incident where a hung
    ngspice ran ~4.5h undetected after its harness process died, taking a
    worker offline. Popen.communicate(timeout=...) remains as a secondary
    in-process guard, and is the sole enforcement (with a documented
    degraded-mode warning from --check-env) when no watchdog binary is on
    PATH.
    A killed corner now reports FAILED-TIMEOUT in the printed summar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
    [test_cli.py, test_runner.py]
2026-08-03 sim: the DR-0016 liveness digitizer frequency-modulates its ring 25.6% in lockstep with clk (#85)
    * sim: add the DR-0016 liveness-digitizer phase-cost testbench family
    Five decks that measure what the per-ring liveness digitizer costs its ring in
    phase, against the same starved 5-stage ring, injected noise density, window
    geometry and corner (tt/27 C/3.30 V) issue #51's coupling ladder used, so the
    two experiments are directly comparable.
    The clk question is asked inside each topology against that topology's own
    static reference, so exactly one thing differs between numerator and
    denominator: whether clk toggles.
    Part of #76
    * sim: the DR-0016 liveness digitizer frequency-modulates its r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
2026-08-03 sim: the clk-locked liveness modulation does not reach the sampled bit (#89)
    * sim: testbenches for whether the clk-locked liveness modulation reaches the sampled bit
    Issue #76 (DR-0016 amendment A2) measured that the per-ring liveness
    digitizer frequency-modulates the ring it observes in lockstep with clk,
    and explicitly declined to turn that phase measurement into a claim about
    the sampled bit. Issue #86 is where that claim has to be earned, because
    DR-0007 §1's independence argument is stated about rings whose frequency
    is nobody's function.
    Six decks, three clk rates, one change per pair. Each deck is
    design/sampler_core.spice's own wiring -- two skewed rings, the DR-0018
    per-ring out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
2026-08-03 sim: the shipped-array liveness-tap phase decks, and an honest account of what they have not measured yet (#90)
    * test(sim): add the shipped-array liveness-tap phase decks
    Four testbenches carrying the SHIPPED design/sampler_core.spice topology --
    two ro_ring11 rings, both DR-0018 ro_buf per-ring buffers, the xor2 combiner
    and the sampler_dff instances -- so the DR-0016 liveness digitizer's
    clk-locked phase disturbance can be measured where each buffer output drives
    xa1 as well as its own digitizer, rather than the one consumer issue #76's
    decks gave it.
    The four differ in exactly two axes: whether clk toggles, and whether the two
    per-ring liveness digitizers xsr1/xsr2 are present. Every r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
2026-08-04 sim,spec: the xsb-on-xo path is unreachable, closing #87's last measurement gap (#93)
    * sim: the xsb-on-xo pair, and the -j 1 launcher default that finally landed it
    Adds the two remaining records of issue #87's shipped-array tap-phase
    family, both produced on one host (Linux-7.0.0-1009-aws-x86_64) as this
    experiment's pairing rule requires:
    2026-08-03-array-liveness-tap-phase-xsb-clocked-01 4 seeds, tt/27 C/3.30 V
    2026-08-03-array-liveness-tap-phase-xsb-static-01 4 seeds, tt/27 C/3.30 V
    They isolate the DR-0001 raw-tap digitizer xsb on the XOR combiner output
    xo, with the two DR-0016 per-ring digitizers removed, against the same
    topology with clk parked HIGH. Running clk moves r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
2026-08-04 docs: correct README/CLAUDE.md status claims that understate current tree state (#95)
    * docs: correct README/CLAUDE.md status claims that understate current tree state
    - README.md: "no GDS in layout/" and the layout/ ASCII-tree annotation
    "— empty" are false as of #58/#77 — layout/ now carries three DRC/LVS
    fixture GDS streams plus an entropy-source floorplan abstract. Reword
    to say what's actually there (fixtures/floorplan, no TRNG cell layout
    yet) instead of "empty".
    - README.md: "design/ holds two blocks" undercounts — design/ now also
    has health_test/ and interface/ (landed in #71) plus trng_top/
    integration, beyond the conditioner and analog entropy source named.
    - RE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
2026-08-04 spec: add DR-0019 for the 2.7x area-row miss and its FIFO-depth root cause (#98)
    * spec: add DR-0019 routing the 2.7x area-row miss to its FIFO-depth root cause
    The `< 0.05 mm²` row was the one ratified row with no decision record behind
    its miss: the floorplan inventory prices the block at 0.1347 mm² (269.4 % of
    the row) and nothing routed that number anywhere, while the idle-current,
    raw-rate and entropy-binding rows each have one.
    DR-0019 states the row's status against that estimate and prices the four
    available responses (shrink the digital section, raise the row, hold it, or
    split it), with the depth sensitivity computed through the floorplan script's
    own geometry: 269.4 % at FIFO_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
2026-08-05 spec: add DR-0020 setting FIFO_DEPTH to 2 for area and 500 bps streaming (#101)
    Two Proposed records bottom out on the same undecided RTL default. DR-0017
    found the two 8x32-bit output FIFOs are 78% of the block's flop count and
    rejected the depth lever on the < 1 uA idle row; DR-0019 found the same
    FIFOs are 69.8% of digital cell area, showed the lever has far more reach
    on the < 0.05 mm2 area row, and declined to take a design decision inside a
    spec-process record. DR-0013 owns the third consequence and was written
    against a rate row DR-0010 proposes moving by ~2000x.
    DR-0020 takes the decision once, citing DR-0017's and DR-0019's committed
    figures rather than re-deriving them:
    - power g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
2026-08-08 Min-entropy estimation and statistical test battery on simulated bitstreams (#56)
    * Min-entropy estimation and statistical test battery on simulated bitstreams (#12)
    Applies the #10/DR-0012 methodology contract to the real design instead of
    the calibration source, and reports the honest result: no non-trivial raw
    min-entropy figure is supportable by transistor-level simulation at any
    rate under consideration.
    - sim/tools/raw_min_entropy_estimate.py: applies the calibrated
    most-common-value estimator to the real sim/tb/sampler-array-digitize
    bitstream (issue #9) at both committed corners, with DR-0012 Section 2's
    confidence-degradation formula stated explicitly, plus a physical
    cros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
    [test_raw_min_entropy_estimate.py, test_statistical_battery.py]
2026-08-08 layout: draw and DRC/LVS-verify the entropy source's ro_stage cell (#112)
    Hand-draws layout/cells/ro_stage/ (the entropy source's repeated ring-stage,
    ring1's wstv=0.220u sizing), extending layout/verify.py's EXPECTATIONS-driven
    flow to check real design cells alongside the flow-bringup fixtures. The cell
    is DRC-clean and LVS-matches a hand-written schematic-side reference
    (layout/cells/ro_stage/ro_stage.spice), 0 errors, with the same two
    deck-level device.body_unverified/topology warnings every other verified
    cell in this flow carries.
    Drawn by hand rather than via `klt gen mos_array` because three of the
    cell's four devices sit at the gf180mcu 3.3V core devices' 0.22um minimum
    width, bel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
    [build.py, verify.py]
2026-08-08 layout: draw and DRC/LVS-verify the combiner (xor2) and sampler (sampler_dff) cells (#117)
    Adds layout/cells/xor2/ and layout/cells/sampler_dff/, the two cells that
    make up the combiner_sampler guarded region's contents (#16 floorplan),
    following the ro_stage hand-drawn-cell pattern (#112): primitive geometry,
    a hand-written schematic-side LVS reference netlist, wired into
    layout/verify.py's EXPECTATIONS via dir/top overrides.
    At 12 and 22 devices (vs. ro_stage's 4), both cells share a new "gate
    array" layout engine (layout/cells/_mos_row.py): every device gets its own
    independent dog-boned pads (no series-shared diffusion), and a two-layer
    Manhattan grid (Metal2 trunks per net, Metal3 rise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
2026-08-08 layout: draw ro_stage at ring2 sizing and the ro_nand2 stoppable stage (#115)
    Draws two more of the entropy source's ring-array cells, following the
    hand-drawn/dog-boned technique and klt drc/extract/lvs flow layout/cells/
    ro_stage/ established:
    - layout/cells/ro_stage_ring2/: ro_stage at ring2's own sizing
    (wstv=0.240u), independently drawn geometry (not a relabelled copy of
    ring1's ro_stage/) -- the array deliberately uses two different starve
    widths so the two rings are not frequency-matched
    (layout/floorplan/README.md, "Mechanism 1").
    - layout/cells/ro_nand2/: the ring's one stoppable stage -- a 2-input NAND
    built from the same series-starved topology as ro_stage plus a parall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
2026-08-09 layout: assemble ro_ring11 (ring1 sizing) from the drawn ro_stage/ro_nand2 cells (#120)
    * layout: assemble ro_ring11 (ring1 sizing) from the drawn ro_stage/ro_nand2 cells
    Adds layout/rings/, the "assemble" half of #110: klt gen-compose places
    ten already-drawn ro_stage instances plus one ro_nand2 into a row in
    ring order (xg, x1..x10), and klt draw adds the hand-routed inter-cell
    metal1/metal2 wiring (gen-compose's own connectivity[] router cannot
    chain these same-side-I/O cells without rotation support it does not
    have). The result is DRC-clean and LVS-matches a hand-derived reference
    netlist mechanically expanded from ro_stage.spice/ro_nand2.spice per
    design/ro_array_core.spice's own ro_r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
2026-08-09 layout: draw ro_nand2 at ring2 sizing and assemble ring2's ro_ring11 (#123)
    Adds layout/cells/ro_nand2_ring2/ (ro_nand2's six-device NAND topology,
    independently redrawn at ring2's own wstv=0.240u starve width -- not a
    relabelled copy of layout/cells/ro_nand2/'s wstv=0.220u geometry, verified
    by diffing the two cells' own committed Comp geometry) and
    layout/rings/ro_ring11_ring2/ (the row-placement plus hand-routed-wiring
    assembly of ten ro_stage_ring2 instances plus one ro_nand2_ring2, following
    layout/rings/ro_ring11/build.py's own technique exactly). Both are wired
    into layout/verify.py's EXPECTATIONS with DRC-clean/LVS-match entries, and
    layout/cells/README.md / layout/rings/README.md ar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
2026-08-10 chore(repo-skills): update installed Repo Skills to 0.10.0
    Rolled straight to main rather than via a per-repo branch. The 0.8.1 rollout
    used branch-per-repo and seven of those branches were abandoned mid-flight,
    leaving their repos parked off trunk for days — and invisible, because
    compute-drift.sh's axis 3 compares a checkout against its OWN branch, so a
    repo current with a stale branch reports clean (2AMLogic/2am#209). An
    installed-tool refresh is mechanical, already-reviewed content, so a direct
    commit removes that abandonment failure mode entirely.
    This host's fleet spanned 0.6.1 to 0.8.1 before this pass, against a 0.10.0
    source — see 2AMLogic/2am#216.
2026-08-11 layout(floorplan): size ring1/ring2's guarded regions to the real assembled row (#119) (#126)
    The ring1/ring2 guarded regions in trng_floorplan.gds were sized from the
    area/utilisation estimate's sqrt(area) square (17.1x17.1 um guarded), not
    from the real assembled ro_ring11 row (~78.9 x 4.75 um, committed by #110/
    #120/#118) -- the assembled ring did not remotely fit inside the region its
    own floorplan reserved for it.
    floorplan.py now derives ring1/ring2's guarded footprint from each ring's
    own committed GDS bounding box (read via `klt stats`, never klayout.db
    directly) instead of the estimate; every other region (combiner_sampler,
    not yet assembled; digital) is unchanged. `gen_guard_ring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
2026-08-11 docs: reconcile top-level README Area bullet with #119's regenerated floorplan totals (#130)
    layout/floorplan/reports/area.json's floorplan total moved from
    0.1347 mm2 / 269.4% of the row to 0.1350 mm2 / 270.0% when #119
    resized ring1/ring2's guarded footprint from the real assembled
    ro_ring11 geometry instead of the area/utilisation estimate, and the
    entropy-source-plus-isolation share moved from 4.1% to 4.7%. Digital's
    251% share is unchanged (out of #119's scope). Re-derived from the
    current area.json rollup rather than trusting the issue's transcribed
    figures, since a flagged combiner_sampler resize follow-up could have
    moved the total again before this landed -- it had not.
    Co-authored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
2026-08-11 layout(floorplan): place ring1/ring2's assembled ro_ring11 inside their guarded regions (#110) (#133)
    Places the already-assembled ro_ring11 blocks (layout/rings/ro_ring11,
    ro_ring11_ring2 -- ring1/ring2 sizing) inside the ring1/ring2 guarded
    regions layout/floorplan/trng_floorplan.gds already reserves for them
    (issue #119), via klt gen-compose's strategy: "explicit". combiner_sampler
    and digital remain empty guard rings -- neither xor2/sampler_dff nor the
    digital section is assembled yet.
    The naive zero-clearance placement (the guarded region's inner cavity is
    sized to exactly each ring's own bbox, per #119) is klt drc-clean but not
    connectivity-clean: klt lvs finds it shorts the ring's ow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
2026-08-11 layout(blocks): assemble combiner_sampler (xor2 + 4x sampler_dff), DRC-clean and LVS-match (#136)
    Adds layout/blocks/combiner_sampler/, a new assembled-block sibling to
    layout/rings/ that places the combining xor2 gate plus four sampler_dff
    instances into one row, wires the seven internal nets (xo, ro1, ro2, clk,
    rst_n, vdd, vss) with hand-routed Metal2/Metal3/Via2, and holds the result
    to the same DRC-clean/LVS-match bar every other cell/block in this
    repository is held to (klt drc: 0 violations; klt lvs: match, only the two
    disclosed deck-level warning categories every other entry already carries).
    Registers the new block in layout/verify.py alongside ro_ring11/ro_ring11_ring2.
    Does not p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
2026-08-11 refactor(layout): consolidate FlowError/resolve_pdk/_run_klt into layout/_klt.py (#138)
    Five layout/ driver scripts each independently defined the same three
    pieces of klt-invocation boilerplate: layout/verify.py, layout/floorplan/
    floorplan.py, and the ro_ring11/ro_ring11_ring2/combiner_sampler build.py
    scripts. _run_klt was byte-for-byte identical in three of them and
    differed from the other two only in timeout (600s vs. floorplan.py's
    900s) or docstring verbosity; resolve_pdk and FlowError were identical
    modulo docstrings.
    Adds layout/_klt.py as the single copy (resolve_pdk(), _run_klt() with a
    timeout_s parameter defaulting to 600, and FlowError), computing its own
    REPO_ROOT rather than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
    [_klt.py, build.py, verify.py]
2026-08-11 layout(floorplan): resize combiner_sampler's guarded region to the real assembled geometry (#135) (#139)
    layout/blocks/combiner_sampler/combiner_sampler.gds (merged via #136) has
    a real assembled bounding box of 278.90 x 15.64 um -- roughly 11x the
    width of the floorplan's combiner_sampler guarded region, which was still
    sized from the pre-assembly area/utilisation estimate (a 23.27x23.27 um
    square). The assembled row did not fit inside the region its own
    floorplan reserved for it.
    Following the Curator's Option A decision on #135 (mirroring #119's
    resolution for ring1/ring2), combiner_sampler is added to floorplan.py's
    ASSEMBLED_RING_GDS/RING_LVS_REFERENCE machinery, so its guarded region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
2026-08-16 layout(cells): draw ro_buf, DRC-clean and LVS-match, and inventory both instances (#152)
    `ro_buf` was the last device in the shipped top-level netlist with no drawn
    cell. It is DR-0018's per-ring output buffer -- one unstarved minimum-width
    CMOS inverter (pfet W=0.44u / nfet W=0.22u, both L=0.28u) between each ring
    node and every consumer, which takes the measured XOR-combiner back-coupling
    from 27.10x to 2.87x -- and `design/ro_array_core.spice` instantiates it twice
    (`xb1`/`xb2`).
    layout/cells/ro_buf/
    Hand-drawn from primitive geometry, like every other cell here: `XMn`'s
    0.22um width is below the 0.42um floor `klt gen mos_array` enforces
    (klayout-tools#322), and generating at the f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
2026-08-16 fix(layout): normalize machine-local PDK provenance in verify.py's freshness gate (#153)
    layout/verify.py's `_stable()` normalized only `environment.engine_version`
    before comparing committed reports against a fresh run, so two other
    fields that legitimately differ by machine -- `pdk.root` (the absolute
    filesystem path to wherever a PDK install happens to live) and
    `provenance.pdk.source` (klt's own record of how it found that install) --
    were compared as if they were content. This produced `does not match this
    run` failures whenever the reproducing machine's PDK sat at a different
    path than whichever machine wrote the committed copy, which is exactly
    what `pdk-nightly.yml` hits every night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
    [verify.py]
2026-08-16 docs: refresh README's Layout narrative and drop cells README's stale combiner_sampler-blocked claim (#154)
    README.md's Layout paragraph still described a single hand-drawn ro_stage
    cell; it now names the current inventory (seven drawn cells assembled into
    two rings and combiner_sampler) and that ring1/ring2/combiner_sampler are
    placed in the floorplan while the digital section still has no layout.
    layout/cells/README.md still said combiner_sampler's placement was blocked
    on #135, which closed 2026-08-11 via PR #139 -- it is now placed, and the
    still-true digital-section statement is preserved unchanged.
    Closes #149
2026-08-16 refactor(layout): consolidate klt_version/normalise_gds into layout/_klt.py (#157)
    layout/verify.py, layout/floorplan/floorplan.py, and the combiner_sampler/
    ro_ring11/ro_ring11_ring2 build scripts each carried their own byte-identical
    copies of klt_version() (5 copies) and normalise_gds()+_BGNLIB/_BGNSTR
    (4 copies) -- the same duplication issue #137/#138 already fixed one layer
    up for FlowError/resolve_pdk/_run_klt. Both helpers now live once in
    layout/_klt.py, with every caller importing them instead of redefining them.
    Also drops the three build.py scripts' local `import shutil` (they each
    did it inside the function instead of at module scope) and the shutil/struct
    module-level imports i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
    [_klt.py, build.py, verify.py]
2026-08-16 docs(layout): correct blocks README's stale combiner_sampler placement claim (#159)
    layout/blocks/README.md's "What is explicitly not here yet" section still
    described combiner_sampler's floorplan placement as undone, but issue #135
    (resolved by PR #139) already resized its guarded region to the real
    assembled bounding box (278.90 x 15.64 um) and placed it. Replace the stale
    bullet with a note pointing to layout/floorplan/README.md's own placement
    writeup, which already documents this correctly.
2026-08-16 docs(layout): correct README narrative's stale combiner_sampler placement claim (#160)
    layout/README.md's intro prose still described combiner_sampler as
    assembled but unplaced ("does not yet fit the region's own guarded
    footprint, #135") and its floorplan cross-reference still said placement
    was "blocked on #135". Both went stale when #135 was resolved by PR #139,
    which resized the combiner_sampler guarded region to the assembled
    block's real bounding box and placed it there.
    State instead that ring1/ring2 and combiner_sampler all carry real,
    placed, DRC/LVS-verified content and that only digital is still empty,
    and point the cross-reference at floorplan/README.md's own
    "Placement — issu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
2026-08-16 layout(blocks): draw both ro_buf instances into combiner_sampler, DRC-clean and LVS-match (#161)
    combiner_sampler previously assembled only xor2 + 4x sampler_dff
    (issue #134), taking ring1's/ring2's buffered outputs (ro1/ro2) as its
    own top-level pins. layout/cells/ro_buf/ was drawn and verified
    standalone (issue #144), and layout/floorplan/ priced both DR-0018
    buffer instances into this region, but neither was placed in any
    assembled geometry: adding them to the old reference netlist without
    declaring them there would have reported four extra devices as
    device.unmatched.
    Extend layout/blocks/combiner_sampler/build.py to place xb1/xb2
    (ro_buf) ahead of the cells they feed, and hand-route th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
    [build.py, verify.py]
2026-08-16 build(layout): pin klt to a git commit with gf180mcu digital flow, pex, yield (#163)
    .github/workflows/pdk-nightly.yml installed klayout-tools from PyPI with a
    floating `pip install --upgrade`, which resolves v0.2.0 -- a release cut
    2026-08-04, before the gf180mcu synthesize/place-and-route flow, `klt pex`,
    and `klt yield` existed anywhere but klayout-tools' main branch. Pin the
    install to an explicit git commit (a482d393, verified via `--help` to accept
    --pdk/--pdk-root on synthesize and place-and-route, name a gf180mcu
    standard-cell deck, and expose pex/yield as verbs) instead of floating on
    --upgrade, matching layout/README.md's already-documented from-git pinned
    install pattern. Update t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
2026-08-17 design(digital): synthesize trng_top against gf180mcu and commit the gate-level netlist (#164)
    * design(digital): synthesize trng_top against gf180mcu and commit the gate-level netlist
    klt synthesize's gf180mcu path (klayout-tools#631, pinned in #163) closes T1's
    "no synthesized gate-level netlist exists for gf180mcu" gap. design/synth.py
    drives it end to end -- one netlist for trng_top's whole digital wiring
    (conditioner + health tests + interface), not one per sub-block, since none of
    those RTL modules is elaborated standalone anywhere in this repo and #111's
    place-and-route needs the flattened design anyway.
    - design/synth.py: writes the klt synthesize request, invokes it against
    gf18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
2026-08-17 layout: size every via at the DRM's 0.26um and run conductors past each cut (#165)
    The klt build #142 pinned carries gf180mcu DRM 7.14 ("Vian") and the
    conductor-over-cut enclosures, which the previously-installed deck did not:
    `via1.width.1`/`via2.width.1` (0.26um fixed via size),
    `metal2.enclosing.via1.1`/`metal2.enclosing.via2.1`/`metal3.enclosing.via2.1`
    (0.01um), and a stricter `metal1.enclosing.contact.1` (0.005um). Seven drawn
    cells failed DRC under it. This redraws the geometry -- no rule is waived and
    `layout/verify.py`'s EXPECTATIONS table is untouched, still declaring all ten
    cells DRC-clean with empty rule_counts.
    Three distinct defects, each fixed at its source:
    - Vias were dr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
    [build.py]
2026-08-17 sim: combine MC mismatch with process/temp/supply corners, add negative control (#146) (#167)
    Both seeded Monte Carlo testbenches (ro-array-core-mc-freq, 8 seeds;
    sampler-dff-mc-offset, 30 seeds) previously ran only at the nominal
    tt/27C/3.30V corner -- worse, `extra_lib_sections: ["statistical"]`
    unconditionally overrode whichever corner's own device sections would
    load, so setting `corners` to anything but `tt` was silently a no-op even
    before this. This drops `extra_lib_sections` (every gf180mcu per-corner
    device library already implements the same sw_stat_mismatch-gated local
    mismatch model) and adds a second PVT point, ss/125C/3.63V (DR-0015's
    measured entropy-binding worst corner), to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
    [test_runner.py]
2026-08-17 layout: regenerate reports/ against the open_pdks commit pdk-nightly.yml pins (#168)
    layout/reports/*.extract.json (and environment.json) were written against
    open_pdks c6d73a35f524070e85faff4a6a9eef49553ebc2b -- the last commit
    volare (ciel's deprecated predecessor) could install before its release
    feed stopped in Aug 2025 -- while .github/workflows/pdk-nightly.yml has
    always pinned PDK_VERSION to f6eeac7dad085ffcc829ccfd721f7b4ce39edcf7, the
    current ciel-installable commit. layout/verify.py's _stable() deliberately
    keeps pdk.version/provenance.pdk.version as compared evidence (issue #148),
    so every nightly run failed all 13 report expectations as report-drift
    before a single DRC/LVS rule e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
2026-08-17 layout(digital): place and route the digital section against gf180mcu (#172)
    * build(layout): provision openroad from the pinned ORFS container image
    `klt place-and-route` shells out to an `openroad` binary; there is no
    Homebrew formula and no common Linux-distro package for one. This wrapper
    presents the pinned `openroad/orfs` image (pinned by tag *and* digest) as if
    it were a native `openroad`, so a caller that already knows how to invoke
    the binary needs no container knowledge at all.
    The working directory and the resolved PDK root are bind-mounted at their
    own absolute host paths rather than at a fixed `/workspace`: the Tcl that
    `klt place-and-route` generates carries absolute paths fo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
    [build.py, trng_top.pnr.v]
2026-08-17 build(design): pin synthesis liberty to tt_025C_3v30 instead of klt's 1.8V default (#173)
    design/synth.py let klt pick its nominal (lowest-supply) liberty corner for
    mapping trng_top, which for this library resolves to tt_025C_1v80 even
    though the block's ratified supply is 3.3V. Pin CORNER = "tt_025C_3v30"
    explicitly (mirroring layout/digital/build.py's CORNER pattern), deliberately
    choosing the typical 3.3V corner rather than the ss_125C_3v00 corner P&R
    re-times at: klt synthesize's ABC step is a pre-place delay-driven mapping
    step with no timing closure of its own, so mapping it against P&R's
    worst-case binding corner would only bias cell selection before P&R's own
    resizing gets a chance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
    [build.py, trng_top.pnr.v]
2026-08-17 sim(digital): Fmax, area and power across 15 gate-level corners (#175)
    * sim(digital): Fmax, area and power across 15 gate-level corners
    T1 checklist items 5 and 8 (digital column) both failed for one reason:
    no static timing analysis existed, the digital area was an inventory
    estimate, and digital power was a library estimate at no corner. All
    three are now measured from one pass over one fixed piece of geometry --
    the committed routed DEF from #111, re-timed at 5 liberty decks x 3
    OpenRCX interconnect decks with extracted parasitics and a propagated
    clock.
    - Timing closes at every corner: worst setup +23.000 ns against the 50 ns
    constraint (binds ss_125C_3v00/max), worst hold +0.707 ns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
    [run_sta.py, test_digital_corner_characterization.py]
2026-08-17 fix(digital): register ht_startup_pass and cond_word/cond_valid in TopLevel.step (#178)
    design/health_test/rct_apt.v declares ht_startup_pass output reg and
    design/conditioner/crc32_conditioner.v declares cond_word/cond_valid
    output reg, exactly like the three failure flags TopLevel.step already
    delays by a cycle via its _last_* fields -- but these two handoffs were
    passed to the interface combinationally, in the same model cycle they
    were computed. trng_top.v wires all four straight through with no
    extra register, so the assembled RTL presents both a cycle later than
    the model did, which also shifted the first 256-bit conditioner block
    by one raw bit (the conditioned word itself differed, n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
    [tb_rtl_equivalence.v, test_trng_top.py, trng_top.py, trng_top.v]
2026-08-17 sim: re-run the digital functional suite on the post-route netlist with SDF timing (#177)
    Adds the digital half of T1 item 7 ("post-layout verification"): a
    gate-level regression of `layout/digital/trng_top.pnr.v` -- the as-built
    post-route netlist, CTS buffers and resized cells included -- with
    `layout/digital/trng_top.sdf`'s cell delays back-annotated through
    `klt functional-verification`'s `options.sdf`, compared cycle by cycle
    against both the RTL it was synthesized from and the behavioural model the
    five `level: behavioral` records came from.
    New artefacts and how they fit together:
    - `layout/digital/gen_sdf.py` + `trng_top.sdf` + `reports/sdf_export.json`:
    a cell-delay SDF from Ope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
    [trng_top.sdf]
2026-08-17 layout(digital): commit trng_top.gds, DRC and LVS results now that klt's DEF->GDS merge fix has landed (#170) (#182)
    Re-pins klt to e501e261c1ac9b96a08e2c3569bf6207123a5b6a (klayout-tools#1114,
    the DBU fix for #1090's 2x-scaled DEF->GDS merge, plus klayout-tools#1115's
    Dualgate-scoped DRC deck fix) in .github/workflows/pdk-nightly.yml and
    re-runs layout/digital/build.py: checks.gds_geometry.status is now "ok"
    (ratio 1.0x1.0, was 2.0x2.0), so trng_top.gds and reports/drc.json are
    committed for the first time.
    klt drc reports 149 nwell.space.1 violations, all traced (by cross-checking
    a representative violation against trng_top.def's own placement) to the
    two-site gaps this flow's placement l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
    [build.py, lvs.py, verify.py]
2026-08-17 layout(digital): build a vddd/vss PDN with tapcells and fillers, and check it stays off the entropy supplies (#184)
    Re-pins klt to 9c71bb6741f20be19bf94b847832803505042ec6 (klayout-tools#1120,
    the optional `request.power` block that klayout-tools#1091 asked for) and
    sends that block from layout/digital/build.py, so the flow finally runs
    tapcell / add_global_connection / global_connect / pdngen and a post-route
    filler_placement instead of routing signals over cells whose VDD/VSS pins
    belong to no net.
    The grid is gf180's own ORFS platform config
    (pdn_grid_strategy_9t_6M.cfg) layer for layer -- Metal1 followpins rails at
    5.04 um, Metal4/Metal5 straps -- on nets `vddd`/`vss` rather than klt's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
    [trng_top.sdf]
2026-08-18 sim(digital): re-run corner STA/power and post-route sim against the powered DEF (#185)
2026-08-18 layout(digital): derive lvs.py's reference cell interfaces from the library, not observed connections (#186) (#188)
    _cell_instances() previously derived each standard-cell type's reference
    SPICE interface from the union of ports its instances actually connect in
    trng_top.pnr.v, silently assuming every instance of a type uses the
    identical port set. That breaks for gf180mcu_fd_sc_mcu9t5v0__inv_8: its
    sole instance, clkload13 (a CTS clock-load dummy whose ZN output is left
    unconnected by construction), made the derived interface 3-pin (I VDD VSS)
    against the layout side's real 4-pin (I VDD VSS ZN) -- an instant
    .SUBCKT mismatch reported as two orphaned "subcircuit instance could not
    be matched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
2026-08-19 fix: surface driven_ratio_to_control in array_coupling_buffer_variant.py's coupling print block (#189)
    The local variable driven_ratio_to_control (driven.sigma[1] / control.sigma[1])
    was computed but never read, tripping ruff F841. Read-through of the
    surrounding print block (which already prints the sibling ratios
    ratio_to_control, ratio_to_static, ratio_to_driven -- all buffered.sigma[1]
    over some baseline) confirms this was meant to be surfaced: it reports the
    unbuffered driven variant's own severity against the standalone control,
    i.e. the pre-mitigation baseline that the three buffered ratios above it are
    implicitly measured against. Wired it into the print block as a fourth line
    rather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
2026-08-19 refactor(sim): consolidate evidence-record parsing into sim/tools/_record_parsing.py (#190)
    array_sizing.py, time_to_first_valid.py, power_rollup.py,
    starved_cell_jitter_energy.py, raw_min_entropy_estimate.py,
    jitter_energy_law.py and jitter_estimator_calibration_check.py each
    reimplemented the same "- `key`: value" bullet regex and/or the same
    process:/temperature:/voltage: corner-triplet extractor, with four
    different call conventions (staticmethod, instance method, module
    function, closure). New sim/tools/_record_parsing.py holds
    parse_values()/field()/parse_corner()/format_corner() once; each file
    now imports it and keeps its own Record/BitstreamRecord shape and its
    own RecordError type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
2026-08-19 refactor(sim): migrate remaining write_record stragglers onto report.finalize_record (#194)
    sim/tb/conditioned-stream-battery/run_battery.py and
    sim/tb/digital-sta-power/run_sta.py were the last two testbenches still
    hand-rolling the allocate/mkdir/guard/write bookkeeping skeleton that #105
    already consolidated into sim/harness/report.py's finalize_record()
    helper. Both now wrap their raw-artifact writing and frontmatter/body
    composition in a render(stem, raw_dir) closure and call
    report.finalize_record(records_dir, date, SLUG, render), matching the
    other six sim/tb/*/run_demo.py scripts; run_sta.py keeps its distinct
    write_record(point, values, pdk, git, openroad, records_dir) signature
    and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
2026-08-21 spec(power): move power_rollup.py's digital term to the measured gate-level figure (DR-0023) (#195)
    #145 measured the digital section's active/idle power from the synthesized,
    placed and routed netlist across 15 corners, but deliberately left the
    substitution into sim/tools/power_rollup.py's ratified-row verdict for this
    issue to decide (#174), since it flips the whole-block active row from met
    to missed.
    DR-0023 (Proposed) decides it: power_rollup.py's digital term now comes from
    the committed sim/records/*-digital-sta-power-*.md family (level: gate,
    DR-0021) instead of design/digital_power_estimate.py's pre-synthesis
    estimate, rate-scaled by an exact re-derivation of the same liberty mode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
2026-08-21 docs: fix stale README claims about digital-section and floorplan layout state (#198)
    The top summary, maturity-ladder line, tree-diagram comment, and Layout
    section all still claimed the digital section "has no layout at all" and
    that layout/floorplan/'s regions "are empty" — both false since #170
    (layout/digital/trng_top.gds: placed-and-routed, DRC-clean, LVS mismatch,
    #187) and #110/#135 (ring1/ring2/combiner_sampler placed and guard-ringed
    in the floorplan). Updated the prose to state the current, accurate split:
    analog partition placed/DRC-clean/LVS-matching, digital partition has a
    standalone DRC-clean GDS with LVS still mismatched (#187), and whole-block
    composition of the two is st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
2026-08-21 ci(pdk-nightly): move the yosys floor off Ubuntu's distro package to unblock klt synthesize (#199)
    `klt synthesize --format json` crashed on every single `design/synth.py
    --check` run (KeyError('area') traceback on stderr instead of the
    documented JSON error envelope) because Yosys 0.33's `stat -json` omits
    the `area` key entirely for trng_top's own hierarchical, un-flattened
    top-level module -- a klayout-tools bug, filed upstream as
    2AMLogic/klayout-tools#1262, not patched here.
    - .github/workflows/pdk-nightly.yml: install `yowasp-yosys` (verified
    live to compute area correctly for this design) instead of the distro
    package, symlinked to `yosys` on PATH; still floats with no version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
    [_klt.py]
2026-08-22 chore: resync .github/CONFIGURATION.md from upstream Loom defaults
    Applied to the working tree by `resync-installed.sh` and then left
    uncommitted. `.github/` is on the Loom-shipped allowlist and is walked by the
    resync, so it updates with the rest — but the resync's own commit step stages
    `.loom/` only, so this file stays dirty in every repo the resync touches.
    That is not cosmetic. `fleet-resync.sh` refuses to run against a repo with
    uncommitted work under `.loom/`, `.claude/`, or `.gitignore`, and a repo left
    dirty this way can trip that guard on a later run and stop receiving upstream
    fixes entirely while still reporting as a healthy fleet member. The identical
    diff was found pending i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
2026-08-25 Add Chipalooza Challenge #3 proposal for the TRNG entropy source (#202)
    Adds docs/chipalooza/challenge-3-proposal.md: a five-section, email-ready
    proposal for Open Circuit Design's Chipalooza Challenge #3 (GF180MCU /
    Wafer.Space, due 2026-08-31). Every target-specification row is re-derived
    directly from this repository's sim/ evidence (power_rollup.py,
    characterization-*.md, and the underlying sim/records/), at the widest
    supply corner this repo has ever simulated (3.3 V ±10%) -- no record exists
    above 3.63 V, which is disclosed as the largest gap against the challenge's
    5.0 V analog rail rather than papered over.
    The I/O section maps a reduced test-chip pinout onto Challenge #3's slot
    bu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
2026-08-25 feat: add make characterize/smoke/check for independent verification (#204)
    * feat: add make characterize/smoke/check for independent verification
    Adds a root Makefile with three entry points a Chipalooza Challenge #3
    schematic reviewer (or anyone else) can run from a clean clone: `make check`
    (unit tests + ngspice/PDK environment report), `make smoke` (harness
    acceptance test at one corner, seconds), and `make characterize` (the full
    ngspice PVT/corner campaign behind docs/chipalooza/challenge-3-proposal.md's
    spec table, writing new evidence under sim/records/ per sim/README.md).
    `sim/characterize.py` is the thin driver behind `make characterize`: a
    declarative table of sim/run_corners.py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
2026-09-05 feat(champion): standing authorization for design-evidence auto-merge (#6850)
    Operator ruling 2026-09-05: Judge-approved, green-CI PRs whose entire
    changed-file set lives in design/, sim/, layout/, measurements/,
    verification/, or docs/ auto-merge without the four-axis human hold.
    Rationale: canary design evidence is fully revertible with no fleet-infra
    blast radius, and the held-PR pattern (sky130-sar-adc#123 sat mergeable for
    days as the sole blocker of a layout chain) costs more than it protects
    here. spec/ and every tool surface fall outside the patterns, so the
    exact-subset rule keeps them on the four-axis judgment automatically.
    C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
2026-09-05 layout(digital): re-verify LVS against klayout-tools v0.4.0 — clkload13 defect fixed (#208)
    klayout-tools v0.4.0 (published 2026-09-05, PyPI) contains PR #1310's
    _polygon_interior_point() fix (merge commit ff5c8a0f). Re-pinning klt to
    that release and re-running python3 layout/digital/lvs.py against the
    committed trng_top.gds/trng_top.pnr.v confirms the fix directly:
    clkload13's I pin now resolves onto clknet_leaf_48_clk instead of the
    isolated $2320 island, taking mismatch_count from 8 to 6, net.unmatched
    from 1 to 0, and error_count to 0 (status: match).
    The remaining mismatch_count: 6 is the same six severity: warning
    u_interface entries this directory's README already documented as
    un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
2026-09-06 Compose the digital section into the floorplan (issue #210 / #209) (#211)
    Re-pins klt past the two dbu-mismatch fixes (klayout-tools#1512 closing
    #1496, klayout-tools#1516 closing #1514) that were blocking `digital`'s
    placement into the floorplan's guarded region, and adds the
    `ASSEMBLED_RING_GDS`/`RING_LVS_REFERENCE` entries #209's Scope called for.
    Composing `digital` surfaced a third, narrower gap the two-line diff did
    not anticipate: `check_ring_fit`'s generic LVS step assumes a flat
    transistor-level reference, but `digital`'s reference is a cell-instance-
    granularity abstraction (`klt extract --abstract-cells`, matching
    `layout/digital/lvs.py`'s own standalone check). Adds
    `RING_LVS_AB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
2026-09-07 sim(post-layout): re-run entropy/worst-corner/startup-power against the extracted netlist (#212)
    * sim(post-layout): re-run the entropy/worst-corner/startup-power suite against the extracted netlist (#17)
    Extracts every drawn leaf cell (klt extract --parasitics) and composes the
    result into device-level post-layout replacements for ro_array_core.spice
    and sampler_core.spice (layout/pex/build.py), then re-runs the #12/#13/#14
    methodologies' previously-identified binding corners against them.
    Headline finding: at the entropy-binding corner, extraction degrades
    DR-0007 §2's jitter-budget margin by ~36%, moving DR-0010's proposed
    (not ratified) 500 bps rate from a 1.36x to a failing 0.865x ma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
    [build.py]
2026-09-07 spec: ratify DR-0019, DR-0020, and DR-0023 via the two-key mechanism (#214)
    * spec: ratify DR-0019, DR-0020, and DR-0023 via the two-key mechanism
    The operator's 2026-08-27 comment on #150 ruled that spec ratification now
    flows through the two-key mechanism (2AMLogic/2am#372: EE key + market key
    review, then release) and that cutting this repo's ratification PR is
    ordinary agent work. This carries the three DRs item 5 of #124 names — the
    area-row miss (DR-0019), the FIFO_DEPTH decision (DR-0020), and the
    gate-level power-rollup substitution (DR-0023) — from Proposed to Accepted,
    and updates their own related fields and the README/layout-floorplan-README
    evidenced-figure commentary that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
2026-09-07 layout: consolidate duplicated _rect/_pad/_narrow geometry helpers (#216)
    `_rect()` was defined identically in layout/rings/ro_ring11/build.py,
    layout/rings/ro_ring11_ring2/build.py, and
    layout/blocks/combiner_sampler/build.py; all three already import
    `_run_klt`/`klt_version`/`normalise_gds`/`resolve_pdk` from layout/_klt.py,
    so `_rect()` moves in alongside them.
    `PAD_H`/`_pad()`/`_narrow()` were defined byte-identically in the five
    hand-drawn ring-stage cells (ro_stage, ro_stage_ring2, ro_nand2,
    ro_nand2_ring2, ro_buf); they now live in a new layout/cells/_geometry.py,
    imported the same way _mos_row.py's helpers already are. _geometry.py's
    docstring explains why PAD_H stays a distinct nam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
    [_klt.py, build.py]
2026-09-11 layout(pex): routing-level post-layout extraction of assembled rings and combiner/sampler block (#218)
    Extends layout/pex/build.py (issue #17's leaf-cell-only device-level path,
    unchanged) with a second, routing-level composition path: klt extract
    --parasitics run directly on the assembled ro_ring11/ro_ring11_ring2/
    combiner_sampler GDS, now possible because klayout-tools#1540 closed via
    merged klayout-tools#1543 (nets[].pin_index/net_id/label_positions_um) --
    each true external port is positively identified by cross-checking a
    recomputed expected label position (from this repo's own placement code)
    against the extraction's own reported positions.
    - Re-pin klt in .github/workflows/pdk-night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
    [build.py]
2026-09-11 Routing-level re-run of the sixth testbench family: noise-tapped ring variant, closing #217's §7.5 residual (#220)
    * pex: noise-tapped ring variant, closing #217's sixth-family residual
    sim/characterization-post-layout-extracted.md §7.5 (merged in #218) records
    sampler-array-digitize-extracted as the one family of six that could not be
    re-run at routing level, and attributes the blocker to per-instance device
    addressability -- filed upstream as klayout-tools#1666, "klt extract always
    flattens hierarchy, so a caller cannot address a specific repeated-instance
    boundary inside an assembled block".
    That framing overstated what the testbench needs, and this commit removes the
    dependency on it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
    [build.py]
2026-09-11 Declare the trng_floorplan inter-region net list and generate its LVS reference (#221) (#223)
    Phase 1 of issue #219's floorplan-composition decomposition: a new
    design/floorplan_netlist.py declares every net that has to cross a region
    boundary in the composed trng_floorplan abstract (INTER_REGION_NETS), each
    using the four regions' own already-committed reference pin names, with a
    Python-only self-check against those reference .spice files and a
    generator that writes layout/floorplan/trng_floorplan.lvs_reference.spice.
    No GDS/DRC/LVS/pin-count work is done here -- physical routing and the
    resulting klt extract pin-count change are phase 2's job, a separate
    follow-up issue.
    layout/floorplan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
2026-09-12 layout: route the inter-region nets across the isolation channels (#222) (#226)
    Phase 2 of #219. Phase 1 (#221) declared, as reviewable Python data, every
    net that has to cross a region boundary in `trng_floorplan`, and generated
    the composed LVS reference those declarations imply. It drew nothing: the
    four guarded regions sat in one stream with a 20 um isolation channel
    between neighbours and no wire anywhere between them.
    This draws them. `layout/floorplan/interregion.py` turns the same
    `design/floorplan_netlist.py` declaration into real geometry -- never a
    second copy of the net list, and never a transcribed coordinate: every
    endpoint's position is read from the region's own build module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
2026-09-12 spec: scope the full-chip PEX path before building it (DR-0025) (#231)
    * spec: scope the full-chip PEX path before building it (DR-0025)
    Issue #222 removed the reason `layout/pex/build.py` gave for having no
    full-chip extraction path: the four guarded regions are now joined by real
    Metal4 trunks, and the composed floorplan is DRC-clean and LVS-matches its
    own reference. So the absence of a full-chip path stopped being a blocker
    and became a choice, and #225 asks for that choice to be written down
    before anyone spends a corner sweep on it.
    DR-0025 is the decision. A full-chip PEX increment is worth building, in
    one narrow form: extract `trng_floorplan.gds` with `--parasitics` at the
    same ce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
    [build.py]
2026-09-12 analysis: bound the shared vss return trunk's IR drop per region (#234) (#236)
    DR-0025 scoped IR drop out of the extracted-netlist increment (#232): it
    is a static supply analysis with its own methodology, needing a current
    profile a PEX re-run does not produce. This is that analysis.
    sim/tools/vss_trunk_ir_drop.py derives a segmented resistance model from
    the committed inter-region routing geometry (via the real
    interregion.wiring_plan(), fed by reports/compose.json and area.json)
    rather than DR-0025's own lumped ~129 ohm estimate, separating where
    along the 430.23 um trunk each of ring1/ring2/combiner_sampler taps in.
    Combined with the two corners this repository already treats as binding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
    [test_vss_trunk_ir_drop.py]
2026-09-12 sim: carry the six digital-facing inter-region trunks into the post-route STA (#233) (#238)
    * sim: carry the six digital-facing trunks into the post-route STA (#233)
    DR-0025 scoped the full-chip parasitic-extraction increment (#232) away
    from the six inter-region trunks that terminate on `digital`'s own pins
    (`clk`, `rst_n`, `raw_bit`, `raw_valid`, `ring_bit[0]`, `ring_bit[1]`) and
    handed this question to the post-route STA path instead: what does each
    trunk's own Metal4 RC do to the edge arriving at that pin?
    `run_sta.py` now reads `layout/floorplan/reports/interregion.json` at run
    time -- never a transcribed length -- and states each trunk's lumped R/C as
    a `set_input_transition` on the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
2026-09-12 layout: promote digital's vddd/vss to real LVS pins and draw the composed PDN tie (#224) (#239)
    * layout: promote digital's vddd/vss to real LVS pins and draw the composed PDN tie (#224)
    Issue #222 left digital's vddd/vss connection undrawn because digital's
    committed .SUBCKT trng_top reference declared no vddd/vss pin to wire
    against -- drawing the tie would have merged two nets the reference kept
    separate. This promotes vddd/vss to real .SUBCKT trng_top pins on both
    sides of digital's own standalone LVS (layout/digital/lvs.py), declares
    both as ordinary endpoints in design/floorplan_netlist.py, and draws the
    Metal5 tie from the isolation channel into digital's own PDN strap
    (layout/floorp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
    [lvs.py, run_sta.py, test_vss_trunk_ir_drop.py]
2026-09-12 pex: build the scoped full-chip inter-region delta path (#232, DR-0025) (#241)
    DR-0025 decided what a full-chip parasitic-extraction increment for this
    block is allowed to be about: extract the composed, routed floorplan with
    `--parasitics` at the cell-instance granularity the composed LVS already
    uses, take from it ONLY the inter-region nets' R/C, take those as a DELTA
    over what the intra-region extractions already carry, and simulate only the
    nets with a transistor-level device at both ends -- today `ro1` and `ro2`.
    This builds it.
    `layout/pex/build.py` grows a third composition path. It reads
    `layout/floorplan/trng_floorplan.gds` with `layout/floorplan/floorplan.py`'s
    own `run_extract_co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
2026-09-12 analysis: decide the post-route max-transition question and gate the residual (#243)
    The 15-corner post-route sweep added by #233 reports the library's own
    `max_transition` violated at 9 of the 15 corners. A violation count is not
    enough to decide anything, so this adds the measurement that is:
    sim/tb/digital-sta-power/max_transition_probe.py
    One OpenROAD session per corner over the same committed DEF, the same 50 ns
    constraint and the same six trunk `set_input_transition` lines the sweep
    itself uses -- it reproduces every record's `max_slew_slack_ns` to the digit
    and then decomposes it into the four things a decision needs: which nets,
    whether the design's reported timing and power ride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
2026-09-12 docs: disclose the post-route STA interface load as a floor, not the measured value (#242) (#244)
    DR-0025's full-chip PEX evidence (#232, ro1/ro2 measurement) shows the
    trunk-only Metal4 arithmetic run_sta.py's InterfaceTrunk uses undercounts
    real added capacitance by ~14% and resistance by ~48% on the shortest
    measured trunks, because it omits Metal3 riser/via R and C. That caveat
    previously lived only as a comment on the now-closed #233, so nobody
    reading run_sta.py or the characterization docs today could find it.
    Add the floor disclosure at every site the trunk-only number is computed
    or reported: InterfaceTrunk's docstring and the METAL4_* constant block
    in run_sta.py, the Interface lo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
    [run_sta.py]
2026-09-12 sim/tools: deduplicate load_variants() across variant-comparison scripts (#246)
    array_coupling_variants.py, liveness_tap_phase_variants.py, and
    array_coupling_buffer_variant.py each carried a near-identical
    load_variants() that filters a VARIANTS-style list of record globs to
    one corner and picks the latest matching record per variant. The first
    two were byte-identical; the third differed only in tuple arity and
    the Variant(...) call.
    Add starved_cell_jitter_energy.load_variants_by_glob(variants, corner,
    factory), generalizing the loop over a (label, glob, *rest) tuple
    sequence with a per-call factory for the final object, and have all
    three scripts call it instead of carrying their own cop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
2026-09-15 docs(spec): propose DR-0026, re-pin klayout-tools forward to match floorplan reports (#248)
    layout/floorplan/reports/ (regenerated by #226) and .github/workflows/
    pdk-nightly.yml's pin (#217) reference two different klayout-tools builds,
    101 commits apart (#230). This adds a Proposed decision record recommending
    the nightly pin move forward to the newer build rather than regenerating
    the floorplan reports under the older one, backed by a measured diff:
    running layout/verify.py under both builds shows zero verdict changes
    across every layout/reports/ fixture, and the newer build's deck content
    hash matches what layout/floorplan/reports/floorplan.drc.json already
    records.
    The record stays Pro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
2026-09-15 fix(digital): constrain max_transition/max_capacitance at P&R and rebuild (#240) (#249)
    klayout-tools#1860 (merged 2026-09-15) adds max_transition_ns/max_capacitance_pf
    to klt place-and-route's request contract. layout/digital/build.py's
    CONSTRAINTS now states max_transition_ns: 8.0 and max_capacitance_pf: 0.35 --
    tightened past a first, insufficient attempt at 10.0 ns after a full
    fifteen-corner re-verification found residual violations, per #240's own
    "verify, don't assume" framing.
    The rebuilt DEF (trng_top.def/.gds/.pnr.v, reports/place_and_route.json)
    reports zero max_transition and max_capacitance violations at all fifteen
    corners, versus nine and eleven of fifteen before. The digital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
    [build.py, max_transition_probe.py, test_max_transition_probe.py, trng_top.pnr.v]
2026-09-15 docs(digital): refresh README's P&R figures after #240's rebuild (#251)
    layout/digital/README.md was left unchanged by #240/PR #249's
    max_transition/max_capacitance rebuild and still cited the pre-rebuild
    OpenROAD version, Timing section table, Area section counts/ratio, and
    GDS/DRC/LVS component-count cross-reference. Re-derive every figure from
    the current layout/digital/reports/place_and_route.json and
    layout/digital/trng_top.def:
    - openroad -version: 26Q3-1260-g06a5a02279 -> 26Q3-1510-g6cb3f2b704
    (both citations; the pinned image/digest did not change).
    - Timing table and its restated figures: worst_slack_ns +27.8 -> +28.4 ns,
    fmax_mhz 45.0 -> 46.4 MHz, clock_skew_ns 0.35 -> 0.11 ns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
2026-09-16 docs: propagate idle-current figures after #240's digital rebuild (#253)
    Update root README's Power row with measured idle-current figures from PR #249 (#240):
    - Digital section idle leakage: 4.062 µA (was 3.946 µA)
    - Whole-block idle total: 4.095 µA (was 3.979 µA)
    - Miss ratio: ~4.1× (was ~4.0×)
    - Active-power figures (712.4 µW / 1.122 mW / 2.2× / 224.5%) unchanged
    The digital figures have been measured at gate-level (ff_125C_3v60 binding corner)
    and documented in sim/characterization-digital-sta-area-power.md §4.1 since #240's
    rebuild. This update propagates them into the root documentation for consistency
    with sim/tools/power_rollup.py --check output.
    Verified by running:
    - pyt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
2026-09-18 feat(interface): ship DR-0020's FIFO_DEPTH = 2 and re-derive the digital area/power estimates (#258)
    DR-0020 (`Accepted` 2026-09-07) decided FIFO_DEPTH = 2 for both output
    FIFOs; every artefact still carried the pre-ratification default of 8.
    This carries the decided value into the design and re-derives the two
    inventory estimates that price it.
    - `design/interface/regmap.py`: FIFO_DEPTH 8 -> 2; `REGMAP.md` regenerated.
    `LEVEL_BITS` is deliberately held at 4 rather than narrowed to the 2 bits
    a depth of 2 now needs -- `trng_interface.v` sizes `raw_bit_count` (a
    0..31 RAW_PACK_BITS counter) off `TRNG_LEVEL_BITS`, so narrowing it would
    silently truncate a counter that has nothing to d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
2026-09-19 docs(sim): carry the FIFO_DEPTH = 2 digital estimate into the power-budget doc (#261)
    `sim/characterization-startup-and-power-budget.md` quoted
    `design/digital_power_estimate.py` at seven places, all at the pre-DR-0020
    `FIFO_DEPTH = 8`. #254/PR #258 moved the script to the ratified depth of 2 and
    prepended an update block naming the new idle figure and flop count, but the
    figures woven into the argument further down the document -- the headline
    rows, the two rollup tables, the leakage-split table and the bullets that
    reason about which half of the estimate carries the miss -- were still
    unlabelled depth-8 numbers a reader would meet with no depth attached.
    Every one of those quotations now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
2026-09-19 docs(sim): correct the FIFO-read-path mux2_1 leakage figure to 5.60 µW (#263)
    sim/characterization-startup-and-power-budget.md's idle-leakage-split
    bullet stated the FIFO_DEPTH=8 read-path total (576 mux2_1 cells: two
    32-bit 8:1 read muxes, the 4:1 reg_rdata mux, and the streaming mux) as
    6.28 µW. That figure does not reproduce from the ff_125C_3v60 Liberty
    data (default-state leakage is 9.724 nW/cell, so 576 cells is 5.601 µW,
    not 6.28 µW), from the highest/lowest per-cell leakage states in the
    same Liberty file, or from design/digital_power_estimate.py's
    leakage-plus-dynamic total for these three inventory rows (6.42 µW).
    git history on both this document and digital_power_estimate.p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
2026-09-19 feat(digital): re-synthesize and re-place-and-route at DR-0020's FIFO_DEPTH = 2 (#266)
    Issue #254 landed FIFO_DEPTH = 2 in the RTL, regmap and pre-synthesis gate
    inventory but explicitly left the physical digital artefacts (synthesized
    netlist, routed GDS/DEF/SDF, and the gate-level STA/area/power
    characterization) at the old FIFO_DEPTH = 8 build. This closes that gap.
    - Regenerated design/trng_top/trng_top.synth.v/.json via design/synth.py
    (1459 instances, 57 424.6 um^2); `python3 design/synth.py --check` passes.
    - Re-ran layout/digital/build.py's place-and-route (1458 logical + 2978
    tapcell/endcap/filler = 4436 DEF COMPONENTS, clean `klt drc`, power
    isolation ok) and layout/digital/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
    [trng_top.sdf]
2026-09-22 docs: propagate #255/#266's depth-2 digital power figures into the Power row (#272)
    README's Power row and sim/characterization-startup-and-power-budget.md
    still quoted #145's FIFO_DEPTH = 8 measured gate-level digital figures
    (712.4 uW active / 4.062 uA leakage, 224.5 % / ~4.1x miss) even though
    issue #255 (merged via #266) re-synthesized and re-placed-and-routed the
    digital section at DR-0020's ratified FIFO_DEPTH = 2 and re-ran the same
    fifteen-corner sweep. sim/tools/power_rollup.py already reads its digital
    term live from the committed record family, so its own arithmetic already
    reflected the smaller depth-2 figures (358.5 uW active / 1.974 uA leakage,
    whole-block totals of 768.5 uW /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
2026-09-22 feat(signoff): commit a klt signoff block manifest so T1 state is graded, not hand-read (#274)
    This repo had no `klt signoff` block manifest, so its position on the
    klayout-tools design-evidence ladder was hand-written prose in issue #124
    that went stale whenever either the evidence or the checklist moved. Both
    moved: the checklist grew an eleventh item on 2026-09-17
    (klayout-tools#2025), which invalidated every prior hand-read at a stroke.
    What lands:
    - `signoff/block-manifest.json` -- `block: "gf180-trng"`, `kind:
    "mixed-signal"`, and a `partition_boundary` declaration (klayout-tools#2278)
    naming which regions, sources, layout flow, supplies and boundary pins
    belong to each side. T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
2026-09-23 fix(digital): re-tune max_transition_ns for the FIFO_DEPTH = 2 topology (#277)
    #255's depth-2 re-place-and-route reused the depth-8-tuned
    max_transition_ns: 8.0 and violated the library's own max_transition
    check at 11 of 15 corners (worst -1.6041 ns, tt_025C_3v30/rc-max).
    max_transition_probe.py's per-net decomposition over that DEF traced the
    residual to two nets (net4, 42 loads, dlyd_1 driver; u_interface/_0519_,
    33 loads, and4_1 driver), neither on a #233 trunk.
    The probe's naive required figure (10.99 ns) was already looser than the
    8.0 ns target that failed, so layout/digital/build.py now states
    max_transition_ns: 4.0 (the family's tightest corner limit is
    ff_n40C_3v60 at 4.4 ns). The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
    [trng_top.sdf]
2026-09-23 feat(signoff): re-emit the digital DRC/LVS as gradeable klt envelopes (3/22 -> 5/22) (#282)
    `signoff/records/t1-tier-report.json` read 3 of 22 T1 items met. Two of the
    nineteen `unmet` rows were not about missing verification: the digital
    partition's DRC has been clean and its LVS matching since #170/#187 (re-run
    at `FIFO_DEPTH = 2` by #255/#266), and both results were committed. They
    graded `unmet`/`no_evidence` because `layout/digital/build.py` and
    `layout/digital/lvs.py` reduced `klt`'s responses to verdict digests before
    writing them, dropping `schema_version`, the `violations`/`mismatches` array
    and the `provenance` block -- exactly what `klt signoff` reads to classify a
    cited file. The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
    [build.py, lvs.py]
2026-09-23 docs: carry #277's re-tuned depth-2 digital power figures into README's Power row (#286)
    PR #277 re-tuned the digital section's `max_transition_ns` (8.0 -> 4.0) for
    the FIFO_DEPTH = 2 topology and rebuilt it, re-running #145's fifteen-corner
    `level: gate` sweep against the clean build
    (`sim/records/2026-09-22-digital-sta-power-{01..15}.md`). Because
    `sim/tools/power_rollup.py` reads its digital term live from that committed
    record family, the tool's own verdict moved with the rebuild while README's
    ratified Power row and its extended ratification note still quoted the
    superseded #255/#266-era figures.
    Both halves of the row are re-stated against the current rollup output:
    Worst active co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
2026-09-23 Remove dead --record CLI flag from six testbench entry points (#289)
    parser.add_argument("--record", action="store_true", ...) was defined in
    six run_demo.py/run_battery.py scripts but args.record was never read
    anywhere; the write-vs-skip decision is made entirely by --no-write.
    Minting a record is already the unwritten default, so removing the flag
    cannot change any script's behavior.
    Also updates each module docstring's "Add --record (the default) to mint
    a new record" line to describe the actual default behavior instead. The
    value-taking --record flag in sim/tools/jitter_estimator_calibration_check.py
    and the shell-level --record toggle in sim/selftest.sh are unrelated and
    untouched.
    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
    [run_demo.py]
2026-09-27 fix(layout): tolerate net_id swap on uniquely-named nets in freshness gate
    layout/reports/ro_ring11.extract.json was failing layout/verify.py's
    compare_reports freshness gate under pdk-nightly.yml's pinned toolchain,
    while its structurally identical ro_ring11_ring2 sibling passed.
    Reproduced with klt/PDK pinned bit-for-bit identical to pdk-nightly.yml
    (klayout-tools@3fbb4478, klayout==0.30.12, gf180mcu f6eeac7d) on both a
    macOS arm64 host and a Linux x86_64 container matching the CI runner: the
    two hosts' klt extract reports for ro_ring11 agree on everything except
    the net_id assigned to two uniquely-named nets (en/vss), which come out
    swapped (1/2) depending on architecture. ro_ring11_ring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
    [verify.py]
2026-09-27 docs(signoff): correct three stale T1 claims in README's claimant reading
    signoff/README.md's item 5 and item 6 rows, and the build-pins prose, were
    written when a klt yield report and a klt sim envelope both read as
    "not yet produced" and the grader pin read as a settled yardstick. Upstream
    klayout-tools has since established all three claims are stronger than that:
    - Item 6's klt yield report is unreachable from any published release (it
    needs the klt_yield_native Rust extension, which ships in no prebuilt
    wheel — klayout-tools#2474, #2531), and #2480 additionally makes the
    campaign's own sample-size/negative-control results grading inputs.
    - Item 5's analog half is uncitable at a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
2026-10-01 chore: resync installed Loom surfaces
    resynced_by: fleet-resync
    invocation: fleet-resync.sh --fleet-only --push
    <!-- loom:provenance v1 build=unknown 19f4e67fd0a0afbd3d8b6606ca91ceac911377a3 clean prompts=none sweep=none story=none trace=78a5dfbdfd8c530aecd1bb436fd096df host=loom-worker-2 base=3e27f1190acbe2da312f39593cb19ec3678718c8 run=loom-run/v1:timer:loom-worker-2/fleet-resync:67c759f7ef3c43e38d3fa8d5f19a2dd1 installs=0.19.593 658650a4f0eff932ac66a8f690eaedf8123fc83b -->
    Loom-Story: none
    Loom-Trace-Id: 78a5dfbdfd8c530aecd1bb436fd096df
    Loom-Build: unknown 19f4e67fd0a0afbd3d8b6606ca91ceac911377a3 clean
2026-10-01 chore: resync installed Loom surfaces
    <!-- loom:provenance v1 build=unknown 56435bf476452911283e43940ecfd9a30f804af9 clean prompts=none sweep=none story=none trace=342405c5ebc99bdbf17afbd983c0c41c host=loom-worker-2 base=8a488cbd74e0fd63955cd1bd043e1c7b314685e1 run=loom-run/v1:timer:loom-worker-2/fleet-resync:20c09f231d424cd5b57ca7991848dd8a installs=0.19.603 8c39bf7cde8a8c03d1aaee441f397c017b6a3a9e -->
    Loom-Trace-Id: 342405c5ebc99bdbf17afbd983c0c41c
    Loom-Build: unknown 56435bf476452911283e43940ecfd9a30f804af9 clean
    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
2026-10-01 chore: resync installed Loom surfaces
    <!-- loom:provenance v1 build=unknown f2868e6b4d60d11a8ab47d25cad9e248229d2f66 clean prompts=none sweep=none story=none trace=4e2766ed5160781df891476246a9be2e host=robb-studio base=dfc7991c1f9b86c6d3ae7fa3d35e0280297746b3 run=loom-run/v1:timer:robb-studio/fleet-resync:2d3851d5-1673-43ae-bcc6-e5c971b37f33 installs=0.19.603 74778a6aeea5d9e06b489400942b35f33c8bb766 -->
    Loom-Trace-Id: 4e2766ed5160781df891476246a9be2e
    Loom-Build: unknown f2868e6b4d60d11a8ab47d25cad9e248229d2f66 clean
    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
2026-10-01 chore: resync installed Loom surfaces
    <!-- loom:provenance v1 build=unknown d6714830391f7596338b8de40ee2d0f45dcd12f5 clean prompts=none sweep=none story=none trace=af273f717e759e690d07f372734e9278 host=robb-pro base=67273003e8708c6aa9e6292bcb6e75085211cbb4 run=loom-run/v1:timer:robb-pro/fleet-resync:92e2f9ba-d083-411b-833b-ae52d169ef04 installs=0.19.605 6eb2b65a4496b7becb84ef1f944493a541fd01cd -->
    Loom-Trace-Id: af273f717e759e690d07f372734e9278
    Loom-Build: unknown d6714830391f7596338b8de40ee2d0f45dcd12f5 clean
    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
2026-10-01 chore: resync installed Loom surfaces
    <!-- loom:provenance v1 build=unknown 617257919edc1b9b9ee27532c5ec1b8a64523388 clean prompts=none sweep=none story=none trace=cb047565635d880cd4ae328b5cfaaf68 host=loom-worker-1 base=18a59c7ec3d6be1490e64d90fec3ea50cb1db1af run=loom-run/v1:script:loom-worker-1/fleet-resync:9973280a-d0de-4196-8cdb-f221825edc41 installs=0.19.609 ff30576dacc8c2734b1c7434bedd29c47122caeb -->
    Loom-Trace-Id: cb047565635d880cd4ae328b5cfaaf68
    Loom-Build: unknown 617257919edc1b9b9ee27532c5ec1b8a64523388 clean
    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
2026-10-01 chore: resync installed Loom surfaces
    <!-- loom:provenance v1 build=unknown 617257919edc1b9b9ee27532c5ec1b8a64523388 clean prompts=none sweep=none story=none trace=dbafe4f8526617aa07c890721298a080 host=robb-studio base=595c9203abaee3e771e91590db180ad9316dea6d run=loom-run/v1:timer:robb-studio/fleet-resync:1817df66-02cc-4b27-927d-a38485da550a installs=0.19.610 c94891dd526cf6db5ee02045424c6913be522048 -->
    Loom-Trace-Id: dbafe4f8526617aa07c890721298a080
    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
2026-10-01 chore: resync installed Loom surfaces
    <!-- loom:provenance v1 build=unknown a2a39ac2736eb2686e2c65412d939e67c0438a7d clean prompts=none sweep=none story=none trace=fc1a121767151aae5bd7427c683b7db6 host=robb-pro base=2e0d8c34c8c841397c0dd7b3a2ff20f5fca63c5d run=loom-run/v1:timer:robb-pro/fleet-resync:708eb7c8-469d-4783-80b7-bafe142df3c4 installs=0.19.612 d25614656adcf70162da95c5e1035e99a0639a1a -->
    Loom-Trace-Id: fc1a121767151aae5bd7427c683b7db6
    Loom-Build: unknown a2a39ac2736eb2686e2c65412d939e67c0438a7d clean
    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
2026-10-01 chore(tooling): update repo-skills to v0.19.5
    Fleet-wide Repo Skills rollout (2026-10-01). compute-drift's axis 6
    reported repo-skills at 11 different versions across the fleet's
    checkouts; this brings gf180-trng from v0.10.0 to v0.19.5 (rjwalters/repo
    @ ff282cd), staging only the installer's own surface.
    Loom-Trace-Id: 038dce5d677bceeeca3c111787ac5b68
    Loom-Build: unknown unknown unknown
    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
2026-10-01 chore: resync installed Loom surfaces
    <!-- loom:provenance v1 build=unknown 126c80914e42f913c4fc778d3ddce96daa2c7a77 clean prompts=none sweep=none story=none trace=15a20fbea7a00d0922b943088c80e19d host=loom-worker-1 base=b736e69a60c5ce0cd332b6077afeedaa4520ae95 run=loom-run/v1:script:loom-worker-1/fleet-resync:ecc423da-4625-49de-b25a-692fd669a029 installs=0.19.612 d47e0c57a6bea6f7b61ef9ce62632d70c39ef5d5 -->
    Loom-Trace-Id: 15a20fbea7a00d0922b943088c80e19d
    Loom-Build: unknown 126c80914e42f913c4fc778d3ddce96daa2c7a77 clean
    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
2026-10-01 chore: resync installed Loom surfaces
    <!-- loom:provenance v1 build=unknown 126c80914e42f913c4fc778d3ddce96daa2c7a77 clean prompts=none sweep=none story=none trace=a0a42bd10fcfa6d7cbcc9c021c406848 host=loom-worker-2 base=b07be1b8e08e70cbc17e01695dfc0ce3410c36af run=loom-run/v1:timer:loom-worker-2/fleet-resync:9e174e6bb0fa41d786e4a86e45632b6f installs=0.19.612 6f0871dc66e62b36d8382ced980d2805bfd97e50 -->
    Loom-Trace-Id: a0a42bd10fcfa6d7cbcc9c021c406848
    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
2026-10-01 chore: resync installed Loom surfaces
    <!-- loom:provenance v1 build=unknown 6f3411c8a63e68097dde01bce8a8422230f54218 clean prompts=none sweep=none story=none trace=9aa0a46bb352b9665fdaa5f5b3b85dd7 host=robb-pro base=35df571a6617af2f2e13886b1f84fb5bae3e1caa run=loom-run/v1:timer:robb-pro/fleet-resync:ca419e1d-6646-4678-ac7a-b263e4b5119e installs=0.19.612 7731400b3e3e1df39074564166edf656feb0999c -->
    Loom-Trace-Id: 9aa0a46bb352b9665fdaa5f5b3b85dd7
    Loom-Build: unknown 6f3411c8a63e68097dde01bce8a8422230f54218 clean
    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
2026-10-02 chore: resync installed Loom surfaces
    <!-- loom:provenance v1 build=unknown 13c0a3ef467a888520a6529ab34486ab8be826be clean prompts=none sweep=none story=none trace=41356080f367e491d5ff03f17bb98c27 host=loom-worker-2 base=bbbfa1be4d04306af5d1101d05d956b2a80c5820 run=loom-run/v1:timer:loom-worker-2/fleet-resync:44455fbcbab745abb92cea192fafbb1d installs=0.19.614 3c79f7b1d0cc14723e049cff4250ff7330804326 -->
    Loom-Trace-Id: 41356080f367e491d5ff03f17bb98c27
    Loom-Build: unknown 13c0a3ef467a888520a6529ab34486ab8be826be clean
    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
2026-10-02 chore: resync installed Loom surfaces
    <!-- loom:provenance v1 build=unknown ea2dd21f2ba310ec007d047ddfecc6cd27d220ac clean prompts=none sweep=none story=none trace=f04a67f3922788d2ccdd66578c8d18f9 host=loom-worker-1 base=15c98b65a2b59cecc4d6ab0027bcd3b5c98ae16b run=loom-run/v1:timer:loom-worker-1/fleet-resync:1c3b601dd998488595adc09040c007d4 installs=0.19.614 79f4897c5d3c78dbfc1b022f77d244838dbf4ccb -->
    Loom-Trace-Id: f04a67f3922788d2ccdd66578c8d18f9
    Loom-Build: unknown ea2dd21f2ba310ec007d047ddfecc6cd27d220ac clean
    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
2026-10-02 chore: resync installed Loom surfaces
    <!-- loom:provenance v1 build=unknown 6f3411c8a63e68097dde01bce8a8422230f54218 clean prompts=none sweep=none story=none trace=acb28d0049e0cc75536f96d503f6e814 host=robb-studio base=95ff956c7e92b263f8bcdc925565a2436d6fd8c3 run=loom-run/v1:timer:robb-studio/fleet-resync:85d2b1b5-e81d-40c3-ab6a-9a00efbc4ee2 installs=0.19.616 d86523eeadb32b95777f3cd3a76dd2f72f0bf792 -->
    Loom-Trace-Id: acb28d0049e0cc75536f96d503f6e814
    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
2026-10-02 chore: resync installed Loom surfaces
    <!-- loom:provenance v1 build=unknown 2b50bd69eddd038dd738465aa58a9ebca11410ac clean prompts=none sweep=none story=none trace=324e4f607054d0396cfdf8fdc01e93ae host=robb-pro base=074a048adc2cdf418ba90fadebdd83f123a38db7 run=loom-run/v1:timer:robb-pro/fleet-resync:a63799f1-2ad7-4946-b81d-2ec231bc2d2f installs=0.19.617 81cb2ad7e091b19d6a2b95d1add6938c2100d46b -->
    Loom-Trace-Id: 324e4f607054d0396cfdf8fdc01e93ae
    Loom-Build: unknown 2b50bd69eddd038dd738465aa58a9ebca11410ac clean
    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
2026-10-02 chore: resync installed Loom surfaces
    <!-- loom:provenance v1 build=unknown 00d92b326aed50280cd90dc116b7caec27668251 clean prompts=none sweep=none story=none trace=9a5d23cc82b6d3a1c83bfee47bd04970 host=loom-worker-2 base=e564b7e624803ae580de94c843aea44e2ba7345d run=loom-run/v1:timer:loom-worker-2/fleet-resync:12136a7a025d49f3a60b5edb04a3ff81 installs=0.19.619 4c0f505e4f0b76f8ccec07bda6d8b839030c077b -->
    Loom-Trace-Id: 9a5d23cc82b6d3a1c83bfee47bd04970
    Loom-Build: unknown 00d92b326aed50280cd90dc116b7caec27668251 clean
    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
2026-10-02 chore: resync installed Loom surfaces
    <!-- loom:provenance v1 build=unknown 456dad6d90259846313dc3bb80bf4e5471ef2d76 clean prompts=none sweep=none story=none trace=bb9688c03fb5211d06f48c8838a5505c host=robb-studio base=ceb24b640d1e012713ebfc8a28a58ee52ae8356a run=loom-run/v1:timer:robb-studio/fleet-resync:e965c017-8ec7-485d-b46e-aeb399b81fb4 installs=0.19.620 0d28ba49f5a88fdb37271de9cb0144eb3442c6e3 -->
    Loom-Trace-Id: bb9688c03fb5211d06f48c8838a5505c
    Loom-Build: unknown 456dad6d90259846313dc3bb80bf4e5471ef2d76 clean
    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
2026-10-02 chore: resync installed Loom surfaces
    <!-- loom:provenance v1 build=unknown 6c6d2b6565dc13eff4c6811b9c670f452106516b clean prompts=none sweep=none story=none trace=539be979ae694d66ede516a7b5d17e41 host=robb-pro base=7bc42a4f460e43c698215c6514f2eb14b78c236c run=loom-run/v1:timer:robb-pro/fleet-resync:9444d216-de08-442f-8352-ba59f6e81bb3 installs=0.19.621 a90dc1d794eb9ff70aaf939ebf495abe716f3bdd -->
    Loom-Trace-Id: 539be979ae694d66ede516a7b5d17e41
    Loom-Build: unknown 6c6d2b6565dc13eff4c6811b9c670f452106516b clean
    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
2026-10-02 chore: resync installed Loom surfaces
    <!-- loom:provenance v1 build=unknown f6d28134bfe476967e005d97424073085f55e8a3 clean prompts=none sweep=none story=none trace=27eb90670d441065f593e941066ee005 host=loom-worker-2 base=26f95642c1912ab33068f0340113106ff965b49a run=loom-run/v1:timer:loom-worker-2/fleet-resync:04001bba930241cf9e325bf304a9270a installs=0.19.623 ccc19c2bbe2aa65328427730fa53f70eb56128c6 -->
    Loom-Trace-Id: 27eb90670d441065f593e941066ee005
    Loom-Build: unknown f6d28134bfe476967e005d97424073085f55e8a3 clean
    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
2026-10-02 chore: resync installed Loom surfaces
    <!-- loom:provenance v1 build=unknown bc461736314499b6c2c4c0ad51fb2294f60336f5 clean prompts=none sweep=none story=none trace=c3ea68717dd3a908dbbd60a35bc8b5d6 host=robb-studio base=950c13d5c4c5d459a34ed5b84cfa8435f5bd384a run=loom-run/v1:timer:robb-studio/fleet-resync:8d4c49e2-3258-4080-b0c8-082499053654 installs=0.19.623 a50aaf70069f8897c41a64b7d90783c5ab8294e0 -->
    Loom-Trace-Id: c3ea68717dd3a908dbbd60a35bc8b5d6
    Loom-Build: unknown bc461736314499b6c2c4c0ad51fb2294f60336f5 clean
    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
2026-10-02 chore: resync installed Loom surfaces
    <!-- loom:provenance v1 build=unknown bc461736314499b6c2c4c0ad51fb2294f60336f5 clean prompts=none sweep=none story=none trace=8bee8a664bfc89e0bbfbb3c2de7342ba host=loom-worker-2 base=0178605a598846946ff277b5c6f323f84ae67ac2 run=loom-run/v1:timer:loom-worker-2/fleet-resync:de2ceceb48ea4927a1334d08dc0082fe installs=0.19.624 5f49564fa78ae06f8c48d5224dae9ded04200bb7 -->
    Loom-Trace-Id: 8bee8a664bfc89e0bbfbb3c2de7342ba
    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
2026-10-03 chore: resync installed Loom surfaces
    <!-- loom:provenance v1 build=unknown 752d316233ed1a3da9e4f69ad760eb99bb477747 clean prompts=none sweep=none story=none trace=7851839b67c00a023e97cbdea1f580e1 host=robb-pro base=dd245a1d4a51c9df5305b146ab47862de20acc7f run=loom-run/v1:timer:robb-pro/fleet-resync:ae492b66-dca0-4da4-acab-8d26778f2d5c installs=0.19.624 121fac45f5006879bf58a18c951b9243d9099a18 -->
    Loom-Trace-Id: 7851839b67c00a023e97cbdea1f580e1
    Loom-Build: unknown 752d316233ed1a3da9e4f69ad760eb99bb477747 clean
    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
2026-10-03 chore: resync installed Loom surfaces
    <!-- loom:provenance v1 build=unknown b34a08286a42f47f917ec46647d4d167c1f5207c clean prompts=none sweep=none story=none trace=a8e453124b899b440f42c9d83837c7b6 host=loom-worker-2 base=45635530d0ff65b73c4825673155ab473d436794 run=loom-run/v1:timer:loom-worker-2/fleet-resync:f02dd5df715347fe90fe14b9353a1b66 installs=0.19.624 98c193cf0d12d68d3770edc1baad808c40bb5fd4 -->
    Loom-Trace-Id: a8e453124b899b440f42c9d83837c7b6
    Loom-Build: unknown b34a08286a42f47f917ec46647d4d167c1f5207c clean
    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
2026-10-03 chore: resync installed Loom surfaces
    <!-- loom:provenance v1 build=unknown 3437cece5ab759f772122f8d18a6d2f05d246cde clean prompts=none sweep=none story=none trace=1bd6b75d1c0daff2b433adf5999546a3 host=loom-worker-1 base=82ddd9e0001a781e1bc903a42b920f2d29a7b4ce run=loom-run/v1:timer:loom-worker-1/fleet-resync:4c0abac1c29646eaa8502afa223bdd2b installs=0.19.624 0162badc662fb30c070e70611aa8ff74a8486d54 -->
    Loom-Trace-Id: 1bd6b75d1c0daff2b433adf5999546a3
    Loom-Build: unknown 3437cece5ab759f772122f8d18a6d2f05d246cde clean
    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
2026-10-03 chore: resync installed Loom surfaces
    <!-- loom:provenance v1 build=unknown 3437cece5ab759f772122f8d18a6d2f05d246cde clean prompts=none sweep=none story=none trace=bba21427f750636f851279cfae92b4e5 host=loom-worker-1 base=1300bb962e2e141c29695701d307723b216c69dc run=loom-run/v1:timer:loom-worker-1/fleet-resync:9440cda9476f404caa282e360a81ee03 installs=0.19.636 e41edfbb52c13982f7d8b0577f42957427a6514c -->
    Loom-Trace-Id: bba21427f750636f851279cfae92b4e5
    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
2026-10-03 chore: resync installed Loom surfaces
    <!-- loom:provenance v1 build=unknown 28040ed11a4369e20f3b7b0154a3fb2a2c35d38c clean prompts=none sweep=none story=none trace=0cd87d01c45d97a2ee57a99363fc0db2 host=robb-studio base=b1c78e9771491802e89bfbd1e1d32ade96a40baf run=loom-run/v1:timer:robb-studio/fleet-resync:74b93657-6b04-4ac5-bc77-e0a1682b0595 installs=0.19.636 e41edfbb52c13982f7d8b0577f42957427a6514c -->
    Loom-Trace-Id: 0cd87d01c45d97a2ee57a99363fc0db2
    Loom-Build: unknown 28040ed11a4369e20f3b7b0154a3fb2a2c35d38c clean
    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
2026-10-03 chore: resync installed Loom surfaces
    <!-- loom:provenance v1 build=unknown 388c7fe0cad997f7a887f70c9f2cfe8781a2d512 clean prompts=none sweep=none story=none trace=2046ffd42f138a06b914f34851de3440 host=loom-worker-2 base=6f1e8f5e4cb9fcf68d52c37ebdfebf484f22708e run=loom-run/v1:timer:loom-worker-2/fleet-resync:17c9456bb1934c70a545b12081496cce installs=0.19.647 d1fe5dead4202be12a964ab891fd5980e7836170 -->
    Loom-Trace-Id: 2046ffd42f138a06b914f34851de3440
    Loom-Build: unknown 388c7fe0cad997f7a887f70c9f2cfe8781a2d512 clean
    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
2026-10-03 chore: resync installed Loom surfaces
    <!-- loom:provenance v1 build=unknown 8078c29e691123d91cd761a786f99cfd25f1809d clean prompts=none sweep=none story=none trace=45869a6374635c036a11a6f379fe31a4 host=robb-pro base=79026b414ccd766a36976e14006ea408e86aa3d3 run=loom-run/v1:timer:robb-pro/fleet-resync:b0a94991-052d-4e7d-ba2b-78b971096849 installs=0.19.647 709ca4396e074e5a4d1c5e19721f6ddac7154ca2 -->
    Loom-Trace-Id: 45869a6374635c036a11a6f379fe31a4
    Loom-Build: unknown 8078c29e691123d91cd761a786f99cfd25f1809d clean
    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
2026-10-03 chore: resync installed Loom surfaces
    <!-- loom:provenance v1 build=unknown f9cba29b0602624a23daa17ae04d31d82e10fa91 clean prompts=none sweep=none story=none trace=754b3688f97b6c34894d8cfbf272b81a host=loom-worker-1 base=4be06144e124edd91c49112b560d3b9c030018f0 run=loom-run/v1:script:loom-worker-1/fleet-resync:11eb117a-9ff3-4411-88d4-fdd7d6748639 installs=0.19.649 6f2f13b1c31ce420e2250ae040d8e1050c0e761b -->
    Loom-Trace-Id: 754b3688f97b6c34894d8cfbf272b81a
    Loom-Build: unknown f9cba29b0602624a23daa17ae04d31d82e10fa91 clean
    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
2026-10-03 chore: resync installed Loom surfaces
    <!-- loom:provenance v1 build=unknown f9cba29b0602624a23daa17ae04d31d82e10fa91 clean prompts=none sweep=none story=none trace=544a028e3829d4020b8aaa144e5fa628 host=robb-studio base=18c716dab13bf048e679cd2cad0f0feb4f8f3c71 run=loom-run/v1:script:robb-studio/fleet-resync:5b5b8b83-7139-447d-88bd-417dcf375aa6 installs=0.19.649 6f2f13b1c31ce420e2250ae040d8e1050c0e761b -->
    Loom-Trace-Id: 544a028e3829d4020b8aaa144e5fa628
    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
2026-10-07 fix(digital): rebuild place-and-route from the re-baselined netlist, guard the input hash (#293)
    PR #292 re-synthesized design/trng_top/trng_top.synth.v but did not re-run
    layout/digital/build.py. The committed implementation therefore descended
    from the old netlist: reports/place_and_route.json's
    provenance.input.content_hash read sha256:224d01d5... while the committed
    netlist hashes to sha256:a370c452.... Nothing compared the two.
    Re-ran the whole digital chain on the current netlist (klt 0.6.0 release,
    OpenROAD 26Q3-1510 from the digest-pinned openroad/orfs image, open_pdks
    f6eeac7d):
    - build.py: trng_top.def/.gds/.pnr.v and reports/{place_and_route,drc}.json.
    DRC clean; the recorded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
    [trng_top.sdf]
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2026-10-08 Ratify DR-0026 amended to klayout-tools 0.6.0 and re-produce layout/reports/ under it
    DR-0026 is accepted as amended: the normative producer build is the
    klayout-tools 0.6.0 PyPI release (tag v0.6.0, commit c622e8addb36), with
    klayout==0.30.10, the engine that release records it was tested against.
    It replaces the git SHA c903103cba9e the record first proposed. The record
    keeps its original text and adds an amendment with the re-measurement:
    after reproducing the committed reports exactly under the old 3fbb4478 pin
    on the same host and PDK commit, all 13 layout/verify.py fixtures keep
    every DRC verdict and rule count, every device/net count, every extracted
    netlist and LVS request byte for b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
    [verify.py]
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2026-10-08 floorplan: derive the composed interface for klt 0.6.0 and compare it by name (#309)
    The inter-region check subtracted five declared pins (en1, en2, vdd,
    vddr1, vddr2) as unnameable through --pins. From klt 0.6.0 --pins matches
    any one component of a joined net label, so those five are promoted under
    their joined names (en|en1, en|en2, d|vdd, vddr|vddr1, vddr|vddr2).
    The expected interface is now one promoted net per declared pin, named by
    its predicted label set, plus the explicit duplicate-name promotions
    (still none). Count and promoted names are compared exactly, so an
    unexpected or omitted pin fails by name. Stale comma-joining and
    five-unnameable-pin explanations are corrected; the RE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
2026-10-08 feat(signoff): publish post-route functional run as T1 item 7 digital citation (#314)
    Re-ran sim/tb/trng-top-post-route against the current post-route netlist and
    SDF (8/8 scenarios, gate identical to RTL, annotation control fired), then
    published the native klt functional-verification response as the 7.digital
    citation. The envelope has no provenance block, so freshness is carried by a
    publication sidecar pinning the netlist and SDF separately plus the raw
    evidence; check.py re-verifies it on every run and publish_item7.py refuses a
    failed or stale run. Also fixes scenarios.py not putting sim/ on sys.path
    under cocotb (harness import). Verdict of record 5/22 -> 6/22.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
    [test_signoff_item7.py]
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2026-10-08 Guard the corpus totals quoted in README.md against the tree
    README.md's opening paragraph quotes three corpus sizes in prose, and they
    had drifted again: twenty-one decision records (the tree has 26 distinct
    DR ids across 28 files), twelve characterization summaries (15), and 975
    evidence records (976).
    Add sim/tools/corpus_counts.py, a stdlib-only, read-only guard that
    derives the three totals from direct children of spec/decision-records/
    (distinct DR-NNNN ids), sim/characterization-*.md and sim/records/*.md,
    and compares them with the figures quoted in README.md (required) and
    sim/README.md (only if it repeats a total). Digits and spelled-out numbers
    up to ninety-nine parse; Markdown li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
    [test_corpus_counts.py]
2026-10-08 Cite 11.digital supply-ERC report in the T1 manifest (#321)
    Pin layout/digital/reports/erc-supply.json (to the GDS it ran on) as
    11.digital and regenerate the verdict of record under klt 0.6.0. Only item
    11's digital reason changes: no_evidence -> wrong_kind, still unmet. Item 11
    is a compound claim (erc + lvs + place-and-route); a lone ERC citation is
    the wrong set. README rows updated to say so without claiming progress.
    Loom-Story: 2AMLogic/gf180-trng#321
    Loom-Trace-Id: 5e49de82fea552c6d31e70539b1685e8
    Loom-Build: 0.19.868 ee904e1c151bc9cf15b0eb55dfe9d57ad6136cff clean
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2026-10-08 Cite 11.analog supply-ERC reports in the T1 manifest (#327)
    Add klt erc supply specs for the analog regions (rings, combiner_sampler),
    declared from the labels and layers actually present in the committed
    streams, run them under klt 0.6.0, and pin the three reports as 11.analog.
    All three read erc_status clean with zero findings. No ties[] is declared
    (the streams draw no implant or LVPWELL layers and the reference netlists
    float every PMOS well), so each spec carries an unexpressible
    ties_disclosure and erc.missing_tie is not computed. Item 11 analog moves
    from unmet/no_evidence to unmet/wrong_kind, the same compound-claim reading
    as the digital column; it is not progress toward met. LVS p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
2026-10-08 Enforce append-only sim/records against the PR base in CI (#328)
    Add sim/tools/verify_evidence_history.py, which compares committed
    evidence under sim/records/ with a base revision (merge-base .. HEAD).
    New records and raw files pass; modification, deletion, rename or type
    change of existing files fails. The only accepted edit to an existing
    record is the documented supersession transition, verified byte-exactly,
    with the replacement record required to exist and declare the back-link.
    An unloadable base (shallow clone, all-zero SHA) is an error, never an
    empty diff.
    CI now fetches full history and runs the check with the PR base SHA or
    the pre-push SHA. Tests use temporary git repositories.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
    [test_verify_evidence_history.py]
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2026-10-08 Unit-test the signoff freshness gate against its failure branches (#337)
    Pins check_envelope_against_its_input, pinned_input_hash and
    manifest_entries with synthetic envelopes, plus a positive control that
    freshness_gate() passes on the committed manifest. No change to check.py.
    Loom-Story: 2AMLogic/gf180-trng#337
    Loom-Trace-Id: b1d4e763df32697ed9288f9e7abafb75
    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
    [test_signoff_freshness.py]
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2026-10-08 Guard every restated klt/klayout pin against signoff/check.py (#344)
    The normative klayout-tools build (DR-0026) is restated by hand in CI
    workflows, READMEs, docstrings and DR-0026 itself, but only
    signoff/check.py's KLT_PIN was machine-read. A pin bump that missed one
    site could leave CI installing a different klt than the grader expects,
    or a README pointing readers at a build that cannot reproduce the
    committed reports.
    - signoff/check.py: add KLAYOUT_PIN ("0.30.10") next to KLT_PIN, so the
    whole normative pair is defined in one place. Values are unchanged.
    - sim/tools/klt_pin_sites.py: stdlib-only guard, same shape as
    corpus_counts.py. It reads both constants (parsed, not imported)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
    [test_klt_pin_sites.py, verify.py]
2026-10-08 Keep klt_pin_sites docstring example out of the pin inventory (#344)
    The module docstring illustrated a historical mention with a literal
    klayout-tools pin, which the guard itself counted as an out-of-date pin
    once the file was tracked, so --check failed on its own source. Reword
    the example as prose so it is not a pin match.
    Loom-Story: 2AMLogic/gf180-trng#344
    Loom-Trace-Id: 859fe0b9c22bfa3f89401cfe88956dd7
    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
2026-10-08 Append post-route run 02 with source pinning and republish item-7 digital (#350)
    Run 01 predates sources.json, so the source-pinned item-7 gate could not
    accept it. This appends a new run (run 01 is untouched), produced with
    cocotb 2.0.1 on CPython 3.13 and re-published from that run's own
    sources.json; no hash was edited by hand.
    publish_item7.py no longer refuses because the envelope still on disk (the
    one being replaced) differs from the new publication's sha256; check.py
    re-verifies the copied envelope afterwards.
    Loom-Build: 0.19.898 3d55b9a1669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
2026-10-09 test(sim): add direct unit tests for the shared record parser
    sim/tools/_record_parsing.py backs seven derivation tools but was only
    exercised end to end through npm run check:spec. Add
    sim/tests/test_record_parsing.py (stdlib unittest, no PDK or simulator)
    pinning its current contracts:
    - parse_values: plain, negative and lowercase-exponent numbers, the
    optional "mean" prefix, numeric-prefix extraction without unit
    scaling (2.5ns -> 2.5), omitted non-matching bullets, last value wins
    on repeated keys, ValueError on a malformed capture such as 1.2.3.
    - field: multiline anchors, raw string captures, RuntimeError by
    default on a missing match, label prefix and pattern in the message,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
    [test_record_parsing.py]
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2026-10-09 test(sim): add fail-path tests for four spec-guarding --check gates
    array_sizing, jitter_energy_law, starved_cell_jitter_energy and
    sampler_bit_bias_variants each guard a ratified-spec claim, but nothing
    showed their --check paths fail when they should. Add stdlib unittest
    modules with two halves per tool: derivation arithmetic against
    hand-computed values, and main(["--check"]) returning non-zero on a
    violating synthetic record set and zero on a satisfying one.
    Synthetic records live in a temporary directory and the modules' RECORDS
    (and related) attributes are patched, so no tool code, committed record or
    spec row changes, and no ngspice or PDK is needed.
    Part of #357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
    [test_array_sizing.py, test_jitter_energy_law.py, test_sampler_bit_bias_variants.py, test_starved_cell_jitter_energy.py]
2026-10-09 Guard the check:spec gate count and name list restated in prose
    package.json's check:spec script is the inventory of spec-arithmetic
    gates, but README.md, ci.yml and the package.json description each
    restated its count (11, 11, 13) while the script chains 15.
    corpus_counts.py --check now derives the gate names from the script and
    fails if the README count or name list, the ci.yml count or header list,
    or a count in the package.json description disagrees. No gate is added:
    the guard rides on corpus_counts.py's existing entry. Fix the drift and
    cut the package.json description to a pointer at ci.yml.
    Loom-Story: 2AMLogic/gf180-trng#36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
    [test_corpus_counts.py]
2026-10-09 Fail closed when --changed record discovery cannot run git diff
    verify_record_checksums.py --changed ignored a nonzero git exit, so an
    unknown base, a base missing from a shallow clone, or unrelated histories
    produced an empty record list and a false 'no records to check' success.
    Raise ChangedDiscoveryError naming the base, exit code and git stderr; the
    CLI prints a FAIL line to stderr and returns 2. A valid empty diff still
    returns 0. Adds regression tests using temp git repos.
    Loom-Story: 2AMLogic/gf180-trng#362
    Loom-Trace-Id: 52408650951f64bae5c93dc5c150e47b
    Loom-Build: 0.19.950 72047016af9d66c08f900bb94c642a66dfd75fc5 clean
    [test_report.py]
2026-10-09 Add fail-path unit tests for the coupling and tap-phase --check gates
    array_coupling_variants, liveness_tap_phase_variants and
    array_liveness_tap_phase_variants guard recorded characterization
    conclusions in `npm run check:spec`, but nothing showed their --check
    paths fail when they should.
    Each new test module checks the classifiers against hand-computed ratios
    with every threshold at, just below and just above its boundary, and
    drives main(["--check"]) over synthetic variants: matching verdicts
    return 0, conflicting ones 1, an unset recorded verdict 2. Both verdicts
    of each tap-phase gate are exercised independently, and the array gate
    returns 1 when a recorded conclusion loses its suppor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
    [test_array_coupling_variants.py, test_array_liveness_tap_phase_variants.py, test_liveness_tap_phase_variants.py]
2026-10-09 Reject malformed raw provenance instead of accepting a parsed prefix
    parse_raw_section() now reads only the initial frontmatter block and raises
    RawSectionError on unterminated frontmatter, duplicate raw/path/files
    declarations, unknown lines inside raw:, and malformed file entries. The
    verification path reports these as normal per-record failures. Adds negative
    unit tests and a CLI-level test; the committed corpus (977 records) still passes.
    Loom-Story: 2AMLogic/gf180-trng#369
    Loom-Trace-Id: e4411401f3d2c0e0fe504ab007deead3
    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
    [test_report.py]
2026-10-09 pdk-nightly: provision gf180mcu_fd_sc_mcu7t5v0 for the floorplan step
    floorplan.py prices cell areas from the 7t5v0 standard-cell LEF, which the
    nightly did not provision, so the step failed at the LEF lookup before
    running any of its checks. Add the library to PDK_LIBRARIES and update the
    explanatory comment.
    Loom-Story: 2AMLogic/gf180-trng#310
    Loom-Trace-Id: ccef3105ed06670583fcd61ce7f7ff65
    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
2026-10-09 Unit-test gen_sdf's SDF filter and raise SdfError on malformed input
    Add an openroad-free test module covering _tokenize/_parse/_serialize round
    trips and filter_sdf stats semantics with inline synthetic fixtures. _parse
    now raises SdfError (not AssertionError/IndexError) on truncated or
    unbalanced input; filter output is unchanged.
    Loom-Story: 2AMLogic/gf180-trng#373
    Loom-Trace-Id: 09e7dd4c154fda180cb06fe278738bea
    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
    [gen_sdf.py]
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2026-10-09 Fix record indices in GDSII round-trip test
    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
2026-10-09 test: add direct unit tests for the shared layout engine _mos_row
    Cover _pad_half, _place_row, _terminal, _route_nets and build_cell with
    hand-calculated geometry expectations (stdlib unittest; no KLayout, klt
    or PDK needed). Includes missing declared pins, singleton and internal
    nets, empty terminal maps, mixed and NMOS-only cells, and determinism.
    Loom-Story: 2AMLogic/gf180-trng#378
    Loom-Trace-Id: 17a1f47ea5dd5b93d58463b5715628b2
    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
2026-10-09 test: unit-test the digital place-and-route DEF/GDS checks in build.py
    Adds a pass case and a fail case for each pure check that gates the
    committed digital reports: DEF section/special-net parsing, power
    isolation, GDS extent vs DEF die area, netlist instance count and
    component-count agreement, including a DEF with no COMPONENTS section.
    Uses synthetic DEF text and the repo's GDSII writer; no openroad, klt or PDK.
    Loom-Story: 2AMLogic/gf180-trng#383
    Loom-Trace-Id: 6a810915c5522cf89300ca2248400273
    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
2026-10-09 test: unit-test combiner_sampler and ro_ring11 row/wiring geometry helpers
    Cover row_offsets, row_bbox_um, _net_terminals and _wiring_shapes for the
    combiner_sampler block and row_offsets/_wiring_shapes for ro_ring11 with
    stdlib unittest, no klt or PDK needed. Changing the ROW_GAP_UM arithmetic or a
    wiring shape now fails a unit test instead of only the nightly GDS-hash check.
    Also cross-checks that the two row_offsets implementations agree.
    Loom-Story: 2AMLogic/gf180-trng#392
    Loom-Trace-Id: ec7a3eb2fc93c2a7bcdfa9b744c89bc0
    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
2026-10-09 test: unit-test worst_corner_entropy.py's --check gate and arithmetic helpers
    Hand-computed checks for _binom_tail, _norm_cdf, _cv, grid_coverage and
    report_family_agreement, plus gate-must-fail tests on a synthetic record
    set: --check returns 0 when consistent and non-zero for a missing grid
    corner, family disagreement beyond FAMILY_AGREEMENT_TOL, and a minimum-Q
    corner other than MEASURED_MIN_Q_CORNER.
    Closes #396
    Loom-Story: 2AMLogic/gf180-trng#396
    Loom-Trace-Id: 6555c849b2be38b750449f513f8cdf16
    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
    [test_worst_corner_entropy.py]
2026-10-09 test: unit-test layout/pex/build.py's port-resolution and tap helpers
    layout/pex/build.py decides which extracted pin becomes which named
    port of the routed and noise-tapped decks. A mistake there does not
    crash; it silently simulates a different circuit. Add direct,
    stdlib-only tests (synthetic payloads and netlist text, no klt or PDK)
    for the helpers that had none:
    - _match_positional: unique match by label position, disambiguation of
    same-named nets, FlowError on zero or two matches, and the
    _POS_TOL_UM boundary.
    - _tap_positions: a 15-pin ring yields 11 positions with en/vddr/vss/
    vsubs skipped and ro kept; 14 or 16 pins raise.
    - _gate_nodes: gate field of each nfet_03v3/pfet_03v3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
2026-10-09 ci: run the committed SDF regeneration guard in the PDK nightly workflow
    Adds a reachability probe (native openroad or the digest-pinned container,
    and that the provisioned liberty/LEF files are visible to it) followed by
    npm run check:digital-sdf. The comparison semantics of gen_sdf.py are
    unchanged; missing tools fail rather than skip. Documents the guard and its
    prerequisites in README.md and layout/digital/README.md.
    Loom-Story: 2AMLogic/gf180-trng#374
    Loom-Trace-Id: 12fbf47bb9d12b8a9f580bd0eeed171c
    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
2026-10-09 test: unit-test corner_sanity_check's pass/fail logic without ngspice
    Extract the ss<tt<ff ordering and MIN_SPREAD_PCT spread decision into a pure
    evaluate() function (same thresholds and messages; a non-positive tt now fails
    cleanly instead of raising ZeroDivisionError) and cover it with stdlib tests.
    Loom-Story: 2AMLogic/gf180-trng#377
    Loom-Trace-Id: 53d7607a28f3d87edad154d098243929
    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
    [test_corner_sanity_check.py]
2026-10-09 ci: run jitter-estimator calibration and statistical-battery self-checks in check:spec
    Both tools already expose a stdlib-only --check but were not chained by
    npm run check:spec, so CI never ran them. Add them to the script, update
    the gate count (fifteen to seventeen) in README.md and the ci.yml
    inventory, and describe each in the CI inventory comment.
    Loom-Story: 2AMLogic/gf180-trng#400
    Loom-Trace-Id: aea13233254cb4a9b24875736834f13b
    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
2026-10-09 test(signoff): pin compare_record, _print_item_diff and resolve_artifact
    Cover the verdict-of-record comparison: missing record fails with the
    regenerate command, equal report passes, differing report fails with both
    build versions and the pin, item diff output, and artifact resolution order.
    Loom-Story: 2AMLogic/gf180-trng#391
    Loom-Trace-Id: 94ad7a4030d7ef37b9a3c9f2fa9419d6
    Loom-Build: 0.19.972 113c7f31d7d16f75d30c470023e0b65b29b1fe94 clean
    [test_signoff_record_compare.py]
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2026-10-09 fix(lvs): attach SPICE continuation past comments; raise LvsFlowError for unnamed bits
    _join_spice_continuations now attaches a '+' line to the last non-comment
    line. A leading '+' with no prior card is passed through unchanged (documented
    and tested). _bit_names' docstring no longer promises a net<id> fallback;
    _cell_instances raises LvsFlowError naming instance, port and bit instead of a
    bare KeyError. Removes both expectedFailure markers and adds edge-case tests.
    Closes #387
    Loom-Story: 2AMLogic/gf180-trng#387
    Loom-Trace-Id: 775222ea18ce0e47433a48d52b964031
    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
    [lvs.py]
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2026-10-09 sim: record sampler-array-digitize at ss/+125C/3.63V; estimator --check covers it (#406)
    Single-corner run, seeds 1001..1003. All ten bits read 1 at every seed; no
    entropy figure is claimed and the spec row is unchanged. README 'Still owed'
    resolved; characterization document updated.
    Loom-Story: 2AMLogic/gf180-trng#406
    Loom-Trace-Id: 471cb4a4173b8262f9588776558f661a
    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
    [test_raw_min_entropy_estimate.py]
2026-10-09 docs: update evidence-record count to 978; tighten #406 characterization wording
    README quoted 977 evidence records; the new ss/+125C/3.63V record makes
    the derived count 978, which sim/tools/corpus_counts.py --check enforces.
    In the raw min-entropy characterization, describe the all-ones result as
    consistent with, not evidence of, insufficient accumulated phase noise,
    since a fixed pattern cannot separate that from sampler bias. Note that
    the record's generated ones_count caveat ("bits are not all identical")
    is inverted for this result, and that its "failed to converge" no-data
    label here means the period measure fell outside the simulated interval.
    The record itself is append-only and is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
2026-10-09 fix(floorplan): route digital's top-edge pins around the block's east flank (#315)
    The inter-region stubs for digital's clk, rst_n, raw_bit, raw_valid and
    ring_bit[*] pins were drawn at the block's bottom edge and ignored the
    pin's DEF y. After the re-place-and-route those pins sit on the top edge,
    so the stubs missed them and the composed stream carried a separate
    digital-side net for each.
    Read the pin's edge from the placed data. Bottom-edge pins keep the
    existing stub. Top-edge pins leave the pin on Metal4, run east on a
    per-endpoint Metal5 track above the guard ring, and come down the free
    east flank on a per-endpoint Metal3 riser to the usual trunk. Any other
    placement is rejected. Ad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
2026-10-09 fix(sim): take vss_trunk_ir_drop's digital bbox from the DEF, not the stale area report
    wiring_plan() now rejects a digital pin that is on neither block edge. The
    committed area.json still records a pre-regeneration digital bbox, so
    resistance_model() hit that check. Use the DEF die bbox for digital; it is
    scoped out of the vss chain, so the result is unchanged.
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2026-10-09 floorplan: count DEF-named carriers in check_interregion; record endpoint membership (#315)
    `run_extract_composed` passes `--def-net-names`, which names a net that
    contains digital's DEF-annotated routing by its DEF net name and drops the
    text labels. The joined ring_bit1/ring_bit2 nets therefore come back as
    ring_bit[0]/ring_bit[1], and check_interregion's trunk-label count read
    them as carried by zero extracted nets (two failures of the flow under
    klt 0.6.0). It also passed a disconnected digital endpoint: with
    ring_bit[1]'s Metal4 stub deleted, the extraction reports ring_bit[1] and
    q|ring_bit2, so exactly one net carries ring_bit2.
    interregion.route_net_labels() now returns the trunk la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
2026-10-09 Add a combiner/sampler schematic-vs-extracted klt pex fixture (#418)
    New testbench sim/tb/combiner-sampler-pex/ for the assembled
    combiner_sampler block (two ring-output buffers, XOR combiner, four
    sampling flip-flops), following the ring1 pex pattern (#326):
    - build_dut.py renders a schematic DUT from design/ro_array_core.spice
    (xb1/xb2/xa1, ro_buf, xor2) and design/sampler_core.spice (xsb/xsv/
    xsr1/xsr2, sampler_dff) under the extraction's 14-port header. Each
    extracted port is resolved by joint colour refinement over the
    MOSFET/net graphs of both netlists; a class holding more than one net
    is refused as ambiguous, a class-count mismatch is refused as a
    different circuit, and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
    [test_combiner_sampler_pex.py]
2026-10-09 Document the combiner/sampler pex fixture and its unrun grid (#418)
    sim/tb/combiner-sampler-pex/README.md gives the cold-start commands,
    prerequisites, the extraction-to-schematic port table and how each port
    is resolved, the scenario table with explicit settling windows, the
    two-sided verdict, and the coverage exclusions (rings, randomness,
    boundary timing, floating PMOS wells, loads, full chip).
    signoff/README.md gains "Combiner/sampler post-layout coverage". It says
    this is uncited coverage beside ring1's 7.analog citation, which is
    unchanged. It also records the status: two batch submissions of the
    27-corner grid failed with the fleet's capacity refusal, so nothing is
    published. The gri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
2026-10-09 sim: opt-in supply-ripple susceptibility campaign for the buffered RO array (#414)
    Adds a declared, schematic-level, deterministic supply-ripple experiment on
    design/ro_array_core.spice: an ideal series sinusoid on one ring supply pin or
    both, at the nominal and the entropy-binding corners, with zero-amplitude
    controls, a low and a ring-frequency-difference ripple frequency, and
    solver-step convergence re-runs. Includes the request generator and check,
    edge-time tone extraction and sensitivity table (stdlib only), offline tests on
    synthetic signals, and a summary of what is and is not bounded.
    The simulations were not run: the batch fleet runner (klt 0.5.0) rejects the
    0.7.0 client. No sens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
    [test_supply_ripple.py]
2026-10-09 Mark the fleet-runner klt 0.5.0 mention as a historical pin (#414)
    sim/characterization-array-supply-ripple.md:55 names klayout-tools==0.5.0,
    the version on the batch fleet runner image at the time the submit was
    rejected. It narrates that failure and is not an install instruction, so it
    carries the `klt-pin: historical` marker that sim/tools/klt_pin_sites.py
    recognises. This fixes the klt-pin consistency test in the harness CI jobs.
    Loom-Story: 2AMLogic/gf180-trng#414
    Loom-Trace-Id: 5fbe4c448e4a1d008d6cd60aa25d9012
    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
2026-10-09 Extend the native ring pex comparison to ring2 as an unrun, uncited fixture (#423)
    Select ring1 or ring2 in build_dut.py, publish_item7_analog.py and
    signoff/check.py. The ring2 DUT is derived from the xr2 sizing and ring2's
    own extracted port order; ring1's DUT, source identity and 7.analog citation
    are unchanged. Offline tests reject ring1 substitution, ambiguous ports and
    stale sources. The 27-corner batch submission was refused for fleet
    capacity, so no ring2 result is committed; reproduction commands are in the
    fixture README.
    Loom-Story: 2AMLogic/gf180-trng#423
    Loom-Trace-Id: 405aad7c23b70b4aa78e89ec4ab3011b
    Loom-Build: 0.19.97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
    [test_ring2_pex.py]
2026-10-09 Exclude superseded evidence from current analog rollups (#425)
    Add a shared frontmatter lifecycle reader (parse_status) that rejects
    missing, empty or unknown status values with a named-record diagnostic,
    and make power_rollup, time_to_first_valid, array_sizing (and through
    them the other consumers of their loaders) drop status: superseded
    records before corner selection. include_superseded=True keeps an
    explicit historical read; older status: valid records remain available.
    Regression tests use temporary fixtures; the committed rollup outputs are
    byte-identical before and after.
    Loom-Story: 2AMLogic/gf180-trng#425
    Loom-Trace-Id: 8eb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
    [test_array_sizing.py]
2026-10-09 Filter superseded records in the bitstream and starved-cell loaders (#425)
    raw_min_entropy_estimate.load_records and starved_cell_jitter_energy
    (load_points' jitter and per-corner noise maps, and the plain-cell
    seed-spread reference) globbed sim/records directly and ignored the
    frontmatter lifecycle, so a superseded record could contribute to a
    per-corner entropy figure or win a corner's noise density. Both now read
    status via _record_parsing.parse_status, drop superseded records by
    default, and take include_superseded=True for an explicit historical
    read. Temp-file tests cover both loaders. Output on the committed
    records is unchanged.
    The starved-cell Record parses status lazily, so the v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
    [test_starved_cell_jitter_energy.py]
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2026-10-09 Test verify_record_checksums.py's committed-to-git check (#430)
    The checksum half of sim/tools/verify_record_checksums.py was covered
    through harness.report, but the git-aware half was not: nothing exercised
    verify_one() with a tracked set, and main()'s exit paths were untested.
    Add sim/tests/test_verify_record_checksums.py, which builds a real git
    repository in a temporary directory (skipped if git is absent) and points
    the tool's REPO_ROOT / SIM_DIR / RECORDS_DIR at it, so no test touches the
    real records corpus. It covers: all raw files committed, an untracked raw
    file reported as "not committed", a staged-but-uncommitted file counting as
    tracked, absolute paths not satisfying the repo-r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
    [test_verify_record_checksums.py]
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2026-10-09 Check current T1 status text against the committed verdict (#434)
    README.md stated 3 of 22 T1 items met while the verdict of record reads
    8 of 22. signoff/check.py now compares fenced current-status blocks in
    README.md and signoff/README.md with the committed report's tier, met
    count and item count, failing on mismatch or a missing/malformed block.
    The analog item-8 generic envelope no longer claims item 7 lacks native
    evidence; ring1-only and body-bias limits are retained.
    Loom-Story: 2AMLogic/gf180-trng#434
    Loom-Trace-Id: 2858fe48806e66afa5dd8f833e975391
    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
    [test_signoff_current_status.py]
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2026-10-10 Refresh Chipalooza current-evidence table and Row C reproduction corners (#436)
    Add the measured entropy-binding corner (ss/+125C/3.63V) to the Row C
    characterize campaign, update the README campaign totals (153 points),
    refresh proposal rows C/D/E/G/I to the current rollup and record-family
    figures with superseded values labelled by build, and add an offline
    consistency test that fails on a stale quoted figure or a missing corner.
    Loom-Story: 2AMLogic/gf180-trng#436
    Loom-Trace-Id: cbf26c4f3b3434e9f1c54a32c5fe96c8
    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
    [test_characterize.py, test_chipalooza_table_consistency.py]
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2026-10-10 Reject ambiguous and body-sourced PVT/lifecycle record metadata
    parse_corner and parse_status now read only the leading frontmatter block,
    require exactly one process/temperature/voltage/status field there, parse
    temperature and voltage as complete finite scalars, and raise the caller's
    error class naming the record and field. Generic field(), parse_values()
    and format_corner() are unchanged; no committed record is modified.
    Test fixtures that placed the corner in the body now use frontmatter.
    Loom-Story: 2AMLogic/gf180-trng#443
    Loom-Trace-Id: a18e80ad2930672538fb1216125ef102
    Loom-Build: 0.19.996 0d2be7e9ae05753e2c9232a83b7399d45de53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
    [test_array_sizing.py, test_jitter_energy_law.py, test_record_parsing.py, test_starved_cell_jitter_energy.py]
2026-10-10 Move sampler bit-bias test fixture metadata into frontmatter
    The stricter record parser reads corner and status only from the leading
    frontmatter block. The synthetic records in
    test_sampler_bit_bias_variants.py still put `corner:` in the body with no
    frontmatter, so all 27 tests in that file failed with "no complete leading
    frontmatter block". Write status, raw path and corner inside a leading
    `---` block, matching the committed records and the other migrated
    fixtures. The production parser is unchanged.
    Full `python3 -m pytest sim/tests`: 1071 passed, 5 skipped.
    Loom-Trace-Id: a18e80ad2930672538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
    [test_sampler_bit_bias_variants.py]
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2026-10-10 Measure digital well/substrate tap distances against GF180MCU DRM 14.3.1
    Add layout/digital/tap_distance.py, an input-pinned check of the
    committed trng_top.gds against the core latch-up tap-spacing rules
    LU.3/LU.4 (Euclidean boundary-to-nearest-tap distance, Nwell taps
    restricted to their own well island, taps counted only when wired to the
    required rail). The rule source, limits and exclusions are documented in
    tap-distance-spec.json and the digital README.
    reports/tap-distance.json records the stream and spec SHA-256, limits,
    worst distances/locations, per-well coverage and an explicit status per
    rule; unsupported rules are reported as unsupported, never as pass.
    Fixtures cover a complia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
    [tap_distance.py]
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2026-10-10 Record second batch attempt for the combiner/sampler PEX grid (capacity refusals, nothing published)
    Four batch submissions with the pinned producer all ended in the fleet's
    capacity refusal or an all-error envelope; no complete two-sided response
    exists, so no evidence is published and no row counts as a pass.
    Part of #418
    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
2026-10-10 Add opt-in per-net switching-activity power flow over the post-route netlist (#453)
    Seeded workload campaign (conditioned, raw, backpressure, alarm-gated,
    disabled-with-running-clock; reset/start-up/steady windows), VCD capture
    and validation (empty trace, wrong scope, mismatched netlist, dead clock,
    annotation coverage), and run_sta.py --activity feeding the traces to
    OpenSTA over the existing 15-point matrix. Default uniform flow unchanged.
    Loom-Story: 2AMLogic/gf180-trng#453
    Loom-Trace-Id: d882dbd214947427c5d02ba0abc53f7a
    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
    [activity.py, activity_power.py, activity_tb.v, run_sta.py, test_activity.py]
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2026-10-10 sim/tests: pin the six digital-facing trunk estimates to the regenerated geometry (#256)
    The #256 regeneration of layout/floorplan/reports/interregion.json moved
    the six digital-facing trunks. The depth-2 trng_top.def places those
    pins on the block's top edge, and #315's routing lands their trunks on
    the east flank, so each trunk is longer. The arithmetic test read that
    file but pinned DR-0025's depth-8 table, which is why it failed
    (raw_bit 35.78 fF vs 30.8 fF).
    DR-0027 records the re-derived C/R table. It leaves DR-0025's table and
    decision as written, because the ro1/ro2 PEX scope is unaffected. It
    also discloses that the #315 stub/track/riser legs (about 543-637 um per
    net) are outside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
    [test_run_sta_interface_load.py]
2026-10-10 Run tap-distance report freshness in check:ci and the nightly layout job (#458)
    Add check:digital-tap-distance to check:ci and the PR workflow (explicit
    self-skip when the klayout module is absent), and a mandatory
    --check --require-tools step, under if: always(), to the provisioned
    nightly job. Document coverage; add stdlib wiring and --check semantics
    tests. Read-only; no reports, GDS, spec or rule limits touched.
    Loom-Story: 2AMLogic/gf180-trng#458
    Loom-Trace-Id: cfc2c8435057748ad42135d56cf2c84a
    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
2026-10-10 Enforce activity capture-source freshness and full campaign coverage (#457)
    Reject manifests and records whose capture testbench blob or regenerated
    workload semantics (stimulus, cycles, clock period, seeds, windows) no longer
    match the tree, and require every record to cover the declared workload set.
    Loom-Story: 2AMLogic/gf180-trng#457
    Loom-Trace-Id: 0110cc9f8f0bc4963a8b7051af4e7f62
    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
    [activity.py, test_activity_power_characterization.py]
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2026-10-10 Skip superseded records in the remaining direct-glob readers
    Issue #425 made the main rollup loaders drop records whose frontmatter
    says `status: superseded`. Six readers in sim/tools/ still globbed
    sim/records/ themselves and either ignored the lifecycle or checked it
    with an ad-hoc regex. Each now reads it with `parse_status` (frontmatter
    only; a missing, duplicated or unknown value raises an error naming the
    record) and drops superseded records before choosing one:
    - worst_corner_entropy.py: `report_mc_ro_freq` no longer lists
    superseded MC-frequency records, and the sampler MC-offset reader
    replaces its body-wide `status: superseded` regex with `parse_status`.
    - jitter_estimator_cal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
    [test_array_liveness_tap_phase_variants.py, test_jitter_estimator_calibration_check.py, test_sampler_bit_bias_variants.py, test_starved_cell_jitter_energy.py]
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2026-10-10 feat(spec): fail bare citations of colliding DR numbers; disambiguate existing ones (#468)
    Two decision records each share the numbers DR-0011 and DR-0012, so bare
    citations are ambiguous. corpus_counts.py --check (already in check:spec and
    CI) now derives colliding ids from the directory listing and fails on a bare
    citation in any markdown file outside the records and sim/records/. Existing
    citations are rewritten to DR-0011-meta/-rate and DR-0012-clock/-noise, with
    README labels renamed to match; record files are not renamed. TEMPLATE.md
    documents the max+1 allocation rule.
    Loom-Story: 2AMLogic/gf180-trng#468
    Loom-Trace-Id: b622c5d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
    [test_corpus_counts.py]
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2026-10-10 docs: DR-0029 source reconciliation and disposition of the LU.3/LU.4 tie-distance column (#449)
    Reproduces the committed-stream measurement (report current, physical
    verdict fail), records the evidence gap (no controlled DRM available),
    and stages the placement remedy and refresh inventory as follow-up work.
    Loom-Story: 2AMLogic/gf180-trng#449
    Loom-Trace-Id: f6a56246a14c2ced34a3222495abde3f
    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
2026-10-10 sim: reconcile shipped liveness samplers (xsr1/xsr2) with the whole-block active-power ledger (#463)
    Inventory every sampler_core instance against a required ledger term and make
    power_rollup --check reject an unmapped or doubly-counted instance. Add the
    sampler-core-liveness-active deck, request generator, derivation and record
    writer, with an in-run control array for the taps' loading of the buffered
    rings. --with-taps no longer adds the historical liveness constant, which was
    measured on the unbuffered array at a different rate.
    Measured: tt/27C/3.30V only (local single-point probe), +25.3 uW. The batch
    submit for the 27-point grid was rejected by a runner/client klt version
    mismatch, so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
    [test_liveness_sampler_power.py]
2026-10-10 sim: quantify DC drop through the digital supply docking path and PDN (#464)
    Add a geometry-derived DC resistor-network analysis of vddd and vss from
    the chip pins into the placed digital section. The external feed (Metal4
    trunk, Metal3 riser, single Via3/Via4 cuts, Metal5 dock) is read from
    interregion.wiring_plan() over the committed floorplan reports. The
    internal grid (Metal5/Metal4 straps, Metal1 follow-pin rails, per-cut via
    arrays) is read from trng_top.def SPECIALNETS. Both are solved together
    by a new stdlib sparse nodal solver.
    - Resistances come from the gf180mcu magic tech file's nominal and
    high-R variants, with an assumed TCR above 25 C. Currents come from
    the current-DEF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
    [test_digital_supply_ir_drop.py, test_resistor_network.py]
2026-10-10 spec: ratify DR-0010, DR-0011, DR-0015, DR-0016 and DR-0018 via the two-key mechanism
    Carries five Proposed decision records to Accepted, following the shape of
    the #213 batch: status and deciders text, a dated Status entry, and the
    README evidence commentary that called them Proposed. No target-spec row
    value is edited and the raw min-entropy row is untouched.
    DR-0010 and DR-0011-raw-rate-at-the-measured-starved-cell-jitter-energy are
    ratified as a pair; DR-0010 is recorded as superseded in part (its section 1
    rate value only). The Raw rate row edit and the other mechanical edits those
    records direct are not made here because they change a ratified row value.
    Excluded: DR-0017 (no option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
2026-10-10 docs: refresh Chipalooza Row I area from the regenerated floorplan report (#484)
    Row I now quotes the regenerated depth-2 floorplan rollup (175,789.9 um^2
    including isolation channels, 351.6% of the 0.05 mm^2 budget) with the row
    bounding box reported separately; the inventory estimate and the depth-8
    composed figure are labelled historical. The root README's area commentary
    is reconciled. The consistency test now reads layout/floorplan/reports/area.json
    and fails if the quoted area or budget percentage is changed.
    Loom-Story: 2AMLogic/gf180-trng#484
    Loom-Trace-Id: 24137d953c5258895cee0f4492b590b8
    Loom-Build: 0.19.1009 8889f7bd1eccfb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
    [test_chipalooza_table_consistency.py]
2026-10-10 docs(signoff): combiner/sampler PEX grid attempt 4, all rows errored (partial #418)
    The batch submission returned klt pex exit 4 with 1782 errored rows and no
    measurements; nothing was published and the grid was not run locally.
    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
2026-10-10 docs: move the spec-row change history out of the README table (#481)
    The Target specification table in README.md carried each row's dated
    measurement history inside its cells (the Power cell alone was about
    2,000 characters), followed by the "Ratified, with four rows explicitly
    unmeasured" note repeating the same chain as nested bullets. The table
    that is meant to be the contract was the hardest part of the file to read.
    The table now carries target, stretch and a one-line Status column
    (met / missed / unmeasured / derived from target / specified), each
    linking to a new docs/spec-row-status.md. That document holds, one
    section per row, the row text and the ratification-note bullets exactly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
2026-10-10 fix(sim): fail runs on nonzero ngspice exit or fatal diagnostics (#498)
    run_one() previously reported ok whenever every measurement parsed. It now
    also requires exit code 0 and no line starting with a fatal marker (Error,
    Fatal, doAnalyses:); ordinary warnings are still accepted. Failed results
    keep parsed measurements and the raw log, and the message carries the exit
    code and first diagnostic. Timeout classification is unchanged.
    Loom-Story: 2AMLogic/gf180-trng#498
    Loom-Trace-Id: 36795ccdd2fbb66267fc11aa7a6c5d96
    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
    [test_cli.py, test_runner.py]
2026-10-10 fix(sim): give each --no-write invocation its own scratch directory (#499)
    Concurrent --no-write runs of the same testbench and point shared
    sim/.work/<tb>/<corner> and the first rmtree'd it. Each invocation now
    creates a unique run directory via tempfile.mkdtemp, never deletes
    scratch output, and prints where it is. Evidence reservation is unchanged.
    Loom-Story: 2AMLogic/gf180-trng#499
    Loom-Trace-Id: f0f1613f07e5c64d055df431795aa99a
    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
    [test_cli.py]
2026-10-10 fix(sim): treat non-fatal .meas errors as non-fatal in diagnostic policy (#498)
    ngspice prints 'Error: measure X when(WHEN) : out of interval' and
    'Error: RHS "..." invalid' for unreachable .meas crossings while still
    exiting 0 with the other measurements intact. Exclude those two shapes
    from the fatal-diagnostic regex and add a regression test.
    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
    [test_runner.py]
2026-10-10 test(sim): guard that every --check sim tool is wired or allowlisted (#474)
    Add test_check_mode_wiring: enumerate sim/tools/*.py, detect scripts that
    define a --check argument, and require each to be run by a check:* script in
    package.json or listed in an in-test allowlist with a reason. Also fails on
    stale allowlist entries and on ci.yml referencing a missing npm script.
    Loom-Story: 2AMLogic/gf180-trng#474
    Loom-Trace-Id: cdaa871ad07b237e5a4c3df7a342e8e5
    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
    [test_check_mode_wiring.py]
2026-10-10 test(sim): correct UNWIRED_ALLOWLIST reasons in check-mode wiring guard (#474)
    raw_min_entropy_estimate.py derives from committed sim/records and needs
    neither ngspice nor the PDK; its --check is run by test_check_flag_passes,
    which skips when the sampler-array-digitize records are absent.
    For fs_sf_capture.py, supply_ripple.py and liveness_sampler_power.py, only
    the `run` subcommand needs ngspice/PDK; `emit --check` is offline and is
    exercised by the named unit tests.
    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
    [test_check_mode_wiring.py]
2026-10-10 docs(signoff): log fifth combiner/sampler batch attempt (#418)
    The 27-corner grid again returned an all-error native response through the
    batch backend; nothing was published and no local fallback was used.
    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
2026-10-10 sim: record blocked ring2 paired PEX batch attempt (#476)
    Ran the 27-corner ring2 schematic-vs-extracted campaign once through
    signoff/publish_item7_analog.py --ring ring2 --backend batch under the
    klt 0.6.0 producer pin, after validating the fixture (build_dut
    --check-source / --check, signoff/check.py).
    The fleet ran both jobs (klt-sim-dc936de81e20 schematic,
    klt-sim-4ccd9e4d8532 extracted) but all 54 grid units errored
    unmeasured: the 0.6.0 batch client uploads only the testbench body and
    request, not the .include'd DUT, and the fleet runner is klt 0.5.0.
    Nothing was published; no reduced grid or --allow-incomplete run.
    Adds the append-only attempt record with the native errored envelop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
2026-10-10 sim: keep failed-run measurements out of report summaries (#506)
    Only status-ok runs feed the per-measurement means and spreads. Values a
    failed run retained are listed under an explicit failed-run diagnostics
    heading with the failure reason, and the Result section reports attempted
    vs. successful run counts. Existing mean/over-N-seeds line formats are
    unchanged; historical records are untouched.
    Loom-Story: 2AMLogic/gf180-trng#506
    Loom-Trace-Id: 83baa0dab294c40f58dcc1e9cd755731
    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
    [test_report.py]
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2026-10-10 sim: snapshot the loaded testbench manifest with each run record (#510)
    Records pinned the SPICE fragment but not tb.json, which defines
    measurements, options, params and caveats. The bytes read at load time are
    now copied to raw/<stem>/tb.manifest.json, listed in raw.files, and
    referenced by an additive manifest: frontmatter block. Loading fails if the
    manifest changes mid-load; verification checks the snapshot digest against
    raw.files. Legacy records are unchanged and still verify.
    Loom-Story: 2AMLogic/gf180-trng#510
    Loom-Trace-Id: 521a097e3fe75dc301dbd6083d53edcf
    Loom-Build: 0.19.1009 8889f7bd1eccfb4bc8239e7f5669b65f9815c30e clean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
    [test_report.py]
2026-10-10 sim: reject duplicate seeds and colliding PVT plans before allocation (#511)
    run_corners.py now validates the complete execution plan before it
    reserves a record stem, creates a scratch directory or launches ngspice:
    - runner.plan_runs rejects repeated seeds, naming each repeated value.
    A repeated seed would count one realization twice in a record's mean
    and spread. plan_runs is shared by the serial run_point path and the
    CLI's -j task list, so both inherit the rule.
    - corners.validate_grid rejects repeated effective PVT points (e.g.
    --temps 27 27) and distinct points whose corner_id collides (supply is
    formatted to 10 mV and temperature with :g, so 3.301 V and 3.304 V
    alias), n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
    [test_cli.py, test_corners.py, test_runner.py]
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2026-10-10 docs: replace README status changelog with a short summary (#502)
    The README status paragraph restated, as dated prose, facts owned by the
    per-directory READMEs. Replace it with a summary that links to those owners
    and keeps the corpus totals guarded by sim/tools/corpus_counts.py. The removed
    narrative moves unchanged in substance to a dated section of
    docs/spec-row-status.md.
    Loom-Story: 2AMLogic/gf180-trng#502
    Loom-Trace-Id: 94a0f16a3a6ced5da2c75e31c1b46d94
    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
2026-10-10 ci: run nightly no-evidence-write assertion after earlier failures (#522)
    Loom-Story: 2AMLogic/gf180-trng#522
    Loom-Trace-Id: ba1992fcb7920c71a96dd7690f76494c
    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
2026-10-10 sim: reject non-finite ngspice measurements before declaring a run ok
    float() silently overflows an out-of-range exponent such as `1e999` to
    +/-inf instead of raising, so a run whose sole requested measurement
    overflowed could exit 0 with no fatal diagnostic and be classified ok,
    feeding inf into the primary summaries.
    run_one now checks every converted value with math.isfinite. A requested
    measurement that is present but non-finite (overflow, or a literal
    inf/infinity/nan, which the measurement regex now recognizes solely to
    report it) fails the run with "non-finite measurements: <name>
    (<name> = <raw>)", kept separate from "missing measurements" so absent
    and invalid stay distinguishable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
    [test_cli.py, test_report.py, test_runner.py]
2026-10-10 Add stdlib unused-import/local checker to npm run lint (#494)
    sim/tools/unused_names.py reports unused imports (F401) and simple unused
    function-local Assign/AnnAssign targets (F841) using ast + symtable, over
    git-tracked Python under design/, layout/, signoff/ and sim/. Unsupported
    binding forms, dynamic-namespace blocks, __all__ re-exports, __future__,
    __init__.py, underscore names and noqa are skipped per the issue contract.
    Wired into the lint script; the tracked tree is clean, so no fixes or
    baseline are needed.
    Loom-Story: 2AMLogic/gf180-trng#494
    Loom-Trace-Id: 0d6f98c8db9714dce843b875085d268a
    Loom-Build: 0.19.1026 09a449709f5a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
2026-10-10 Reject unknown testbench analysis types at manifest load
    analysis_type decides whether a run is stochastic and therefore needs a
    seed. An unrecognised token (e.g. a misspelt tran-noise) used to load and
    silently plan a seedless deterministic run. Define an explicit supported
    vocabulary (op, tran, tran-noise, noise, ac, dc, mc), keep the stochastic
    set a verified subset, and validate the manifest value at load with an
    error naming the manifest, the offending value and the supported types.
    Document the vocabulary, including the default op, in sim/README.md.
    Loom-Story: 2AMLogic/gf180-trng#534
    Loom-Trace-Id: 8c57df4814b107f15074b8e0e284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
    [test_testbench.py]
2026-10-10 Reject empty and non-finite PVT execution plans before simulation (#532)
    validate_grid now refuses empty grids and non-finite temperatures or
    non-finite / non-positive supplies; supply_points validates the nominal
    supply and tolerance (zero tolerance stays a single-supply request).
    The CLI reports the offending field and value before any record stem is
    reserved or simulator launched. Finite out-of-envelope diagnostics remain
    valid; #511 duplicate and collision checks are unchanged.
    Loom-Story: 2AMLogic/gf180-trng#532
    Loom-Trace-Id: 09de67065eef3af63ad0c87b1eef8cc1
    Loom-Build: 0.19.1026 09a449709f5a1c6ae81b471ef56d466247e50808 clean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
    [test_cli.py, test_corners.py]
2026-10-10 Share the result-bullet grammar and multi-seed summary parser
    The numeric token, the single-value bullet and the 'mean X over N seeds
    (sd Y' shape were re-typed in four report tools. Define NUMBER_PATTERN,
    SEED_SUMMARY_RE and iter_seed_summaries once in _record_parsing.py, build
    VALUE_RE from the token, and switch the tools onto them. A guard test fails
    if another tool module compiles a pattern starting with the bullet prefix.
    Loom-Story: 2AMLogic/gf180-trng#537
    Loom-Trace-Id: c3763ae09cfddc124e5ef0cc47d4a944
    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
    [test_no_private_bullet_grammar.py, test_record_parsing.py]
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2026-10-10 Validate numeric tokens and finiteness when reading evidence bullets (#529)
    Reject incomplete exponents (1e+, 2.5E) and overflow (1e999) in
    parse_values instead of falling back to a mantissa prefix; accept E.
    Callers pass the record stem and their error class so the CLIs exit
    non-zero with record/key context.
    Loom-Story: 2AMLogic/gf180-trng#529
    Loom-Trace-Id: 1ff6d182b0d1b0c1be520c00622fb448
    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
    [test_record_parsing.py, test_time_to_first_valid.py]
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2026-10-11 Pin the OpenROAD image that produced the committed artefacts (#507)
    The wrapper pinned openroad/orfs:26Q3-296-gda37dce1c (sha256:ebc8142d...),
    which reports 26Q3-1260-g06a5a02279. The committed place_and_route.json and
    sdf_export.json record 26Q3-1510-g6cb3f2b704, which is the build in
    openroad/orfs:26Q3-383-g205191eb2 (sha256:bb7f3169...). Without a native
    openroad, the nightly therefore failed gen_sdf.py --check on engine_version.
    Repin the wrapper and the README table to the 1510 image, so the engine_version
    freshness comparison is unchanged and no committed artefact or record changes.
    Loom-Story: 2AMLogic/gf180-trng#507
    Loom-Tra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
2026-10-11 Freeze SPICE inputs per invocation and hash the captured bytes (#515)
    Capture the testbench fragment, DUT netlist and the DUT's sibling includes
    once at load; every corner's deck includes byte-identical snapshots in its
    own directory instead of the live working-tree files. Records hash the
    captured bytes, list the snapshots in raw.files and carry an additive
    inputs: block. Unsupported DUT include forms fail before launch.
    Loom-Story: 2AMLogic/gf180-trng#515
    Loom-Trace-Id: 00c454da478c22c353650380d46c6f62
    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
    [test_report.py, test_runner.py, test_testbench.py]
2026-10-11 Validate multi-seed summary bullets in iter_seed_summaries (#547)
    Mean, sd and seed count are now complete finite tokens (e/E exponent), the
    count is >= 1 and sd >= 0; violations raise the caller's error_cls with the
    record label and key instead of vanishing or reaching float()/int().
    The sd-less legacy shape stays skipped.
    Loom-Story: 2AMLogic/gf180-trng#547
    Loom-Trace-Id: c47d90256f49edb8774ce5af4af5c33e
    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
    [test_record_parsing.py]
2026-10-11 Scope whole-record measurement readers to the primary Result section (#548)
    Add parse_result_values / iter_result_seed_summaries / result_section to
    sim/tools/_record_parsing.py: an incremental line scanner that selects the
    single declared '## Result' section, skips fenced code blocks, other '##'
    sections and the failed-run diagnostics block, rejects duplicate primary
    keys with record/key/line context, and errors on missing or ambiguous
    Result sections (no whole-file fallback). parse_values keeps its snippet
    last-value contract.
    Migrate every whole-record reader (array_sizing, activity_power_
    characterization, jitter_energy_law, jitter_estimator_calibration_check,
    starved_cell_jitter_energy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
2026-10-11 Centralise superseded-record filtering and latest-record selection (#554)
    Add current_records / latest_current_record to sim/tools/_record_parsing.py
    and migrate the readers that open-coded the lifecycle filter and the
    latest-wins rule. Public function names and include_superseded keywords
    are unchanged. A source scan in test_superseded_exclusion.py now fails on
    a direct records-directory glob outside an explicit allowlist.
    Loom-Story: 2AMLogic/gf180-trng#554
    Loom-Trace-Id: 43e5b3b967274956db48d0546d080475
    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
2026-10-11 Publish SPICE records with exclusive creation (#539)
    write_record checked for an existing destination and then called
    path.write_text(), so a record created after the check could be
    truncated, and a failed write could leave a partial Markdown file.
    Route the final write through publish_record_text, which opens with
    exclusive creation, raises RecordExists for any destination present at
    that moment, and removes only the partial file it created itself. The
    early existence check stays so a collision is still reported ahead of a
    raw-file mismatch, and RawFilesMismatch still prevents publication.
    Record formatting is unchanged.
    Tests cover a destination appearing after the early check (sentinel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
    [test_report.py]
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2026-10-11 Bound the default concurrency of sim/characterize.py (#558)
    The campaign driver defaulted to os.cpu_count() ngspice processes. Default
    to a fixed 2, report the value and its source in the run header, and keep
    --jobs N / make JOBS=N as the explicit way to use more cores.
    Loom-Story: 2AMLogic/gf180-trng#558
    Loom-Trace-Id: 7b16ea1f3275c91bd5bf3aaae3de8375
    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
    [test_characterize.py]
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2026-10-11 Reject nonpositive simulation timeout bounds before launching ngspice (#563)
    coreutils timeout(1) treats a zero duration as no timeout, so --timeout 0
    disabled the independent watchdog added for #83. Require a strictly
    positive integer at CLI parsing, re-check in cli.run for hand-built
    namespaces, and validate in runner.run_one/run_point so direct callers
    fail before any file is created or child spawned.
    Loom-Story: 2AMLogic/gf180-trng#563
    Loom-Trace-Id: b5df2480e26956b389ae887fe58ac5dd
    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
    [test_cli.py, test_runner.py]
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2026-10-11 Add a relative markdown link guard to npm run lint (#570)
    Relative links in tracked documents were not validated anywhere, and
    some decision-record citations in an evidence summary were already
    broken. Add sim/tools/verify_markdown_links.py, a stdlib-only checker
    that walks the git-tracked *.md files and fails with `file:line: broken
    link: target` for any relative inline link or reference-style
    definition whose target is not a tracked file or directory. URLs,
    pure anchors, fenced code blocks and inline code spans are ignored;
    anchor validation is out of scope. The append-only sim/records/ tree
    and the installed .loom/, .claude/ and .agents/ surfaces are not
    scanned.
    Wire it into `npm run li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
2026-10-11 Record the outcome of the LU.3/LU.4 controlled-DRM source search (#486)
    DR-0030 amends DR-0029: no numbered controlled GF180MCU DRM revision was
    obtainable from public sources, so the MV-column reading stays an unconfirmed
    working interpretation. The spec, measurement, tests and failing report are
    unchanged. Adds the attempted sources, checksums and the remaining access
    requirement.
    Loom-Story: 2AMLogic/gf180-trng#486
    Loom-Trace-Id: 10db794f15b74b23cca20fbd9f305e4f
    Loom-Build: 0.19.1047 b801ec198a3113b88fa9292ccd75f934ab0c1679 clean
2026-10-11 Reject DUT includes that collide with generated simulation artifacts (#565)
    Validate the planned deck/log names (all seeds and run indices) and the fixed
    snapshot/manifest names against the frozen DUT includes before any record or
    scratch directory is allocated, and in run_one before any write. Deck/log
    naming is now shared between execution and validation. Manifest writers accept
    identical existing bytes and refuse different ones without modifying them.
    Loom-Story: 2AMLogic/gf180-trng#565
    Loom-Trace-Id: c83219d4c7d7d503bcff7dfdd10f5e91
    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
2026-10-11 docs: correct what the Area row's 351.6 % figure is (#495)
    Append a dated entry under Area in docs/spec-row-status.md superseding the
    'no synthesiser, placer or router has run' sentence: the figure is a
    footprint sum read from committed assembled GDS bounding boxes (including the
    placed-and-routed digital block), not an inventory estimate. Tag stays
    missed; target and decision records untouched.
    Loom-Story: 2AMLogic/gf180-trng#495
    Loom-Trace-Id: 36bce276d7782fa2e1ec794cc947b393
    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
2026-10-11 Move the Raw rate row to > 2 kbps and size the array at a = 7.32 (#491)
    Apply the edit set that the accepted DR-0010 and
    DR-0011-raw-rate-at-the-measured-starved-cell-jitter-energy direct and that
    their ratification deliberately left out because it changes a ratified
    target-spec row.
    Sizing tool (sim/tools/array_sizing.py):
    - The stated constant moves from the plain cell's 1.79 to 7.32, the shipped
    starved cell's asymptotic-slope constant at ss/-40 C/3.63 V.
    - --check now re-derives that constant from the committed starved-cell
    records via a new starved_cell_jitter_energy.sizing_constant() helper.
    The helper picks the corner by identity, not by mean, lag 1 or minimum.
    The plain-cell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
2026-10-11 Redact absolute parameterized paths in PDK model manifest diagnostics (#569)
    The unsupported-parameterized-path diagnostic formatted the raw target
    before the absolute-path redaction, so an absolute include path containing
    a parameter marker was persisted in ModelManifest.problems and in record
    caveats. Report such targets as 'an absolute path' while keeping the
    PDK-relative file:line and the unsupported-parameterized wording; the
    manifest stays incomplete. Adds a synthetic regression covering the
    serialized manifest and the generated caveats.
    Loom-Story: 2AMLogic/gf180-trng#569
    Loom-Trace-Id: 1728982acea181c0085c44566b13d24e
    Loom-Bu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
2026-10-11 Migrate sim/tests loaders to load_module_from_path (#553)
    Replace the hand-copied importlib.util.spec_from_file_location blocks in
    eight sim unit tests with the shared helper, so each loaded module is
    registered in sys.modules before execution. Remove exactly those eight
    entries from the pathload_guard allowlist (stale entries fail the guard).
    Test behaviour is otherwise unchanged. layout/tests (13 files) remains.
    Part of #553.
    Loom-Story: 2AMLogic/gf180-trng#553
    Loom-Trace-Id: a253906dd3ae15875672d3f75ef3a9d3
    Loom-Build: 0.19.1055 4737928b703aa8a4c87d04eefbf7299fb933eab4 clean
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2026-10-11 refactor: dedupe the layout generators' gds_path/check/main tail into _build_cli
    Every standalone layout generator carried its own verbatim copy of the
    same CLI tail: check() (rebuild into a scratch stream, byte-compare
    against the committed one) and main() (--check, plus the klt family's
    --require-tools flag and skip-when-absent tool probe). Ten near-identical
    copies meant a fix to the check had to be applied ten times (#589).
    The new layout/cells/_build_cli.py (beside _mos_row.py and _geometry.py)
    factors that tail into four factories: make_check/make_main for the
    stdlib-only hand-drawn cells and make_pdk_check/make_pdk_main for the
    klt/PDK-assembled generators (rings and combiner_sampler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
2026-10-11 Add lint:shell (shellcheck at warning severity) to lint, CI and check:all
    Adds sim/tools/lint_shell.py: runs shellcheck over tracked first-party *.sh
    (vendored .loom/ and .claude/ excluded). Skips with a clear message when
    shellcheck is absent, fails with --require-tools. Wired as its own CI step,
    into check:ci (skip form) and check:all (strict). Removes the unused
    REPO_ROOT assignment in sim/selftest.sh (SC2034).
    Loom-Story: 2AMLogic/gf180-trng#591
    Loom-Trace-Id: 566d3b7a3f85e88e0ee82f95c1b14ef3
    Loom-Build: 0.19.1065 33bb950d65b9038d5cf119a252820edca1192edf clean
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2026-10-11 fix: isolate each hostile-init sanity launch to the startup source it names
    ngspice-46 looks for .spiceinit in the deck's directory first, then the
    working directory, then $HOME -- ngspice-42 never searched the deck's
    directory. The hostile-fixture test left the user-init sanity launch
    running a deck inside the hostile work directory and inferred a user-init
    lookup from the cwd alone, so on ngspice-46 the work-directory sentinel
    fired instead of the user one (issue #584).
    - give the user-init case its own deck copy outside every hostile
    .spiceinit directory, and assert the negation of the other sentinel in
    each sanity launch; the controlled-launch assertions are unchanged
    - record the l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
2026-10-11 feat(harness): refuse tran-noise points whose runs share a process id or measurements (#605)
    Record Popen.pid per run and withhold the record of a multi-seed
    tran-noise point when two runs share a child process id or have
    bit-identical measurements, since trnoise is seeded from the process id
    (DR-0031). Guards duplication only; no independence claim.
    Loom-Story: 2AMLogic/gf180-trng#605
    Loom-Trace-Id: 21a56318740003ef312cdfef893e80f4
    Loom-Build: 0.19.1068 fcc4454e112d13e088464bb0a178b75c0dc96c0f clean
2026-10-11 test: pin the _build_cli.py message contract with direct unit tests
    Exercise make_check, make_pdk_check, make_main, make_pdk_main and gds_file
    through injected fake hooks, asserting return codes and exact printed
    lines for the MISSING/STALE/ok/SKIP-AS-STALE/SKIP/FAIL branches, plus
    scratch-file cleanup in make_check (normal return and raising build).
    Loom-Story: 2AMLogic/gf180-trng#601
    Loom-Trace-Id: 55fc32837e019d3262a12e667ee2ed37
    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
2026-10-11 fix: actually remove convergence_text (missed in prior commit)
    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
2026-10-11 fix: reserve klt output namespace exclusively before submission (#610)
    run_klt_request now claims the response and stderr files with O_EXCL and
    treats any <stem> / <stem>.* backend product as occupied before klt is
    launched. An occupied destination exits 3 with a message asking for a fresh
    output directory and leaves prior files untouched. A klt that cannot start
    exits 127 with the reason kept in the reserved stderr file. Cleanup of
    temporary requests runs on every path, including refusals.
    Loom-Story: 2AMLogic/gf180-trng#610
    Loom-Trace-Id: 9f12c69ef2f3eae5319a014a0edae026
    Loom-Build: 0.19.1068 fcc4454e112d13e088464bb0a178b75c0dc96c0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
2026-10-11 test: cover signoff publishers' refusal paths, --backend argv and publication fields
    Offline unittest for signoff/publish_item7_analog.py and
    signoff/publish_combiner_sampler_pex.py: subprocess.run is mocked and all
    destinations are redirected to a temp dir. Dedupe skipped (not needed).
    Loom-Story: 2AMLogic/gf180-trng#611
    Loom-Trace-Id: 2fb2728908d5dd3625e8c33dde5ac532
    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
2026-10-11 test: require simulator-gated unit tests in the nightly via REQUIRE_RTL_TOOLS
    The RTL/model equivalence classes (iverilog) and two runner probes
    (ngspice) in sim/tests skip when the tool is absent, and neither workflow
    installed Icarus Verilog, so CI never ran the RTL checks.
    - sim/tests/_tool_gate.py: requires_tools(*names, reason=...) behaves like
    unittest.skipUnless by default (same skip, same message); with
    REQUIRE_RTL_TOOLS=1 a missing tool fails, naming each missing tool.
    - Route all eight iverilog/vvp/ngspice gates through it.
    - test_tool_gate.py pins both behaviours with a fake which/environment;
    test_tool_gate_discipline.py fails on any raw which("iverilog"|"vvp"|
    "ngspice"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
2026-10-11 ci: fetch full history in the PDK nightly so origin/main resolves
    A workflow_dispatch run of pdk-nightly.yml on a non-default branch used
    the default shallow checkout, which fetches only that branch. The
    test_report changed-record discovery test diffs origin/main...HEAD, so
    it errored there and failed both `sim/selftest.sh --require-pdk` and
    the unit-test step. Check out with fetch-depth: 0, as ci.yml already
    does for its evidence-history step, so origin/main and a merge-base
    with HEAD are available. The test itself is unchanged.
    Refs #621.
    Loom-Story: 2AMLogic/gf180-trng#618
    Loom-Trace-Id: 3a23ffa91caff3ee4fad10c8c1063bc0
    Loom-Build: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
2026-10-11 test: skip changed-record end-to-end case when origin/main is not fetched
    The case diffs against origin/main, which a shallow single-branch checkout
    or a clone without that remote lacks. Skip with a message in that case; under
    REQUIRE_RTL_TOOLS=1 (the nightly) it still fails, so the strict switch keeps
    its meaning. The nightly already fetches full history.
    Loom-Story: 2AMLogic/gf180-trng#621
    Loom-Trace-Id: b4c23eb681cfa9798221cf0a8ebfc5e3
    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
2026-10-13 Address the 2026-10-13 two-key review conditions (#586)
    - README Scope: reposition the block as a low-rate DRBG seed source, not a
    bulk-rate TRNG, and state the time to a first full DRBG seed parametrically
    (S / 250 s at the delivered rate; 256/384/512-bit examples).
    - README Raw rate row: state the maximum sample clock (~2.77 kHz raw; 2773 bps
    at ss/+125 C/3.63 V, array_sizing.py --check) so an integrator cannot
    over-clock below the entropy bound.
    - README Raw rate stretch and Delivered rate stretch: mark > 4 Mbps raw and
    > 500 kbps delivered unattainable under the measured jitter-energy law
    (docs/spec-row-status.md kept consistent).
    - sim/tools/starved_cell_jitter_energy.py: is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
2026-10-13 sim: starved-cell jitter-energy bench at ss/+125C/3.63V (batch fleet) plus its noise record (#628)
    Adds the first measurement of the starved delay cell's jitter-energy
    slope at the entropy-binding corner of DR-0015: an 8-unit
    ro-ring5-starved-jitter-long record run on the batch fleet through
    klt sim, and a rostage-noise record at the same corner. The batch
    bench computes the family's estimators from fleet-measured edge times
    (sim/tools/starved_hot_corner.py, unit-tested against tb.json) and
    runs to 3.1 us because the ring is slower here than the family's 2.4 us
    window assumes. starved_cell_jitter_energy.py --check passes; the
    asymptotic a at this corner is 8.42.
    Part B (selector and margin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
2026-10-15 sim: record supply-ripple beat and convergence runs (part of #414)
    Four of six requests ran on the batch fleet: nominal-beat, binding-beat and
    the 5 ps / 2.5 ps convergence re-runs. Adds an ingest subcommand to
    supply_ripple.py (refuses incomplete reports; wall_time is the longest unit),
    tests, four append-only records, and the results tables. The two 2 MHz
    requests hit the fleet 3600 s whole-job ceiling and remain pending.
    Loom-Build: 0.19.1162 f1ee755eeca1954f35bf83d19f4b84ad51feb9f5 clean
    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
2026-10-15 sim: carry the ratified 2 kbps rate through rollup tools and docs, mark older rates historical
    power_rollup.py and worst_corner_entropy.py now default to the ratified
    2000 bps (DR-0011-raw-rate-at-the-measured-starved-cell-jitter-energy).
    digital_measured() scales its dynamic term against a new fixed
    DIGITAL_MEASUREMENT_RATE_HZ (1 MHz, the rate the gate-level records were
    measured at) instead of the configurable default, so changing the default
    cannot alter the normalization. array_coupling_buffer_variant.py inherits
    the new default.
    The analog characterization summary labels its 1 Mbps and 500 bps figures
    as historical with explicit --rate reproduction commands, and gains a
    section of rate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
2026-10-15 sim: report the DR-0015 binding-corner jitter constant beside the stated one
    sizing_constant() keeps the ss/-40C asymptotic a (7.32) as the stated
    sizing constant and additionally reports the ss/+125C/3.63V value
    (8.42) with its record stem. A regression test pins that the stated
    constant does not follow the binding corner. No published margin or
    rate ceiling changes.
    Part of #628
    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
2026-10-17 signoff: cite item 11 as a compound evidence set so both partitions grade for real
    11.analog now lists the three region ERC reports plus the combiner/sampler
    LVS envelope; 11.digital lists the ERC report, the digital LVS envelope and
    the place-and-route response. The verdicts of record move from wrong_kind to
    supply_spec_disclosed_unexpressible (analog) and lvs_supply_unproven
    (digital). check.py exempts the place-and-route response, which names no
    resolvable input, from the envelope-vs-input step.
    Closes #655
2026-10-17 signoff: cite hashed inventories for T1 items 1, 2, 9 and 10 on both partitions
    Add signoff/inventories.py, which derives an inventory per item and
    partition (every member file with its sha256, plus the item's named gates
    and where they run), and an artifact-anchored generic envelope per
    inventory for the klayout-tools 0.7.0 grader. signoff/check.py re-derives
    every inventory from the live tree and fails by file name on a changed,
    added or removed member; --write is the only way to re-pin.
    Move the grader to klayout-tools 0.7.0 via a new KLT_GRADER_PIN. KLT_PIN
    stays 0.6.0 as the DR-0026 producer pin, and klt_pin_sites.py gains a
    grader marker so the two are held separately. Re-grading the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
2026-10-17 refactor(signoff): share the klt pex publish pipeline between the ring and combiner/sampler publishers
    Move run_pex, envelope load, the pin/mismatch/missing-netlist refusals, the
    write-validate-restore step and the common publication fields into
    signoff/publish_common.py. The two publishers keep only their fixture data.
    CLI flags, messages, output paths and JSON key order are unchanged; the ring1
    publisher now also reports a failed klt pex run instead of a traceback.
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2026-10-21 chore(digital): trim per-gate antenna tables from the committed ERC report
    The digital ERC supply report carried ~10 MB of per-gate antenna tables
    and an all-skipped antenna coverage block that nothing reads. Apply the
    floorplan report's projection to it (shared project_report, new gates_stub
    option that keeps gates as an empty list, which the klt signoff 0.7.0 grader
    needs to recognize the envelope). The file drops from 10.5 MB to 1.5 KB;
    provenance, status, findings and supply/tie coverage are unchanged, and the
    manifest pin (the GDS hash) does not move.
    Closes #677
2026-10-22 fix(signoff): re-pin item 9/10 inventories after README and ci.yml edits
    The T1 item 9 and 10 hashed inventories cite README.md and
    .github/workflows/ci.yml, both edited since the last pin, so the
    freshness gate failed on main. Re-pinned with signoff/check.py --write
    under the pinned klayout-tools 0.7.0 grader; only hashes moved.
2026-10-23 feat(sim): store raw output of new recorded runs in the artifact store
    run_corners.py now stages each point's raw output in the git-ignored
    sim/.work/.stage/<stem>/, stores it with klt artifact put and commits a
    manifest (manifests/artifacts/<stem>.manifest.json) plus a record whose
    stored_evidence table lists name, size and sha256. It fails closed when the
    broker variable is unset, klt lacks artifact put, or a put fails.
    The record-checksum check learns the stored shape, a new manifest check
    validates schema and artifact: URIs and fails if stored bytes are committed,
    the history check holds manifests append-only, and DR-0032 records the
    decision. Existing records are untouched. The signoff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
2026-10-28 sim: add power-intent spec and gate-level isolation/sequencing check for a gated digital section
    design/power-intent.md names the gated and always-on domains, the per-element
    retained/re-initialised/discarded disposition, every isolation point with its
    clamp, the wake sequence and its provisional time-to-first-valid consequence.
    sim/tools/power_intent_check.py holds the repo to it: output coverage against
    the RTL and synthesized netlist, ordering rules, and a power-aware gate-level
    run of the synthesized trng_top (X-driving dead rail, AND-cell isolation,
    clock-gated retained flops) with six deliberately broken fixtures that must be
    reported. One append-only gate-level record is added and the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
2026-10-28 feat: add a 400 um PMOS header cell for the digital supply, with 45-point sizing evidence
    Adds design/xschem/power_switch.sch (40 x 10 um pfet_03v3 fingers, L = 0.28 um,
    sleep high = off) with its netlist, a hand-drawn layout cell that is DRC-clean
    and LVS-matching under the pinned klt 0.6.0, and a 45-point PVT testbench run
    on the batch fleet through klt sim. sim/tools/power_switch.py declares the
    grid, writes the append-only records and summarises them; the report
    sim/characterization-power-switch.md quotes the result: at most 30.95 mV droop
    at the 20 MHz bound load, 41.9 nA switch leakage and 74.4 nA gated-domain plus
    analog idle at ff / +10 % / +125 C, 104 mA worst-case wake inrush.
    The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
2026-10-28 evidence: price digital inventory levers against the idle and area rows
    Add sim/tools/inventory_levers.py, which re-prices the shipped digital
    inventory under each candidate cell-level reduction through the existing
    Liberty/LEF pricing and projects the effect on the idle and floorplan figures
    of record, plus the generated table and a candidate RTL patch (raw_shift
    without reset) that is checked to still apply. The RTL is deliberately not
    changed: doing so stales the synthesized netlist and the place-and-route
    chain built on it.
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2026-10-29 feat(interface): drop raw_shift reset and size raw_bit_count from RAW_PACK_BITS, re-run the digital chain
    The packing shift register is fully overwritten before it is read, so it no
    longer resets or clears; raw_bit_count is $clog2(TRNG_RAW_PACK_BITS) bits.
    This applies the patch priced in sim/inventory-levers and retires it.
    Re-ran, on the new RTL: design/synth.py, layout/digital/build.py, lvs.py,
    gen_sdf.py, run_sta.py (new digital-sta-power and digital-sta-activity record
    families), the klt sta and post-route functional envelopes, the digital ERC
    report, and layout/floorplan/floorplan.py --write. Measured, before -> after:
    - synthesized instances / area: 1459 -> 1395, 57435.84 -> 56464.9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
2026-10-30 fix(sim): re-pin figures moved by the #709 re-measurement
    Update the pinned or quoted values that the re-placed block and the
    re-run digital chain moved, so the harness unit tests agree with the
    measured tool output again. No tolerance is widened and no historical
    record or sim/records file is edited.
    - sim/tests/test_run_sta_interface_load.py: trunk C/R/transition pins
    - sim/characterization-analog-summary.md and its test: whole-block
    active 749.4 uW (149.9 %), digital 339.4 uW, idle 2.148 uA (215 %),
    2 kbps 8.28 uW / 418.3 uW
    - docs/chipalooza/challenge-3-proposal.md rows D, E, I and their test
    - signoff: analog summary content hash re-pinned in the envelope, block
    manifest and verd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
2026-10-30 layout: tap every hand-drawn cell, fix ring2 contact size, LVS refs now tie bulk to supply
    Draw an Nwell tap tied to the supply and a substrate tap tied to ground in
    every hand-drawn cell generator (shared add_taps/tap_rects helpers beside
    add_implants; xor2/sampler_dff tap under their supply terminals through the
    existing routing stack), so klt 0.8.0's comp.tap_distance.* is clean on every
    cell, ring and block. ro_stage_ring2's contacts are now the deck's fixed
    0.22 um square. Placement bboxes updated for the added tap extents; ring and
    block GDS rebuilt. LVS references tie PMOS bulk to the supply and NMOS bulk to
    ground (no vsubs pin, no floating-well net); body_verification is now
    verifie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
2026-10-30 wip: re-pin producer klt to 0.8.0, drop the vsubs floorplan net, regenerate floorplan
    KLT_PIN and every restatement move to 0.8.0 (klt_pin_sites.py --check: 58
    mentions agree); narrated 0.6.0 mentions are marked historical. The
    inter-region net list no longer declares vsubs (no region has the pin since
    the taps), the composed LVS reference and floorplan artefacts are
    regenerated, and the test_mos_row expectations cover the new taps.
    Not done yet: layout/pex composition (needs the vsubs net it still expects),
    the sim/tb PEX fixtures, signoff evidence, and the DR-0026 amendment.
2026-10-30 evidence: re-run digital STA, activity and post-route records on the 30 um tapcell geometry
    Mint new append-only records on the re-placed digital block: 15
    digital-sta-power, 15 digital-sta-activity and one trng-top-post-route
    (gate vs RTL identical, 8 of 8 scenarios). Historical records are untouched.
    Regenerate the floorplan composition, the klt sta and post-route signoff
    envelopes and the T1 tier report (verdicts unchanged, 18 of 22 met), move
    the RECORDED tables and the quoted headline figures to the new
    measurements (cell area +3.2 %, leakage +5.1 %, whole-block idle
    2.321 uA), and add section 0d stating what is and is not claimed.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
2026-10-30 evidence: re-mint the digital-sta-power records after the floorplan recompose
    The 15 digital-sta-power records were minted before floorplan.py --write
    rewrote layout/floorplan/reports/interregion.json, so their interregion_json
    pin (1444dd82...) named bytes that are no longer in the tree. Re-run
    run_sta.py on the committed tree; the pin now reads ec3fe16d... and every
    recorded slack, Fmax and power figure is unchanged (only wall_time differs).
    The stale records were minted in this branch and never reached the base, so
    the replacement is a net add against it; no record already on a base branch
    is touched. Regenerate the digital-supply-ir-drop block, which pins the
    power-record hashes. The ac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
2026-11-05 docs(signoff): record working klt yield install route, name the missing limit as item 6's blocker
    klayout-tools[yield]==0.9.0 now resolves from PyPI with klt-yield-native
    0.1.0. Pin it as item 6's separate producer route, refresh the stale
    blocker text, and record that klt yield cannot grade without a ratified
    limit on the sampled quantities. No report is cited; no spec row changed.
    Part of #656
2026-11-05 docs(sim): record measured ring2 27-corner paired run under klt 0.9.0, unpublished pending pin decision
    The full paired grid ran on the batch fleet (klt 0.9.0 client and runner):
    81 delta rows, none errored. The publisher refuses it under the 0.6.0 producer
    pin, so nothing is published; the response is kept as append-only evidence.
    Part of #476
2026-11-05 refactor: share one SPICE continuation joiner and .SUBCKT pin reader
    Add design/spice_text.py as the single stdlib-only home for the
    comment-aware '+' continuation joiner and the case-insensitive .SUBCKT
    header matcher, and use it from floorplan_netlist, floorplan and
    digital/lvs instead of three private, drifted copies. The lvs header
    match is now case-insensitive like the others.
2026-11-05 docs: replace rail-settle placeholder in power intent with evidenced figure
    Rail settle is taken from the power-switch characterization (95 % within
    21.4-462.6 ns, under one sample cycle, so 1 cycle); inrush figures are
    recorded as wake-step inputs. Rail decay stays a named placeholder as the
    characterization reports no decay time. Adds a new dated re-run record.
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2026-11-06 sim: measure gated-rail decay after the power switch opens
    Add a decay transient (same 400 um header, leakage-equivalent load, 50/200 pF rail
    and 10 ns/1 us sleep edges as the wake group) run as a 45-point klt sim request on
    the batch fleet, with its tool, tests and 45 append-only records. With leakage as
    the only discharge path the rail takes 0.1 ms to seconds to fall to 50 % of vdd and
    never reaches 5 % at 27 of the 45 corners, so t_rail_decay_cycles stays a placeholder
    with that reason stated in design/power-intent.md and section 6 of the
    characterization. Evidence count and signoff inventories regenerated.
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2026-11-09 feat(signoff): ratify mismatch MC limits and cite a klt yield report as item 6 analog
    DR-0033 turns the conditioner, health-test and sizing-law margins into limits
    on the sampled ring period and sampler threshold (operator ruling on #656).
    publish_item6.py builds a sample set from the committed raw campaign logs and
    runs klt yield 0.9.0 over it; the report is cited as 6.analog. The grader
    renders it unmet / undersized_sample (8 and 30 seeds, no negative control in
    klt yield's sense), recorded as-is.
    Loom-Issue: 2AMLogic/gf180-trng#656
    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
2026-11-09 sim: break whole-block active power down by sub-block at the binding corner
    Add a gate-level per-instance power testbench (digital-power-by-block) that sums
    OpenSTA instance power by the as-built hierarchy prefix, one append-only record at
    ff_125C_3v60/rc-max, and a tool that joins it with the committed array and sampler
    records. Rows reconcile with power_rollup.py (749.4 uW at a 1 MHz clock, 418.3 uW at
    2 kHz). Partial increment: the retention/measured-idle half is not included.
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2026-11-09 docs: record why a sampler flip-flop draws at 573 um^2 (negative finding)
    Append a dated addendum to the area-economy accounting: the sampler_dff
    box is 83.8 % a 14-trunk Metal2 routing channel (Y), not diffusion pitch
    (X); the block's 6 um inter-cell gaps are a smaller, separate term. No
    layout or spec change; the ratified Area row is untouched.
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2026-11-09 feat(floorplan): stack digital above the analog strip with a wide multi-cut PDN tie
    Place the digital region one isolation channel above the analog strip and
    redesign the vddd/vss docking path for it: one 2 um Metal3 riser per net on
    the stack's east flank (outside every ring channel), a four-cut Via3 row on
    the trunk and a 16-cut Via3 + Via4 array under a Metal5 dock onto the east
    end of the lowest PDN strap. digital's east edge is derived from the
    combiner_sampler and wrap riser tables rather than set as an overhang
    constant.
    Composed bbox 931.1 x 413.5 -> 516.9 x 451.8 um (385 042 -> 233 524 um^2,
    -39.4 %); composed DRC clean, 112/112 pins, LVS unchanged. Digital supply
    IR-drop bound 23.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
2026-11-09 docs: rank active-power levers by power recovered and scope follow-ups
    Add a Power-section entry to docs/spec-row-status.md after the sub-block
    breakdown: a ranked lever table (figure, corner, source record), the
    1 MHz versus 2 kHz clock rate stated as an open spec question with both
    figures, and "no lever" for the sampler and the rings themselves. Four
    follow-ups are filed at loom:triage (#810-#813). No row, bound or decision
    record changes; Power still reads missed.
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2026-11-09 docs: ring-supply power returned vs modelled entropy cost
    Add a read-only --supply-sweep report to worst_corner_entropy.py and a
    dated evidence note tabulating, per process/temperature corner at 3.63,
    3.30 and 2.97 V, ring and array power returned against the modelled
    Q_array margin and R_max at the ratified 2 kbps. States the fixed-a
    assumption and the absence of any reduced-supply jitter measurement.
    No spec row, bound or decision record is changed.
2026-11-09 sim: split the array's buffer and XOR power with a split-rail probe
    The "ring buffers + XOR" row of the active-power breakdown (120.0 uW at
    ff / -40 C / 3.63 V) came from one metered `vdd` pin, so it could not say
    how much belongs to the two ring buffers and how much to the XOR combiner.
    Add sim/tb/ro-array-core-power-split/: the shipped ring/buffer/XOR
    instances with `vdd` split into three zero-volt-metered rails, and one
    minted record at ff / -40 C / 3.63 V. It measures 61.83 uW (buffers) and
    60.12 uW (XOR), 121.95 uW together: +1.60 % from the pvt-q remainder,
    inside the 2 % tolerance. That is the whole power of both blocks, an
    upper bound on what a trim there could return, not a recover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
2026-11-10 layout: drop the vsubs port from the PEX composition and re-publish ring1's item 7 citation under klt 0.9.0
    The tapped cells tie every bulk to a supply, so klt 0.9.0 extractions no
    longer promote a vsubs port (it remains only as the netlists' .GLOBAL
    substrate reference). Rework the composition and its fixtures to match:
    - layout/pex/build.py: wrappers, port resolvers and noise-tap order lose
    vsubs; the design/ path needed by floorplan_netlist is put on sys.path.
    - sim/tb/{ro-ring11,ro-ring11-ring2,combiner-sampler}-pex build_dut.py,
    testbenches and README text follow the thirteen/fourteen-port headers; the
    extracted-deck testbenches drop the trailing vsubs tie, and the ring2
    noise-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
2026-11-13 sim: measure starved-ring jitter at 3.30 V and 2.97 V ring supply
    Generalise starved_hot_corner.py to a declared list of grids (process,
    temperature, supplies, run length) and run the reduced-supply points on the
    batch fleet: 5 points x 8 units, plus four .noise records. The records are a
    separate family (ro-ring5-starved-jitter-redsup) so the published corner
    mean stays 10.932 / 23.255 and the sizing constant 7.322; a new test holds
    that. starved_cell_jitter_energy.py --reduced-supply reports each measured a
    beside the stated mean and the same-corner comparator, and
    worst_corner_entropy.py --supply-sweep --measured-a prints the margin with
    the measured a. Evidence note under docs/; no spec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
2026-11-13 sim: publish the combiner/sampler schematic-vs-extracted 27-corner grid
    Ran the assembled combiner/sampler through `klt pex --backend batch`
    (klayout-tools 0.9.0, 9 shards per side) and committed the native envelope,
    publication pins and extracted netlist. All 27 corners x 66 rows are measured
    on both sides; the recomputed two-sided verdict is pass (1674 limit rows held,
    108 measure-only, 0 unmeasured).
    - publisher: shard batch runs across 9 hosts, add --resume to launch shards
    left unlaunched by a capacity refusal; request carries batch.capacity_wait_s
    - correct the stale "floating wells" exclusion text: the evidence reports
    body_bias "biased" with no unbiased devices since the layout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
2026-11-13 sim: fix combiner/sampler publisher tests; keep client host path out of the published envelope
    - test_signoff_publishers: compare the producer to the effective batch argv
    and expect the --resume positional in run_pex calls; cover --resume and
    the path reduction.
    - publish_common.redact_client_paths: reduce a home-directory
    environment.client_ngspice_binary to its basename before publishing, so
    the evidence passes check:no-host-paths. The guard is unchanged.
    - Re-pin publication.json to the reduced envelope; README states the one
    deviation from the raw response.
2026-11-13 refactor(sim): move the power tools' argparse front end into _power_cli
    The four power tools each carried the same 31-35 line `main()`: the same
    `plan | emit | run | record [| summarize] | analyze` subparser set and the
    same `if args.cmd == ...` dispatch, differing only in the `--only` example,
    whether the tool has a `summarize` subcommand, and help text that had already
    drifted (`power_retention` was missing the `--note` and `summarize` help,
    `power_switch_decay` said "table" where its sibling said "tables",
    `liveness_sampler_power` was the only one documenting `--klt`).
    `_power_cli.build_parser()` now builds that parser once and `_power_cli.main()`
    dispatches to the command functions the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
2026-11-13 sim: render the power record front matter from one shared skeleton
    The four power-measurement tools each re-typed the same record front matter
    inside render_measured / render_unmeasured: the record/date/status head, the
    testbench and netlist paths with their blob shas, repo_commit, the pdk and
    pdk.models block, the tool block, the corner block, the analysis block with
    its seeds line, the raw file list and wall_time. Eight copies of one format,
    so adding a provenance field meant eight edits and a missed copy would make
    one tool's records differ from its siblings'.
    Move the skeleton into _power_cli: render_header writes the field order and
    the blank lines between blocks, taking each block's i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
2026-11-13 sim: hold the study's sizing constant to the shared derivation, not a private copy
    higher_rate_options.py kept its own corner, tolerance and derivation for the
    starved-cell jitter-energy constant, duplicating what
    starved_cell_jitter_energy.sizing_constant() and array_sizing.py already own.
    The duplication was justified by a claim that is no longer true: since #586
    moved array_sizing.py to the starved-cell constant, it states 7.32, not the
    plain-cell 1.79, and keeps 1.79 only as A_PLAIN_CELL.
    - Delete derived_a(), A_CORNER and the local A_TOLERANCE. --check now calls
    sce.sizing_constant() and compares .value against A_STARVED under
    sizing.A_TOLERANCE, reporting .corner; report() prints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
2026-11-13 chore: drop package.json worktree:return script entry pointing at a deleted file
    `npm run worktree:return` invoked ./.loom/scripts/worktree-return.sh, which
    is no longer part of this repo — the script was removed by the Loom resync in
    efd034e2 and the package.json entry pointing at it was left behind, so the
    command exited 127 for everyone who tried it.
    Nothing referenced the entry: it is absent from check:ci, check:all,
    .github/workflows/ci.yml, the Makefile and README.md, and `git grep
    worktree:return` matched only package.json itself.
    A later Loom resync will not restore it. resync-installed.sh deliberately
    makes no whole-file copy of a `loom-workspace` root package.json — its only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
2026-11-13 refactor(floorplan): drop the vsubs filter, its vacuous test and its prose
    `drawn_nets()` filtered the inter-region net table on
    `net.get("endpoints") and net["layer_role"] != "guard_ring_tap"`, and
    `test_every_declared_net_with_endpoints_is_drawn` restated the same
    expression. Since #705 removed the `vsubs` substrate net, nothing in the
    repository sets `layer_role: "guard_ring_tap"` and every declared net has
    endpoints, so the filter selected all 15 nets and the mirrored test could
    not fail. `test_vsubs_is_not_drawn` asserted the absence of a net name that
    is no longer declared anywhere, so it could not fail either.
    - `drawn_nets()` now returns the declared list. Verified equivalent: the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
2026-11-13 docs(floorplan): retire the pre-#224 framing from the vddd and vss net rows
    The inter-region net table described `vddd` as reaching `digital`'s "own
    implicit PDN net", with no `.SUBCKT` `vddd` pin to wire against
    (SPECIALNETS-only), and `vss` as reaching `digital`'s "implicit ground".
    Issue #224 made both false: `layout/digital/lvs.py` promotes `vddd`/`vss`
    to real `.SUBCKT trng_top` pins, `design/floorplan_netlist.py` declares
    both as ordinary `endpoints`, and `layout/floorplan/interregion.py` draws
    the tie. The table therefore contradicted `interregion.py`'s "The
    `digital` PDN tie" docstring section and this README's own #224 decision
    record ~160 lines further down.
    Reword both rows acros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
2026-11-13 docs(floorplan): drop the hand-maintained net count above the inter-region table
    The sentence framing the inter-region net table called it "the sixteen
    declared nets", but `npm run check:floorplan-netlist` prints `inter-region
    nets declared: 15`. The figure was correct when written at 49deec38 and was
    left behind by 08ba5bb0, which removed `vsubs` from
    `design/floorplan_netlist.py`'s `INTER_REGION_NETS`.
    Rather than re-copy today's figure — the same hand-maintained numeral that
    already went stale once — the sentence now states no count and points at the
    checker, which prints one on every run. The paragraph directly above already
    introduces that command, so this reuses an existing pointe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
2026-11-13 layout: regenerate 45 reports under the pinned KLayout engine and guard the recorded engine
    The committed cell-level and floorplan reports recorded KLayout 0.30.13
    while signoff/check.py's KLAYOUT_PIN, DR-0026 as amended and
    pdk-nightly.yml's install line all say 0.30.10. Installing the documented
    line and re-running the flow therefore failed: `layout/verify.py
    --require-tools` reported 41 stale expectations and
    `layout/floorplan/floorplan.py --require-tools` two more.
    Regenerated from a throwaway venv holding exactly what the nightly
    installs -- the latest tagged klayout-tools release (0.9.1) with
    `klayout==0.30.10` -- so both `--require-tools` runs now exit 0. The
    composed `layout/floorpl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
2026-11-13 digital: re-run the chain under the nightly's Yosys 0.69 / klt 0.9.1 toolchain
    `.github/workflows/pdk-nightly.yml` installs
    `yowasp-yosys==0.69.0.0.post1233`, but PR #729 regenerated
    `design/trng_top/trng_top.synth.{v,json}` on a host whose `yosys` was a local
    0.67+post source build. The nightly re-synthesizes from the same RTL with
    0.69, gets a different netlist, and its "Digital synthesis staleness guard"
    step has been red on every scheduled run since 2026-11-04. A failed step
    skips the rest of the job, so the two report-freshness steps that follow it
    (`layout/verify.py --require-tools`, `floorplan.py --require-tools`) have not
    run at all since then.
    Regenerated the whole digital chain fr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
2026-11-14 floorplan docs: state the clk/rst_n bound this geometry actually asserts
    `layout/floorplan/README.md`'s living section on the stacked arrangement
    still described the pre-flip geometry, in which the six inter-region signal
    pins sat on `digital`'s top edge and wrapped the east flank. With all six
    pins now on the bottom edge, three of its claims were false:
    - "both trunks' west ends are the first wrap column" — no wrap column
    exists; `reports/interregion.json` reports zero endpoint `legs`, and the
    `digital` anchors are six `digital_pin` plus two `digital_pdn_strap`.
    - "east of the strip" — `clk`'s digital-side riser is at x = 270.63 um
    against a `combiner_sampler` east edge of 297.9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
